massinissalounis/oufffteam/Coupe/Coupe2011/Poster2011_EN/lapins/Rabbids Artoyz generic(2).jpg

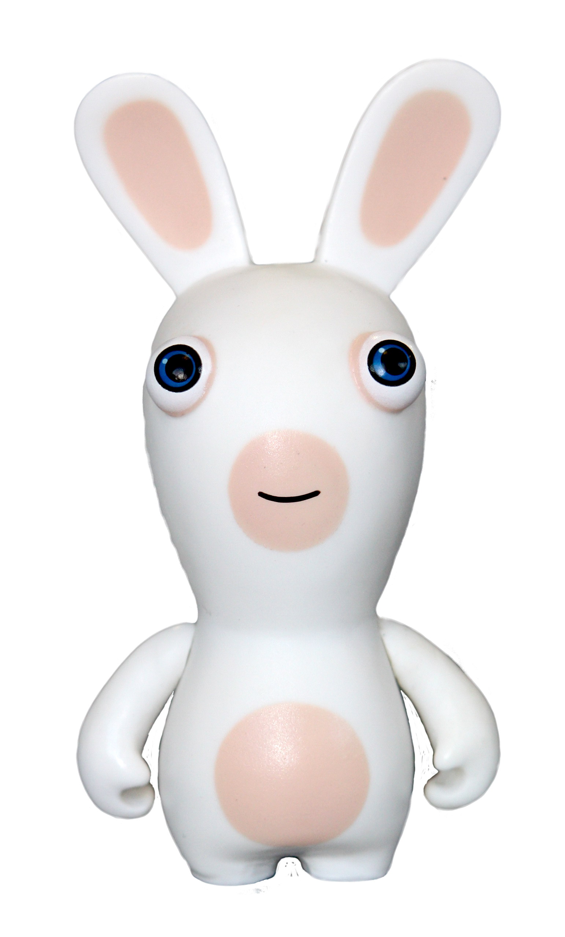
Coupe/Coupe2011/Poster2011_EN/lapins/Rabbids Artoyz generic(2).jpg
