massinissalounis/oufffteam/Coupe/Coupe2011/Poster2011/lapins/RRR_UK_1024x768_wallpaper15.jpg

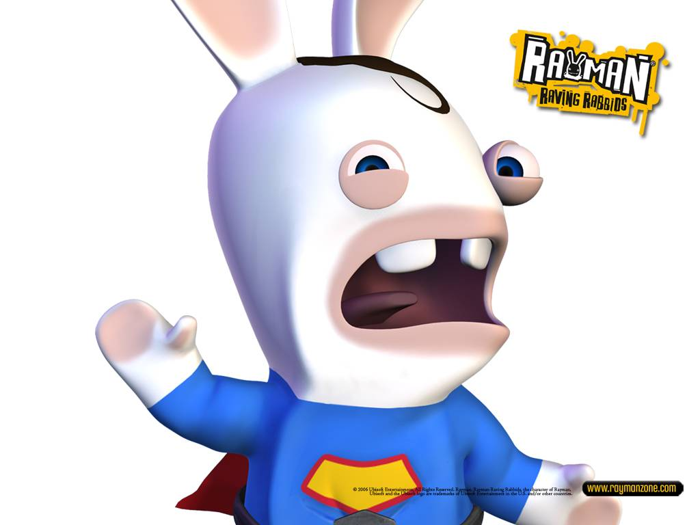
Coupe/Coupe2011/Poster2011/lapins/RRR_UK_1024x768_wallpaper15.jpg
