massinissalounis/oufffteam/Info/RapsberryPi/Info.txt

Carte Raspberry :

root / OufffTe@m!

IP eth : 192.168.0.200
