massinissalounis/oufffteam/Dev_uCOS-II/Oufff2013_DemoAsser1/Conception/Projet2013.pptx

## Projet 2013

TaskAsser
- Compute new orders to send to motors from current postion to reach expected position

StructCmd App_CmdToTaskAsser

TaskOdo
Stand-alone task Compute current position from encoding wheels Postion is exposed by TaskOdo_GetCurrentPos() and TaskOdo_SetCurrentPos()

TaskDebug
Display data (to debug) from all other tasks

Strategy Flags (32 bits)
See Page 2

TaskMain
Synchronize all tasks

TaskTest
Only for tests Do not use in production mode

TaskSensors
Set or Clear Bumpers flags according to sensors state Execute command from TaskMain

TaskMvt
Compute path necessary to go to expected point. Pre-defined paths are read from « Strategy files » Pre-defined paths are choosen into AppConfig.h file

TaskTime
- Wait 90s and set TIMER_STATUS

QSensors
Queue used to send command from TaskMain to TaskSensor Results are sent by using ACTION_STATUS Flag

StructCmd App_CmdToTaskMvt

App Flags (32 bits)
See Page 2

## Slide 2

Strategy Flags (32 bits)
Actions Done 0 - 1 - 2 - 3 - 4 - 5 - 6 - 7 - | Forbbiden Zones 8 - 9 - 10 - 11 - 12 - 13 - 14 - 15 - | Not Used 16 - 17 - 18 - 19 - 20 - 21 - 22 - 23 - | Not Used 24 - 25 - 26 - 27 - 28 - 29 - 30 - 31 -

App Flags (32 bits)
State 0 - START_BUTTON 1 - 2 - 3 - 4 - 5 - 6 – ACTION_STATUS 7 – TIMER_STATUS | Bumpers (GP2) 8 - GP2_FRONT 9 – GP2_BACK 10 – GP2_HOLDER 11 - 12 - 13 - 14 - 15 - | Bumpers (SW) 16 - 17 - 18 - 19 - 20 - 21 - 22 - 23 - | Not Used 24 – 25 – 26 – 27 – 28 – 29 – 30 – 31 -
