massinissalounis/oufffteam/Coupe/Coupe2011/Poster2011/SchémaBlocs/SchémaBloc.pptx

Effecteurs

Carte de contrôle des effecteurs

Système d’anticollision
Capteurs IR, Capteurs de contacts

Carte mère OufffTeam
(4 couches CMS)

PIC 32

Hacheurs
LMD18200T

FPGA
SPARTRAN3AN

PMP

Alimentation à découpage TRACO

Encodeurs scancon
2048 pts

Arrêt
Urgence

24 V / Puissance
Signal

Moteurs 24V
Faulhaber

Module de démarrage et de protection

Batterie NiMh
12V 3.2Ah

Batterie NiMh
12V 3.2Ah

12 V
5 V
