massinissalounis/oufffteam/Coupe/Coupe2011/Poster2011_EN/SchémaBlocs/SchémaBloc.pptx

Actuators

Actuator control PCB

Obstacle Avoidance System
IR and contact sensor

OufffTeam motherboard
(4 layers CMS)

PIC 32

H-bridge
LMD18200T

FPGA
SPARTRAN3AN

PMP

Switched power supply

Encoders scancon
2048 steps

Emergency Stop

24 V / Power
control

Motor 24V
Faulhaber

Startup and protection module

NiMh accumulator
12V 3.2Ah

NiMh accumulator
12V 3.2Ah

12 V
5 V
