massinissalounis/oufffteam/Balises/Balises_SICK/Doc/Synoptique.pptx

Asser
- INT timer pour latch
- PID
- Generation PWM
Beacon computing
- Polling status
- Read Latch Pos
- Detect spots (center+width)
- Controls: complete tour, no more than 3 spots
- Identifiy reference
- Distance and angle comp
- Flags generation

RD PIC

INT PIC

Latch coder

Encoder

NEW REV
& ! RD PIC

A

Positions x 8

Latch Pos x 8

RD PIC

B

Init

Status

Ctrl

Dir

0/1

PWM
