massinissalounis/oufffteam/Elec/2010/Hacheurs/Doc/Signaux sonde courant.docx

Signaux :

1- PWM de consigne
2- Courant dans le moteur
3- Sortie sonde de courant
4- Sonde de courant filtrée passe bas
5- Sonde de courant filtrée passe bas / (alpha de la PWM)
