massinissalounis/oufffteam/Elec/2013/Support_capteur_couleur/Supp_capteur_couleur schéma.pdf

J2

J3

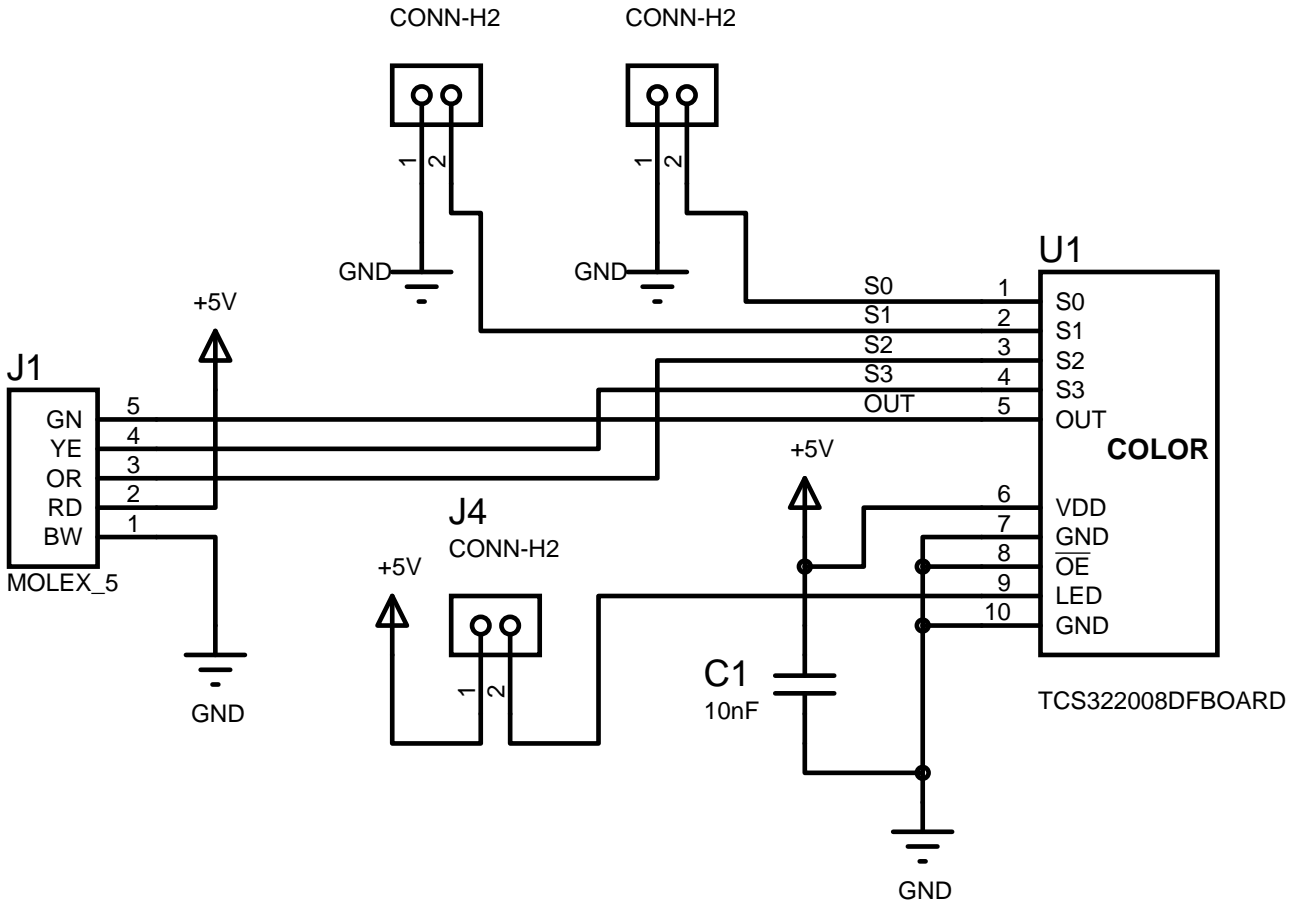
[picture p8: figure]
S2 S3 OUT; COLOR; S0 1 S1 2 S2 3 S3 4 OUT 5; VDD 6 GND 7 OE 8 LED 9 GND 10; TCS322008DFBOARD; MOLEX_5; GND; CONN-H2
