massinissalounis/oufffteam/Info/StrategyGenerator/v1 - 2012/Conception/Conception.docx

1 - Use Cases

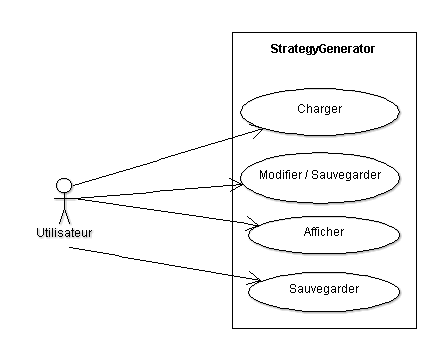
[picture p9: figure]

2 – Diagramme des Packages

3.1 – Use Cases de IHM

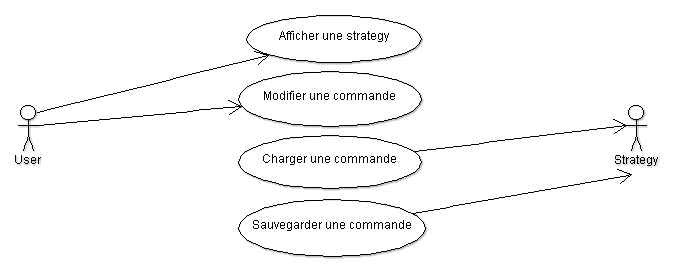
[picture p10: figure]

3.2 – Use Cases de Strategy

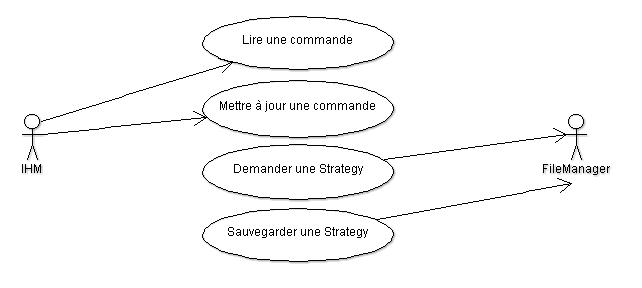
[picture p11: figure]

3.3 – Use Cases de FileManager

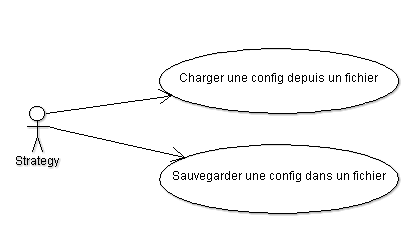
[picture p12: figure]

4 – Modélisation des interfaces

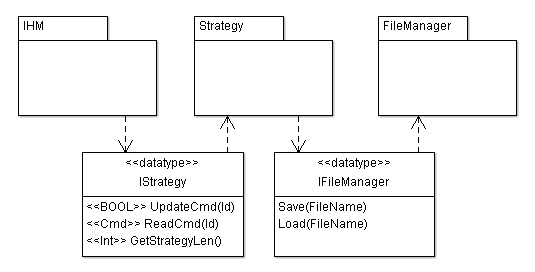
[picture p13: figure]
