massinissalounis/oufffteam/Balises/TrigoInverse/EqTrigoRevisionDeOufff_2007-12-26.docx

Equations de positionnement

de la Oufff TEAM

(Trigo inverse)

Document de base : « Systèmes de positionnement d’un robot dans le cadre de la coupe Eurobot », Sébastien GROS (Club ROBOTIK2000), http://clubrobot2000.free.fr/site, année 2007.

Schéma :

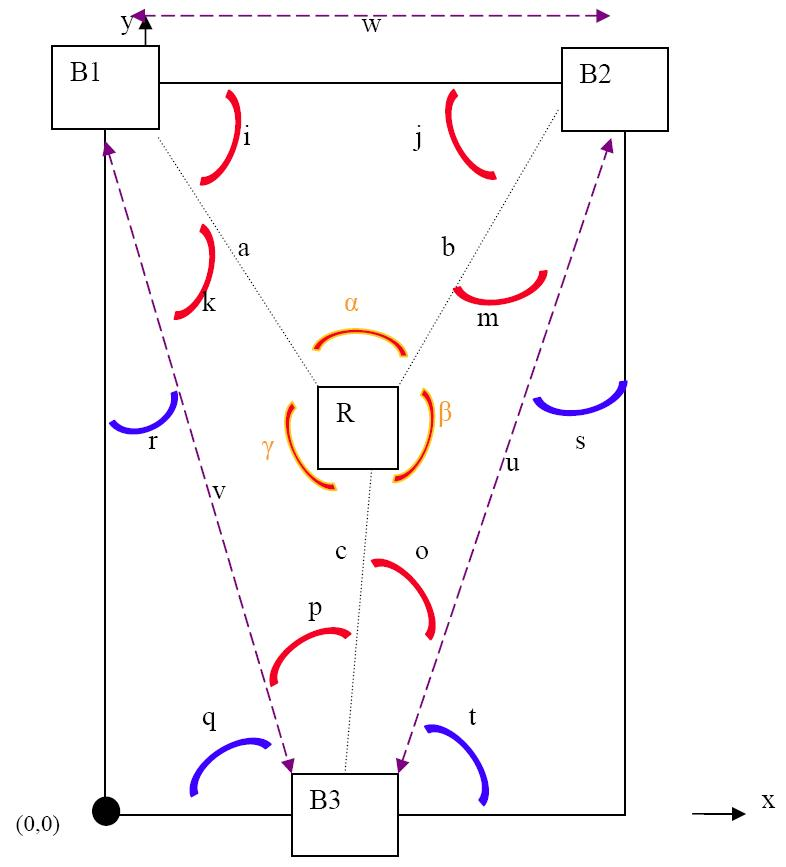
[picture p14: figure]

Triangle (vqt)

Triangle (ust)

(l, 0)

(0,L)

L = 3000 mm

l = 2100 mm

Equations dans le triangle α :

Calcul des angles i et j :

i= cos^(-1) (√((((v/(sin⁡(γ)))*cos⁡(r-γ+π/2)+(w/(sin(α)))*cos⁡(α-π))^2)/(((v/(sin⁡(γ)))*cos⁡(r-γ+π/2)+(w/(sin(α)))*cos⁡(α-π))^2 +((v/(sin⁡(γ)))*sin⁡(r-γ+π/2)+(w/(sin(α)))*sin⁡(α-π))^2)))

j= cos^(-1) (√((((u/(sin⁡(β)))*cos⁡(s-β+π/2)+(w/(sin(α)))*cos⁡(α-π))^2)/(((u/(sin⁡(β)))*cos⁡(s-β+π/2)+(w/(sin(α)))*cos⁡(α-π))^2 +((u/(sin⁡(β)))*sin⁡(s-β+π/2)+(w/(sin(α)))*sin⁡(α-π))^2)))

Calcul de la distance a :

a=w/(sin⁡(α))*sin⁡(j)

Calcul de la position (x,y) :

x=a*cos(i)

y=L-a*sin⁡(i)

Equations dans le triangle β :

Calcul de l’angle m :
m= cos^(-1) (√((((w/(sin⁡(α)))*cos⁡(s-α+π/2)+(u/(sin(β)))*cos⁡(β-π))^2)/(((w/(sin⁡(α)))*cos⁡(s-α+π/2)+(u/(sin(β)))*cos⁡(β-π))^2 +((w/(sin⁡(α)))*sin⁡(s-α+π/2)+(u/(sin(β)))*sin⁡(β-π))^2)))

Calcul de la distance b :

b=u/(sin⁡(β))*sin⁡(π-m-β)

Calcul de la position (x,y) :

x=l-b*cos(j)

y=L-b*sin⁡(j)

Remarque importante :

Attention, le domaine de validité de ces équations dépend de la zone dans laquelle se situe le robot. Lorsque le robot se situe dans le triangle (ust), l’angle calculé pour m est en réalité l’angle –m (changement de signe). Pour prendre en compte cela, après le calcul de m, il suffit de prendre la condition :

SI (β>π) ALORS m=-m

Equations dans le triangle γ :

Calcul de l’angle k :
k= cos^(-1) (√((((w/(sin⁡(α)))*cos⁡(r-α+π/2)+(v/(sin(γ)))*cos⁡(γ-π))^2)/(((w/(sin⁡(α)))*cos⁡(r-α+π/2)+(v/(sin(γ)))*cos⁡(γ-π))^2 +((w/(sin⁡(α)))*sin⁡(r-α+π/2)+(v/(sin(γ)))*sin⁡(γ-π))^2)))

Calcul de la distance a :

a=v/(sin⁡(γ))*sin⁡(π-k-γ)

Calcul de la position (x,y) :

x=a*cos(i)

y=L-a*sin⁡(j)

Remarque importante :

Attention, le domaine de validité de ces équations dépend de la zone dans laquelle se situe le robot. Lorsque le robot se situe dans le triangle (vqt), l’angle calculé pour k est en réalité l’angle –k (changement de signe). Pour prendre en compte cela, après le calcul de k, il suffit de prendre la condition :

SI (γ>π) ALORS k=-k
