massinissalounis/oufffteam/Elec/2011/Capteur Couleur/Presentation.docx

Mise en ouvre du capteur de couleur

Gestion des 2 modes : fonctionnement normal et fonctionnement en teach – in externe

Gestion du key lock

Entrée d’effacement

2 hard différents pour gerer les 2 modes !
