massinissalounis/oufffteam/Coupe/Coupe2012/Poster2012_FR/Poster2012_FR.pdf

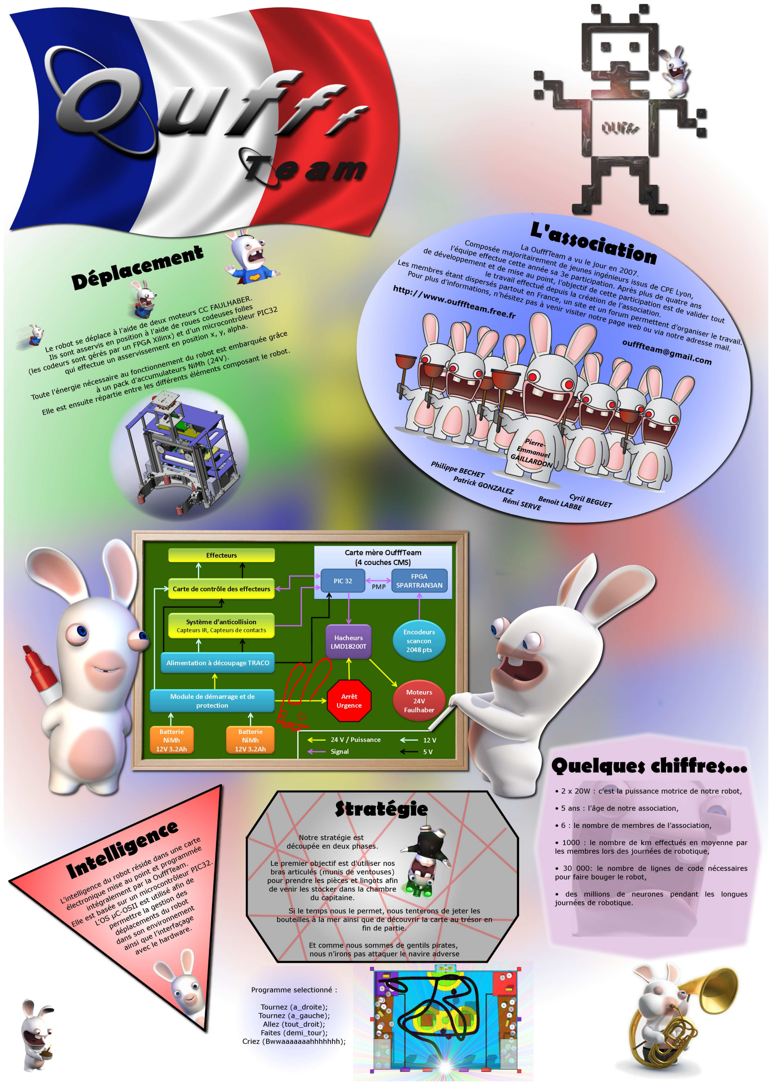
[picture p18: page 1]
