massinissalounis/oufffteam/Coupe/Coupe2012/Poster2012_FR/PosterA0_FR.pdf

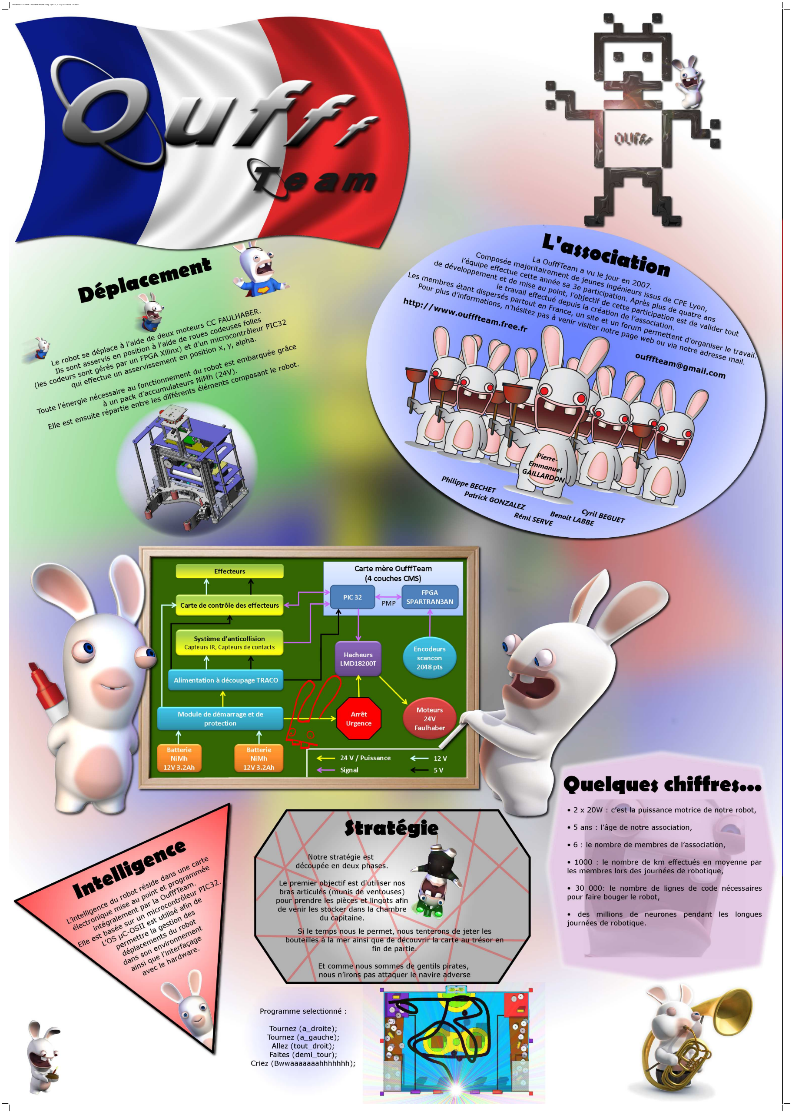
[picture p19: page 1]

Posteriza v1.1 FREE - Nouvelle affiche - Pag. 1 (H = 1, V = 1) 2012-05-09 21:38:17
