massinissalounis/oufffteam/Coupe/Coupe2012/Poster2012_EN/Poster2012_EN.pdf

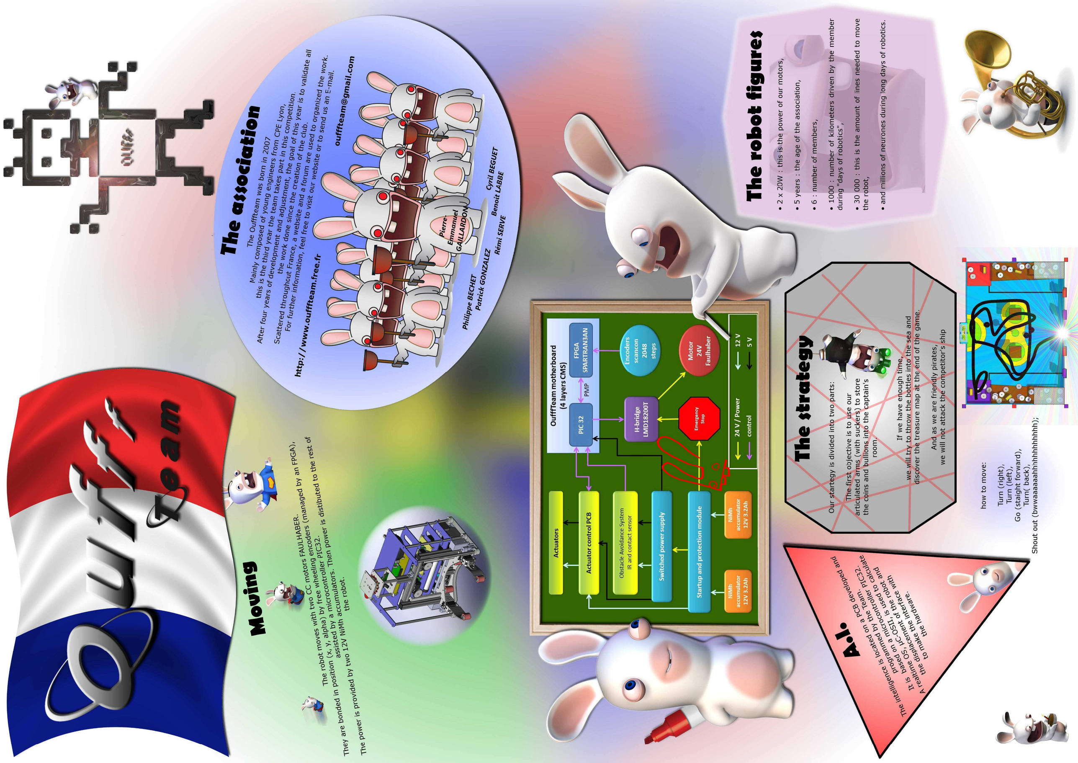
[picture p20: page 1]
