massinissalounis/oufffteam/Coupe/Coupe2011/Poster2011/Poster2011_v2.pdf

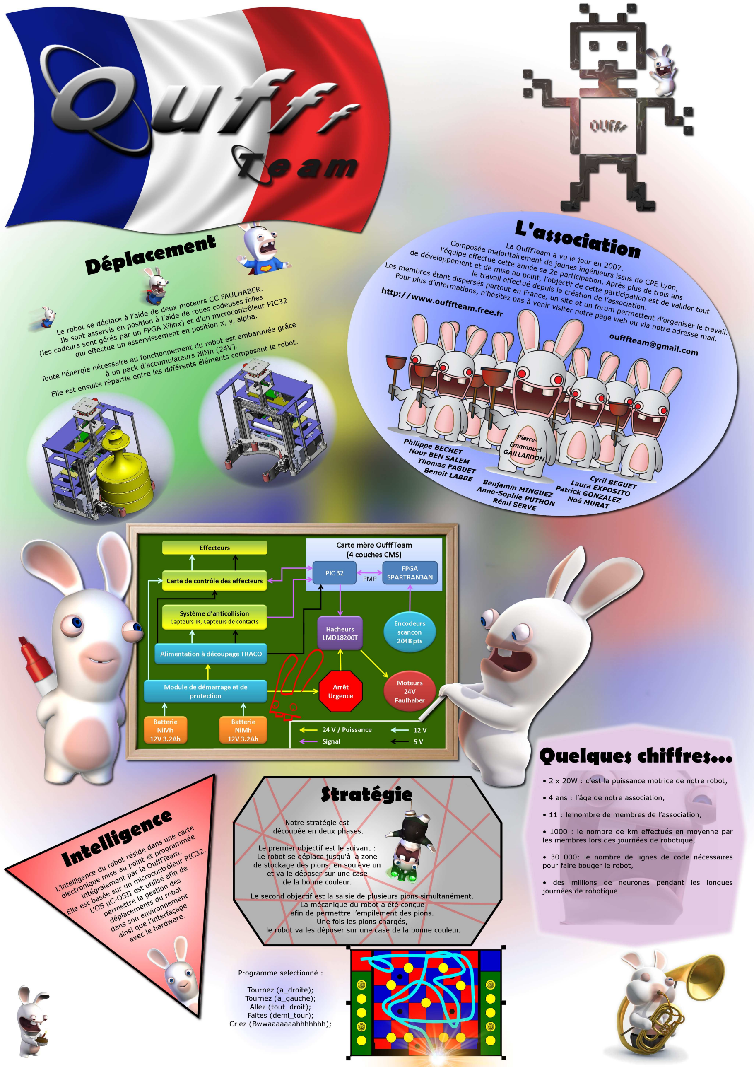
[picture p21: page 1]
