massinissalounis/oufffteam/Coupe/Coupe2011/Poster2011_EN/Poster2011_v2_en.pdf

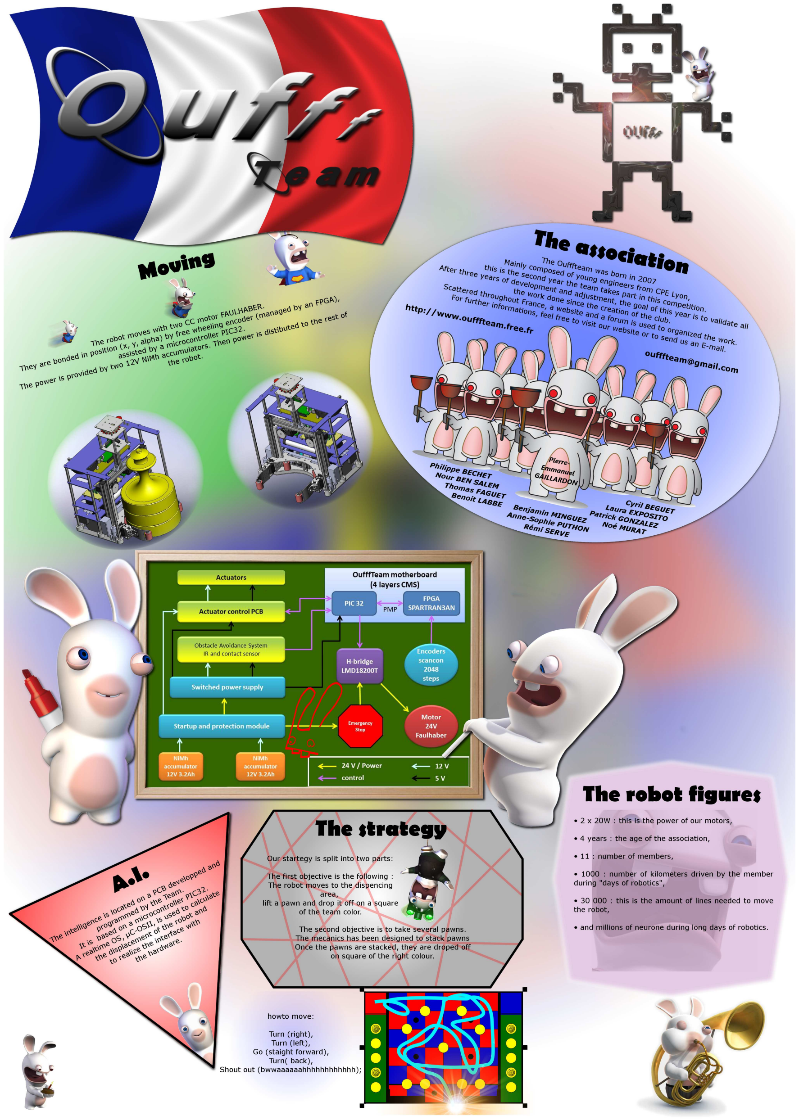
[picture p22: page 1]
