massinissalounis/oufffteam/Coupe/Coupe2013/Poster/Poster2013_FR/Poster OufffTEAM 2013.pdf

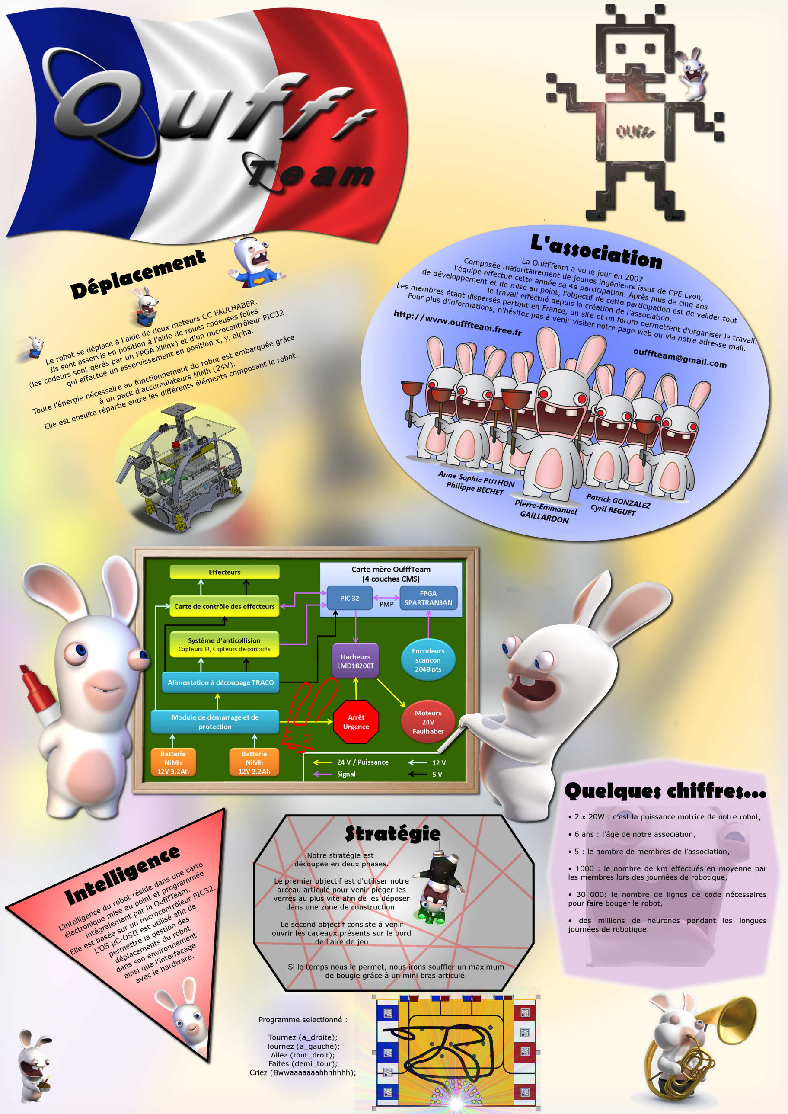
[picture p23: page 1]
