massinissalounis/oufffteam/Meca/Plans Robot 2013/Arceau - Plan.pdf

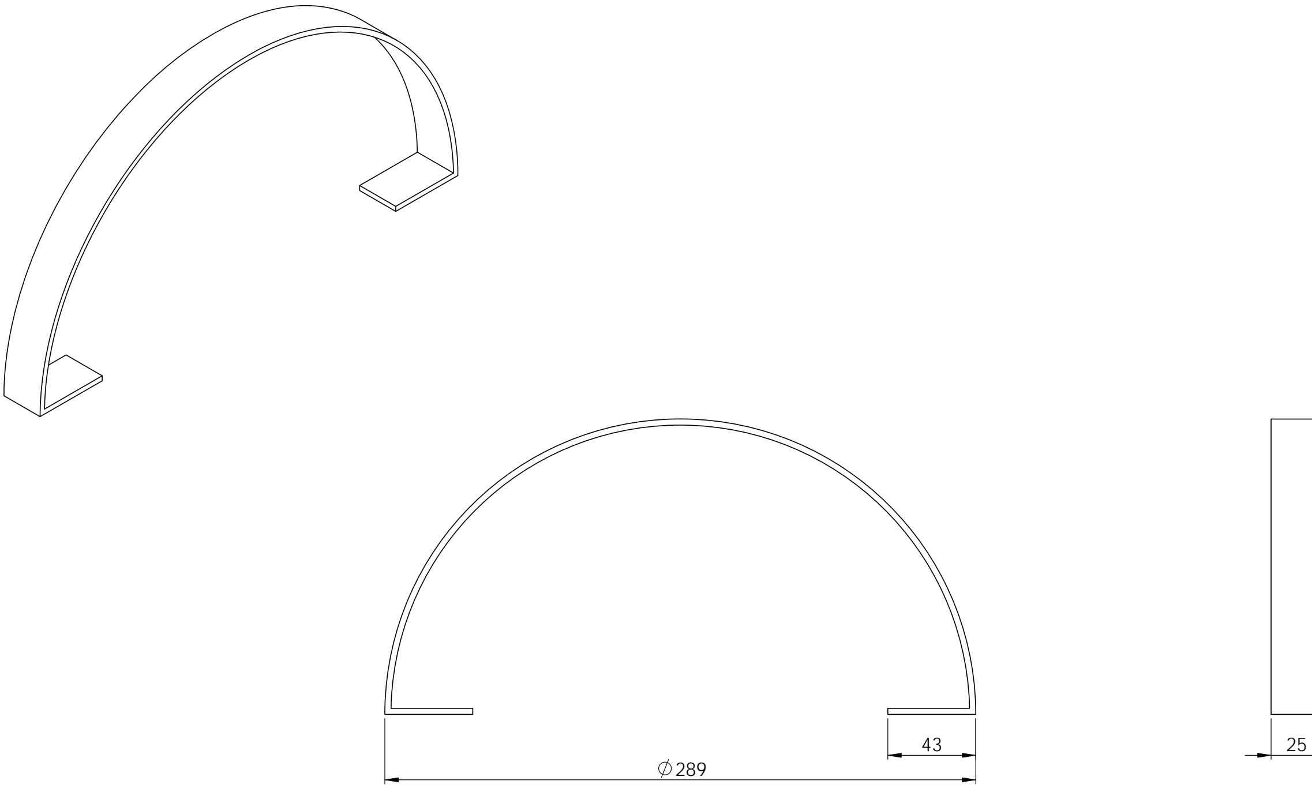
[picture p24: figure]
