massinissalounis/oufffteam/Meca/Plans Robot 2013/Etagère 2 - Plan.pdf

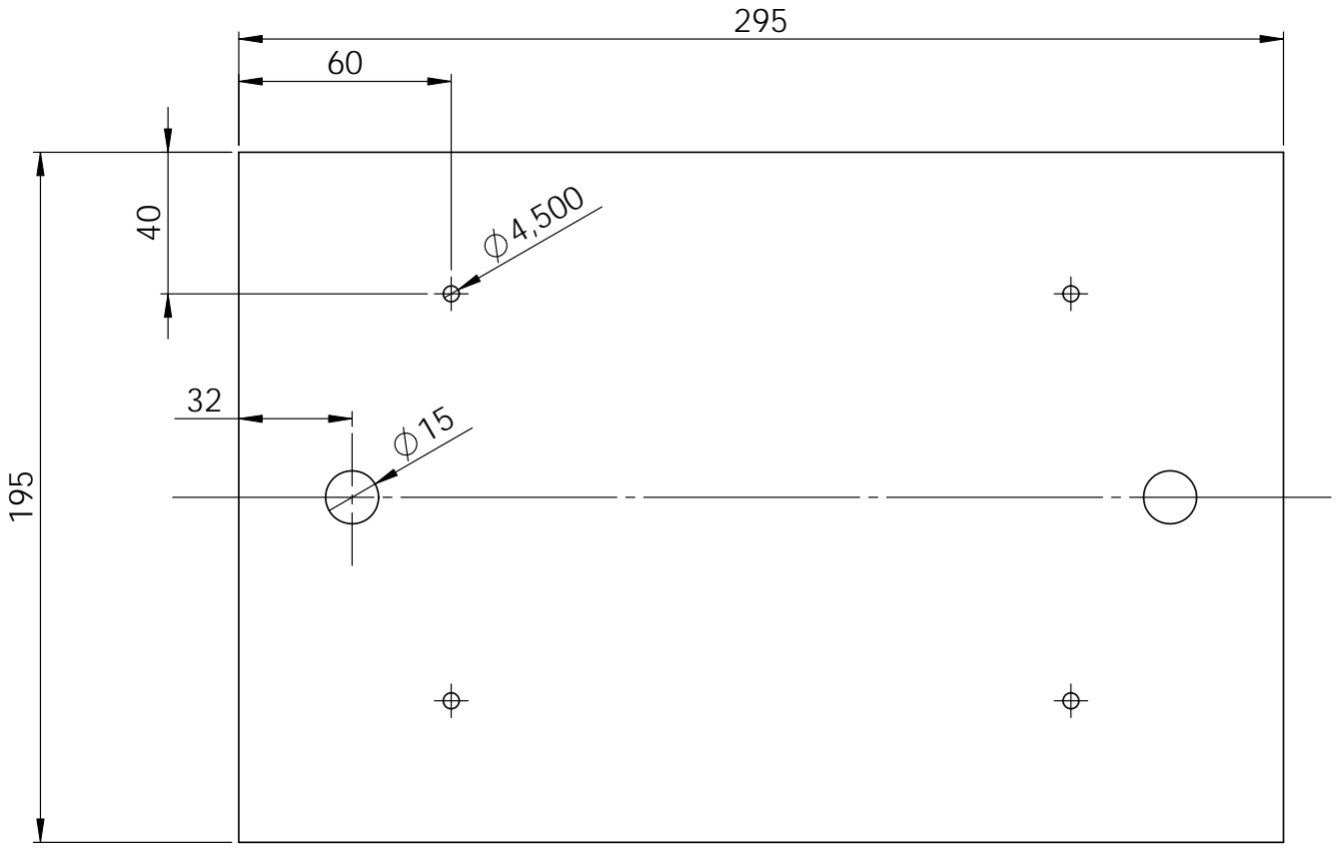
[picture p25: figure]
