massinissalounis/oufffteam/Meca/Plans Robot 2013/Petit_robot_V1.pdf

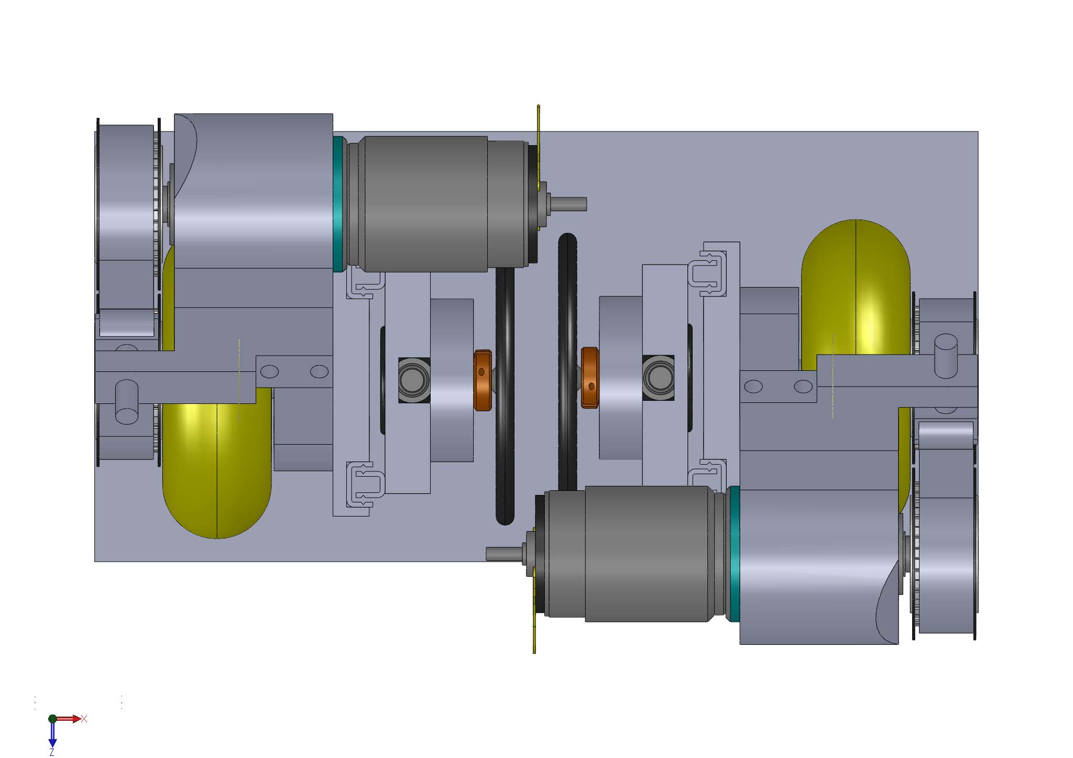
[picture p26: page 1]
