massinissalounis/oufffteam/Meca/Plans Robot 2013/Robot_principal_V2_16122012_0145.pdf

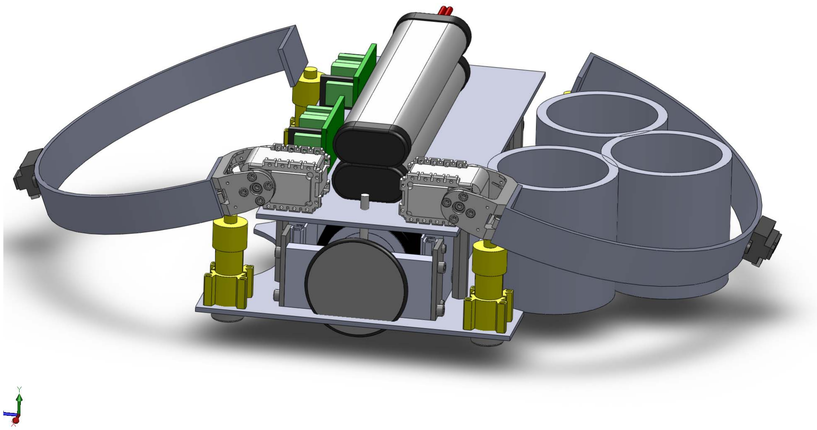
[picture p27: page 1]
