massinissalounis/oufffteam/Meca/Plans Robot 2013/Robot_principal_V2_16122012_vue dessus.pdf

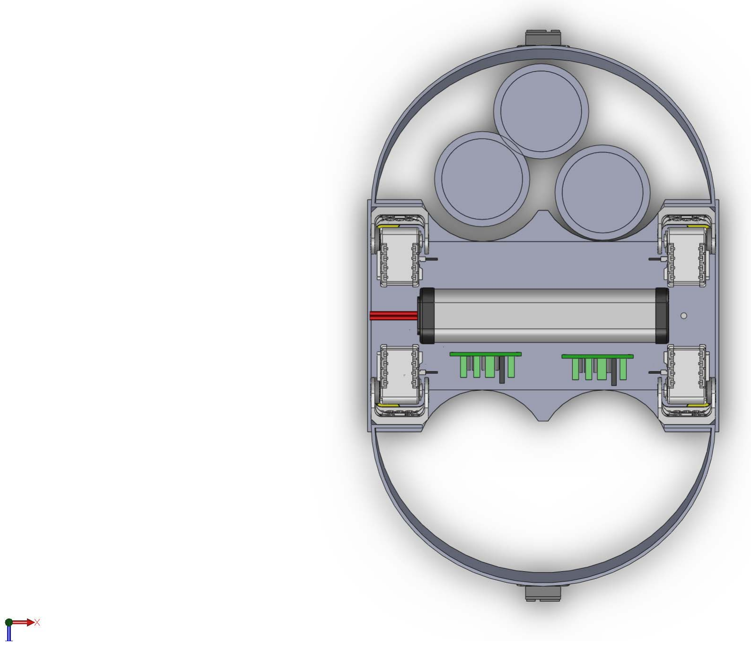
[picture p28: page 1]
