massinissalounis/oufffteam/Dev_uCOS-II/Oufff2011/Conception/Calculs trajectoires.xlsx

Sheet: Paramètres
Caractéristiques robot
largeur max | 425
largeur min | 335
longueur max | 320
longueur min | 275
Distance centre essieux / centre pince | 183
Terrain | X | Y
angle 1 | 0 | 0
angle 2 | 3000 | 0
angle 3 | 3000 | 2100
angle 4 | 0 | 2100
angle 1 bis | 0 | 0
case 1
 | 0 | 0
 | 400 | 0
 | 400 | 400
 | 0 | 400

Sheet: Calcul de coordonnées
Centre de la pince |  |  | Centre du robot
X | Y | alpha | X | Y | alpha | ATTENTION : L'angle est en radian
600.00 | 550.00 | 135.00 | 729.40 | 420.60 | 135.00
1700.00 | 150.00 | -45.00 | 1570.60 | 279.40 | -45.00
 |  |  | -183.00 | 0.00 | 0.00
2400.00 | 550.00 | 45.00 | 2270.60 | 420.60 | 45.00 | 729.40
1300.00 | 150.00 | -135.00 | 1429.40 | 279.40 | -135.00 | 1570.60
 |  |  | -183.00 | 0.00 | 0.00
625.00 | 1870.00 | 90.00 | 625.00 | 1687.00 | 90.00
625.00 | 526.00 | -135.00 | 754.40 | 655.40 | -135.00
 |  |  | -183.00 | 0.00 | 0.00
 |  |  | -183.00 | 0.00 | 0.00
 |  |  | -183.00 | 0.00 | 0.00
 |  |  | -183.00 | 0.00 | 0.00
 |  |  | -183.00 | 0.00 | 0.00
 |  |  | -183.00 | 0.00 | 0.00
 |  |  | -183.00 | 0.00 | 0.00
 |  |  | -183.00 | 0.00 | 0.00
 |  |  | -183.00 | 0.00 | 0.00
 |  |  | -183.00 | 0.00 | 0.00
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
