massinissalounis/oufffteam/Info/StrategyGenerator/v2 - 2013/Conception/Ratio.xlsx

Ratio | 20%
Terrain |  |  | Robot Fermé |  |  | Robot Ouvert
 | reel | Pixel |  | reel | Pixel |  | reel | Pixel
x | 3000 | 600 | largeur | 295 | 59 | largeur | 295 | 59
y | 2000 | 400 | longueur | 195 | 39 | longueur | 450 | 90
 |  |  | ouverture | 105 | 20 |  | 22.69230769 | 4.538461538
 |  |  | Bordure | 45 | 9 |  |  | 0
 |  |  | Interieur | 35 | 7 |  |  | 0
 |  |  | Centre / Roue | 135 | 27 |  |  | 0
 |  |  |  |  | 0 |  |  | 0
 |  |  |  |  | 0 |  |  | 0
 |  |  |  |  | 0 |  |  | 0
 |  |  |  |  |  |  | 13 trous sur la largeur
 |  |  |  |  |  |  | 9 trous sur la longueur
