massinissalounis/oufffteam/Coupe/Coupe2011/Poster2011/drapeau/Drapeau-France.jpg

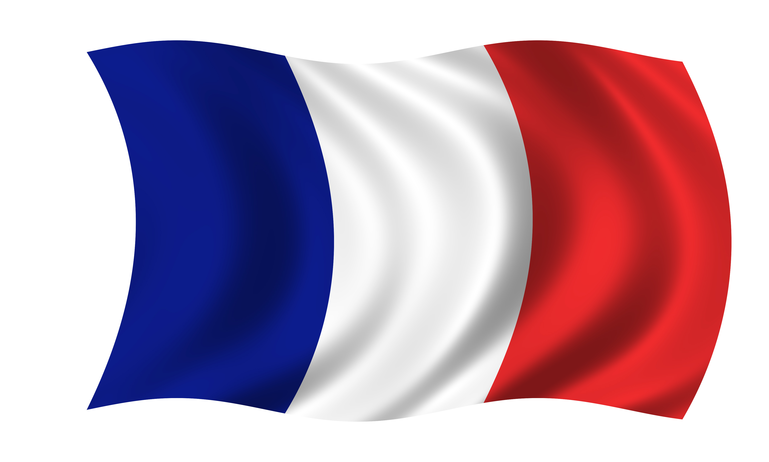
Coupe/Coupe2011/Poster2011/drapeau/Drapeau-France.jpg
