massinissalounis/oufffteam/Coupe/Coupe2011/Poster2011/lapins/1ad96d46708c3702f3d390577d31e79c.jpg

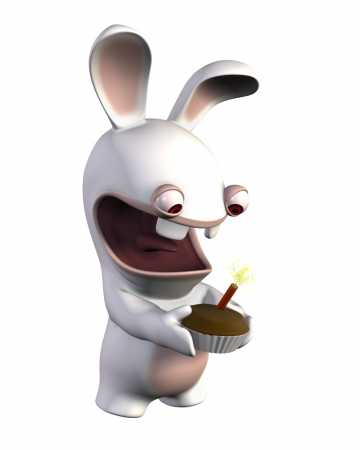
Coupe/Coupe2011/Poster2011/lapins/1ad96d46708c3702f3d390577d31e79c.jpg
