massinissalounis/oufffteam/Coupe/Coupe2011/Poster2011/lapins/42043-rayman-contre-les-lapins-cretins-3-1_640.jpg

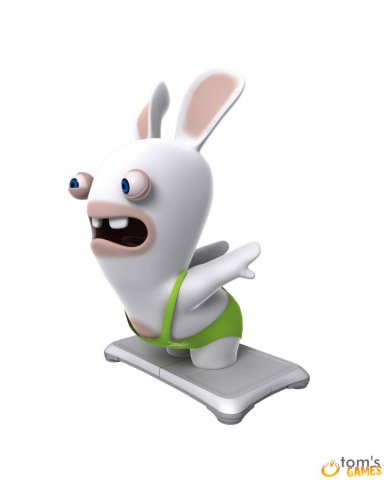
Coupe/Coupe2011/Poster2011/lapins/42043-rayman-contre-les-lapins-cretins-3-1_640.jpg
