massinissalounis/oufffteam/Coupe/Coupe2011/Poster2011/lapins/061011_lapin_cretin_1.jpg

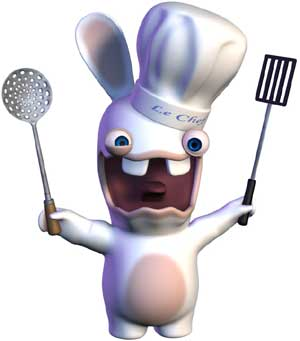
Coupe/Coupe2011/Poster2011/lapins/061011_lapin_cretin_1.jpg
