massinissalounis/oufffteam/Coupe/Coupe2011/Poster2011/lapins/091116_lapins_cretins.jpg

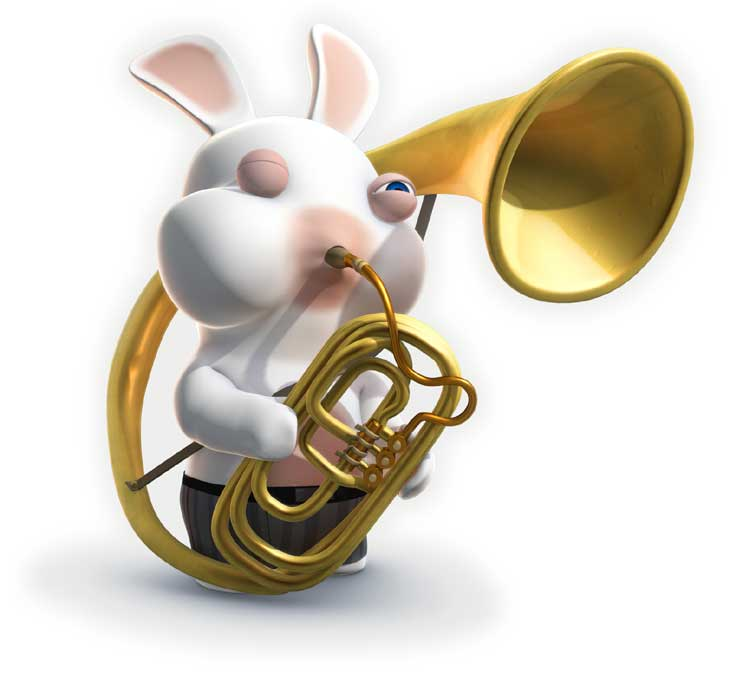
Coupe/Coupe2011/Poster2011/lapins/091116_lapins_cretins.jpg
