massinissalounis/oufffteam/Coupe/Coupe2011/Poster2011/lapins/145141d5.jpg

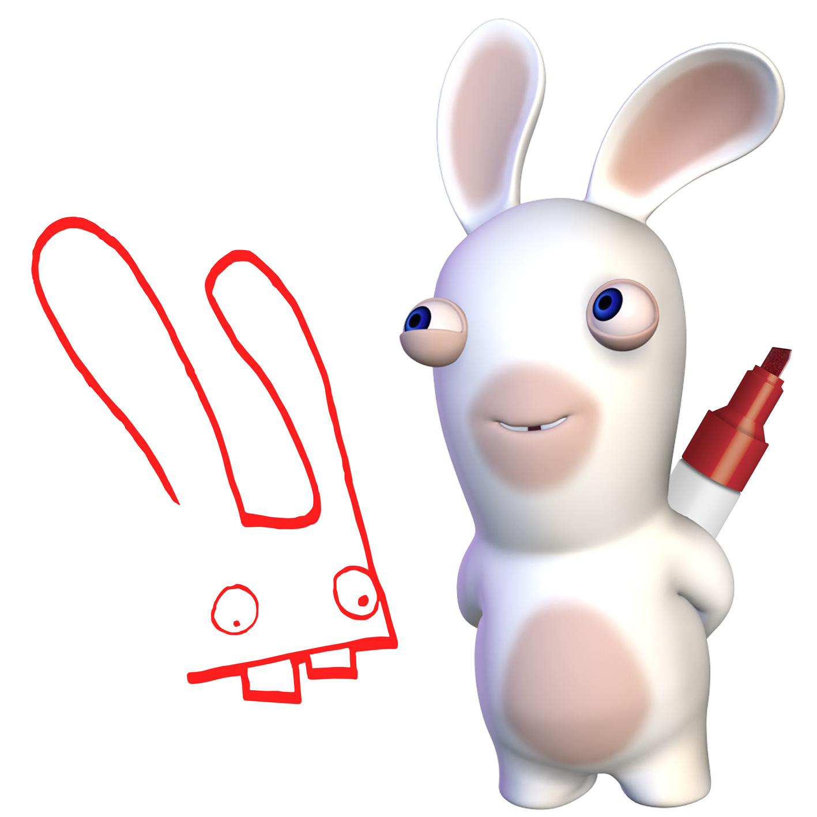
Coupe/Coupe2011/Poster2011/lapins/145141d5.jpg
