massinissalounis/oufffteam/Coupe/Coupe2011/Poster2011/lapins/308882_full.jpg

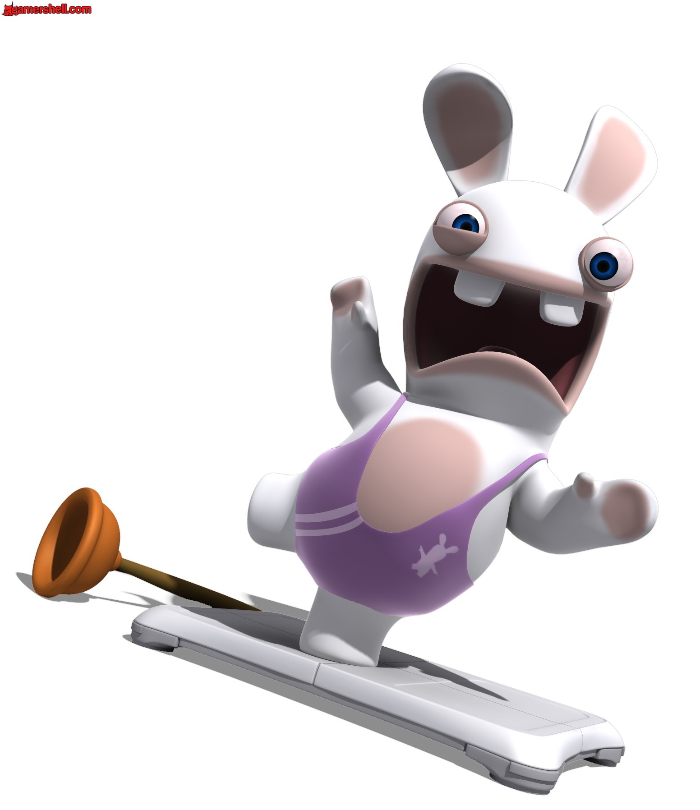
Coupe/Coupe2011/Poster2011/lapins/308882_full.jpg
