massinissalounis/oufffteam/Coupe/Coupe2011/Poster2011/lapins/00454044-photo-rayman-contre-les-lapins-cretins.jpg

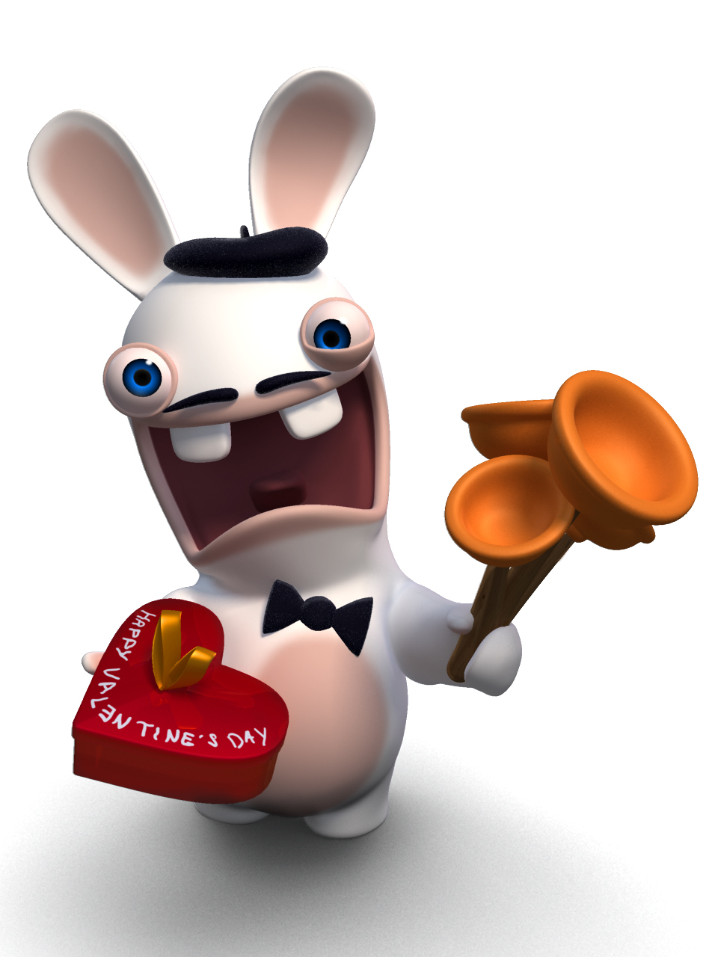
Coupe/Coupe2011/Poster2011/lapins/00454044-photo-rayman-contre-les-lapins-cretins.jpg
