massinissalounis/oufffteam/Coupe/Coupe2011/Poster2011/lapins/75485014719104lapin_cretin_splinter_cell2_jpg.jpg

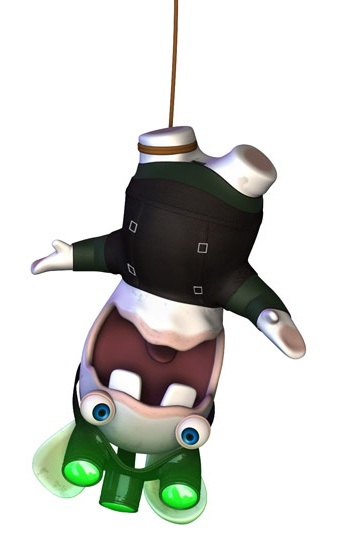
Coupe/Coupe2011/Poster2011/lapins/75485014719104lapin_cretin_splinter_cell2_jpg.jpg
