massinissalounis/oufffteam/Coupe/Coupe2011/Poster2011/lapins/Army_of_Rabbids_by_ghostexiled.jpg

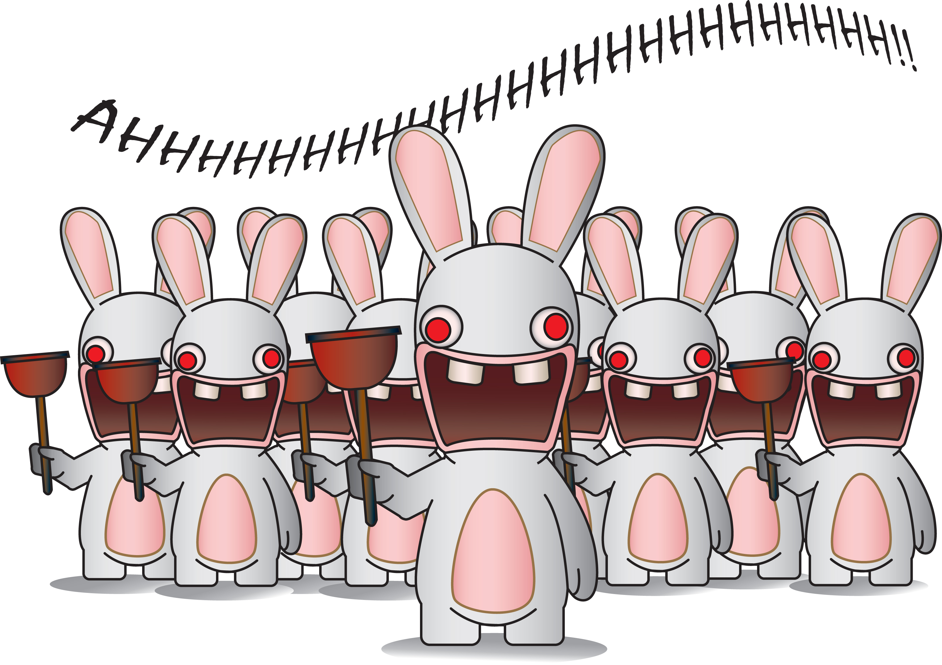
Coupe/Coupe2011/Poster2011/lapins/Army_of_Rabbids_by_ghostexiled.jpg
