massinissalounis/oufffteam/Coupe/Coupe2011/Poster2011/lapins/figurine-lapins-cretins-rayman_1.jpg

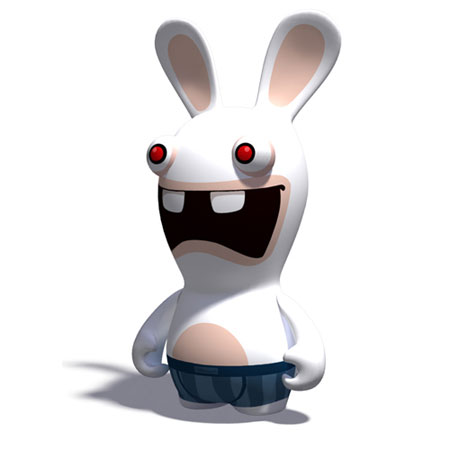
Coupe/Coupe2011/Poster2011/lapins/figurine-lapins-cretins-rayman_1.jpg
