massinissalounis/oufffteam/Coupe/Coupe2011/Poster2011/lapins/imagen-rabbids-go-home-wii.jpg

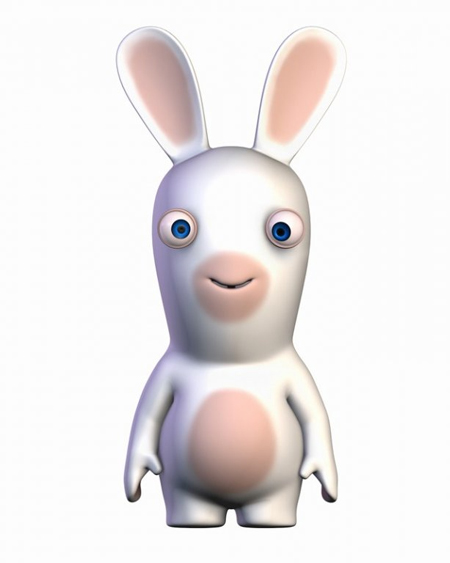
Coupe/Coupe2011/Poster2011/lapins/imagen-rabbids-go-home-wii.jpg
