massinissalounis/oufffteam/Coupe/Coupe2011/Poster2011/lapins/lapin cretin_04.jpg

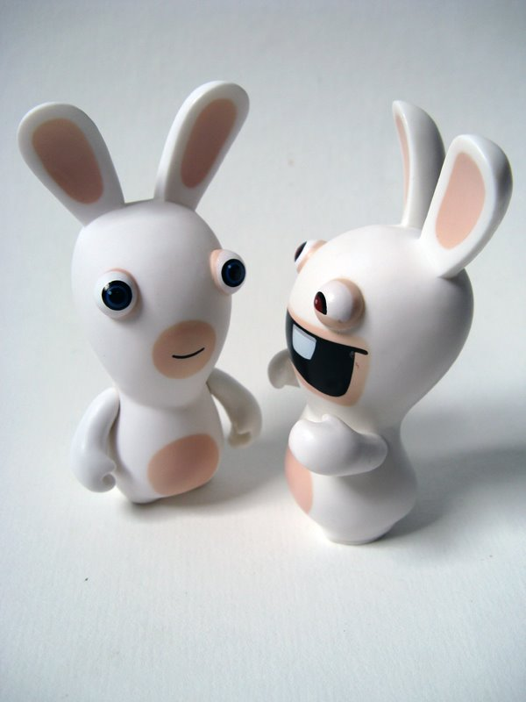
Coupe/Coupe2011/Poster2011/lapins/lapin cretin_04.jpg
