massinissalounis/oufffteam/Coupe/Coupe2011/Poster2011/lapins/lapin cretin_08.jpg

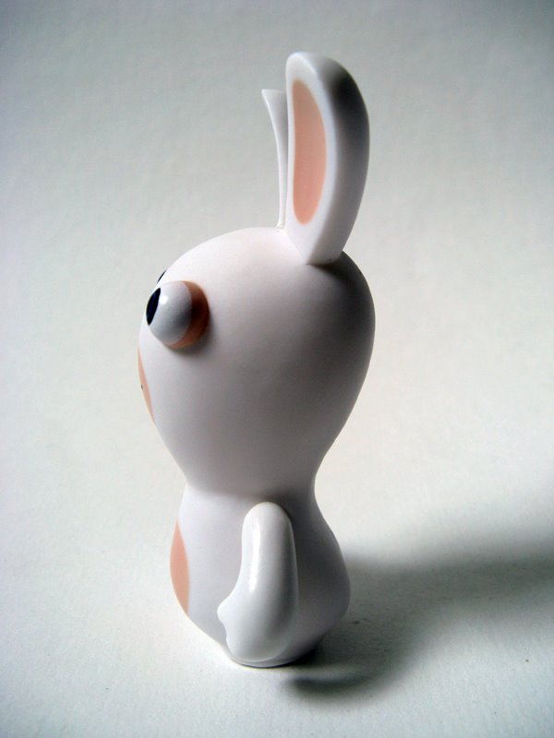
Coupe/Coupe2011/Poster2011/lapins/lapin cretin_08.jpg
