massinissalounis/oufffteam/Coupe/Coupe2011/Poster2011/lapins/LapinCretin.jpg

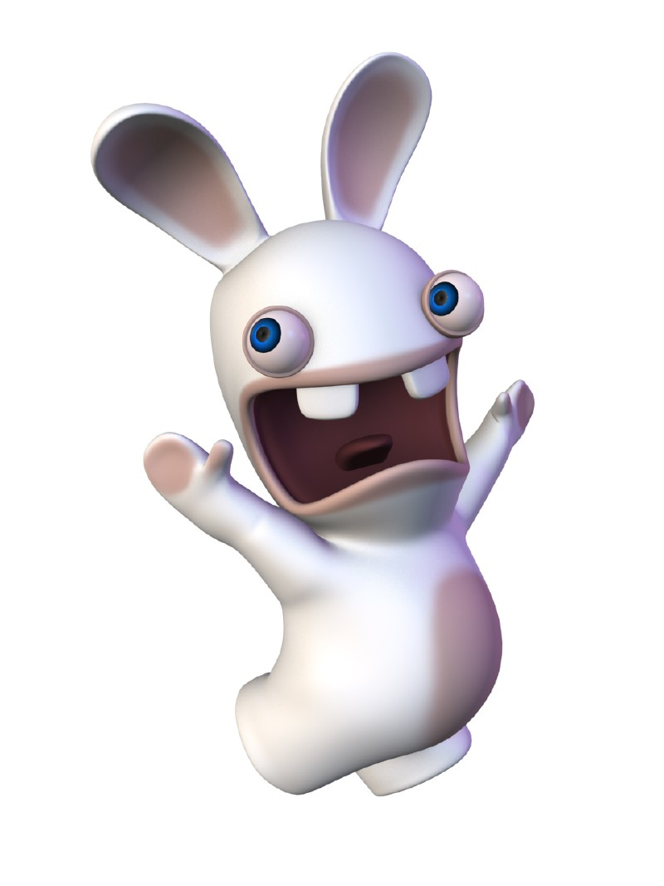
Coupe/Coupe2011/Poster2011/lapins/LapinCretin.jpg
