massinissalounis/oufffteam/Coupe/Coupe2011/Poster2011/lapins/lapins-cretins-bunny-string-edition-.jpg

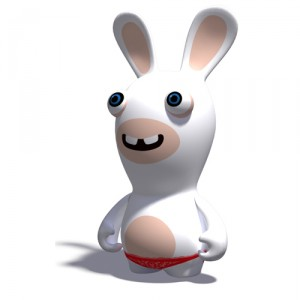
Coupe/Coupe2011/Poster2011/lapins/lapins-cretins-bunny-string-edition-.jpg
