massinissalounis/oufffteam/Coupe/Coupe2011/Poster2011/lapins/lapins-cretins-ds_2.jpg

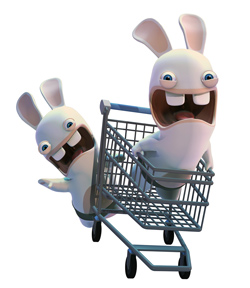
Coupe/Coupe2011/Poster2011/lapins/lapins-cretins-ds_2.jpg
