massinissalounis/oufffteam/Coupe/Coupe2011/Poster2011/lapins/news_Les_lapins_cretins_de_retour____titre.jpg

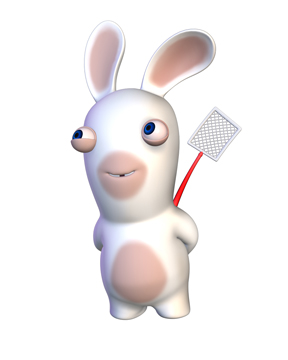
Coupe/Coupe2011/Poster2011/lapins/news_Les_lapins_cretins_de_retour____titre.jpg
