massinissalounis/oufffteam/Coupe/Coupe2011/Poster2011/lapins/pack-lapins-cretins-1.jpg

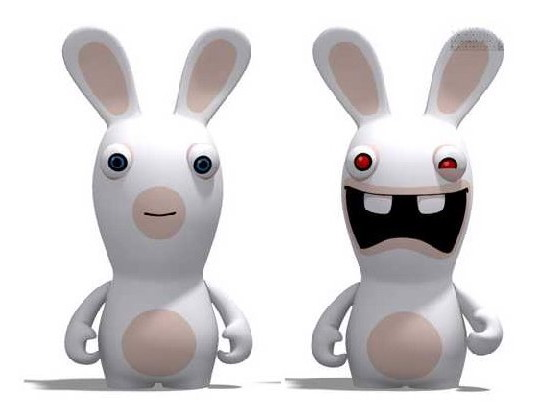
Coupe/Coupe2011/Poster2011/lapins/pack-lapins-cretins-1.jpg
