massinissalounis/oufffteam/Coupe/Coupe2011/Poster2011/lapins/png/308882_full.png

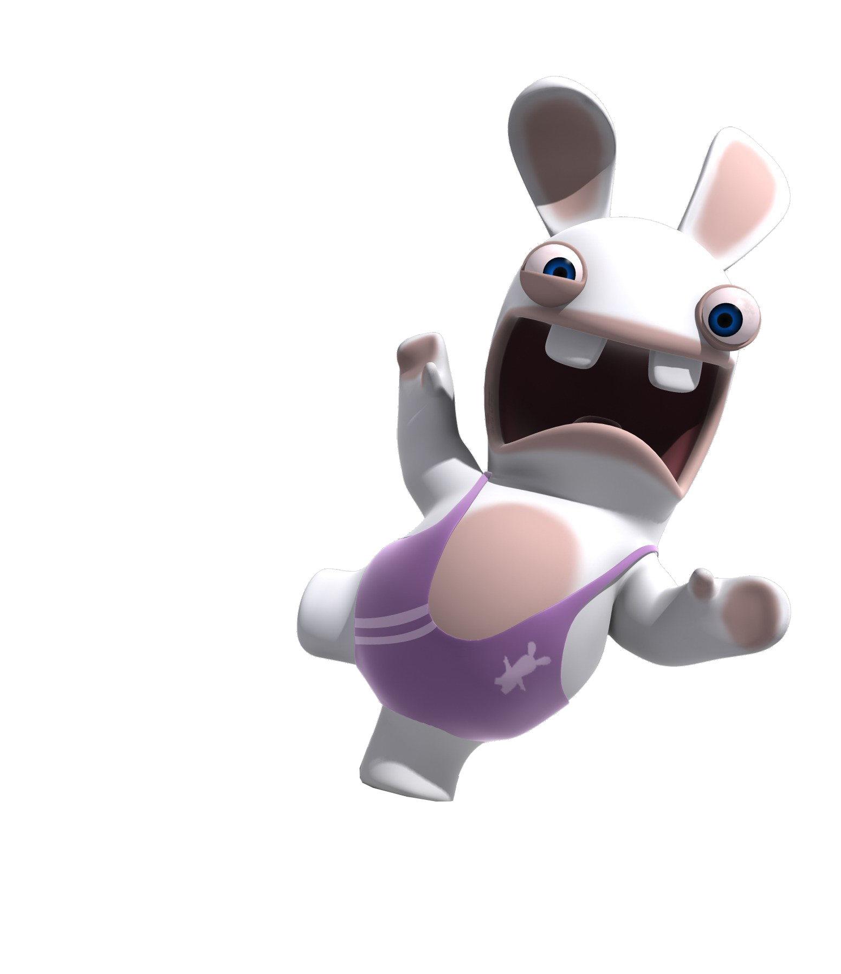
Coupe/Coupe2011/Poster2011/lapins/png/308882_full.png
