massinissalounis/oufffteam/Coupe/Coupe2011/Poster2011/lapins/png/Army_of_Rabbids_by_ghostexiled.png

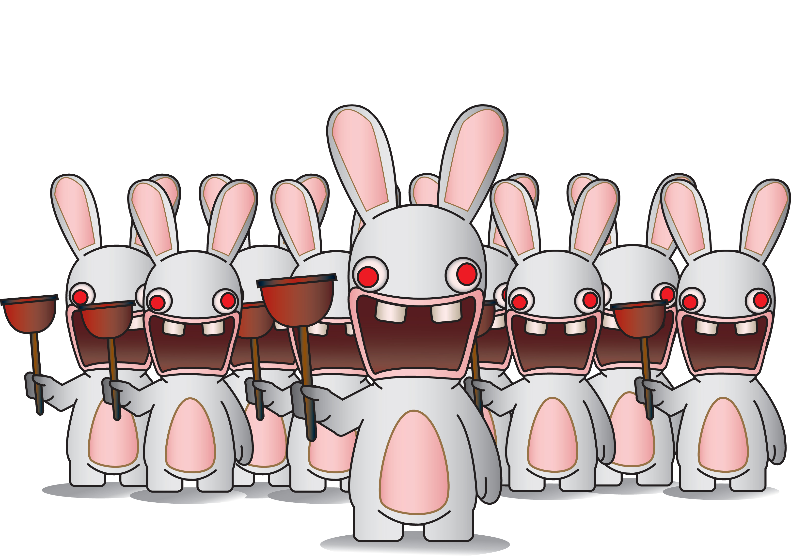
Coupe/Coupe2011/Poster2011/lapins/png/Army_of_Rabbids_by_ghostexiled.png
