massinissalounis/oufffteam/Coupe/Coupe2011/Poster2011/lapins/png/RavingRabbids.png

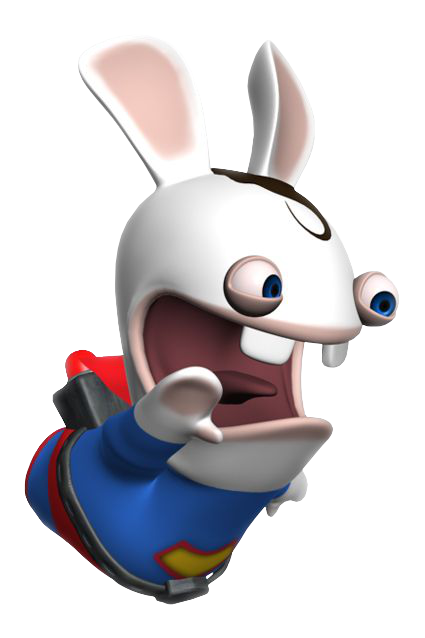
Coupe/Coupe2011/Poster2011/lapins/png/RavingRabbids.png
