massinissalounis/oufffteam/Coupe/Coupe2011/Poster2011/lapins/png/rayman-raving-rabbids_art_72.png

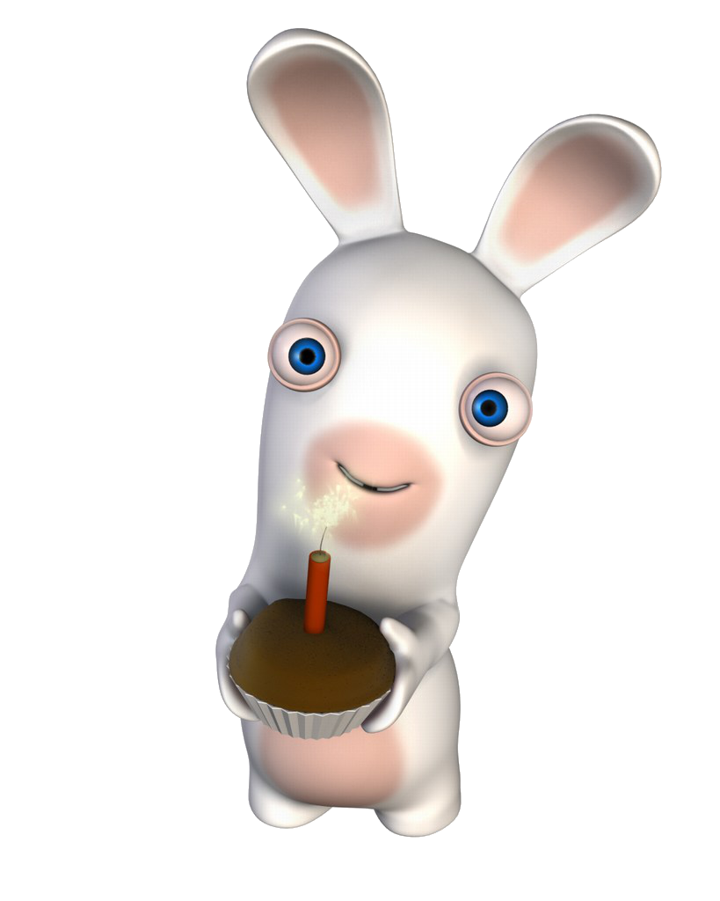
Coupe/Coupe2011/Poster2011/lapins/png/rayman-raving-rabbids_art_72.png
