massinissalounis/oufffteam/Coupe/Coupe2011/Poster2011/lapins/png/RRR_UK_1024x768_wallpaper15.png

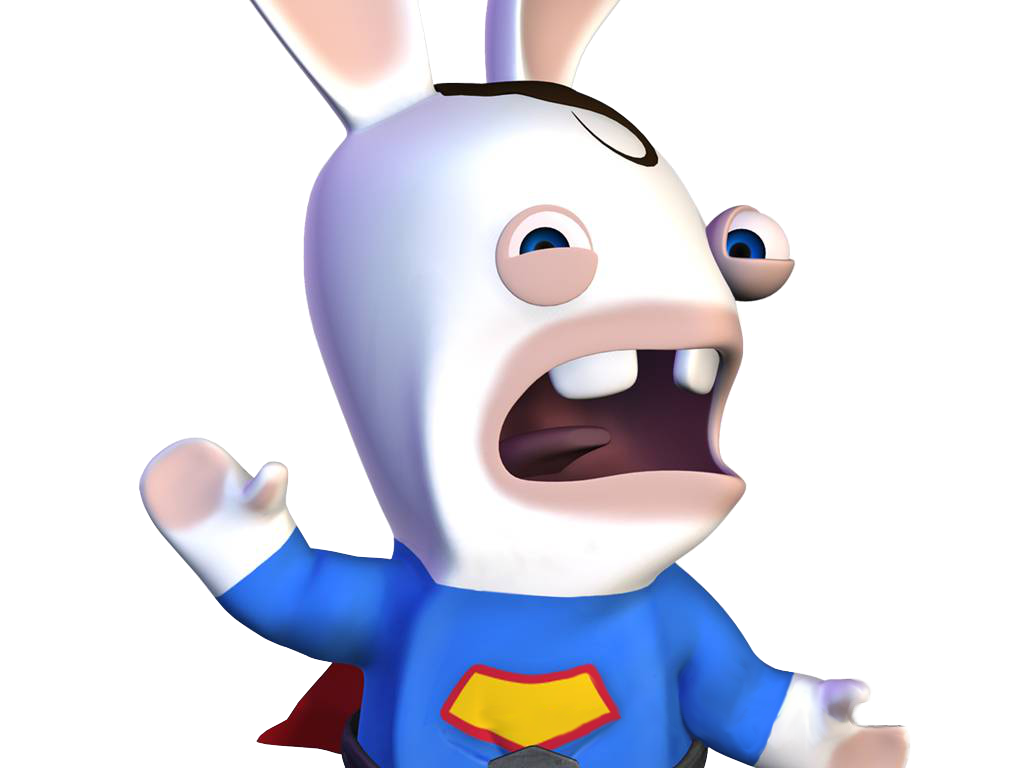
Coupe/Coupe2011/Poster2011/lapins/png/RRR_UK_1024x768_wallpaper15.png
