massinissalounis/oufffteam/Coupe/Coupe2011/Poster2011/lapins/png/the-lapins-cretins-show-wii-sc000.png

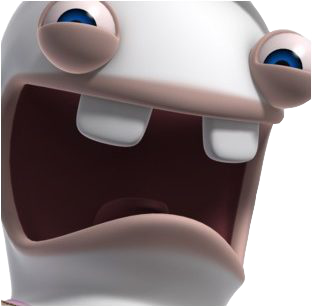
Coupe/Coupe2011/Poster2011/lapins/png/the-lapins-cretins-show-wii-sc000.png
