massinissalounis/oufffteam/Coupe/Coupe2011/Poster2011/lapins/rayman-raving-rabbids_art_72.jpg

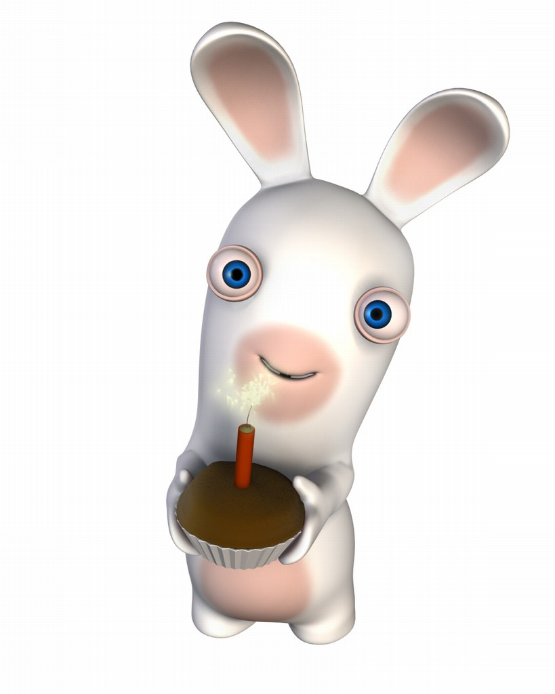
Coupe/Coupe2011/Poster2011/lapins/rayman-raving-rabbids_art_72.jpg
