massinissalounis/oufffteam/Coupe/Coupe2011/Poster2011/lapins/RGH_Rabbids_Pose1_Underwear.jpg

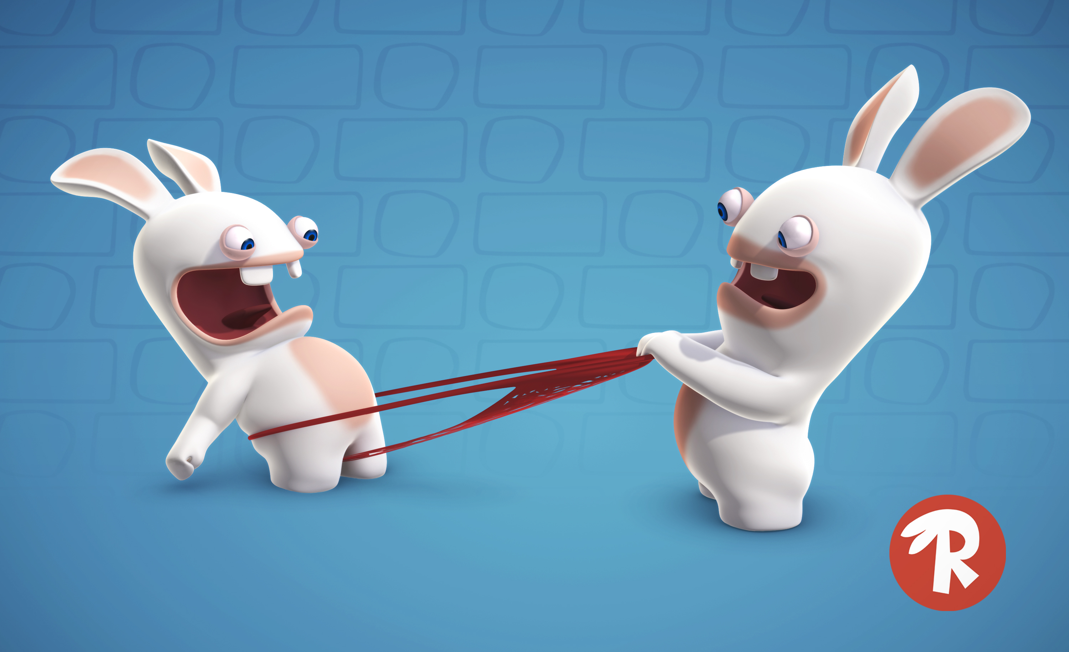
Coupe/Coupe2011/Poster2011/lapins/RGH_Rabbids_Pose1_Underwear.jpg
