massinissalounis/oufffteam/Coupe/Coupe2011/Poster2011/robot/2011_04_19_robot_iso.JPG

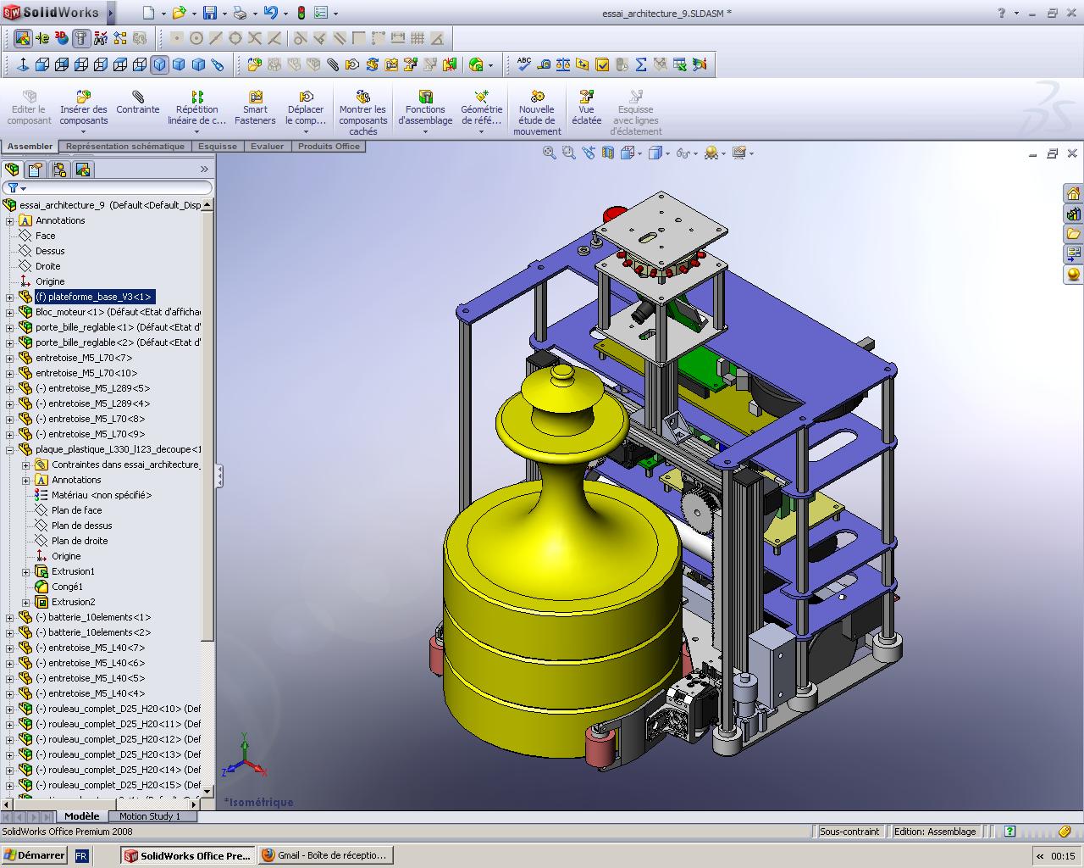
Coupe/Coupe2011/Poster2011/robot/2011_04_19_robot_iso.JPG
