massinissalounis/oufffteam/Coupe/Coupe2011/Poster2011/SchémaBlocs/145141d5.png

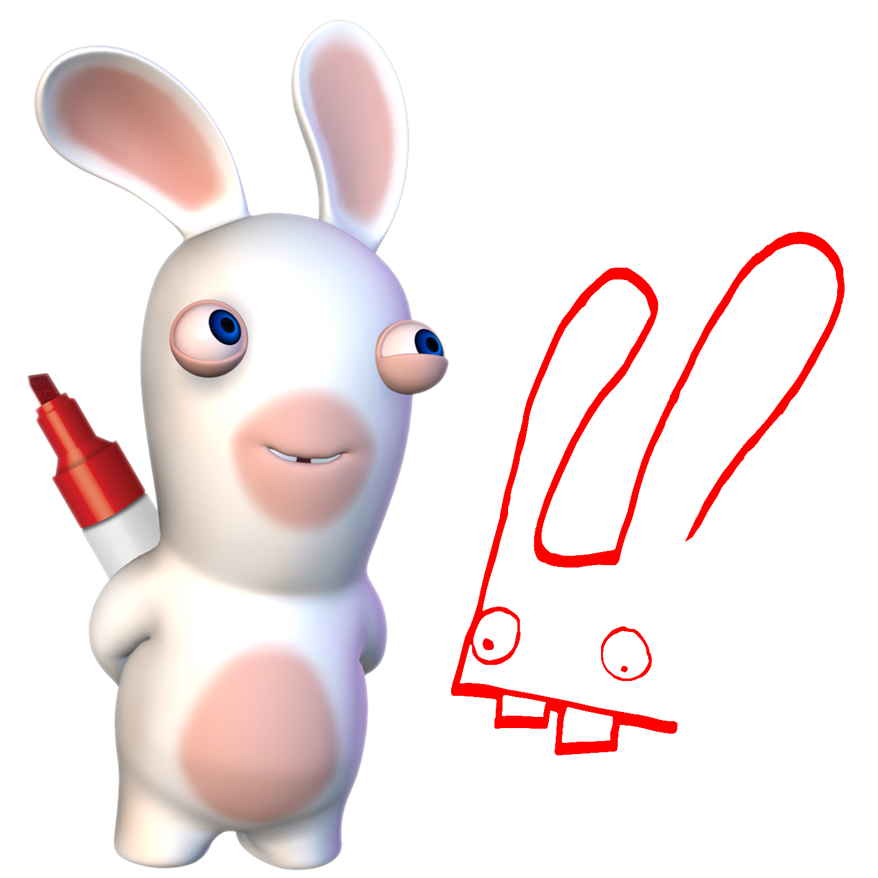
Coupe/Coupe2011/Poster2011/SchémaBlocs/145141d5.png
