massinissalounis/oufffteam/Coupe/Coupe2011/Poster2011/SchémaBlocs/RGH_Rabbids_Pose1_Underwear.png

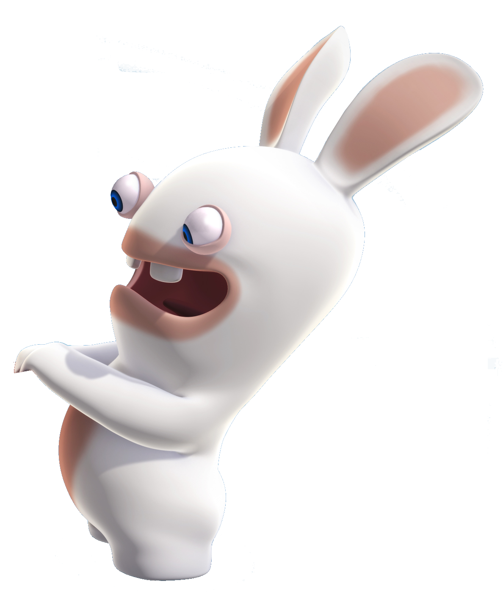
Coupe/Coupe2011/Poster2011/SchémaBlocs/RGH_Rabbids_Pose1_Underwear.png
