massinissalounis/oufffteam/Coupe/Coupe2011/Poster2011/SchémaBlocs/SchémaBloc.bmp

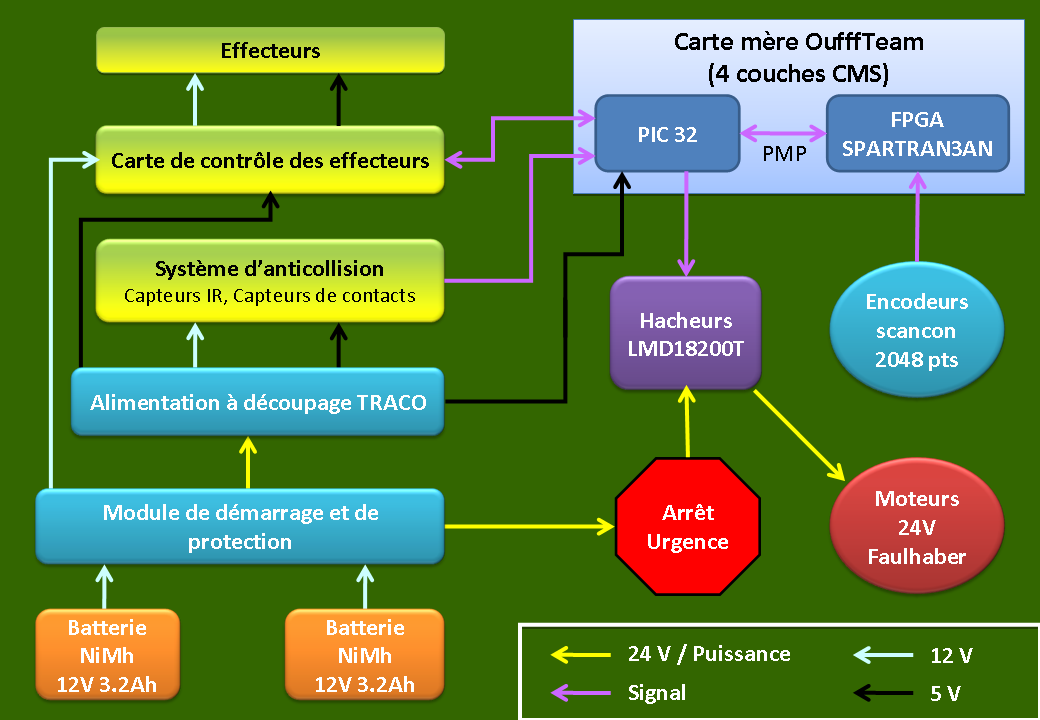
Coupe/Coupe2011/Poster2011/SchémaBlocs/SchémaBloc.bmp
