massinissalounis/oufffteam/Coupe/Coupe2011/Poster2011_EN/Chiffres.png

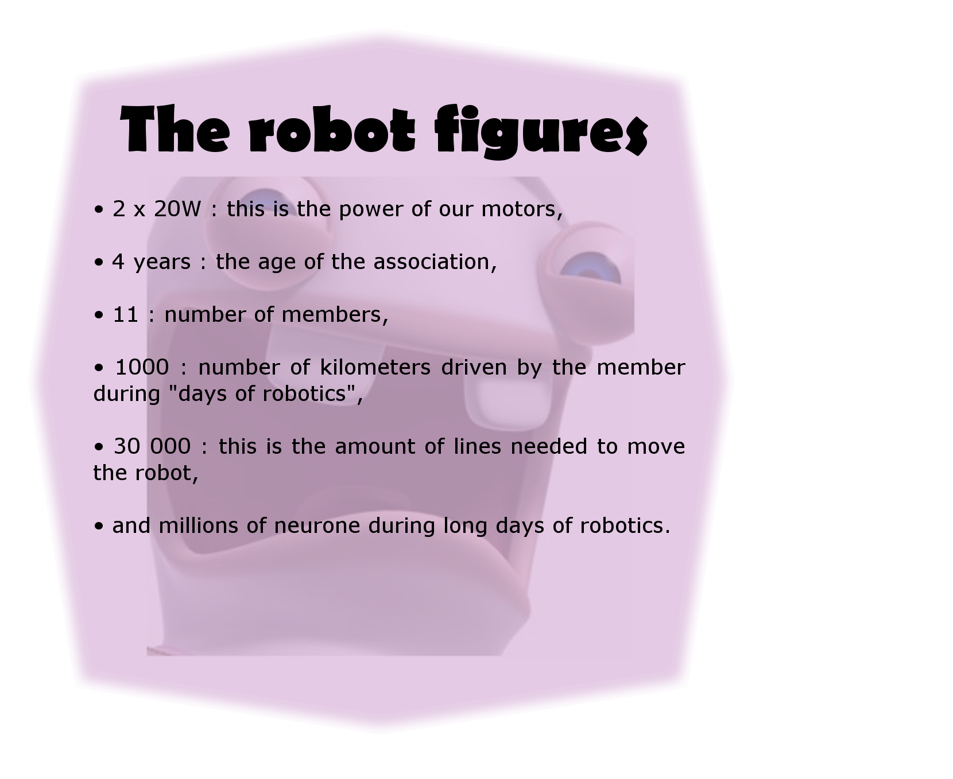
Coupe/Coupe2011/Poster2011_EN/Chiffres.png
