massinissalounis/oufffteam/Coupe/Coupe2011/Poster2011_EN/Déplacement.png

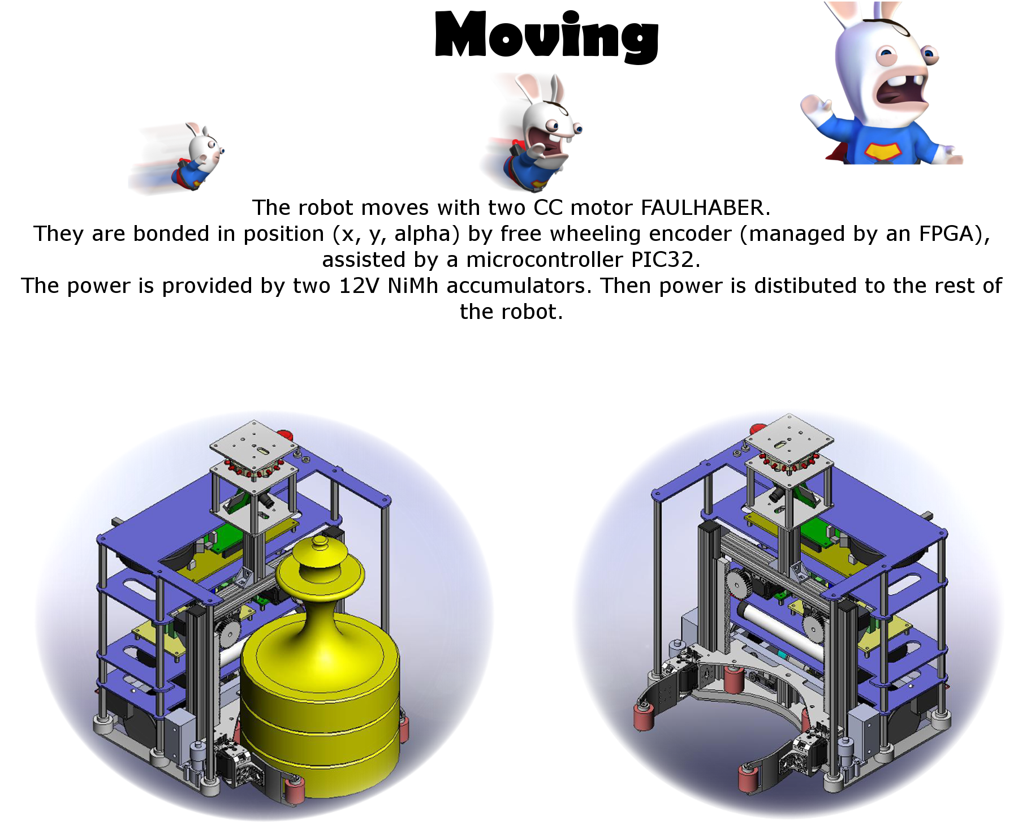
Coupe/Coupe2011/Poster2011_EN/Déplacement.png
