massinissalounis/oufffteam/Coupe/Coupe2011/Poster2011_EN/l'équipe.png

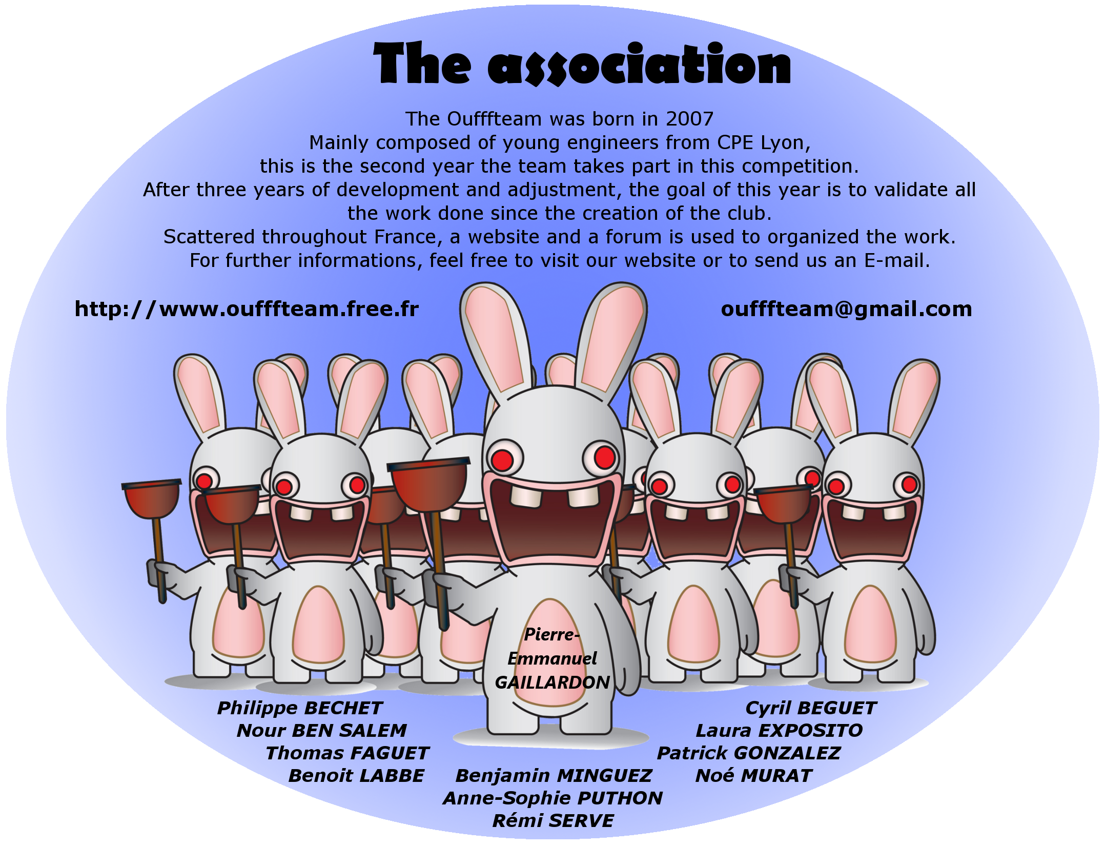
Coupe/Coupe2011/Poster2011_EN/l'équipe.png
