massinissalounis/oufffteam/Coupe/Coupe2011/Poster2011_EN/Stratégie.png

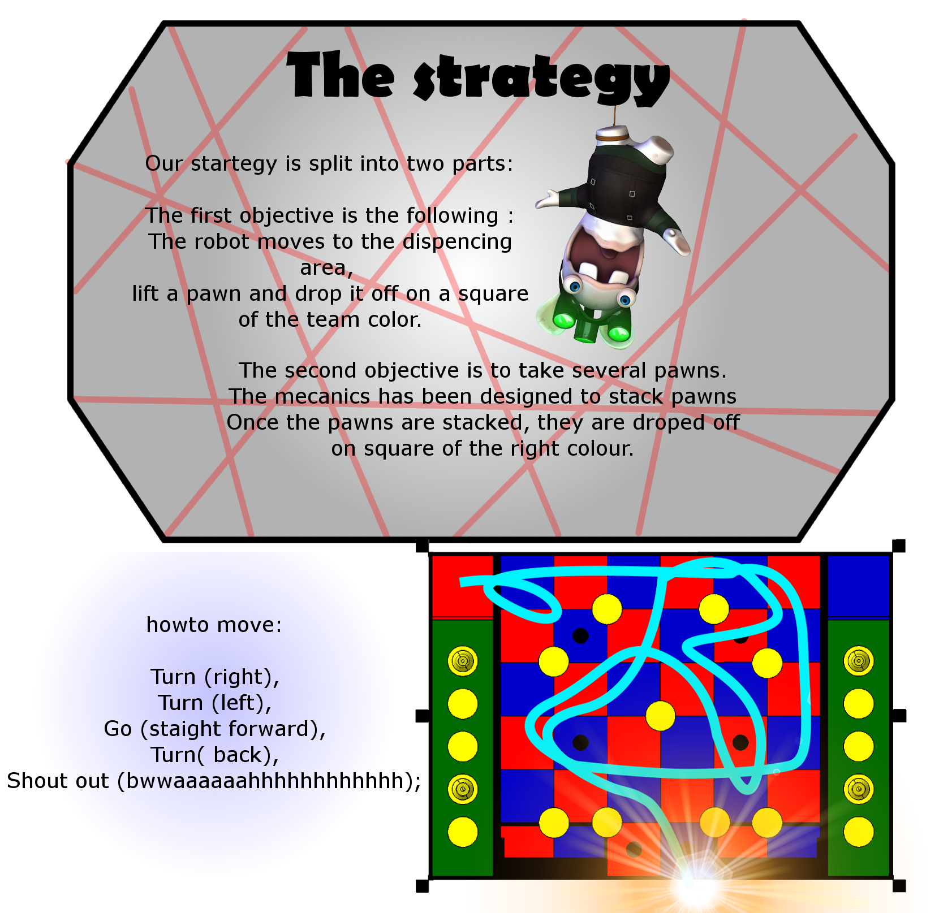
Coupe/Coupe2011/Poster2011_EN/Stratégie.png
