massinissalounis/oufffteam/Coupe/Coupe2013/Poster/Poster2013_FR/Déplacement.png

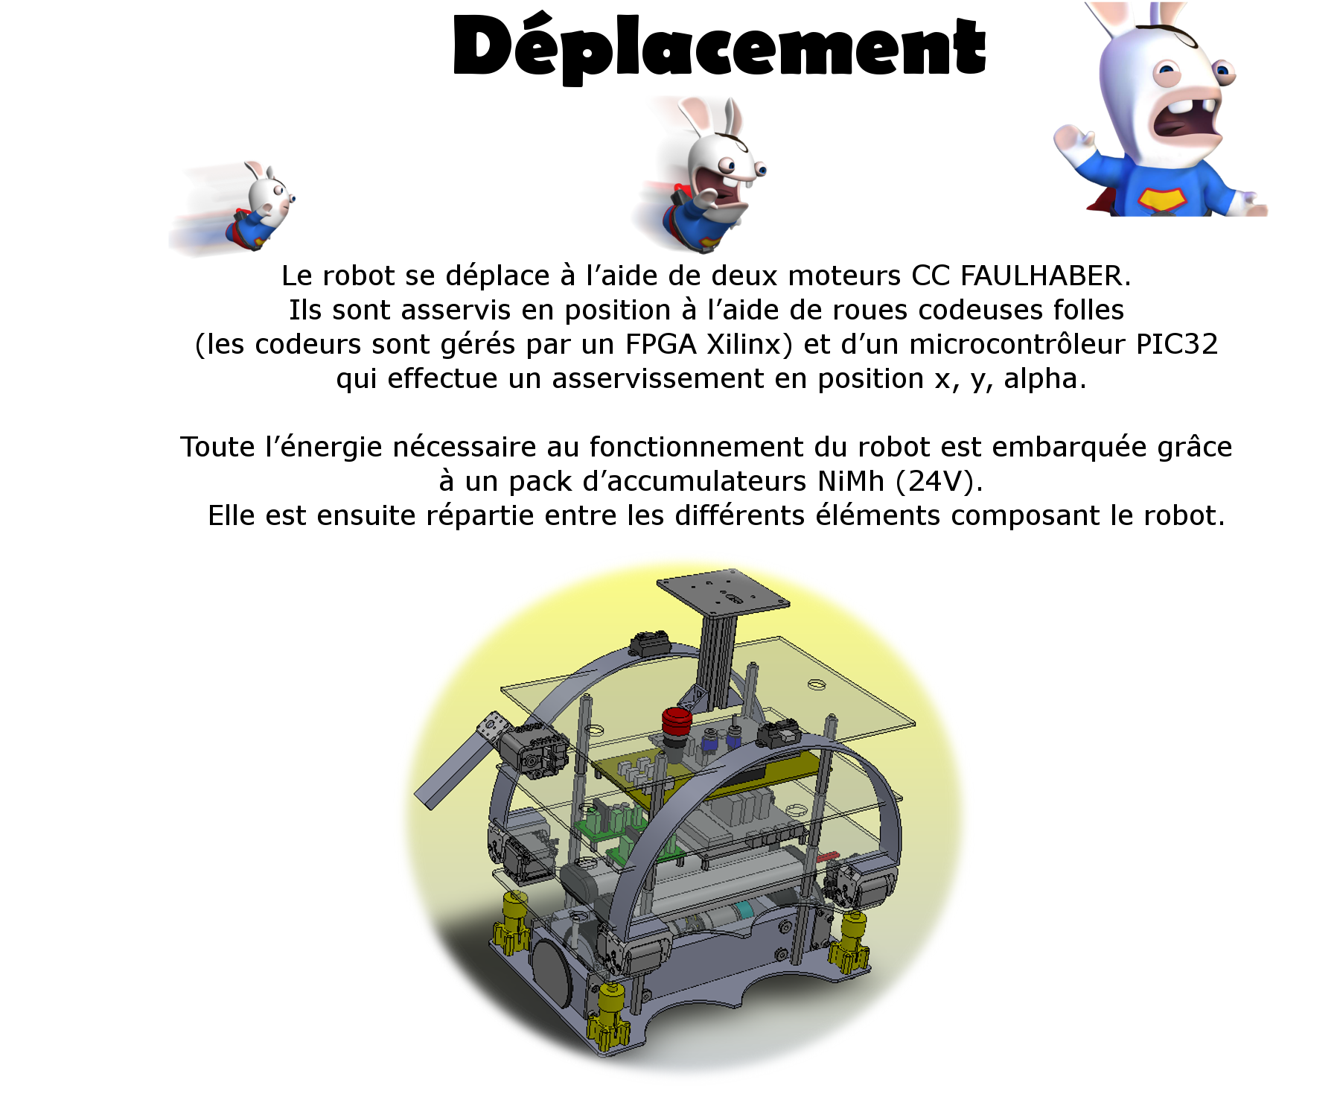
Coupe/Coupe2013/Poster/Poster2013_FR/Déplacement.png
