massinissalounis/oufffteam/Coupe/Coupe2013/Poster/Poster2013_FR/Intelligence.png

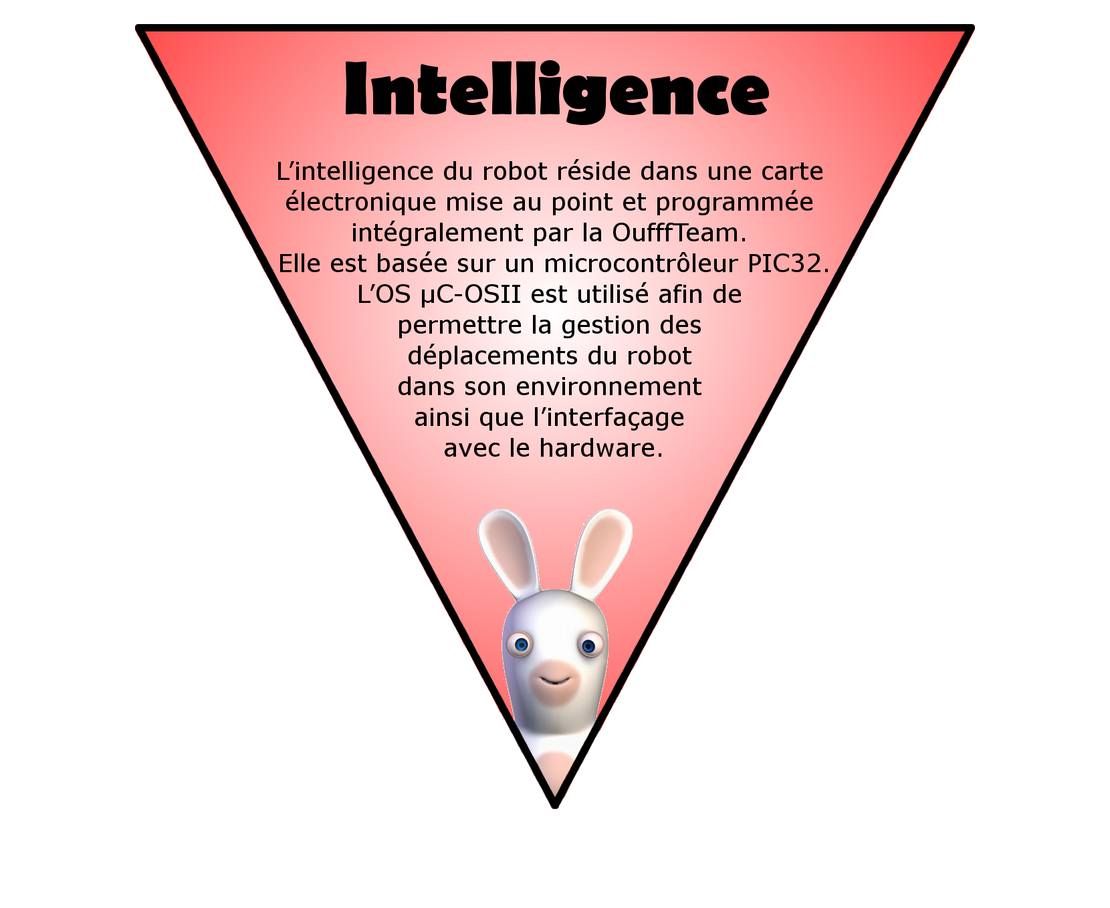
Coupe/Coupe2013/Poster/Poster2013_FR/Intelligence.png
