massinissalounis/oufffteam/Coupe/Coupe2013/Poster/Poster2013_FR/SchémaBlocs.png

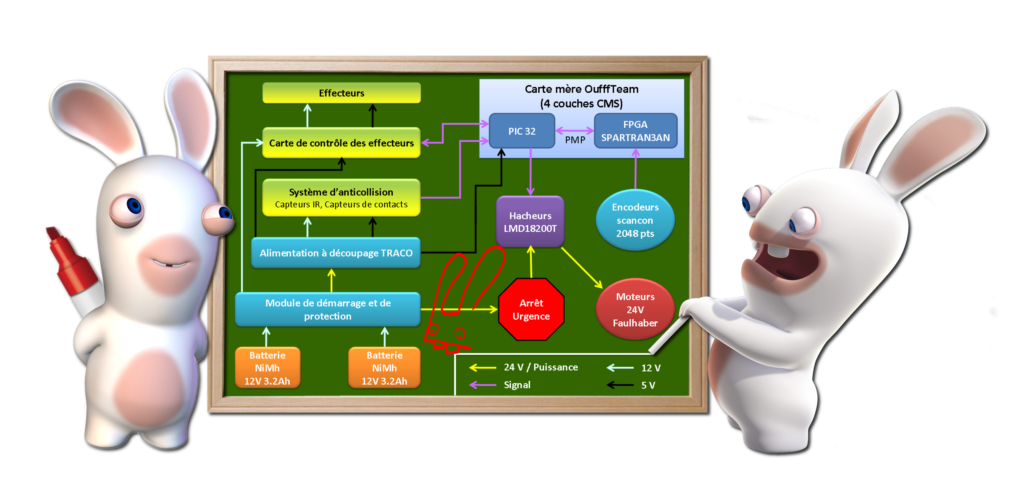
Coupe/Coupe2013/Poster/Poster2013_FR/SchémaBlocs.png
