massinissalounis/oufffteam/Coupe/Coupe2013/Poster/Poster2013_FR/Stratégie/Terrain.png

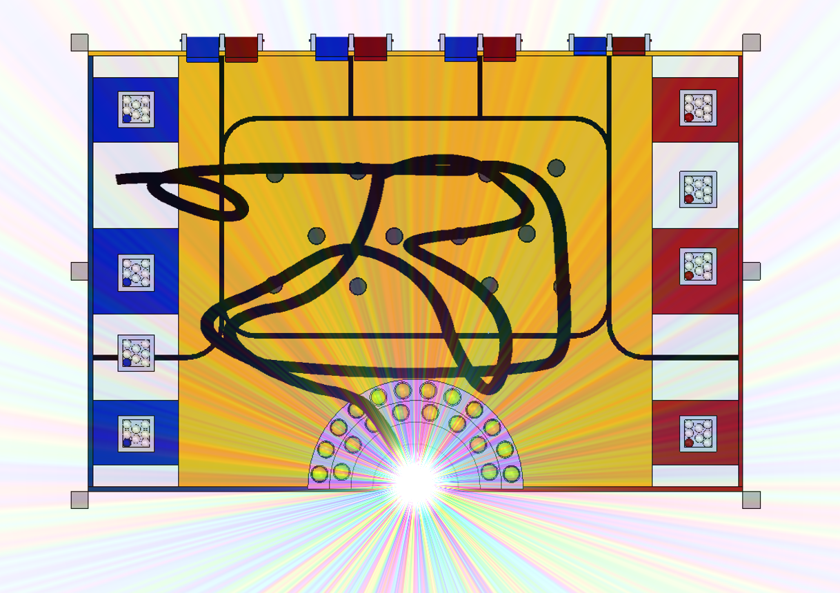
Coupe/Coupe2013/Poster/Poster2013_FR/Stratégie/Terrain.png
