massinissalounis/oufffteam/Coupe/Coupe2013/Poster/Poster2013_FR/Stratégie/TerrainVide.png

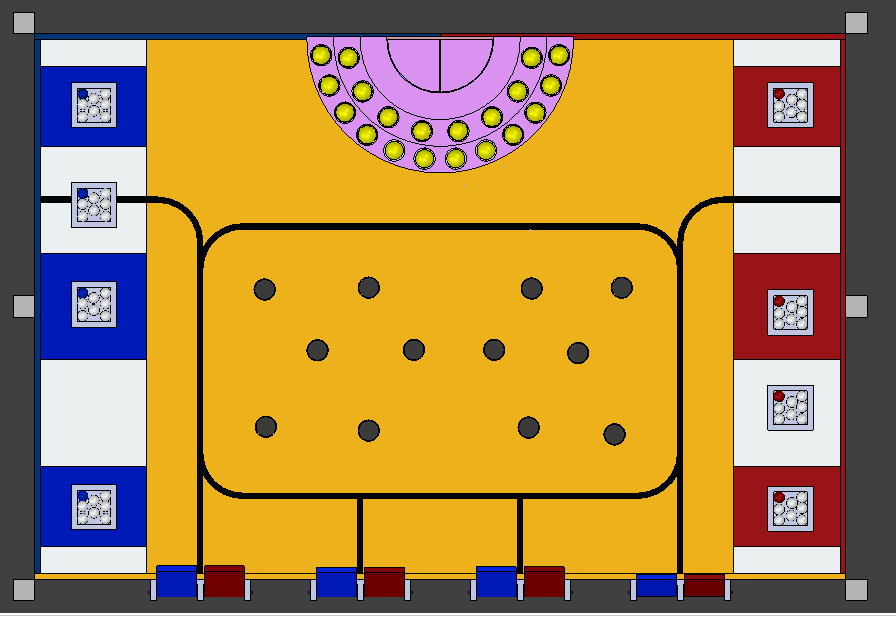
Coupe/Coupe2013/Poster/Poster2013_FR/Stratégie/TerrainVide.png
