massinissalounis/oufffteam/Dev_uCOS-II/Oufff2011/Conception/Projet 2011.jpg

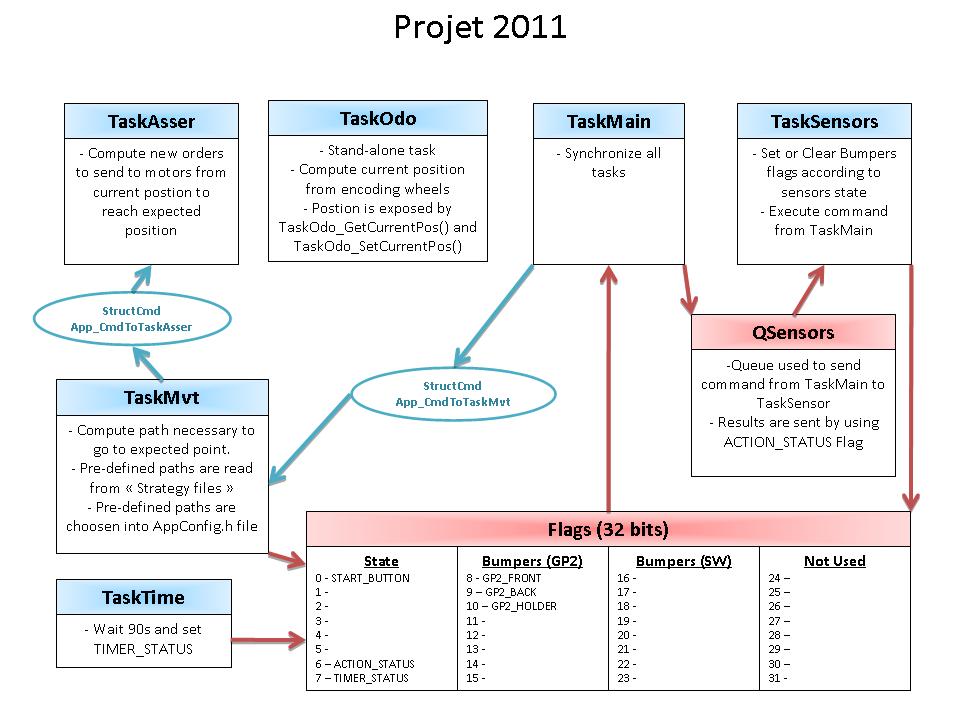
Dev_uCOS-II/Oufff2011/Conception/Projet 2011.jpg
