massinissalounis/oufffteam/Dev_uCOS-II/Oufff2013_DemoAsser1/Conception/TaskMain/TaskMain.png

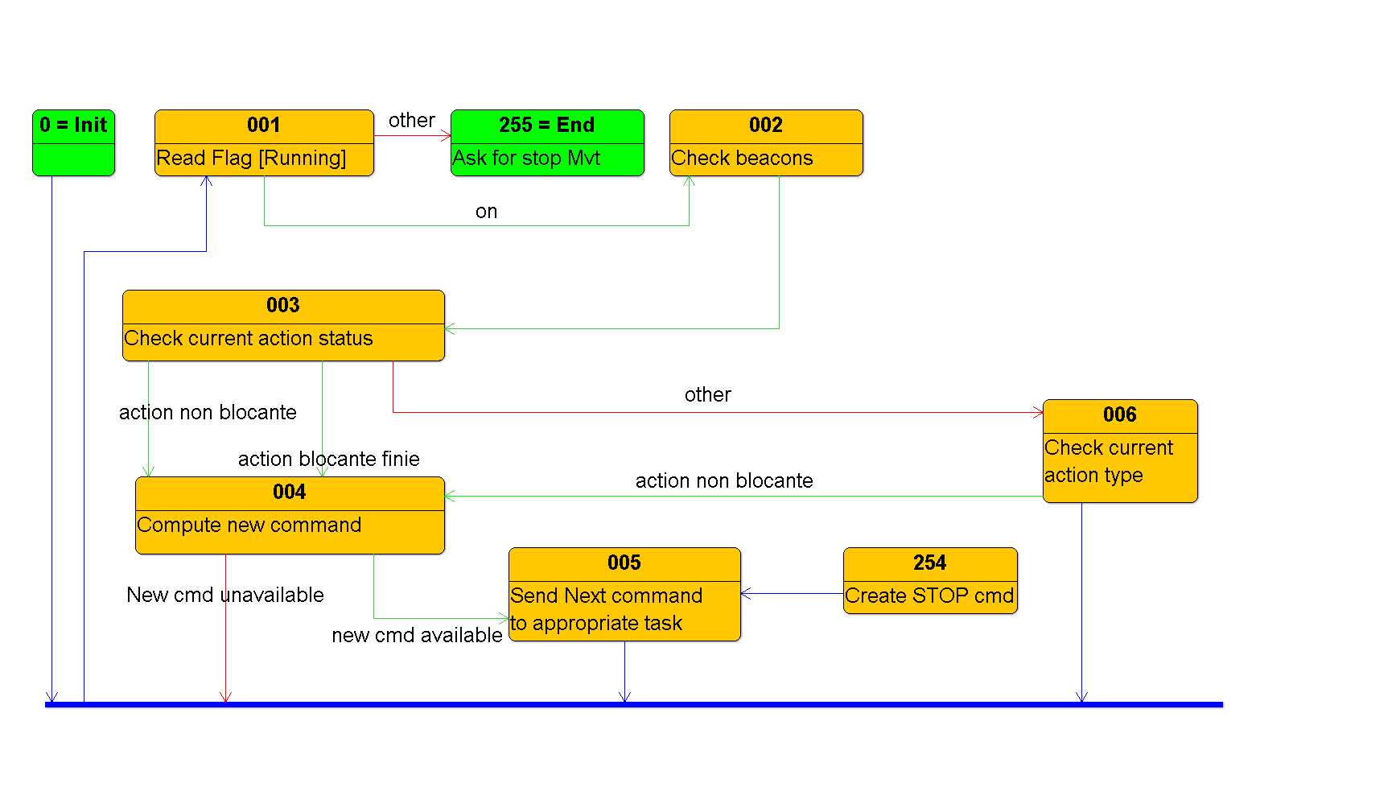
Dev_uCOS-II/Oufff2013_DemoAsser1/Conception/TaskMain/TaskMain.png
