massinissalounis/oufffteam/Dev_uCOS-II/Oufff2013_DemoAsser1/Conception/TaskMvt/TaskMvt.png

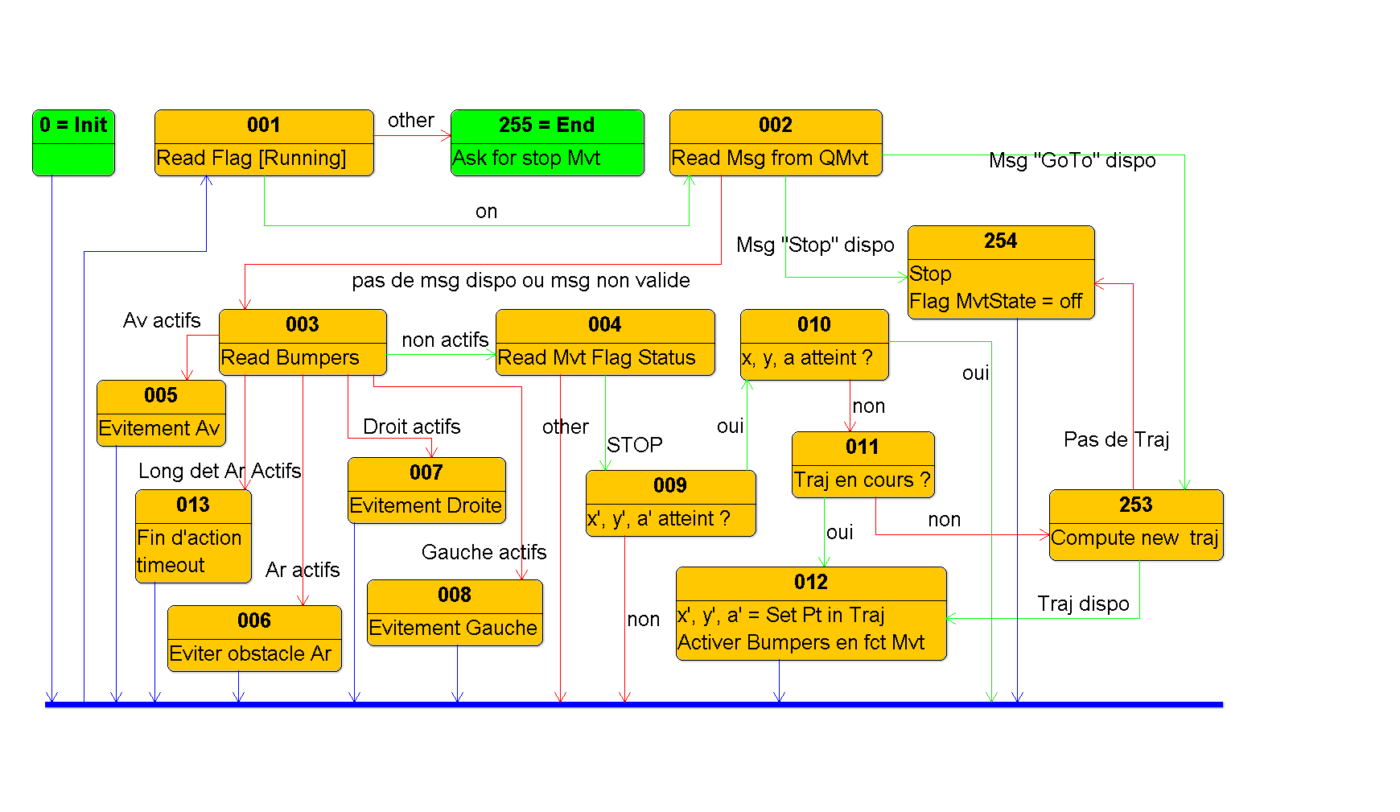
Dev_uCOS-II/Oufff2013_DemoAsser1/Conception/TaskMvt/TaskMvt.png
