massinissalounis/oufffteam/Dev_uCOS-II/Oufff2013_DemoExempleStrategy/Conception/Projet2013.png

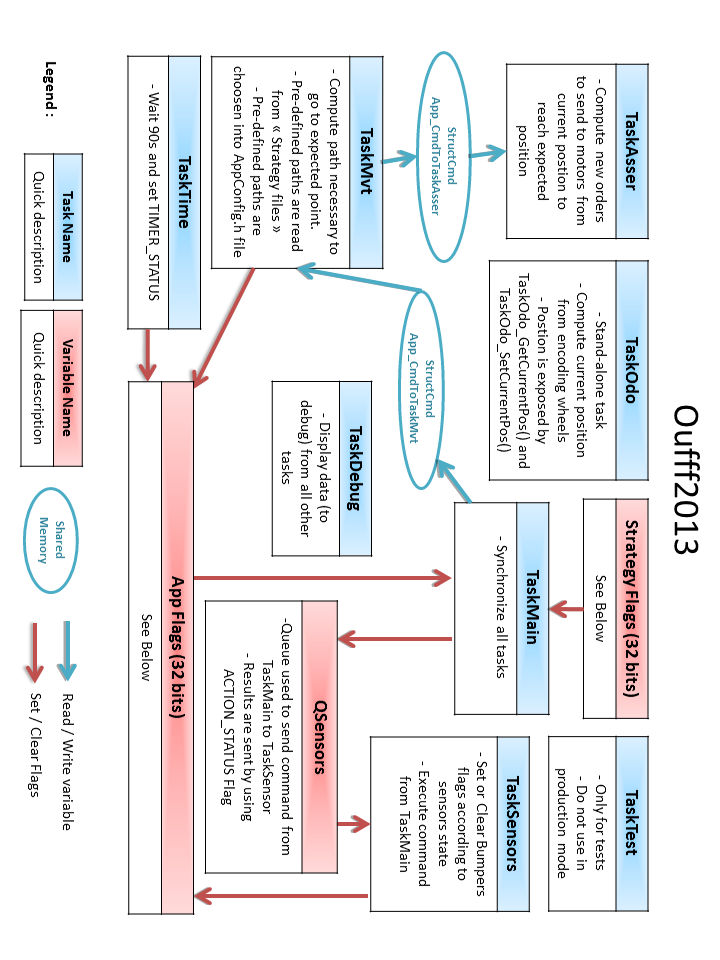
Dev_uCOS-II/Oufff2013_DemoExempleStrategy/Conception/Projet2013.png
