massinissalounis/oufffteam/Elec/2011/Balises IR/Documentations/totofweb/emission-brd.png

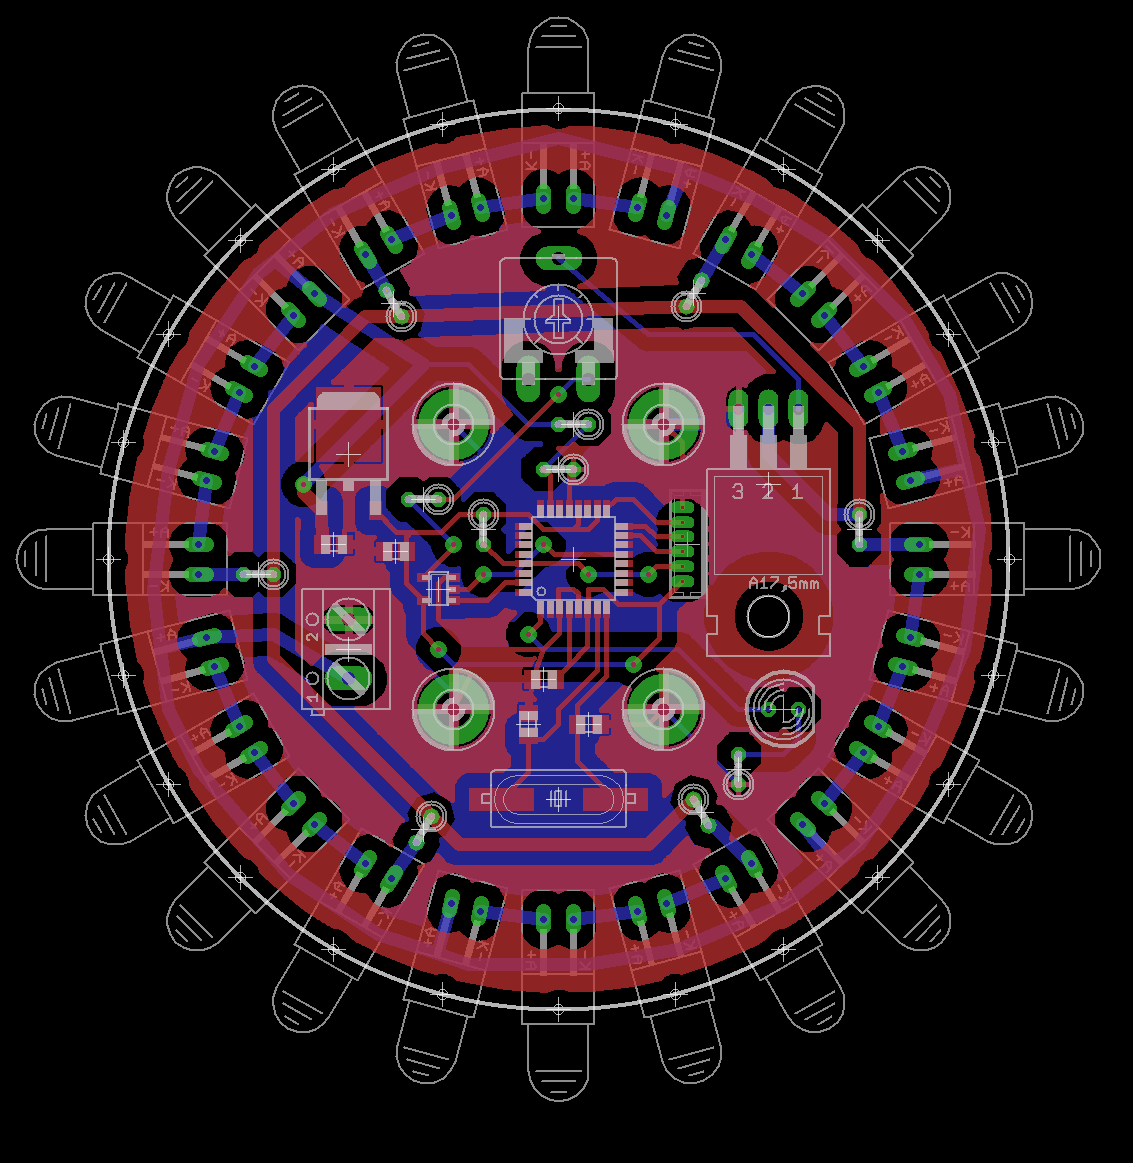
Elec/2011/Balises IR/Documentations/totofweb/emission-brd.png
