massinissalounis/oufffteam/Elec/2011/Balises IR/Documentations/totofweb/emission-sch.png

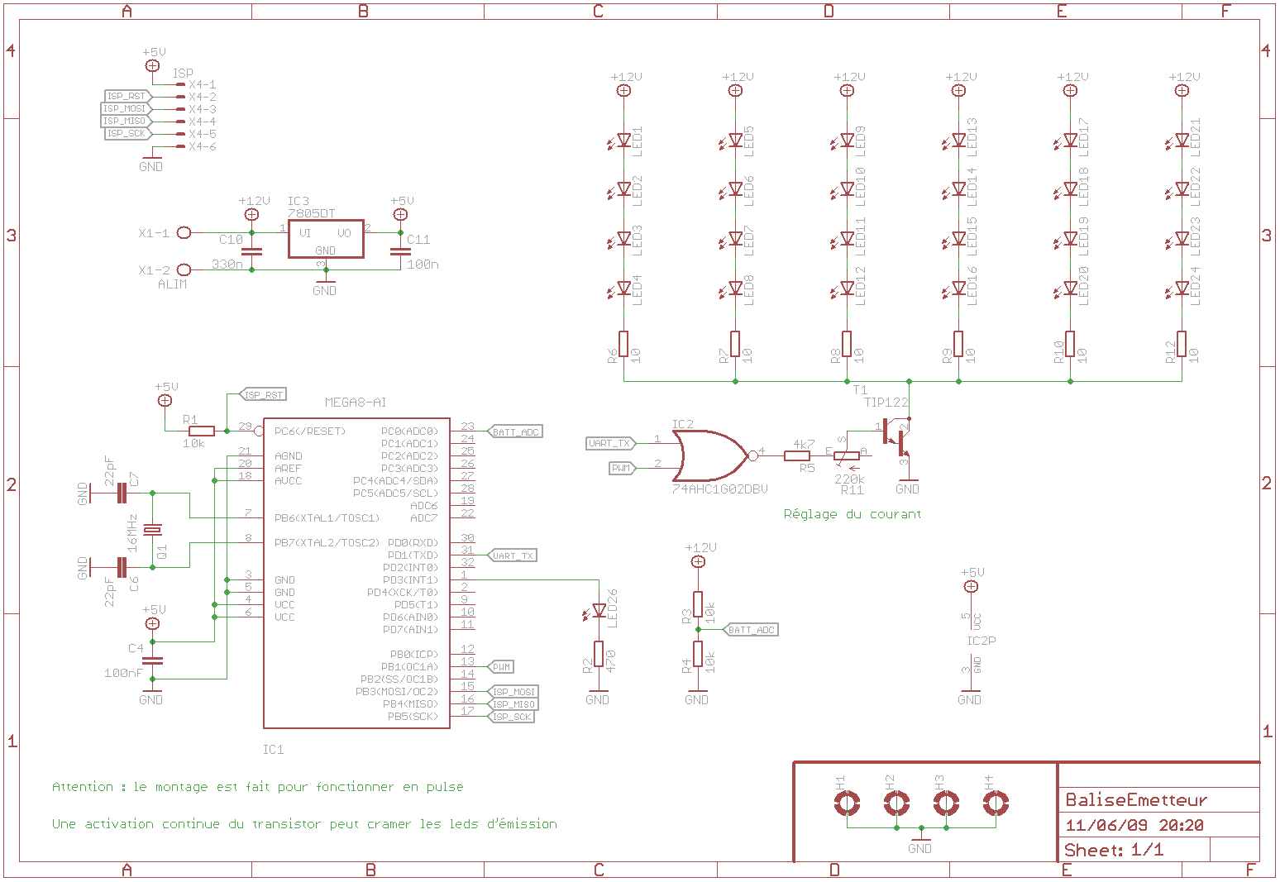
Elec/2011/Balises IR/Documentations/totofweb/emission-sch.png
