massinissalounis/oufffteam/Elec/2011/Balises IR/Documentations/totofweb/reception-brd.png

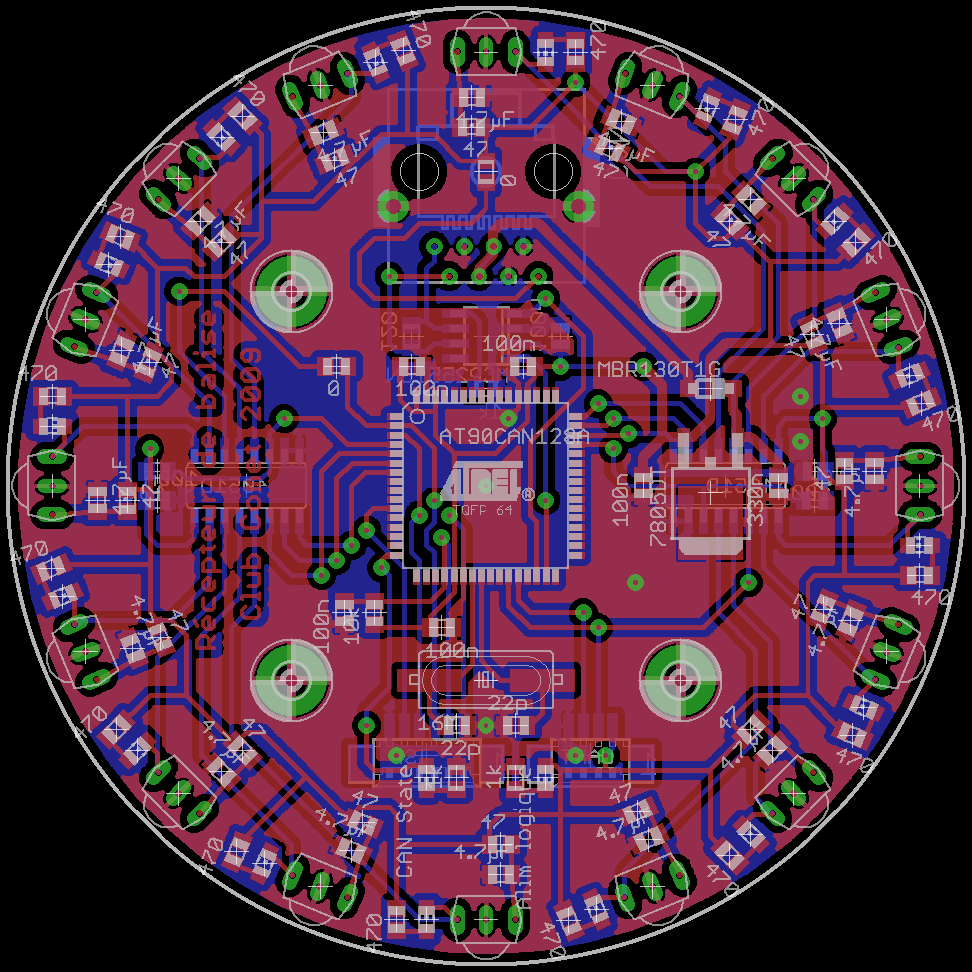
Elec/2011/Balises IR/Documentations/totofweb/reception-brd.png
