massinissalounis/oufffteam/Elec/2011/Balises IR/Documentations/totofweb/reception-sch.png

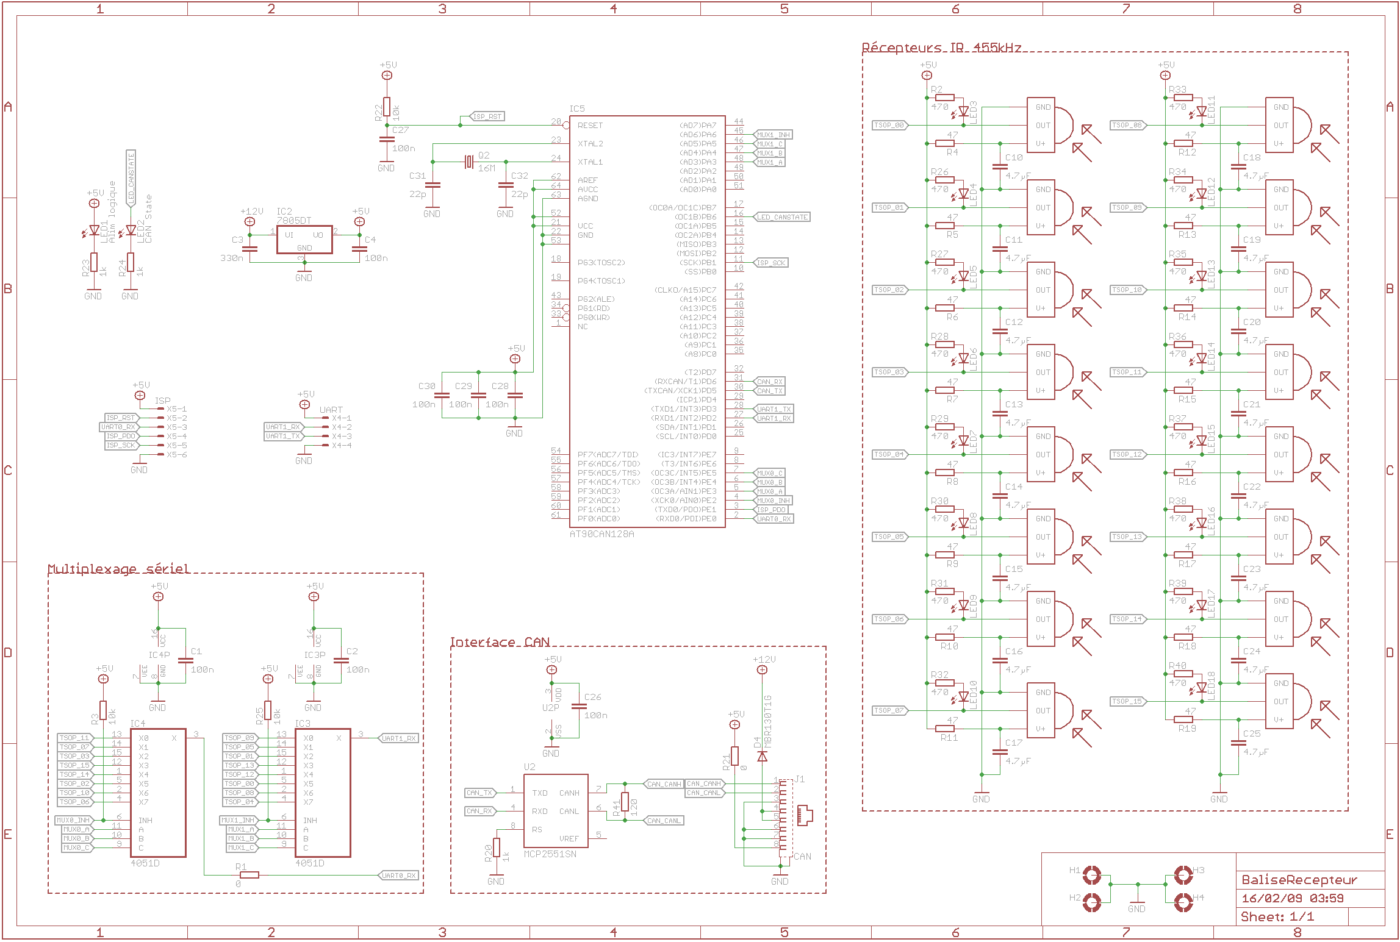
Elec/2011/Balises IR/Documentations/totofweb/reception-sch.png
