massinissalounis/oufffteam/Info/StrategyGenerator/v1 - 2012/Codage/Images/Map.png

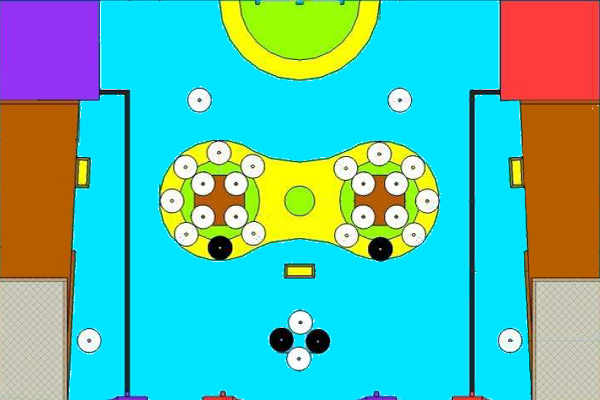
Info/StrategyGenerator/v1 - 2012/Codage/Images/Map.png
