massinissalounis/oufffteam/Info/StrategyGenerator/v1 - 2012/Conception/png/InterfacesIHMStrategy.png

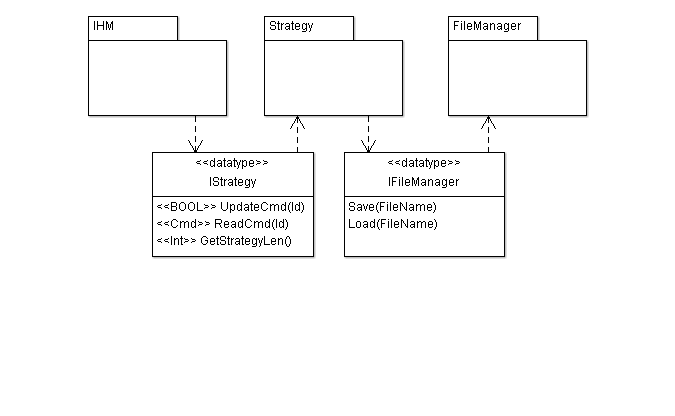
Info/StrategyGenerator/v1 - 2012/Conception/png/InterfacesIHMStrategy.png
