massinissalounis/oufffteam/Info/StrategyGenerator/v1 - 2012/Conception/png/UseCaseFileManager.png

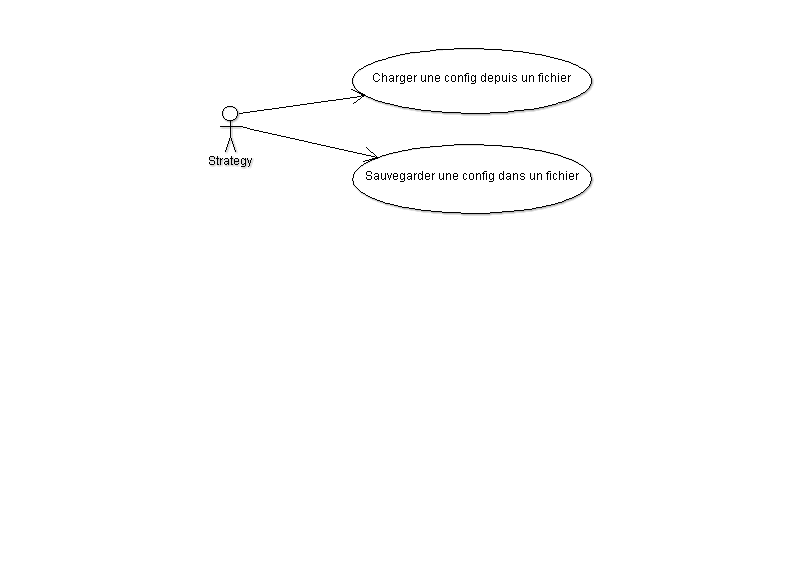
Info/StrategyGenerator/v1 - 2012/Conception/png/UseCaseFileManager.png
