massinissalounis/oufffteam/Info/StrategyGenerator/v1 - 2012/Conception/png/UseCaseIHM.png

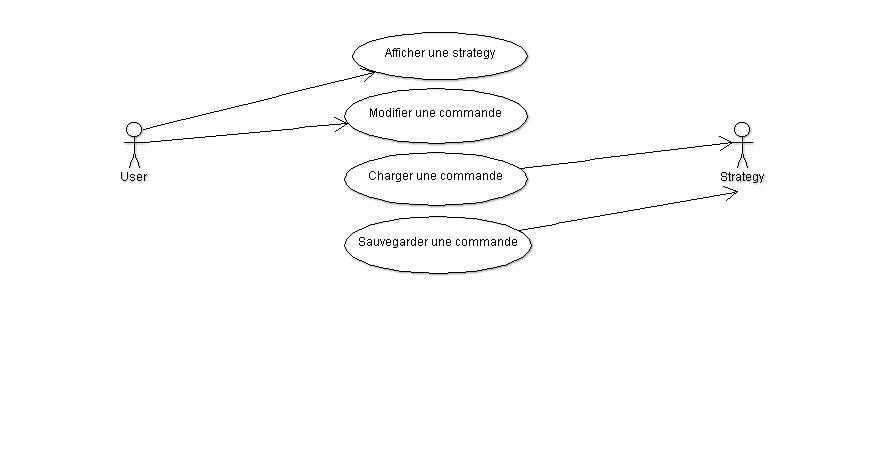
Info/StrategyGenerator/v1 - 2012/Conception/png/UseCaseIHM.png
