massinissalounis/oufffteam/Info/StrategyGenerator/v1 - 2012/Conception/png/UseCaseStrategy.png

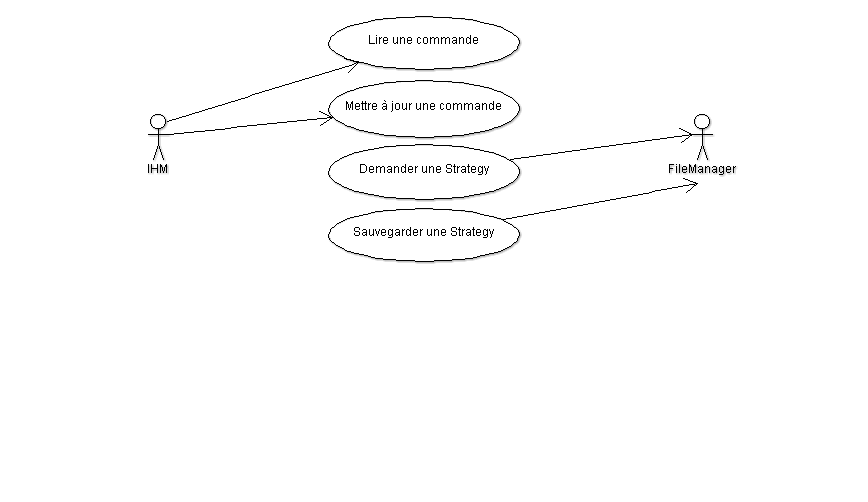
Info/StrategyGenerator/v1 - 2012/Conception/png/UseCaseStrategy.png
