massinissalounis/oufffteam/Info/StrategyGenerator/v2 - 2013/Codage/Res/Terrain.png

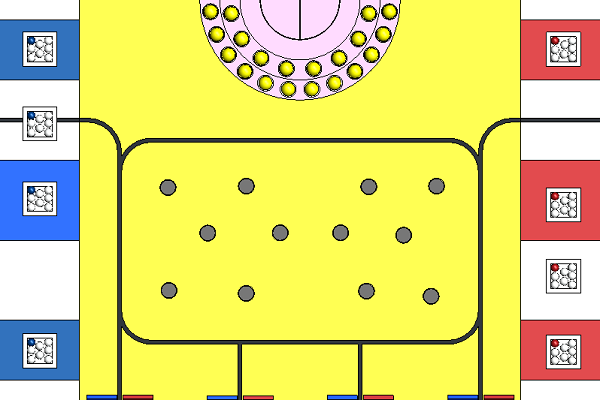
Info/StrategyGenerator/v2 - 2013/Codage/Res/Terrain.png
