massinissalounis/oufffteam/Info/StrategyGenerator/v2 - 2013/Conception/ImagesTerrain/TerrainFull.bmp

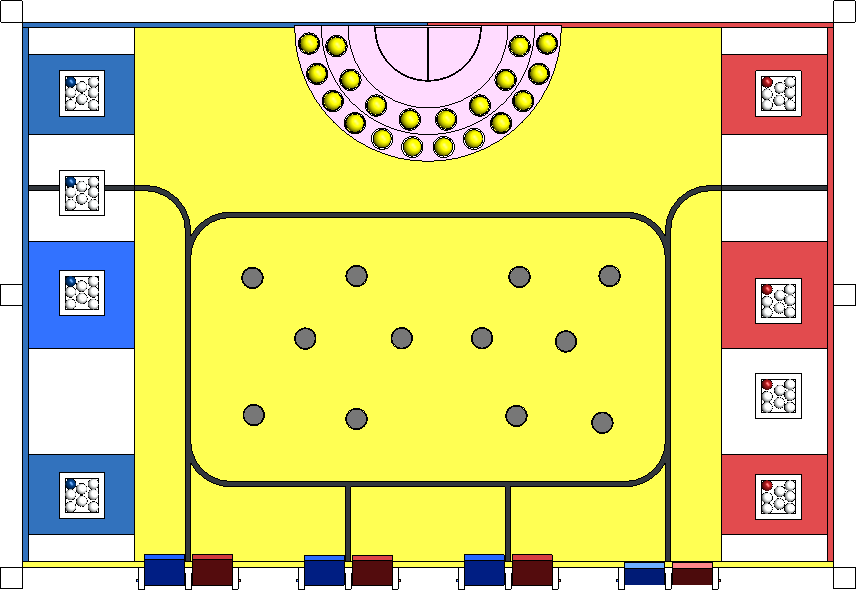
Info/StrategyGenerator/v2 - 2013/Conception/ImagesTerrain/TerrainFull.bmp
