massinissalounis/oufffteam/Info/StrategyGenerator/v2 - 2013/Conception/png/Niv 0 - 1_UseCases.png

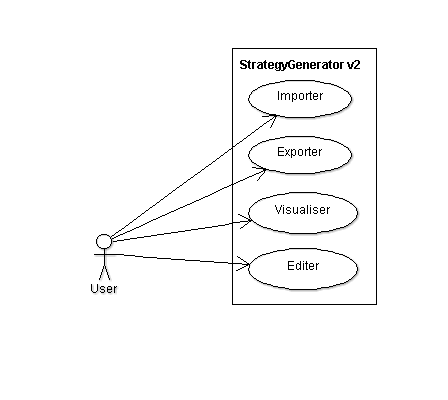
Info/StrategyGenerator/v2 - 2013/Conception/png/Niv 0 - 1_UseCases.png
