massinissalounis/oufffteam/Info/StrategyGenerator/v2 - 2013/Conception/png/Niv 0 - 2_Package.png

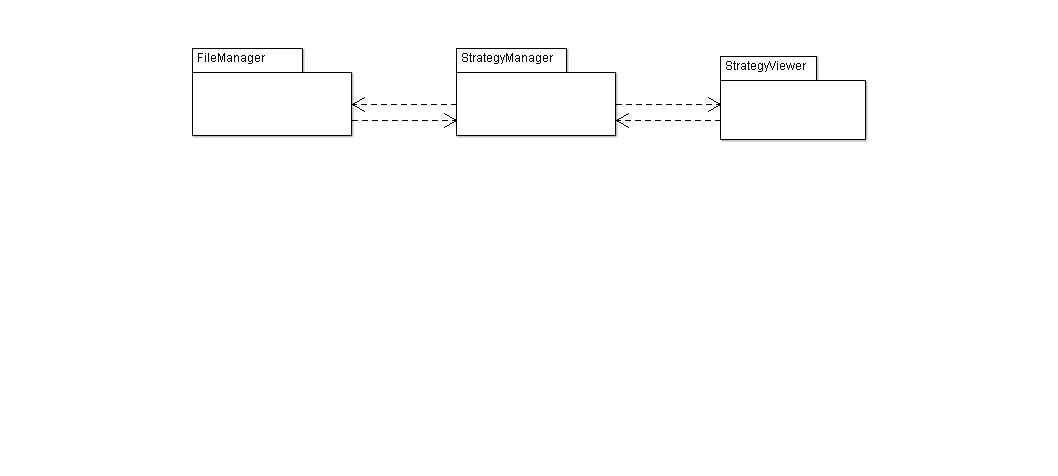
Info/StrategyGenerator/v2 - 2013/Conception/png/Niv 0 - 2_Package.png
