massinissalounis/oufffteam/Info/StrategyGenerator/v2 - 2013/Conception/png/Niv 0 - 3_Interfaces.png

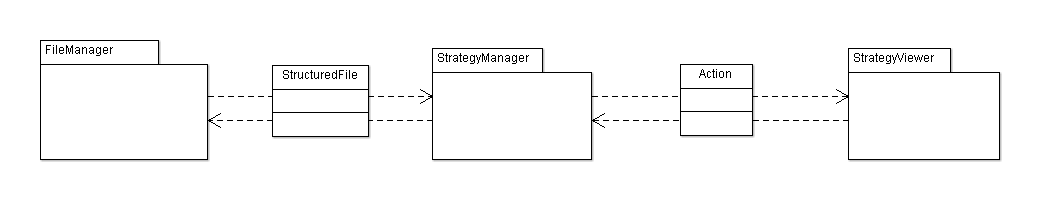
Info/StrategyGenerator/v2 - 2013/Conception/png/Niv 0 - 3_Interfaces.png
