massinissalounis/oufffteam/Info/StrategyGenerator/v2 - 2013/Conception/png/Niv 1 - 1_UseCases_FileManager.png

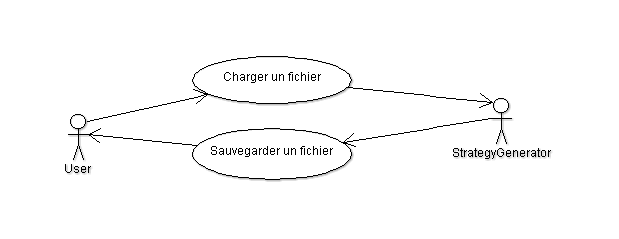
Info/StrategyGenerator/v2 - 2013/Conception/png/Niv 1 - 1_UseCases_FileManager.png
