massinissalounis/oufffteam/Info/StrategyGenerator/v2 - 2013/Conception/png/Niv 1 - 1_UseCases_StrategyViewer.png

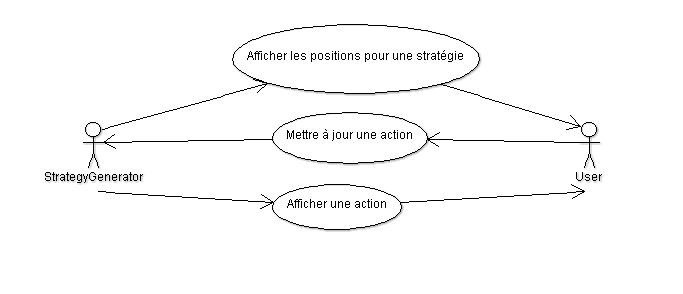
Info/StrategyGenerator/v2 - 2013/Conception/png/Niv 1 - 1_UseCases_StrategyViewer.png
