massinissalounis/oufffteam/Meca/Captures_ecran/Robot_2011_Bras_CD_vue_iso_2.JPG

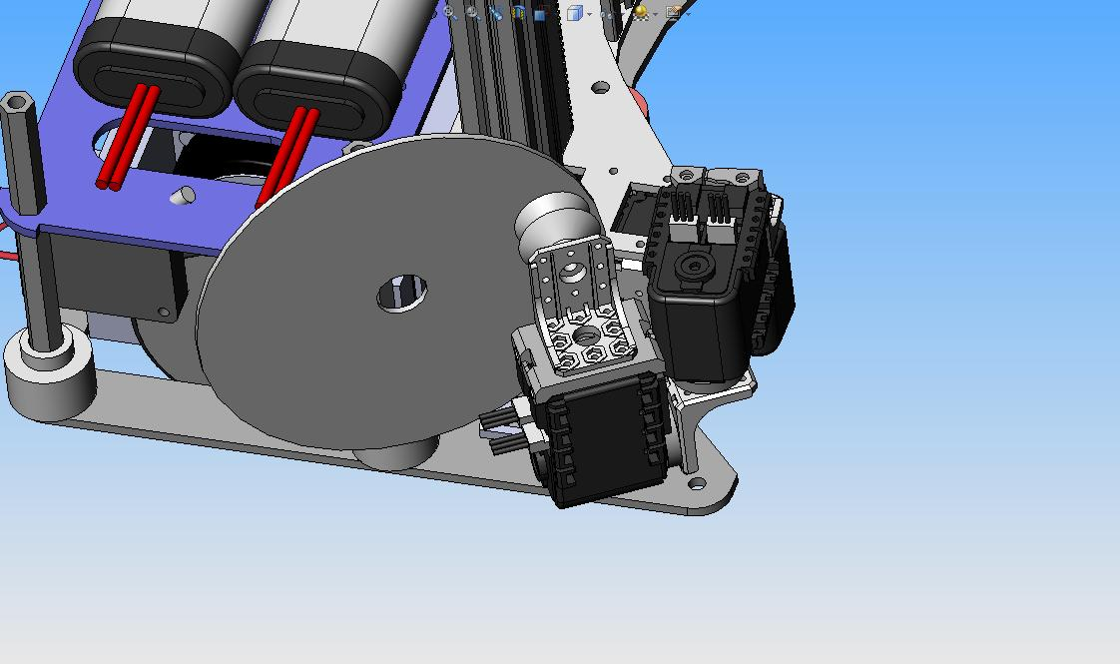
Meca/Captures_ecran/Robot_2011_Bras_CD_vue_iso_2.JPG
