massinissalounis/oufffteam/Meca/Captures_ecran/Robot_2011_Bras_Lingot_hauteur_vue_cote.JPG

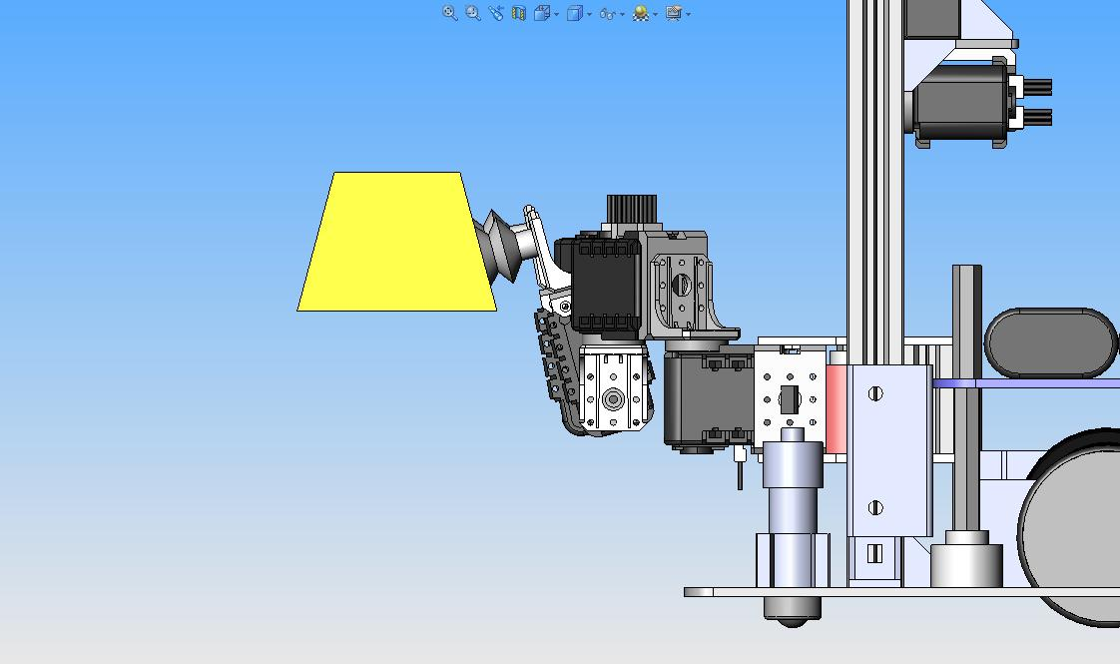
Meca/Captures_ecran/Robot_2011_Bras_Lingot_hauteur_vue_cote.JPG
