massinissalounis/oufffteam/Meca/Captures_ecran/Robot_2011_Bras_Lingot_vue_iso.JPG

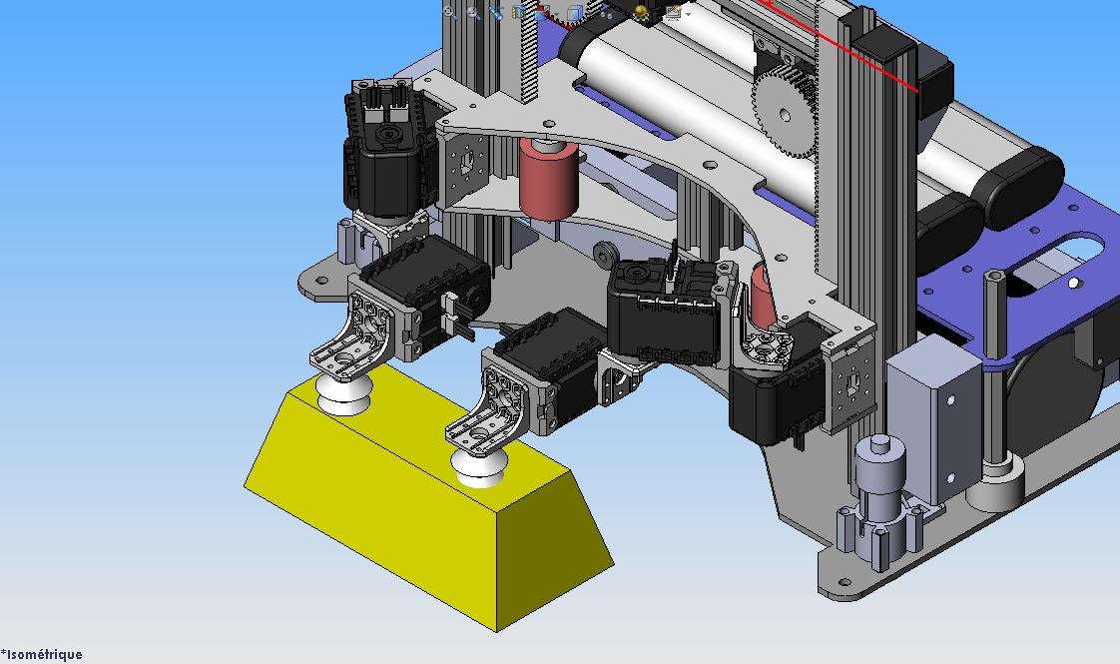
Meca/Captures_ecran/Robot_2011_Bras_Lingot_vue_iso.JPG
