massinissalounis/oufffteam/Meca/Captures_ecran/Terrain_2012_complet_vue_haut.JPG

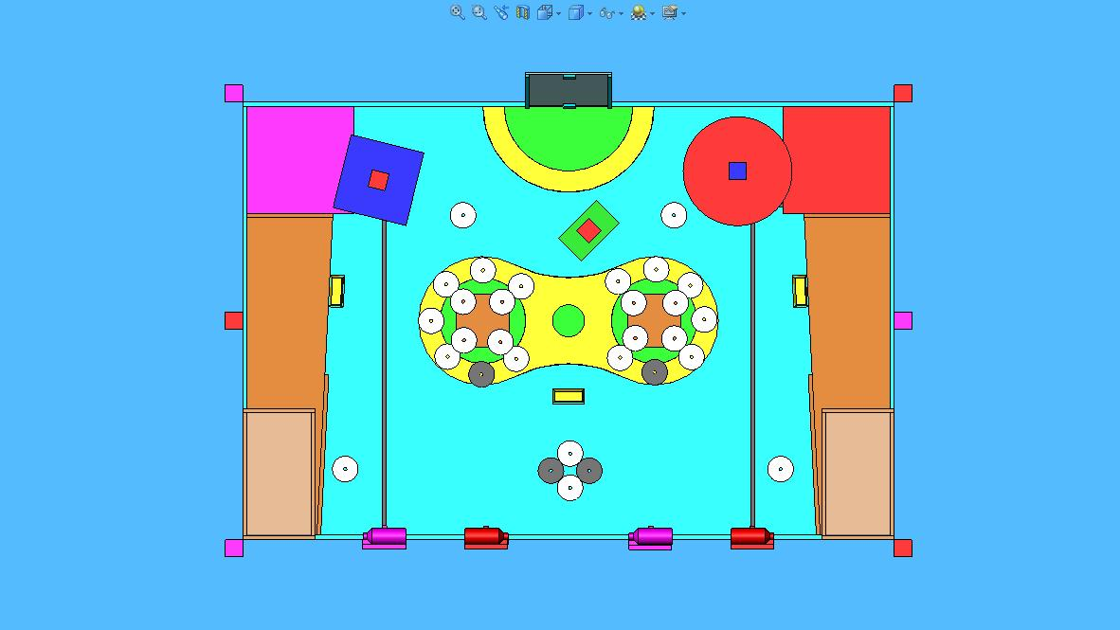
Meca/Captures_ecran/Terrain_2012_complet_vue_haut.JPG
