massinissalounis/oufffteam/Meca/Captures_ecran/Terrain_2012_complet_vue_iso.JPG

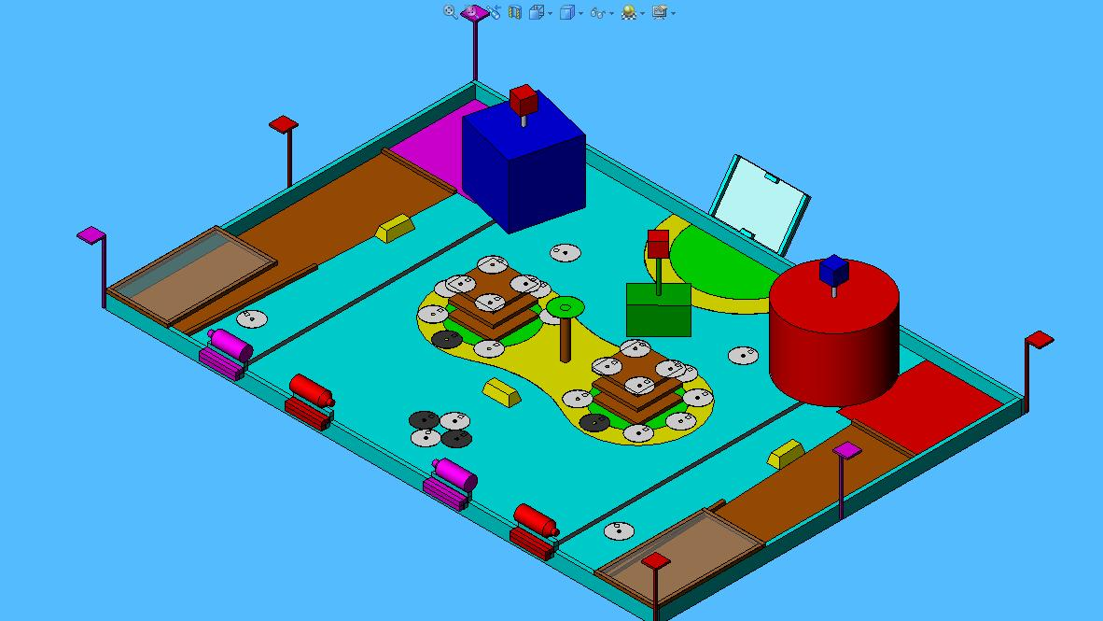
Meca/Captures_ecran/Terrain_2012_complet_vue_iso.JPG
