massinissalounis/oufffteam/Meca/Pieces_detachees/Moteur_faulhauber_3042W024C/Docs techniques Moteur/Faulhaber/3042W024C/P1000586.jpg

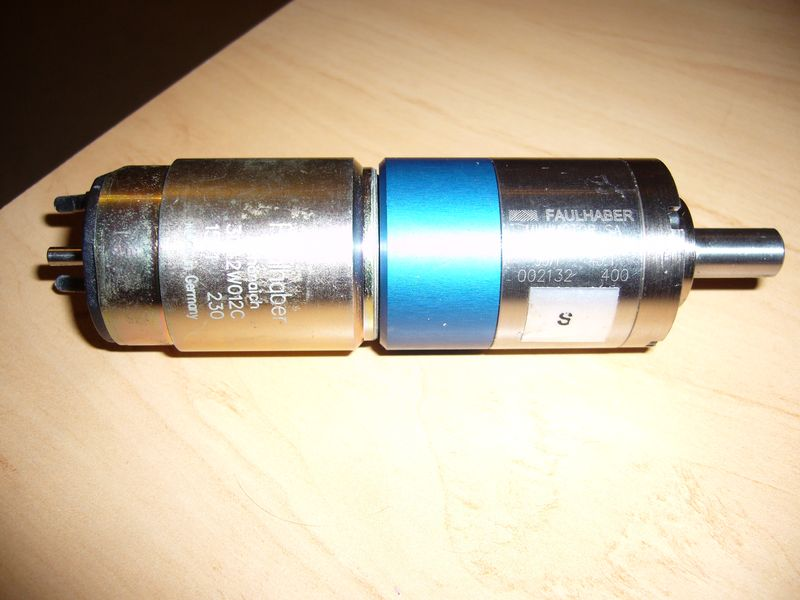
Meca/Pieces_detachees/Moteur_faulhauber_3042W024C/Docs techniques Moteur/Faulhaber/3042W024C/P1000586.jpg
