massinissalounis/oufffteam/Meca/Pieces_detachees/Pompe_vide_Sparkfun/10398-02__49743_zoom.jpg

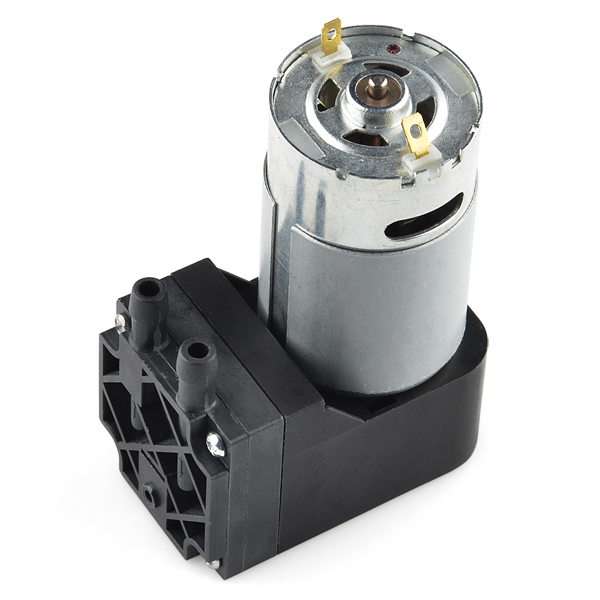
Meca/Pieces_detachees/Pompe_vide_Sparkfun/10398-02__49743_zoom.jpg
