massinissalounis/oufffteam/Meca/Pieces_detachees/Pompe_vide_Sparkfun/10398-03__39637_zoom.jpg

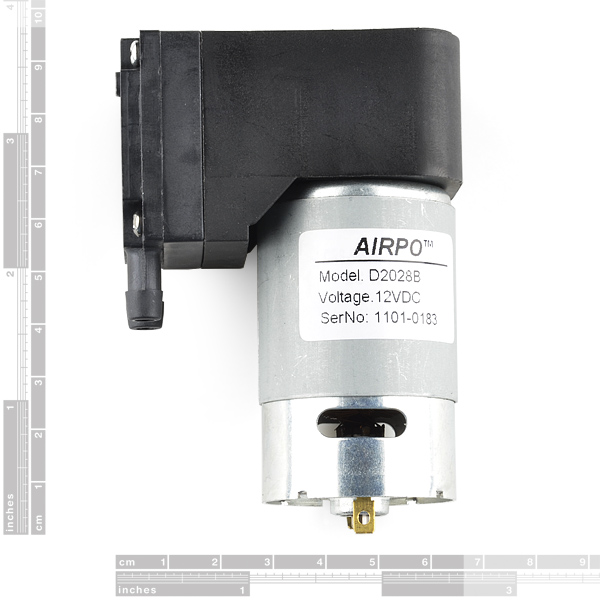
Meca/Pieces_detachees/Pompe_vide_Sparkfun/10398-03__39637_zoom.jpg
