massinissalounis/oufffteam/Meca/Pieces_detachees/Pompe_vide_Sparkfun/dimensional.jpeg

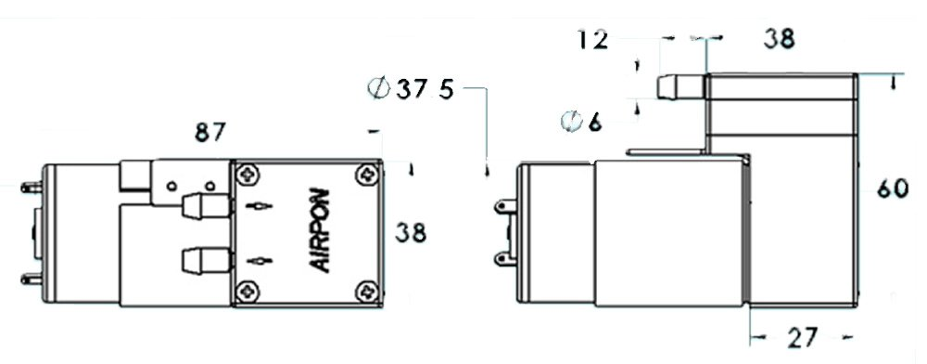
Meca/Pieces_detachees/Pompe_vide_Sparkfun/dimensional.jpeg
