massinissalounis/oufffteam/Meca/Pieces_detachees/Pompe_vide_Sparkfun/spec sheet.jpeg

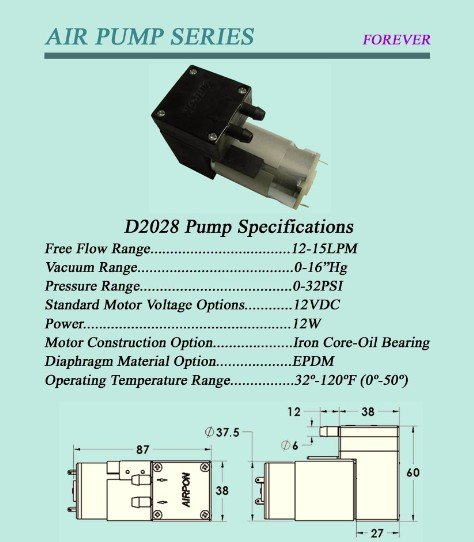
Meca/Pieces_detachees/Pompe_vide_Sparkfun/spec sheet.jpeg
