massinissalounis/oufffteam/Meca/Plans Robot 2013/Bras CBE/bras_pousseur_rentré.JPG

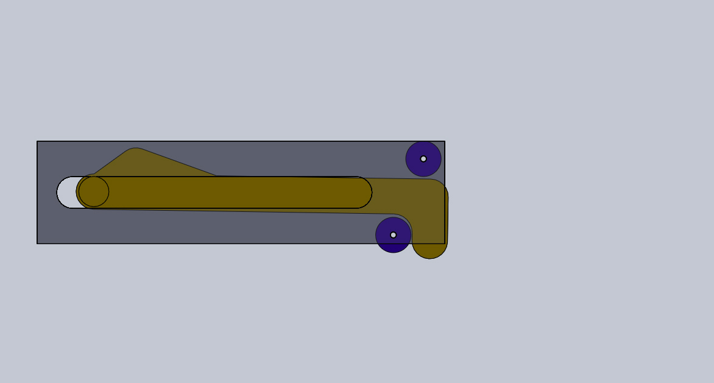
Meca/Plans Robot 2013/Bras CBE/bras_pousseur_rentré.JPG
