massinissalounis/oufffteam/Meca/Plans Robot 2013/Petit robot/Robot_2011/Travaux patrick/motorisation pat/image/vue2.bmp

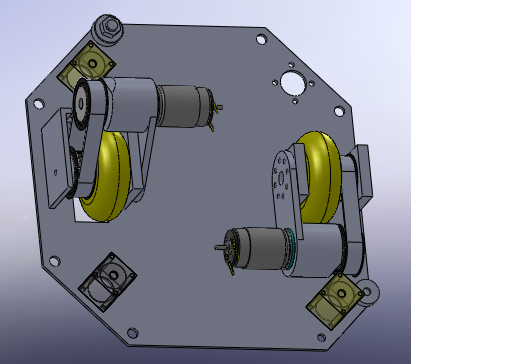
Meca/Plans Robot 2013/Petit robot/Robot_2011/Travaux patrick/motorisation pat/image/vue2.bmp
