massinissalounis/oufffteam/Meca/Plans Robot 2013/Petit robot/support bille/vue.bmp

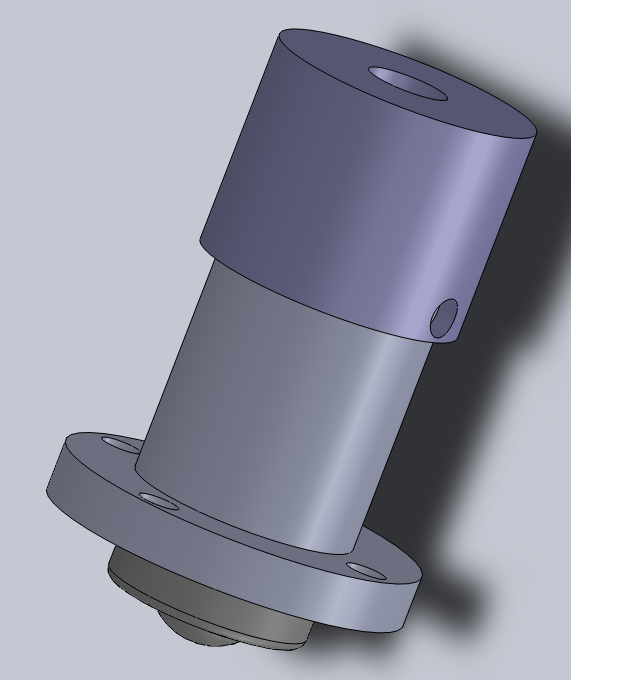
Meca/Plans Robot 2013/Petit robot/support bille/vue.bmp
