massinissalounis/oufffteam/Meca/Plans Robot 2013/pince_a_verre/pince_a_verre.JPG

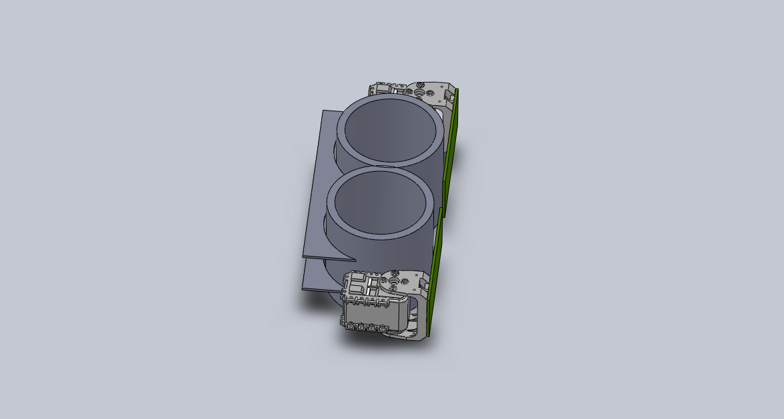
Meca/Plans Robot 2013/pince_a_verre/pince_a_verre.JPG
