massinissalounis/oufffteam/Meca/Plans Robot 2013/Robot_pincipal_sur terrain.png

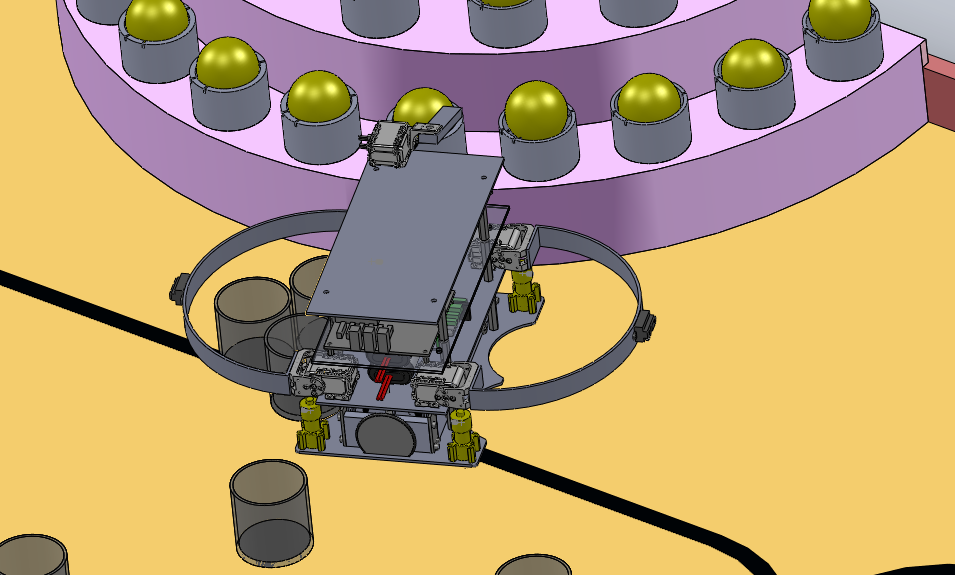
Meca/Plans Robot 2013/Robot_pincipal_sur terrain.png
