massinissalounis/oufffteam/Meca/Plans Robot 2013/Robot_principal_11022013.png

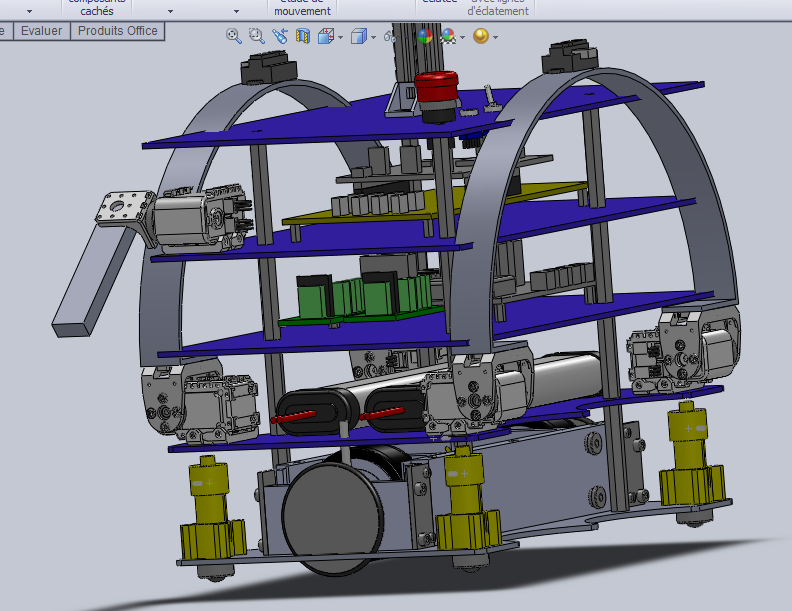
Meca/Plans Robot 2013/Robot_principal_11022013.png
