massinissalounis/oufffteam/Meca/Table_2013/Documents/Cadeaux.JPG

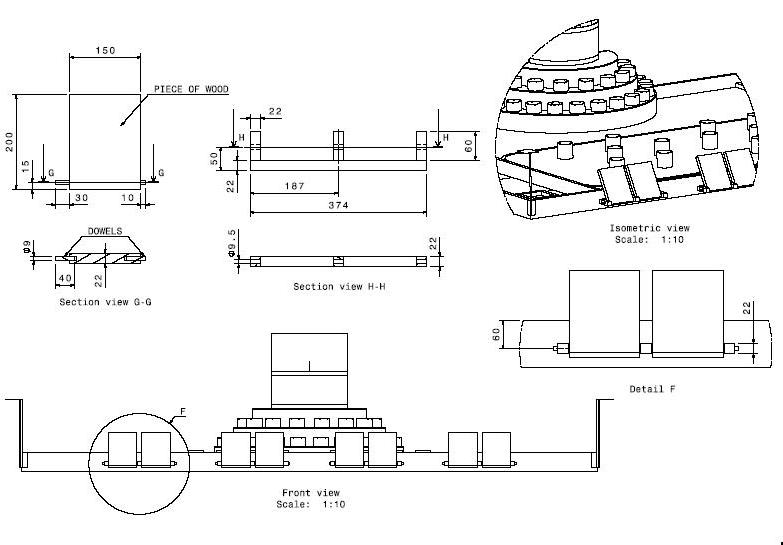
Meca/Table_2013/Documents/Cadeaux.JPG
