massinissalounis/oufffteam/Meca/Table_2013/Documents/Gateau.JPG

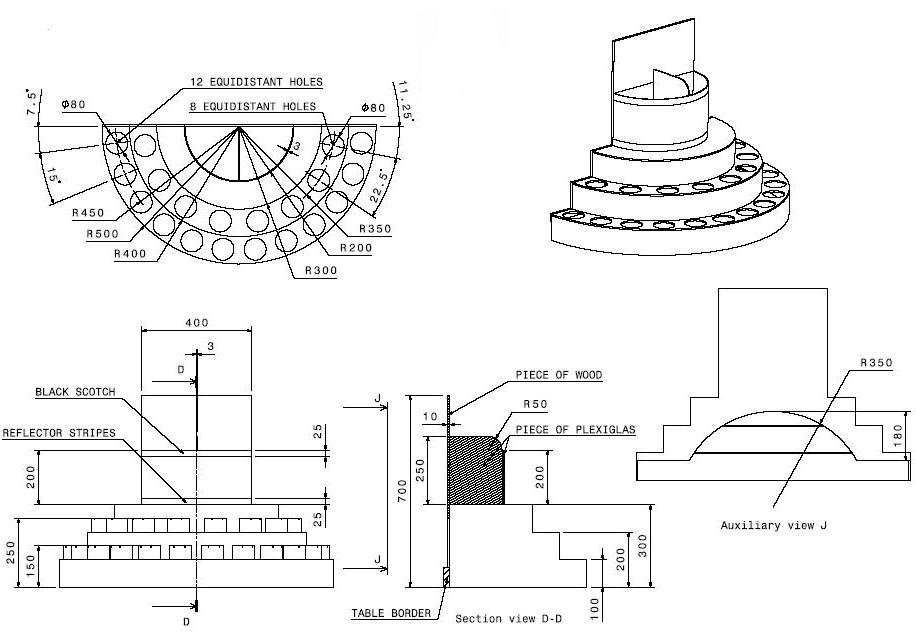
Meca/Table_2013/Documents/Gateau.JPG
