massinissalounis/oufffteam/Meca/Table_2013/Documents/Tables_2013_Couleurs.JPG

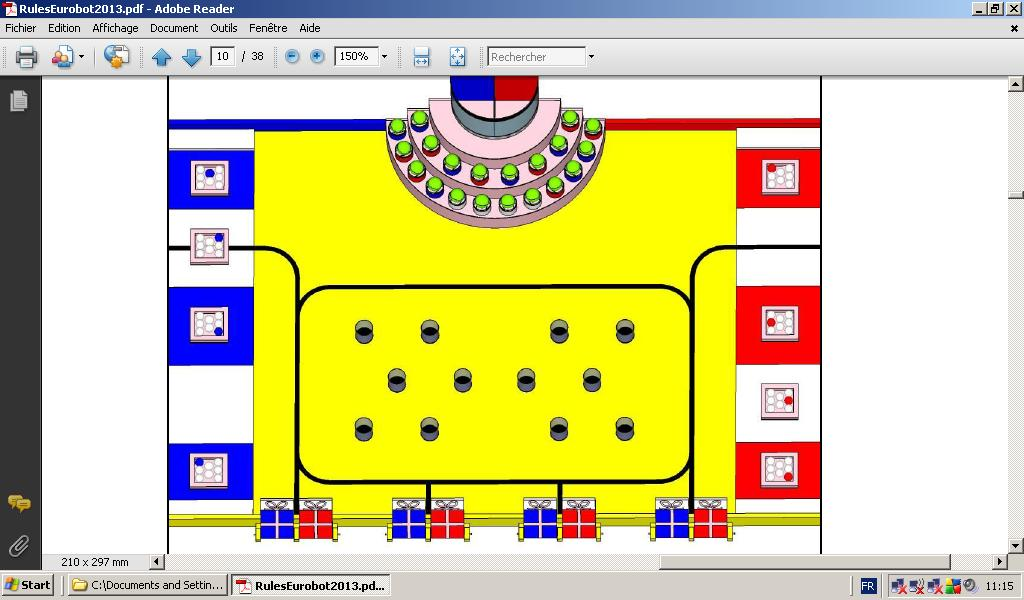
Meca/Table_2013/Documents/Tables_2013_Couleurs.JPG
