massinissalounis/oufffteam/Meca/Table_2013/Documents/Tables_2013_Couleurs_perspective.JPG

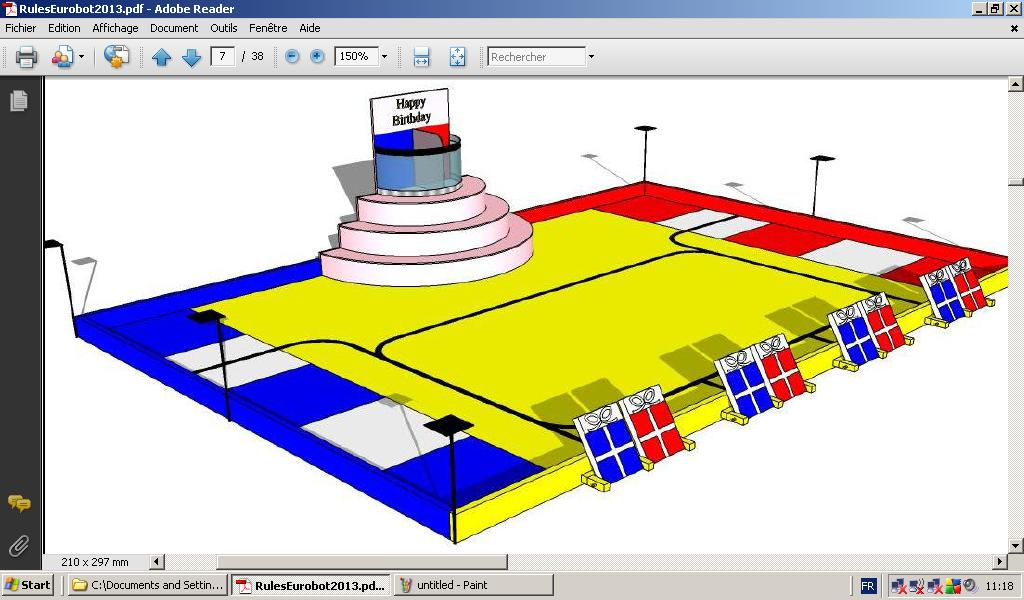
Meca/Table_2013/Documents/Tables_2013_Couleurs_perspective.JPG
