massinissalounis/oufffteam/Elec/2013/BOM cartes 2013.xlsx

Sheet: Carte alimentation
Quantité sur la carte | produit | fabricant | ref fabriquant | fournisseur | ref fournisseur | MOQ | Quantité commande | Prix unitaire HT | Prix total | Remarques
7 paires | Porte fusible | RS |  | RS | 563-756 | 25 | 25 | 0.33 € | 8.25 € | par sachet de 25
3 | Interrupteur à levier vertical | NKK Nikkai | M2012SA1W40 |  |  |  |  |  | 0.00 €
 | Interrupteur à levier vertical | GRAYHILL | 34ASP12B4M7QT | Farnell | 1288418 |  | 10 | 7.44 € | 74.40 €
 | Interrupteur à levier vertical | C & K COMPONENTS | 7101MD9AV2BE | Farnell | 9575502 |  |  | 7.69 € | 0.00 €
 | Interrupteur à levier vertical | Apem | 5236ww |  |  |  |  |  | 0.00 €
1 | Interrupteur à levier vertical momentané | KNITTER-SWITCH | STM 106 F – VM |  |  |  |  |  | 0.00 €
 | Interrupteur à levier vertical momentané | NKK Nikkai | M2015SA1W40 |  |  |  |  |  | 0.00 €
 | Interrupteur à levier vertical momentané | C & K COMPONENTS | 7108MD9AV2BE |  |  |  |  |  | 0.00 €
 | Interrupteur à levier vertical momentané | Apem | 5232ww |  |  |  |  |  | 0.00 €
1 | Module d'alimentation | Traco | TEN20-2411WIN | Farnell | 1284266 |  | 2 | 42.60 € | 85.20 €
 | Module d'alimentation | Traco | TEN20-2411WIN | RS | 438-363 |  |  | 43.03 € | 0.00 €
1 | Résistance trad 280 Ohm |  |  | CBE |  |  |  |  | 0.00 €
2 | Résistance trad 8 kOhm |  |  | CBE |  |  |  |  | 0.00 €
1 | Résistance trad 4 kOhm |  |  | CBE |  |  |  |  | 0.00 €
4 | Diodes 1N4001 |  |  | CBE |  |  |  |  | 0.00 €
4 | LED |  |  | CBE |  |  |  |  | 0.00 €
7 | Fusibles 1A |  |  |  |  |  |  |  | 0.00 € | voir stock
2 | embase MOLEX KK 2 voies | Molex | 22-27-2021 | RS | 483-8461 | multiple de 10 |  | 0.476 € | 0.00 €
 | embase MOLEX KK 2 voies | Molex | 22-27-2021 | Farnell | 9731148 |  |  | 0.44 € | 0.00 €
 | embase MOLEX KK 2 voies |  |  | Electronique Diffusion | COKK254M-2 |  |  | 0.20 € | 0.00 € | voir stock
4 | embase MOLEX KK 3 voies | Molex | 22-27-2031 | RS | 483-8477 | multiple de 10 |  | 0.83 € | 0.00 €
 | embase MOLEX KK 3 voies | Molex | 22-27-2031 | Farnell | 9731156 |  |  | 0.86 € | 0.00 €
 | embase MOLEX KK 3 voies |  |  | Electronique Diffusion | COKK254M-3 |  |  | 0.20 € | 0.00 € | voir stock
2 | Relais 2 voies NC-NF |  |  |  |  |  |  |  | 0.00 € | voir stock
2 | Relais 1 voie |  |  |  |  |  |  |  | 0.00 € | voir stock
 | Bornier à vis 2 voies pas de 5,08 mm | Weidmuller | PM 5.08/2/90 3.5 SW | RS | 425-8720 | multiple de 5 | 20 | 0.254 € | 5.08 €
6 | Bornier à vis 2 voies pas de 5,08 mm |  |  | Electronique Diffusion | COCMM52 |  |  | 0.30 € | 0.00 €
 | Embase pour bornier débrochable 2 voies pas de 5,08 mm | TE Connectivity | 796636-2 | RS | 710-0419 | multiple de 10 |  | 0.72 € | 0.00 €
2 | Fiche à vis 2 voies pas de 5,08 mm |  |  | Electronique Diffusion | COCMM550382 |  | 5 | 1.50 € | 7.50 €
2 | Embase pour bornier débrochable 2 voies pas de 5,08 mm |  |  | Electronique Diffusion | COCMM554093 |  | 5 | 0.50 € | 2.50 €
1 | Tole de face avant |  |  | PAT |  |  |  |  | 0.00 €
 |  |  |  |  |  |  |  |  | 0.00 €
 |  |  |  |  |  |  |  | Total | 182.93 €

Sheet: Carte connectique CM
Quantité sur la carte | produit | fabricant | ref fabriquant | fournisseur | ref fournisseur | MOQ | Quantité commande | Prix unitaire HT | Prix total | Remarques
13 | Résistance 10 Ohm 0603 |  |  | Centralp | SRC10RC91 |  |  |  | 0.00 €
35 | Résistance 10 kOhm 0603 |  |  | Centralp | SRC10KC91 |  |  |  | 0.00 €
3 | Résistance 1 kOhm 0603 |  |  | Centralp | SRC1KC91 |  |  |  | 0.00 €
2 | Résistance 0 Omh 0603 |  |  | Centralp | SRC00RC02 |  |  |  | 0.00 €
16 | Condensateur 100 nF 0603 (5V min) |  |  | Centralp | SCC100nFC?? |  |  |  | 0.00 €
4 | Condensateur 100 pF 0603 (5V min) |  |  | Centralp | SCC100PFC?? |  |  |  | 0.00 €
11 | Condensateur 10 nF 0603 (5V min) |  |  | Centralp | SCC10NFC?? |  |  |  | 0.00 €
1 | Condensateur 1 µF chimique (5V min) 1 pas |  |  | Centralp |  |  |  |  | 0.00 €
3 | Condensateurs 10 µF chimique (5V min) 1 pas |  |  | Centralp |  |  |  |  | 0.00 €
5 | Buffers Transltateur de niveau TXS0104E | TI | TXS0104E | samples + commande |  |  |  |  | 0.00 €
1 | Régulateur LDO 3,3V TO-220 | TI | LM2937 | Samples |  |  |  |  | 0.00 €
2 | Embase pour barette 2x10 |  |  | Centralp | BB201I10 |  |  |  | 0.00 €
2 | barette 2x40 |  |  | Centralp |  |  |  |  | 0.00 €
12 | embase MOLEX KK 3 voies | Molex | 22-27-2031 | RS | 483-8477 | multiple de 10 |  | 0.83 € | 0.00 €
 | embase MOLEX KK 3 voies | Molex | 22-27-2031 | Farnell | 9731156 |  |  | 0.86 € | 0.00 €
 | embase MOLEX KK 3 voies |  |  | Electronique Diffusion | COKK254M-3 |  |  | 0.20 € | 0.00 € | voir stock
6 | embase MOLEX KK 2 voies | Molex | 22-27-2021 | RS | 483-8461 | multiple de 10 |  | 0.476 € | 0.00 €
 | embase MOLEX KK 2 voies | Molex | 22-27-2021 | Farnell | 9731148 |  |  | 0.44 € | 0.00 €
 | embase MOLEX KK 2 voies |  |  | Electronique Diffusion | COKK254M-2 |  |  | 0.20 € | 0.00 € | voir stock
5 | embase MOLEX KK 5 voies | Molex | 22-27-2051 | RS | 483-8499 | multiple de 10 |  | 0.88 € | 0.00 €
 | embase MOLEX KK 5 voies | Molex | 22-27-2051 | Farnell | 9731679 |  |  | 1.37 € | 0.00 €
 | embase MOLEX KK 5 voies |  |  | Electronique Diffusion | COKK254M-5 |  |  | 0.25 € | 0.00 € | voir stock
3 | embase MOLEX KK 4 voies | Molex | 22-27-2041 | RS | 483-8483 | multiple de 10 |  | 0.50 € | 0.00 €
 | embase MOLEX KK 4 voies | Molex | 22-27-2041 | Farnell | 9731164 |  |  | 0.51 € | 0.00 €
 | embase MOLEX KK 4 voies |  |  | Electronique Diffusion | COKK254M-4 |  |  | 0.20 € | 0.00 € | voir stock
1 | Embase pour bornier débrochable 2 voies pas de 5,08 mm | TE Connectivity | 796636-2 | RS | 710-0419 | multiple de 10 |  | 0.72 € | 0.00 €
1 | Fiche à vis 2 voies pas de 5,08 mm |  |  | Electronique Diffusion | COCMM550382 |  |  | 1.50 € | 0.00 €
 | Embase pour bornier débrochable 2 voies pas de 5,08 mm |  |  | Electronique Diffusion | COCMM554093 |  |  | 0.50 € | 0.00 €
 |  |  |  |  |  |  |  |  | 0.00 €
 |  |  |  |  |  |  |  |  | 0.00 €
 |  |  |  |  |  |  |  |  | 0.00 €
 |  |  |  |  |  |  |  |  | 0.00 €
 |  |  |  |  |  |  |  |  | 0.00 €
 |  |  |  |  |  |  |  | Total | 0.00 €

Sheet: Carte support capteur couleur
Quantité sur la carte | produit | fabricant | ref fabriquant | fournisseur | ref fournisseur | MOQ | Quantité commande | Prix unitaire HT | Prix total | Remarques
11 | Condensateur 10 nF 0603 (5V min) |  |  | Centralp | SCC10NFC?? |  |  |  | 0.00 €
1 | embase MOLEX KK 5 voies coudé | Molex |  | RS |  | multiple de 10 |  | 0.88 € | 0.00 €
 | embase MOLEX KK 5 voies coudé | Molex |  | Farnell |  |  |  | 1.37 € | 74.40 €
 | embase MOLEX KK 5 voies coudé |  |  | Electronique Diffusion | COKK254M-5C |  |  | 0.25 € | 0.00 € | voir stock
 |  |  |  |  |  |  |  | Total | 74.40 €

Sheet: Carte mère
Quantité sur la carte | produit | fabricant | ref fabriquant | fournisseur | ref fournisseur | MOQ | Quantité commande | Prix unitaire HT | Prix total | Remarques
1 | Embase USB type mini B |  |  | Farnell | 1654060 |  |  |  | 0.00 €
40 | 100n cap 0603 X7R 25V 0603 |  |  | Farnell | 1650835 |  |  |  | 0.00 €
5 | 100p cap 0603 X7R 25V 0603 |  |  | Farnell | 1414603 |  |  |  | 0.00 €
1 | 10n cap 0603 X7R 25V 0603 |  |  | Farnell | 1414609 |  |  |  | 0.00 €
3 | 10u cap Bcase Tantale 20V 6032 |  |  | Farnell | 1457462 |  |  |  | 0.00 €
5 | 10u cap X7R 1206 10V 1206 |  |  | Farnell | 1288264 |  |  |  | 0.00 €
2 | 15p cap 0603 X7R 25V 0603 |  |  | Farnell | 1414614 |  |  |  | 0.00 €
1 | Quartz-20.000-18SMDT |  |  | Farnell | 1667005 |  |  |  | 0.00 €
2 | BZX84C5V6 318-07 |  |  | Farnell | 1651565 |  |  |  | 0.00 €
1 | Diode 1N4448 0603 |  |  | Farnell | 8150206 |  |  |  | 0.00 €
2 | Diode MBRS340 SMC |  |  | Farnell | 9557377 |  |  |  | 0.00 €
2 | Header 20X2 |  |  | Farnell | 359970 |  |  |  | 0.00 €
7 | Molex KK male droit 4 points |  |  | Farnell | 9731164 |  |  |  | 0.00 €
2 | Barrette 1 x 6 pas 2,54mm |  |  | Farnell | 1022255 |  |  |  | 0.00 €
2 | Inductance 4.7U WE:744043004 |  |  | Farnell | 1635846 |  |  |  | 0.00 €
6 | LED 0603 |  |  | Farnell | 1685063 |  |  |  | 0.00 €
1 | LM2830Z DBV005 |  |  | Farnell | 1286715 |  |  |  | 0.00 €
1 | LP38858S-1.2 TO263-5Lead |  |  | Farnell | 1333965 |  |  |  | 0.00 €
1 | LTC6905 |  |  | Farnell | 1663923 |  |  |  | 0.00 €
1 | M24C16-WMN6 SOP8_N |  |  | Farnell | 9882774 |  |  |  | 0.00 €
1 | MCP2515 SOIC-18N |  |  | Farnell | 1605565 |  |  |  | 0.00 €
1 | MCP2551 SOIC-8_N |  |  | Farnell | 9758569 |  |  |  | 0.00 €
1 | PCA9515 751-02_M |  |  | Farnell | 511-002 |  |  |  | 0.00 €
1 | PIC32MX4XXL TQFP100_N |  |  | Farnell | 1640233 |  |  |  | 0.00 €
2 | Res 0 100mW 0603 |  |  | Farnell | 1469739 |  |  |  | 0.00 €
1 | Res 0.5 100mW 0603 |  |  | Farnell | 1506135 |  |  |  | 0.00 €
5 | Res 10 100mW 0603 |  |  | Farnell | 1469751 |  |  |  | 0.00 €
30 | Res 10k 100mW 0603 |  |  | Farnell | 1469749 |  |  |  | 0.00 €
1 | Res 33k 100mW 0603 |  |  | Farnell | 1469801 |  |  |  | 0.00 €
1 | Res 45k 100mW 0603 |  |  | Farnell | 1170952 |  |  |  | 0.00 €
1 | Res 560k 250mW 1206 |  |  | Farnell | 1576189 |  |  |  | 0.00 €
6 | Res 680 250mW 0603 |  |  | Farnell | 9332286 |  |  |  | 0.00 €
1 | SD CARD |  |  | Farnell | 1145893 |  |  |  | 0.00 €
1 | SN74LVC244ADW DW020_N |  |  | Farnell | 1102982 |  |  |  | 0.00 €
4 | SW-PB |  |  | Farnell | 1656433 |  |  |  | 0.00 €
1 | USBLC6-2 SOT23-6 |  |  | Farnell | 1269406RL |  |  |  | 0.00 €
1 | XC3S50AN-4TQG144C TQG144_N |  |  | Farnell | 1605840 |  |  |  | 0.00 €
 |  |  |  |  |  |  |  |  | 0.00 €
 |  |  |  |  |  |  |  |  | 0.00 €
 |  |  |  |  |  |  |  |  | 0.00 €
 |  |  |  |  |  |  |  |  | 0.00 €
 |  |  |  |  |  |  |  |  | 0.00 €
 |  |  |  |  |  |  |  |  | 0.00 €
 |  |  |  |  |  |  |  |  | 0.00 €
 |  |  |  |  |  |  |  |  | 0.00 €
 |  |  |  |  |  |  |  |  | 0.00 €
 |  |  |  |  |  |  |  | Total | 0.00 €

Sheet: Carte hacheur
Quantité sur la carte | produit | fabricant | ref fabriquant | fournisseur | ref fournisseur | MOQ | Quantité commande | Prix unitaire HT | Prix total | Remarques
6 | Cap 100n X7R 1206 100V |  |  | Farnell | 1362554 |  |  |  | 0.00 €
4 | Cap 220u Alu 3.5x8x11.5 35V |  |  | Farnell | 9693688 |  |  |  | 0.00 €
1 | Cap 10p X7R 0603 25V |  |  | Farnell | 1658863 |  |  |  | 0.00 €
1 | Cap 100p X7R 0603 25V |  |  | Farnell | 1414603 |  |  |  | 0.00 €
1 | MOLEX 22-27-2041 |  |  | Farnell | 1675766 |  |  |  | 0.00 €
1 | 1SMB24AT3G |  |  | Farnell | 1651636 |  |  |  | 0.00 €
2 | Self Wurth 7445101 |  |  | Farnell | 1636057 |  |  |  | 0.00 €
1 | Self Wurth 74477020 |  |  | Farnell | 1635930 |  |  |  | 0.00 €
2 | Borniers 2 débrochable pas 2,54mm |  |  | Farnell | 3913077 |  |  |  | 0.00 €
1 | Polyswitch MINISMDC110F/24 1812 |  |  | Farnell | 1345925 |  |  |  | 0.00 €
1 | Res 47m 1206 |  |  | Farnell | 1634317 |  |  |  | 0.00 €
5 | Res 100 0603 |  |  | Farnell | 1469752 |  |  |  | 0.00 €
1 | Res 100k 0603 |  |  | Farnell | 1469649 |  |  |  | 0.00 €
1 | Res 2,7k 0603 |  |  | Farnell | 9238530 |  |  |  | 0.00 €
2 | Res 3.3k 1206 |  |  | Farnell | 1469793 |  |  |  | 0.00 €
2 | Res 10k 0603 |  |  | Farnell | 1469749 |  |  |  | 0.00 €
1 | LMD18200 TO-220 - 11 leads |  |  | Farnell | 1468979 |  |  |  | 0.00 €
1 | LM7301IM SOIC-8 |  |  | Farnell | 9494170 |  |  |  | 0.00 €
 |  |  |  |  |  |  |  |  | 0.00 €
 |  |  |  |  |  |  |  |  | 0.00 €
 |  |  |  |  |  |  |  |  | 0.00 €
 |  |  |  |  |  |  |  |  | 0.00 €
 |  |  |  |  |  |  |  |  | 0.00 €
 |  |  |  |  |  |  |  |  | 0.00 €
 |  |  |  |  |  |  |  |  | 0.00 €
 |  |  |  |  |  |  |  |  | 0.00 €
 |  |  |  |  |  |  |  |  | 0.00 €
 |  |  |  |  |  |  |  |  | 0.00 €
 |  |  |  |  |  |  |  |  | 0.00 €
 |  |  |  |  |  |  |  |  | 0.00 €
 |  |  |  |  |  |  |  |  | 0.00 €
 |  |  |  |  |  |  |  |  | 0.00 €
 |  |  |  |  |  |  |  |  | 0.00 €
 |  |  |  |  |  |  |  |  | 0.00 €
 |  |  |  |  |  |  |  |  | 0.00 €
 |  |  |  |  |  |  |  |  | 0.00 €
 |  |  |  |  |  |  |  |  | 0.00 €
 |  |  |  |  |  |  |  |  | 0.00 €
 |  |  |  |  |  |  |  |  | 0.00 €
 |  |  |  |  |  |  |  |  | 0.00 €
 |  |  |  |  |  |  |  |  | 0.00 €
 |  |  |  |  |  |  |  |  | 0.00 €
 |  |  |  |  |  |  |  |  | 0.00 €
 |  |  |  |  |  |  |  |  | 0.00 €
 |  |  |  |  |  |  |  |  | 0.00 €
 |  |  |  |  |  |  |  |  | 0.00 €
 |  |  |  |  |  |  |  | Total | 0.00 €

Sheet: Récapitulatif
Nombre de cartes |  |  |  |  | Cablage
3 | 3 | 10 | 2 | 6 | 1
Quantité sur la carte alimentation | Quantité sur la carte connectique CM | Quantité sur la carte support couleur | Quantité sur la carte mère | Quantité sur carte hacheur | Quantité pour cablage | produit | fabricant | ref fabriquant | fournisseur | ref fournisseur | MOQ | Besoin | Prix unitaire HT | Stock de Oufff | Quantité à commander | Quantité commandée | Quantité reçue | Prix total | Remarques | Manquants
 | 16 |  | 40 |  |  | 100n cap 0603 X7R 25V 0603 |  |  | Farnell | 1759122 | 100 | 128 | 0.008 € |  | 100 | 100 | 100 | 0.80 € |  | 0
 | 16 |  | 40 |  |  | 100n cap 0603 X7R 25V 0603 |  |  | RS | 698-3232 | 100 | 128 | 0.013 € |  | 0 |  |  | 0.00 € |  | 0
 | 16 |  | 40 |  |  | 100n cap 0603 X7R 25V 0603 |  |  | Centralp | SCC100NFC12 |  | 128 |  |  | 30 | 30 | 30 | 0.00 € |  | 0
 |  |  |  | 6 |  | 100n cap X7R 100V 1206 |  |  | Centralp | SCC100NHC42 |  | 36 |  |  | 40 | 40 | 40 | 0.00 € |  | 0
 |  |  |  | 6 |  | 100n cap X7R 100V 1206 |  |  | RS | 391-214 | 50 | 36 | 0.060 € |  | 0 |  |  | 0.00 € |  | 0
 |  |  |  | 6 |  | 100n cap X7R 100V 1206 |  |  | Farnell | 1362554 |  | 36 |  |  | 0 |  |  | 0.00 € |  | 0
 | 4 |  | 5 | 1 |  | 100p cap 0603 X7R 25V 0603 |  |  | Farnell | 1817914 | 1 | 28 | 0.011 € |  | 0 |  |  | 0.00 € |  | 0
 | 4 |  | 5 | 1 |  | 100p cap 0603 X7R 25V 0603 |  |  | RS | 191-995 | 20 | 28 | 0.128 € |  | 0 |  |  | 0.00 € |  | 0
 | 4 |  | 5 | 1 |  | 100p cap 0603 X7R 25V 0603 |  |  | Centralp | SCC100PFC11 |  | 28 |  |  | 0 |  | 30 | 0.00 € |  | -30
 | 11 | 11 | 1 |  |  | 10n cap 0603 X7R 25V 0603 |  |  | Farnell | 1759003 | 100 | 145 | 0.008 € |  | 200 | 200 | 200 | 1.60 € |  | 0
 | 11 | 11 | 1 |  |  | 10n cap 0603 X7R 25V 0603 |  |  | Centralp | SCC10NFC12 |  | 145 |  |  | 0 |  | 8 | 0.00 € |  | -8
 | 11 | 11 | 1 |  |  | 10n cap 0603 X7R 25V 0603 |  |  | RS | 698-3254 | 100 | 145 | 0.019 € |  | 0 |  |  | 0.00 € |  | 0
 |  |  |  | 1 |  | 10p Cap X7R 25V 0603 |  |  | Centralp | SCC10PFC11 |  | 6 |  |  | 10 | 10 | 28 | 0.00 € |  | -18
 |  |  |  | 1 |  | 10p Cap X7R 25V 0603 |  |  | Farnell | 1658863 |  | 6 |  |  | 0 |  |  | 0.00 € |  | 0
 |  |  | 3 |  |  | 10u cap Bcase Tantale 20V 6032 |  |  | Farnell | 1457462 | 5 | 6 | 0.410 € |  | 0 |  |  | 0.00 € |  | 0
 |  |  | 3 |  |  | 10u cap Bcase Tantale 20V 6032 |  |  | Centralp | na |  | 6 |  |  | 0 |  |  | 0.00 € |  | 0
 |  |  | 3 |  |  | 10u cap Bcase Tantale 20V 6032 |  |  | RS | 648-0575 | 10 | 6 | 0.330 € |  | 10 | 10 | 10 | 3.30 € |  | 0
 |  |  | 5 |  |  | 10u cap X7R 1206 10V 1206 |  |  | Centralp | SCC10UAC42 |  | 10 |  |  | 10 | 20 | 21 | 0.00 € |  | -1
 |  |  | 5 |  |  | 10u cap X7R 1206 10V 1206 |  |  | Farnell | 1844312 | 1 | 10 | 0.105 € |  | 0 |  |  | 0.00 € |  | 0
 |  |  | 0 |  |  | 15p cap 0603 X7R 25V 0603 |  |  | Farnell | 1414614 |  | 0 |  |  | 0 |  |  | 0.00 € |  | 0
 |  |  |  | 1 |  | 1SMB24AT3G |  |  | Farnell | 1651636 | 1 | 6 | 0.400 € |  | 0 |  |  | 0.00 € |  | 0
 |  |  |  | 1 |  | 1SMB24AT3G |  |  | Centralp | SDSSMBJ24D00 |  | 6 |  |  | 10 | 10 | 10 | 0.00 € |  | 0
 |  |  |  | 4 |  | 220u Cap Alu 3.5x8x11.5 35V |  |  | RS | 684-1977 | 5 | 24 | 0.244 € |  | 25 | 25 | 25 | 6.10 € |  | 0
 |  |  |  | 4 |  | 220u Cap Alu 3.5x8x11.5 35V |  |  | Farnell | 9693688 | 5 | 24 | 0.520 € |  | 0 |  |  | 0.00 € |  | 0
 |  |  | 2 |  |  | Barrette 1 x 6 pas 2,54mm |  |  | Centralp | 6/20 x BB201I10 |  | 4 |  |  | 2 | 2 | 2 | 0.00 € |  | 0
 |  |  | 2 |  |  | Barrette 1 x 6 pas 2,54mm |  |  | Farnell |  |  | 4 |  |  | 0 | 0 |  | 0.00 € |  | 0
 | 2 |  |  |  |  | Barrette 2 x 20 pas 2,54mm |  |  | Centralp | BB201I13 |  | 6 |  |  | 6 | 6 | 6 | 0.00 € |  | 0
6 |  |  |  |  |  | Bornier à vis 2 voies pas de 5,08 mm | Weidmuller | PM 5.08/2/90 3.5 SW | RS | 425-8720 | multiple de 5 | 18 | 0.292 € |  | 20 | 20 | 20 | 5.84 € |  | 0
6 |  |  |  |  |  | Bornier à vis 2 voies pas de 5,08 mm |  |  | Farnell | PM5.08/2/90 | 1 | 18 | 0.350 € |  | 0 |  |  | 0.00 € |  | 0
6 |  |  |  |  |  | Bornier à vis 2 voies pas de 5,08 mm |  |  | Electronique Diffusion | COCMM52 |  | 18 | 0.300 € |  | 0 |  |  | 0.00 € |  | 0
 |  |  |  | 2 |  | Borniers 2 débrochable pas 3,81mm | PHOENIX CONTACT | 1803426 | RS | 2550316219 | 50 | 12 | 0.426 € |  | 0 |  |  | 0.00 € |  | 0
 |  |  |  | 2 |  | Borniers 2 débrochable pas 3,81mm | PHOENIX CONTACT | 1803426 | Farnell | 3913077 |  | 12 | 0.530 € |  | 12 | 12 | 12 | 6.36 € |  | 0
 |  |  |  |  | 2 | Bouton d'AU | apem | A01ES+A0154B | RS | 219-5813 | 1 | 2 | 13.400 € |  | 0 |  |  | 0.00 € |  | 0
 |  |  |  |  | 2 | Bouton d'AU (avec LED 24V) | MULTICOMP | MCADA16E6-R11-B1KR | Farnell | 1606959 | 1 | 2 | 10.640 € |  | 2 | 2 | 2 | 21.28 € |  | 0
 | 5 |  |  |  |  | Buffers Transltateur de niveau TXS0104E | TI | TXS0104EDR | RS | 709-3309 | 5 | 15 | 2.410 € |  | 0 |  |  | 0.00 € |  | 0
 | 5 |  |  |  |  | Buffers Transltateur de niveau TXS0104E | TI | TXS0104EDR | Farnell | 1607892 | 1 | 15 | 1.910 € |  | 5 | 5 | 5 | 9.55 € |  | 0
 | 5 |  |  |  |  | Buffers Transltateur de niveau TXS0104E | TI | TXS0104EDR | Samples |  |  | 15 |  |  | 10 | 6 | 6 | 0.00 € |  | 0
 |  |  | 2 |  |  | BZX84C5V6 |  |  | RS | 545-0652 | 1 | 4 | 0.390 € |  | 0 |  |  | 0.00 € |  | 0
 |  |  | 2 |  |  | BZX84C5V6 |  |  | Electronique Diffusion | DIBZX84C5V6-SMD | 1 | 4 | 0.200 € |  | 0 |  |  | 0.00 € |  | 0
 |  |  | 2 |  |  | BZX84C5V6 |  |  | Farnell | 1651565 | 1 | 4 | 0.200 € |  | 5 | 5 | 5 | 1.00 € |  | 0
 | 1 |  |  |  |  | Condensateur 1 µF chimique (5V min) 1 pas |  |  | Farnell |  |  | 3 |  |  | 0 |  |  | 0.00 € |  | 0
 | 1 |  |  |  |  | Condensateur 1 µF chimique (5V min) 1 pas |  |  | RS | 228-7142 | 5 | 3 | 0.222 € |  | 5 | 5 | 5 | 1.11 € |  | 0
 | 1 |  |  |  |  | Condensateur 1 µF chimique (5V min) 1 pas |  |  | Centralp | na |  | 3 |  |  | 0 |  |  | 0.00 € |  | 0
 |  |  |  |  |  | CONDENSATEUR 330UF 200V | PANASONIC | EETED2D331BA | Farnell | 1198611 |  | 2 | 3.830 € |  | 2 | 2 | 2 | 7.66 € | perso | 0
 | 3 |  |  |  |  | Condensateurs 10 µF chimique (5V min) 1 pas |  |  | Farnell |  |  | 9 |  |  | 0 |  |  | 0.00 € |  | 0
 | 3 |  |  |  |  | Condensateurs 10 µF chimique (5V min) 1 pas |  |  | RS | 547-2933 | 5 | 9 | 0.116 € |  | 10 | 10 | 10 | 1.16 € |  | 0
 | 3 |  |  |  |  | Condensateurs 10 µF chimique (5V min) 1 pas |  |  | Centralp | na |  | 9 |  |  | 0 |  |  | 0.00 € |  | 0
 |  |  | 0 |  |  | Diode 1N4448 0603 |  |  | Farnell | 8150206 |  | 0 |  |  | 0 |  |  | 0.00 € |  | 0
 |  |  | 2 |  |  | Diode MBRS340 SMC |  |  | RS | 545-2080 |  | 4 | 0.370 € |  | 0 |  |  | 0.00 € |  | 0
 |  |  | 2 |  |  | Diode MBRS340 SMC |  |  | Centralp | SDD360D00 |  | 4 |  |  | 5 | 5 | 5 | 0.00 € |  | 0
 |  |  | 2 |  |  | Diode MBRS340 SMC |  |  | Farnell | 9557377 |  | 4 | 0.490 € |  | 0 |  |  | 0.00 € |  | 0
4 |  |  |  |  |  | Diodes 1N4001 trad |  |  | CBE |  |  | 12 |  |  |  | 12 | 12 | 0.00 € |  | 0
 |  |  |  |  | 2 | Embase Jack 2,5 mm 2P | PRO SIGNAL | MJ-165H | Farnell | 1267391 |  | 2 | 0.950 € |  | 0 |  |  | 0.00 € |  | 0
 |  |  |  |  | 2 | Embase Jack 2,5 mm 2P | Lumberg | KLB 13 | Farnell | 1200141 |  | 2 | 1.020 € |  | 0 |  |  | 0.00 € |  | 0
 |  |  |  |  | 2 | Embase Jack 2,5 mm 2P | Lumberg | KLB 13 | RS | 505-1407 |  | 2 | 0.950 € |  | 2 | 2 | 2 | 1.90 € |  | 0
 |  |  |  |  | 2 | Embase Jack 3,5 mm 2P |  |  | Electronique Diffusion | COK322A |  | 2 | 0.500 € |  | 0 |  |  | 0.00 € |  | 0
2 | 6 |  | 1 |  |  | embase MOLEX KK 2 voies | Molex | 22-27-2021 | RS | 483-8461 | multiple de 10 | 26 | 0.317 € | 5 | 0 |  |  | 0.00 € |  | 0
2 | 6 |  | 1 |  |  | embase MOLEX KK 2 voies | Molex | 22-27-2021 | Farnell | 9731148 |  | 26 | 0.440 € | 5 | 0 |  |  | 0.00 € |  | 0
2 | 6 |  | 1 |  |  | embase MOLEX KK 2 voies |  |  | Electronique Diffusion | COKK254M-2 |  | 26 | 0.200 € | 5 | 30 | 30 | 30 | 6.00 € | voir stock | 0
4 | 12 |  |  |  |  | embase MOLEX KK 3 voies | Molex | 22-27-2031 | RS | 483-8477 | multiple de 10 | 48 | 0.554 € | 19 | 0 |  |  | 0.00 € |  | 0
4 | 12 |  |  |  |  | embase MOLEX KK 3 voies | Molex | 22-27-2031 | Farnell | 9731156 |  | 48 | 0.290 € | 19 | 0 |  |  | 0.00 € |  | 0
4 | 12 |  |  |  |  | embase MOLEX KK 3 voies |  |  | Electronique Diffusion | COKK254M-3 |  | 48 | 0.200 € | 19 | 35 | 35 | 0 | 7.00 € | voir stock | 35
 | 3 |  | 4 | 1 |  | embase MOLEX KK 4 voies | Molex | 22-27-2041 | RS | 483-8483 | multiple de 10 | 23 | 0.500 € | 13 | 0 |  |  | 0.00 € |  | 0
 | 3 |  | 4 | 1 |  | embase MOLEX KK 4 voies | Molex | 22-27-2041 | Farnell | 9731164 |  | 23 | 0.510 € | 13 | 0 |  |  | 0.00 € |  | 0
 | 3 |  | 4 | 1 |  | embase MOLEX KK 4 voies |  |  | Electronique Diffusion | COKK254M-4 |  | 23 | 0.200 € | 13 | 15 | 15 | 15 | 3.00 € | voir stock | 0
 | 5 |  |  |  | 5 | embase MOLEX KK 5 voies | Molex | 22-27-2051 | RS | 483-8499 | multiple de 10 | 20 | 0.879 € | 5 | 0 |  |  | 0.00 € |  | 0
 | 5 |  |  |  | 5 | embase MOLEX KK 5 voies | Molex | 22-27-2051 | Farnell | 9731679 |  | 20 | 1.370 € | 5 | 0 |  |  | 0.00 € |  | 0
 | 5 |  |  |  | 5 | embase MOLEX KK 5 voies |  |  | Electronique Diffusion | COKK254M-5 |  | 20 | 0.250 € | 5 | 20 | 20 | 20 | 5.00 € | voir stock | 0
 |  | 1 |  |  |  | embase MOLEX KK 5 voies coudé | Molex |  | RS |  | multiple de 10 | 10 | 0.879 € |  | 0 |  |  | 0.00 € |  | 0
 |  | 1 |  |  |  | embase MOLEX KK 5 voies coudé | Molex |  | Farnell |  |  | 10 | 1.370 € |  | 0 |  |  | 0.00 € |  | 0
 |  | 1 |  |  |  | embase MOLEX KK 5 voies coudé |  |  | Electronique Diffusion | COKK254M-5C |  | 10 | 0.250 € |  | 15 | 15 | 15 | 3.75 € | voir stock | 0
 | 2 |  |  |  |  | Embase pour barette 2x10 pas 2,0 mm |  |  | Centralp | BB221I21 |  | 6 |  |  | 10 | 6 | 6 | 0.00 € |  | 0
2 | 1 |  |  |  |  | Embase pour bornier débrochable 2 voies pas de 5,08 mm | TE Connectivity | 796636-2 | RS | 710-0419 | multiple de 10 | 9 | 0.717 € | 20 | 0 |  |  | 0.00 € |  | 0
2 | 1 |  |  |  |  | Embase pour bornier débrochable 2 voies pas de 5,08 mm | weidmueller | SL 5.08HC/02/180G 3.2SN OR BX | Samples | 1146730000 |  | 9 |  | 20 | 5 | 5 | 10 | 0.00 € |  | -5
2 | 1 |  |  |  |  | Embase pour bornier débrochable 2 voies pas de 5,08 mm |  |  | Electronique Diffusion | COCMM554093 |  | 9 | 0.500 € | 20 | 0 |  |  | 0.00 € |  | 0
 |  |  | 0 |  |  | Embase USB type mini B |  |  | Farnell | 1654060 |  | 0 |  |  | 0 |  |  | 0.00 € |  | 0
 |  |  |  | 2 |  | Fiche à vis 2 voies pas de 3,81 mm | PHOENIX CONTACT | 1826979 | RS | 2509943256 | 50 | 12 | 1.173 € |  | 0 |  |  | 0.00 € |  | 0
 |  |  |  | 2 |  | Fiche à vis 2 voies pas de 3,81 mm | PHOENIX CONTACT | 1826979 | Farnell | 3705080 |  | 12 | 2.340 € |  | 12 | 12 | 12 | 28.08 € |  | 0
2 | 1 |  |  |  |  | Fiche à vis 2 voies pas de 5,08 mm | weidmueller | BLZP 5.08/02/90 SN OR BX | Samples | 1948000000 |  | 9 |  |  | 5 | 5 | 10 | 0.00 € |  | -5
2 | 1 |  |  |  |  | Fiche à vis 2 voies pas de 5,08 mm |  |  | Electronique Diffusion | COCMM550382 |  | 9 | 1.500 € | 6 | 0 |  |  | 0.00 € |  | 0
 |  |  |  |  | 2 | Fiche Jack 2,5 mm 2P | LUMBERG | KLS 10 | Farnell | 1243260 |  | 2 | 0.680 € |  | 0 |  |  | 0.00 € |  | 0
 |  |  |  |  | 2 | Fiche Jack 2,5 mm 2P | LUMBERG | KLS 10 | RS | 505-1277 |  | 2 | 0.620 € |  | 2 | 2 | 2 | 1.24 € |  | 0
 |  |  |  |  | 2 | Fiche Jack 3,5 mm 2P |  |  | Electronique Diffusion | COPG103P |  | 2 | 0.500 € |  | 0 |  |  | 0.00 € |  | 0
 |  |  |  |  | 10 | Fiches Molex KK cablées 2 voies |  |  | Electronique Diffusion | COKK254F-2 |  | 13 | 0.600 € | 7 | 10 | 10 | 10 | 6.00 € |  | 0
 |  |  |  |  | 1 | Fiches Molex KK cablées 3 voies |  |  | Electronique Diffusion | COKK254F-3 |  | 1 | 1.000 € | 15 | 0 |  |  | 0.00 € |  | 0
 |  |  |  |  | 15 | Fiches Molex KK cablées 4 voies |  |  | Electronique Diffusion | COKK254F-4 |  | 15 | 0.750 € | 12 | 5 | 5 | 5 | 3.75 € |  | 0
 |  |  |  |  | 20 | Fiches Molex KK cablées 5 voies |  |  | Electronique Diffusion | COKK254F-5 |  | 20 | 0.850 € |  | 20 | 20 | 0 | 17.00 € |  | 20
7 |  |  |  |  |  | Fusibles ?? A |  |  |  |  |  | 21 |  |  |  |  |  | 0.00 € |  | 0
 |  |  | 2 |  |  | Header 20X2 pas 2,54 mm | FCI | 76342-320LF | Samples | 76342-320LF |  | 4 |  | 2 | 6 | 6 |  | 0.00 € |  | 6
 |  |  | 2 |  |  | Header 20X2 pas 2,54 mm |  |  | Centralp | 2x BB401I20 | max 5 | 4 |  | 2 | 0 |  |  | 0.00 € |  | 0
 |  |  | 2 |  |  | Header 20X2 pas 2,54 mm |  |  | Farnell | 359970 |  | 4 | 5.350 € | 2 | 0 |  |  | 0.00 € |  | 0
 |  |  | 2 |  |  | Inductance 4.7U WE:744043004 | Wurth | 744043004 | RS | 669-0195 |  | 4 | 0.924 € |  | 4 | 5 | 5 | 3.70 € |  | 0
 |  |  | 2 |  |  | Inductance 4.7U WE:744043004 | Wurth | 744043004 | Farnell | 1635846 |  | 4 | 1.300 € |  | 0 |  |  | 0.00 € |  | 0
3 |  |  |  |  |  | Interrupteur à levier vertical SPDT | NKK Nikkai | M2012SA1W40 |  |  |  | 9 |  |  | 0 |  |  | 0.00 € |  | 0
3 |  |  |  |  |  | Interrupteur à levier vertical SPDT | GRAYHILL | 34ASP12B4M7QT | Farnell | 1288418 | USA | 9 | 7.660 € |  | 0 |  |  | 0.00 € |  | 0
3 |  |  |  |  |  | Interrupteur à levier vertical SPDT | C & K COMPONENTS | 7101MD9AV2BE | Farnell | 9575502 |  | 9 | 7.970 € |  | 10 | 7 | 7 | 79.70 € |  | 0
3 |  |  |  |  |  | Interrupteur à levier vertical SPDT | Apem | 5236ww |  |  |  | 9 |  |  | 0 |  |  | 0.00 € |  | 0
1 |  |  |  |  |  | Interrupteur à levier vertical SPDT momentané | KNITTER-SWITCH | STM 106 F – VM |  |  |  | 3 |  |  | 0 |  |  | 0.00 € |  | 0
1 |  |  |  |  |  | Interrupteur à levier vertical SPDT momentané | NKK Nikkai | M2015SA1W40 |  |  |  | 3 |  |  | 0 |  |  | 0.00 € |  | 0
1 |  |  |  |  |  | Interrupteur à levier vertical SPDT momentané | MULTICOMP | 1MS2T2B4M7RE | Farnell | 1550138 |  | 3 | 1.030 € |  | 4 | 4 | 4 | 4.12 € |  | 0
1 |  |  |  |  |  | Interrupteur à levier vertical SPDT momentané | MULTICOMP | 1MS4T2B4M7RE | Farnell | 1550139 |  | 3 | 1.260 € |  | 0 |  |  | 0.00 € |  | 0
1 |  |  |  |  |  | Interrupteur à levier vertical SPDT momentané | C & K COMPONENTS | 7108MD9AV2BE |  |  |  | 3 |  |  | 0 |  |  | 0.00 € |  | 0
1 |  |  |  |  |  | Interrupteur à levier vertical SPDT momentané | Apem | 5232ww |  |  |  | 3 |  |  | 0 |  |  | 0.00 € |  | 0
 |  |  |  |  |  | Lampe Loupe |  |  | RS | 137-452 |  | 2 | 37.340 € |  | 2 | 2 | 2 | 74.68 € | perso | 0
 |  |  | 6 |  |  | LED 0603 |  |  | Centralp | SO191C01 |  | 12 |  |  | 0 |  |  | 0.00 € |  | 0
 |  |  | 6 |  |  | LED 0603 | OSRAM Opto | LYQ976P1S236020R18 | RS | 497-5144 | 5 | 12 | 0.070 € |  | 15 | 15 | 15 | 1.05 € |  | 0
 |  |  | 6 |  |  | LED 0603 | KINGBRIGHT | KPT-1608YC | Farnell | 2099227 | 1 | 12 | 0.080 € |  | 0 |  |  | 0.00 € |  | 0
 |  |  | 6 |  |  | LED 0603 | ROHM | SML-310PTT86L | Farnell | 1685063 | 10 | 12 | 0.160 € |  | 0 |  |  | 0.00 € |  | 0
3 |  |  |  |  |  | LED trad |  |  | CBE |  |  | 9 |  |  | 0 | 9 | 9 | 0.00 € |  | 0
 |  |  | 1 |  |  | LM2830X DBV005 | TI |  | Farnell | 1286715 |  | 2 | 2.630 € |  | 0 |  |  | 0.00 € |  | 0
 |  |  | 1 |  |  | LM2830Z DBV005 | TI |  | Samples |  |  | 2 |  |  | 3 | 3 | 3 | 0.00 € |  | 0
 |  |  | 1 |  |  | LM2830Z DBV005 | TI |  | RS | 651-5659 |  | 2 | 3.600 € |  | 0 |  |  | 0.00 € |  | 0
 |  |  |  | 1 |  | LM7301IM SOIC-8 | TI |  | Samples |  |  | 6 |  | 1 | 6 | 6 | 6 | 0.00 € |  | 0
 |  |  |  | 1 |  | LM7301IM SOIC-8 | TI |  | RS | 534-3790 |  | 6 | 2.800 € | 1 | 0 |  |  | 0.00 € |  | 0
 |  |  |  | 1 |  | LM7301IM SOIC-8 | TI |  | Farnell | 9494170 |  | 6 | 1.550 € | 1 | 0 |  |  | 0.00 € |  | 0
 |  |  |  | 1 |  | LMD18200 TO-220 - 11 leads |  |  | samples |  |  | 6 |  |  | 3 | 6 | 6 | 0.00 € |  | 0
 |  |  |  | 1 |  | LMD18200 TO-220 - 11 leads |  |  | RS | 534-4276 |  | 6 | 17.990 € |  | 0 |  |  | 0.00 € |  | 0
 |  |  |  | 1 |  | LMD18200 TO-220 - 11 leads |  |  | Farnell | 1468979 |  | 6 | 14.850 € |  | 0 |  |  | 0.00 € |  | 0
 |  |  | 1 |  |  | LP38858S-1.2 TO263-5Lead | TI |  | samples |  |  | 2 |  | 2 | 3 | 6 | 6 | 0.00 € |  | 0
 |  |  | 1 |  |  | LP38858S-1.2 TO263-5Lead | TI |  | RS | 517-157 |  | 2 | 2.410 € | 2 | 0 |  |  | 0.00 € |  | 0
 |  |  | 1 |  |  | LP38858S-1.2 TO263-5Lead | TI |  | Farnell | 1333965 |  | 2 | 2.530 € | 2 | 0 |  |  | 0.00 € |  | 0
 |  |  | 1 |  |  | LTC6905 | Linéar Tech | LTC6905CS5#TRMPBF | samples |  |  | 2 |  |  | 2 | 2 | 2 | 0.00 € |  | 0
 |  |  | 1 |  |  | LTC6905 | Linéar Tech | LTC6905CS5#TRMPBF | RS | 506-2211 |  | 2 | 3.860 € |  | 0 |  |  | 0.00 € |  | 0
 |  |  | 1 |  |  | LTC6905 | Linéar Tech | LTC6905CS5#TRMPBF | Farnell | 1663923 |  | 2 | 3.640 € |  | 0 |  |  | 0.00 € |  | 0
 |  |  | 0 |  |  | M24C16-WMN6 SOP8_N |  |  | Farnell | 9882774 |  | 0 |  |  | 0 |  |  | 0.00 € |  | 0
 |  |  | 0 |  |  | MCP2515 SOIC-18N |  |  | Farnell | 1605565 |  | 0 |  |  | 0 |  |  | 0.00 € |  | 0
 |  |  | 0 |  |  | MCP2551 SOIC-8_N |  |  | Farnell | 9758569 |  | 0 |  |  | 0 |  |  | 0.00 € |  | 0
1 |  |  |  |  |  | Module d'alimentation | Traco | TEN20-2411WIN | Farnell | 1284266 |  | 3 | 42.600 € |  | 3 | 3 | 3 | 127.80 € |  | 0
1 |  |  |  |  |  | Module d'alimentation | Traco | TEN20-2411WIN | RS | 438-363 |  | 3 | 45.800 € |  | 0 |  |  | 0.00 € |  | 0
 |  |  | 0 |  |  | PCA9515 751-02_M |  |  | Farnell | 511-002 |  | 0 |  |  | 0 |  |  | 0.00 € |  | 0
 |  |  | 1 |  |  | PIC32MX460F512L-80I/PT TQFP100_N | Microchip |  | RS | 476-545 |  | 2 | 8.110 € | 2 | 0 |  |  | 0.00 € |  | 0
 |  |  | 1 |  |  | PIC32MX460F512L-80I/PT TQFP100_N | Microchip |  | Farnell | 1640233 |  | 2 | 8.920 € | 2 | 0 |  |  | 0.00 € |  | 0
 |  |  |  | 1 |  | Polyswitch MINISMDC110F/24 1812 | TE Connectivity | MINISMDC110F/24 | RS | na |  | 6 |  |  | 0 |  |  | 0.00 € |  | 0
 |  |  |  | 1 |  | Polyswitch MINISMDC110F/24 1812 | TE Connectivity | MINISMDC110F/24 | Farnell | 1345925 | 5 | 6 | 0.710 € |  | 10 | 10 | 10 | 7.10 € |  | 0
7 |  |  |  |  |  | Porte fusible | RS |  | RS | 563-756 | 25 | 21 | 0.330 € |  | 25 | 25 | 25 | 8.25 € | par sachet de 25 | 0
 |  |  | 0 |  |  | Quartz-20.000-18SMDT |  |  | Farnell | 1667005 |  | 0 |  |  | 0 |  |  | 0.00 € |  | 0
 | 1 |  |  |  |  | Régulateur LDO 3,3V TO-220 | TI | LM2937ET-3.3/NOPB | Samples |  |  | 3 |  |  | 6 | 6 | 6 | 0.00 € |  | 0
2 |  |  |  |  |  | Relais 1 voie 24V pas 5,08mm | Panasonic | JW1FSN-DC24V | RS | 399-8382 | 5 | 6 | 2.828 € | 2 | 6 | 5 | 5 | 16.97 € |  | 0
2 |  |  |  |  |  | Relais 1 voie 24V pas 5,08mm | TE Connectivity | RT314024 | Farnell | 1629045 |  | 6 | 3.010 € | 2 | 0 |  |  | 0.00 € |  | 0
2 |  |  |  |  |  | Relais 1 voie 24V pas 5,08mm | TE Connectivity | RT314024 | RS | 189-4109 |  | 6 | 2.920 € | 2 | 0 |  |  | 0.00 € |  | 0
2 |  |  |  |  |  | Relais 1 voie 24V pas 5,08mm | Finder | 40.51 | RS | 382-9731 |  | 6 | 3.160 € | 2 | 0 |  |  | 0.00 € |  | 0
2 |  |  |  |  |  | Relais 1 voie 24V pas 5,08mm |  |  | Electronique Diffusion | RL40312416A |  | 6 | 4.600 € | 2 | 0 |  |  | 0.00 € |  | 0
2 |  |  |  |  |  | Relais 2 voies NC-NF 24V | Panasonic | JW2SN-DC24V | RS | 399-8411 | 5 | 6 | 2.780 € |  | 6 | 10 | 10 | 16.68 € |  | 0
2 |  |  |  |  |  | Relais 2 voies NC-NF 24V | Panasonic | JW2SN-DC24V | Farnell | 1462180 |  | 6 | 5.750 € |  | 0 |  |  | 0.00 € |  | 0
2 |  |  |  |  |  | Relais 2 voies NC-NF 24V |  |  | Electronique Diffusion | RL405224 |  | 6 | 2.200 € |  | 0 |  |  | 0.00 € |  | 0
 | 2 |  | 2 |  |  | Res 0 100mW 0603 |  |  | Farnell | 1469739 |  | 10 |  |  | 0 |  |  | 0.00 € |  | 0
 | 2 |  | 2 |  |  | Res 0 100mW 0603 |  |  | Centralp | SRC00RC02 |  | 10 |  |  | 10 | 10 | 17 | 0.00 € |  | -7
 |  |  |  |  |  | Res 0.47 100mW 0603 (pour remplacer 0.5) |  |  | Centralp | SRC0R47C91 |  | 0 |  |  |  |  |  | 0.00 € |  | 0
 |  |  | 1 |  |  | Res 0.5 100mW 0603 |  |  | Farnell | 1506135 | 10 | 2 | 0.059 € |  | 10 | 10 | 10 | 0.59 € |  | 0
 | 13 |  | 5 |  |  | Res 10 100mW 0603 |  |  | Farnell | 1469751 | 50 | 49 | 0.022 € |  | 0 |  |  | 0.00 € |  | 0
 | 13 |  | 5 |  |  | Res 10 100mW 0603 |  |  | RS | 740-8874 | 50 | 49 | 0.008 € |  | 50 | 50 | 50 | 0.40 € |  | 0
 | 13 |  | 5 |  |  | Res 10 100mW 0603 |  |  | Centralp | SRC10RC91 |  | 49 |  |  | 0 |  |  | 0.00 € |  | 0
 |  |  |  | 5 |  | Res 100 0603 |  |  | Centralp | SRC100RC91 |  | 30 |  |  | 35 | 35 | 35 | 0.00 € |  | 0
 |  |  |  | 5 |  | Res 100 0603 |  |  | Farnell | 1469752 |  | 30 | 0.022 € |  | 0 |  |  | 0.00 € |  | 0
 |  |  |  | 1 |  | Res 100k 0603 |  |  | Centralp | SRC100KC91 |  | 6 |  |  | 10 | 9 | 9 | 0.00 € |  | 0
 |  |  |  | 1 |  | Res 100k 0603 |  |  | Farnell | 1469649 |  | 6 |  |  | 0 |  |  | 0.00 € |  | 0
 | 35 |  | 30 | 2 |  | Res 10k 100mW 0603 |  |  | Farnell | 1469749 | 50 | 177 | 0.011 € |  | 0 |  |  | 0.00 € |  | 0
 | 35 |  | 30 | 2 |  | Res 10k 100mW 0603 |  |  | RS | 377-975 | 200 | 177 | 0.008 € |  | 200 | 200 | 200 | 1.60 € |  | 0
 | 35 |  | 30 | 2 |  | Res 10k 100mW 0603 |  |  | Centralp | SRC10KC91 |  | 177 |  |  | 0 |  | 21 | 0.00 € |  | -21
 |  |  |  | 1 |  | Res 2,7k 0603 |  |  | Centralp | SRC2K7C91 |  | 6 |  |  | 10 | 10 | 10 | 0.00 € |  | 0
 |  |  |  | 1 |  | Res 2,7k 0603 |  |  | Farnell | 9238530 | 50 | 6 | 0.022 € |  | 0 |  |  | 0.00 € |  | 0
 |  |  |  | 2 |  | Res 3.3k 1206 |  |  | Centralp | SRC3K3C41 |  | 12 |  |  | 20 | 20 | 20 | 0.00 € |  | 0
 |  |  |  | 2 |  | Res 3.3k 1206 |  |  | Farnell | 1469793 | 50 | 12 | 0.022 € |  | 0 |  |  | 0.00 € |  | 0
 |  |  | 1 |  |  | Res 33k 100mW 0603 |  |  | RS | 377-953 | 200 | 2 | 0.008 € |  | 0 |  |  | 0.00 € |  | 0
 |  |  | 1 |  |  | Res 33k 100mW 0603 |  |  | RS | 740-8940 | 50 | 2 | 0.009 € |  | 50 | 50 | 50 | 0.45 € |  | 0
 |  |  | 1 |  |  | Res 33k 100mW 0603 |  |  | Farnell | 2059641RL | 50 | 2 | 0.011 € |  | 0 |  |  | 0.00 € |  | 0
 |  |  | 1 |  |  | Res 33k 100mW 0603 |  |  | Farnell | 1469801 | 50 | 2 | 0.022 € |  | 0 |  |  | 0.00 € |  | 0
 |  |  | 1 |  |  | Res 45k 100mW 0603 |  |  | RS | 708-6622 | 5 | 2 | 0.328 € |  | 0 |  |  | 0.00 € |  | 0
 |  |  | 1 |  |  | Res 45k 100mW 0603 |  |  | Farnell | 2138467 | 50 | 2 | 0.005 € |  | 50 | 50 | 50 | 0.25 € |  | 0
 |  |  | 1 |  |  | Res 45k 100mW 0603 |  |  | Farnell | 1170952 | 50 | 2 | 0.010 € |  | 0 |  |  | 0.00 € |  | 0
 |  |  |  | 1 |  | Res 47m 1206 |  |  | Centralp | SRC47RC41 |  | 6 |  |  | 10 | 10 | 10 | 0.00 € |  | 0
 |  |  |  | 1 |  | Res 47m 1206 |  |  | Farnell | 1634317 | 10 | 6 | 0.390 € |  | 0 |  |  | 0.00 € |  | 0
 |  |  | 1 |  |  | Res 560k 250mW 1206 |  |  | Centralp | SRC560KC40 |  | 2 |  |  | 5 | 5 | 5 | 0.00 € |  | 0
 |  |  | 1 |  |  | Res 560k 250mW 1206 |  |  | Farnell |  |  | 2 |  |  | 0 |  |  | 0.00 € |  | 0
 |  |  | 6 |  |  | Res 680 250mW 0603 |  |  | RS | 213-2244 | 50 | 12 | 0.009 € |  | 50 | 50 | 50 | 0.45 € |  | 0
 |  |  | 6 |  |  | Res 680 250mW 0603 |  |  | Farnell | 9332286 | 50 | 12 | 0.010 € |  | 0 |  |  | 0.00 € |  | 0
 | 3 |  |  |  |  | Résistance 1 kOhm 0603 |  |  | Centralp | SRC1KC91 |  | 9 |  |  | 20 | 20 | 20 | 0.00 € |  | 0
1 |  |  |  |  |  | Résistance trad 280 Ohm |  |  | Centralp | RC287RA41 |  | 3 |  |  | 10 | 10 | 9 | 0.00 € |  | 1
1 |  |  |  |  |  | Résistance trad 4 kOhm |  |  | Centralp | RC4K02A41 |  | 3 |  |  | 10 | 10 | 10 | 0.00 € |  | 0
2 |  |  |  |  |  | Résistance trad 8 kOhm |  |  | Centralp | RC8K06A41 |  | 6 |  |  | 10 | 10 | 10 | 0.00 € |  | 0
 |  |  | 0 |  |  | SD CARD |  |  | Farnell | 1145893 |  | 0 |  |  | 0 |  |  | 0.00 € |  | 0
 |  |  |  | 2 |  | Self Wurth 7445101 |  |  | RS | 415-3215 | 5 | 12 | 1.950 € |  | 15 | 15 | 5 | 29.25 € |  | 10
 |  |  |  | 2 |  | Self Wurth 7445101 |  |  | Farnell | 1636057 | 10 | 12 | 1.940 € |  | 0 |  |  | 0.00 € |  | 0
 |  |  |  | 1 |  | Self Wurth 74477020 |  |  | RS | 617-1596 |  | 6 | 2.250 € |  | 6 | 6 | 6 | 13.50 € |  | 0
 |  |  |  | 1 |  | Self Wurth 74477020 |  |  | Farnell | 1635930 |  | 6 | 2.840 € |  | 0 |  |  | 0.00 € |  | 0
 |  |  | 1 |  |  | SN74LVC244ADW DW020_N |  |  | Centralp | na |  | 2 |  | 1 |  |  |  | 0.00 € |  | 0
 |  |  | 1 |  |  | SN74LVC244ADW DW020_N |  |  | RS | 663-2861 | 5 | 2 | 0.204 € | 1 | 0 |  |  | 0.00 € |  | 0
 |  |  | 1 |  |  | SN74LVC244ADW DW020_N | TI |  | Farnell | 1102982 |  | 2 | 0.350 € | 1 | 2 | 2 | 2 | 0.70 € |  | 0
 |  |  | 4 |  |  | SW-PB | ALPS | SKQGABE010 | RS | 758-2063 | 10 | 8 | 0.254 € |  | 10 | 10 | 10 | 2.54 € |  | 0
 |  |  | 4 |  |  | SW-PB | ALPS | SKQGABE010 | Farnell | 1656433 |  | 8 | 0.600 € |  | 0 |  |  | 0.00 € |  | 0
 |  |  | 0 |  |  | USBLC6-2 SOT23-6 |  |  | Farnell | 1269406RL |  | 0 |  |  | 0 |  |  | 0.00 € |  | 0
 |  |  | 1 |  |  | XC3S50AN-4TQG144C TQG144_N | Xilinx |  | RS | 697-2879 |  | 2 | 11.200 € | 2 | 0 |  |  | 0.00 € |  | 0
 |  |  | 1 |  |  | XC3S50AN-4TQG144C TQG144_N | Xilinx |  | Farnell | 1605840 | 1 | 2 | 17.970 € | 2 | 0 |  |  | 0.00 € |  | 0
 |  |  |  |  |  |  |  |  |  |  |  |  |  |  |  |  |  | 0.00 € |  | 0

Sheet: Commande Farnell
fournisseur | ref fournisseur | MOQ | Besoin | Prix unitaire HT | Stock de Oufff | Quantité à commander | Prix | Copier / coller
Farnell | 1759122 | 100 | 128 | 0.008 € |  | 100 | 0.800 € | 1759122 ,100
Farnell | 1759003 | 100 | 145 | 0.008 € |  | 200 | 1.600 € | 1759003 ,200
Farnell | 3913077 |  | 12 | 0.530 € |  | 12 | 6.360 € | 3913077,12
Farnell | 1606959 | 1 | 2 | 10.640 € |  | 2 | 21.280 € | 1606959,2
Farnell | 1607892 | 1 | 15 | 1.910 € |  | 5 | 9.550 € | 1607892,5
Farnell | 1651565 | 1 | 4 | 0.200 € |  | 5 | 1.000 € | 1651565,5
Farnell | 1198611 |  | 2 | 3.830 € |  | 2 | 7.660 € | 1198611 ,2
Farnell | 3705080 |  | 12 | 2.340 € |  | 12 | 28.080 € | 3705080 ,12
Farnell | 9575502 |  | 6 | 7.970 € |  | 7 | 55.790 € | 9575502,7
Farnell | 1550138 |  | 3 | 1.030 € |  | 4 | 4.120 € | 1550138 ,4
Farnell | 1284266 |  | 3 | 42.600 € |  | 3 | 127.800 € | 1284266 ,3
Farnell | 1345925 | 5 | 6 | 0.710 € |  | 10 | 7.100 € | 1345925,10
Farnell | 1506135 | 10 | 2 | 0.059 € |  | 10 | 0.590 € | 1506135,10
Farnell | 2138467 | 50 | 2 | 0.005 € |  | 50 | 0.250 € | 2138467 ,50
Farnell | 1102982 |  | 2 | 0.350 € | 1 | 2 | 0.700 € | 1102982,2
 |  |  |  |  |  | Total HT | 272.680 €

Sheet: Commande RS
fournisseur | ref fournisseur | MOQ | Besoin | Prix unitaire HT | Stock de Oufff | Quantité à commander | Prix | Copier / coller
RS | 648-0575 | 10 | 6 | 0.330 € |  | 10 | 3.300 € | 648-0575 ,10
RS | 228-7142 | 5 | 3 | 0.222 € |  | 5 | 1.110 € | 228-7142 ,5
RS | 505-1407 |  | 2 | 0.950 € |  | 2 | 1.900 € | 505-1407,2
RS | 505-1277 |  | 2 | 0.620 € |  | 2 | 1.240 € | 505-1277,2
RS | 669-0195 |  | 4 | 0.924 € |  | 4 | 3.696 € | 669-0195,4
RS | 137-452 |  | 2 | 37.340 € |  | 2 | 74.680 € | 137-452,2
RS | 497-5144 | 5 | 12 | 0.070 € |  | 15 | 1.050 € | 497-5144,15
RS | 399-8382 | 5 | 6 | 2.828 € | 2 | 5 | 14.140 € | 399-8382,5
RS | 399-8411 | 5 | 6 | 2.780 € |  | 10 | 27.800 € | 399-8411,10
RS | 740-8940 | 50 | 2 | 0.009 € |  | 50 | 0.450 € | 740-8940,50
RS | 213-2244 | 50 | 12 | 0.009 € |  | 50 | 0.450 € | 213-2244,50
RS | 415-3215 | 5 | 12 | 1.950 € |  | 15 | 29.250 € | 415-3215,15
RS | 617-1596 |  | 6 | 2.250 € |  | 6 | 13.500 € | 617-1596,6
 |  |  |  |  |  |  | 0.000 € | ,
 |  |  |  |  |  |  | 0.000 € | ,
 |  |  |  |  |  | Total HT | 172.566 €
fournisseur | ref fournisseur | MOQ | Besoin | Prix unitaire HT | Stock de Oufff | Quantité à commander | Prix | Copier / coller
 | 684-1977 | 5 | 24 | 0.244 € |  | 25 | 6.100 € | 684-1977 ,25
 | 425-8720 | multiple de 5 | 18 | 0.292 € |  | 20 | 5.840 € | 425-8720,20
 | 547-2933 | 5 | 9 | 0.116 € |  | 10 | 1.160 € | 547-2933 ,10
 | 563-756 | 25 | 21 | 0.330 € |  | 25 | 8.250 € | 563-756,25
 | 740-8874 | 50 | 49 | 0.008 € |  | 50 | 0.400 € | 740-8874 ,50
 | 377-975 | 200 | 177 | 0.008 € |  | 200 | 1.600 € | 377-975,200
 | 758-2063 | 10 | 8 | 0.254 € |  | 10 | 2.540 € | 758-2063,10
 |  |  |  |  |  |  | 25.890 €

Sheet: Commande ED
produit | référence | Prix unitaire HT | Quantité
embase MOLEX KK 2 voies | COKK254M-2 | 0.200 € | 30
embase MOLEX KK 3 voies | COKK254M-3 | 0.200 € | 35
embase MOLEX KK 4 voies | COKK254M-4 | 0.200 € | 15
embase MOLEX KK 5 voies | COKK254M-5 | 0.250 € | 20
embase MOLEX KK 5 voies coudé | COKK254M-5C | 0.250 € | 15
Fiches Molex KK cablées 2 voies | COKK254F-2 | 0.600 € | 10
Fiches Molex KK cablées 4 voies | COKK254F-4 | 0.750 € | 5
Fiches Molex KK cablées 5 voies | COKK254F-5 | 0.850 € | 20
