massinissalounis/oufffteam/Elec/2011/Balises IR/schematic/Tx_BOM.xlsx

Association Oufffteam |  |  |  |  | BOM - Balise Tx
3 Place Carnot |  |  |  |  | Date: 30/08/09
26100 Romans sur Isère |  |  |  |  | Rev. B
oufffteam@gmail.com
Comment | Pattern | Quantity | Components | Ref farnell | PU (HT) | Minimum de commande | Prix (€ - HT)
100n cap 0603 X7R 25V | 0603 | 26 | C102, C103, C104, C105, C106, C107, C302, C307, C401, C402, C403, C404, C405, C406, C407, C408, C409, C410, C411, C412, C413, C414, C415, C416, C418, C420 | 1759037 | 0.009 | 100 | 0.9
10u cap 0805 X7R 10V | 0805 | 9 | C101, C301, C304, C309, C310, C311, C312, C417, C419 | 1828828 | 0.51 | 10 | 5.1
100p cap 0603 X7R 50V | 0603 | 1 | C306 | 1414603 | 0.022 | 10 | 0.22
10n cap 0603 X7R 25V | 0603 | 1 | C313 | 1759022 | 0.008 | 100 | 0.8
1u cap 0603 X7R 16V | 0603 | 1 | C303 | 1458900 | 0.11 | 10 | 1.1
10p cap 0603 NPO 50V | 0603 | 1 | C308 | 1414601 | 0.027 | 10 | 0.27
22u cap 1206 X5R 10V | 1206 | 3 | C314, C315, C316 | 1759435 | 0.103 | 10 | 1.03
94SA107X0016EBP | N/A | 1 | C317 | 1692368 | 1.93 | 1 | 1.93
LED CMS | 0603 | 4 | D101, D102,D303,D305 | 1685063 | 0.36 | 1 | 1.44
BZX84C5V6LT1 | 318-07 | 1 | D101 | 1617774 | 0.047 | 5 | 0.235
10MQ040 | SMA | 1 | D301 | 8647801 | 0.42 | 1 | 0.42
30BQ040 | SMC | 2 | D302, D304 | 8647879 | 0.88 | 1 | 1.76
TSAL5300 | N/A | 32 | D401, D402, D403, D404, D405, D406, D407, D408, D409, D410, D411, D412, D413, D414, D415, D416, D417, D418, D419, D420, D421, D422, D423, D424, D425, D426, D427, D428, D429, D430, D431, D432 | 1328298 | 0.25 | 5 | 8
B82422H1223K | 1210 | 2 | L301, L302 | 1299976 | 0.82 | 10 | 8.2
B82477P4103M000 | N/A | 1 | L303 | 1644642 | 1.82 | 1 | 1.82
Connecteurs 2pins | Header 2 | 1 | LED_VISION |  |  |  | 0
Polyswitch MINISMDC110F/24 | 1812 | 1 | P301 | 1345925 | 0.65 | 5 | 3.25
Connecteurs 6pins | Header 6 | 1 | PIC_IN_SITU | 1022255 | 0.28 | 10 | 2.8
IRF7604 | Micro8 | 2 | Q301, Q302 | 9103414 | 0.77 | 1 | 1.54
Res 680 100mW | 0603 | 4 | R101, R102, R314, R315 | 1469834 | 0.019 | 50 | 0.95
Res 10k 100mW | 0603 | 2 | R103, R313 | 1469749 | 0.01 | 50 | 0.5
Res 6.8k 100mW | 0603 | 1 | R301 | 1469831 | 0.019 | 50 | 0.95
Res 4.7k 100mW | 0603 | 1 | R302 | 1469807 | 0.019 | 50 | 0.95
Res 10 100mW | 0603 | 1 | R303 | 1469751 | 0.019 | 50 | 0.95
Res 22 100mW | 0603 | 1 | R304 | 1469781 | 0.019 | 50 | 0.95
Res 560k 100mW | 0603 | 2 | R305, R308 | 9238816 | 0.021 | 50 | 1.05
Res 680k 100mW | 0603 | 1 | R306 | 9331476 | 0.033 | 50 | 1.65
Res 75k 100mW | 0603 | 1 | R307 | 9331522 | 0.033 | 50 | 1.65
Res 100k 100mW | 0603 | 3 | R309,R310,R311 | 1469649 | 0.019 | 50 | 0.95
Res 33k 100mW | 0603 | 1 | R312 | 1469801 | 0.019 | 50 | 0.95
Res 3k 100mW | 0603 | 2 | R401, R402 | 1469790 | 0.019 | 50 | 0.95
PIC24HJ128GP504-E/PT | TQFP44 | 1 | U101 | 1576883 | 5.85 | 1 | 5.85
SMM-110-02-S-S | Xbee/2 | 2 | U104 | 1668127 | 2.42 | 1 | 4.84
XB24-ACI-001 | XBee | 1 | U104 | 1337913 | 24.9 | 1 | 24.9
MC74VHC1G32DFT1 | SOT23-5 | 2 | U103, U104 | 1607778 | 0.38 | 1 | 0.76
LM3401 | MSOP8 | 2 | U301 | 1675293 | 2.34 | 1 | 4.68
TPS62000 | MS10 | 1 | U302 | 1103058 | 2.94 | 1 | 2.94
LM3475 | SOT23-5 | 1 | U303 | 1008244 | 1.5 | 1 | 1.5
CAT4016 | TSSOP24 | 2 | U401, U402 | 1656116 | 1.42 | 1 | 2.84
 |  |  |  |  |  | Total: | 101.575
