massinissalounis/oufffteam/Elec/2011/Balises IR/schematic/Rx_BOM.xlsx

Association Oufffteam |  |  |  |  | BOM - Balise Rx
3 Place Carnot |  |  |  |  | Date: 30/08/09
26100 Romans sur Isère |  |  |  |  | Rev. B
oufffteam@gmail.com
Comment | Pattern | Quantity | Components | Ref farnell | PU (HT) | Minimum de commande | Prix (€ - HT)
TSOP2238 | TSOP22xx | 16 | 501, U502, U503, U504, U505, U506, U507, U508, U509, U510, U511, U512, U513, U514, U515, U516 | 4913073 | 1.27 | 1 | 20.32
TSOP2256 | TSOP22xx | 16 | U517, U518, U519, U520, U521, U522, U523, U524, U525, U526, U527, U528, U529, U530, U531, U532 | 1612504 | 1.16 | 1 | 18.56
100n cap 0603 X7R 25V | 0603 | 15 | C101, C103, C104, C105,C106,C107,C109, C201, C202, C203, C204, C205, C206, C302, C307 | 1759037 | 0.009 | 100 | 0.9
10u cap 0805 X7R 10V | 0805 | 6 | C102, C301, C304, C305, C309, C310 | 1828828 | 0.51 | 10 | 5.1
100p cap 0603 X7R 50V | 0603 | 1 | C108,C306 | 1414603 | 0.022 | 10 | 0.22
10n cap 0603 X7R 25V | 0603 | 8 | C207, C208, C209, C210, C211, C212, C213, C214 | 1759022 | 0.008 | 100 | 0.8
1u cap 0603 X7R 16V | 0603 | 1 | C303 | 1458900 | 0.11 | 10 | 1.1
10p cap 0603 NPO 50V | 0603 | 1 | C308 | 1414601 | 0.027 | 10 | 0.27
4.7u cap 0603 X5R 10V | 0603 | 32 | C501, C502, C503, C504, C505, C506, C507, C508, C509, C510, C511, C512, C513, C514, C515, C516, C517, C518, C519, C520, C521, C522, C523, C524, C525, C526, C527, C528, C529, C530, C531, C532 | 1572625 | 0.19 | 10 | 6.08
Connecteurs Molex 4 | Header 4 | 2 | CAN_BUS, I2C | 9731164 | 0.64 | 10 | 6.4
BZX84C5V6LT1 | 318-07 | 1 | D101 | 1617774 | 0.047 | 5 | 0.235
LED CMS | 0603 | 4 | D102, D103, D201, D202 | 1685063 | 0.36 | 1 | 1.44
10MQ060 | D-64 | 1 | D301 | 8647801 | 0.42 | 1 | 0.42
Connecteurs 6pins | Header 6 | 2 | FPGA_IN_SITU, PIC_IN_SITU | 1022255 | 0.28 | 10 | 2.8
B82422H1223K | 1210 | 2 | L301, L302 | 1299976 | 0.82 | 10 | 8.2
Connecteurs 2pins | Header 2 | 1 | LED_VISION |  |  |  | 0
IRF7604 | Micro8 | 1 | Q301 | 9103414 | 0.77 | 1 | 0.77
Res 10 100mW | 0603 | 1 | R303 | 1469751 | 0.019 | 50 | 0.95
Res 22 100mW | 0603 | 1 | R304 | 1469781 | 0.019 | 50 | 0.95
Res 680 100mW | 0603 | 4 | R107, R108, R209, R210 | 1469834 | 0.019 | 50 | 0.95
Res 4.7k 100mW | 0603 | 1 | R302 | 1469807 | 0.019 | 50 | 0.95
Res 6.8k 100mW | 0603 | 1 | R301 | 1469831 | 0.019 | 50 | 0.95
Res 10k 100mW | 0603 | 13 | R101, R102, R103, R104,R105,R106,R201, R202, R203, R204, R206, R207, R208 | 1469749 | 0.01 | 50 | 0.5
Res 33k 100mW | 0603 | 1 | R205 | 1469801 | 0.019 | 50 | 0.95
Res 75k 100mW | 0603 | 1 | R307 | 9331522 | 0.033 | 50 | 1.65
Res 100k 100mW | 0603 | 1 | R309 | 1469649 | 0.019 | 50 | 0.95
Res 560k 100mW | 0603 | 2 | R305, R308 | 9238816 | 0.021 | 50 | 1.05
Res 680k 100mW | 0603 | 1 | R306 | 9331476 | 0.033 | 50 | 1.65
PIC24HJ128GP504-E/PT | TQFP44 | 1 | U101 | 1576883 | 5.85 | 1 | 5.85
MCP2551 | SOIC8 | 1 | U102 | 9758569 | 1.13 | 1 | 1.13
PCA9515 | TSSOP8 | 1 | U103 | 1755119 | 2.86 | 1 | 2.86
SMM-110-02-S-S | Xbee/2 | 2 | U104 | 1668127 | 2.42 | 1 | 4.84
XB24-ACI-001 | XBee | 1 | U104 | 1337913 | 24.9 | 1 | 24.9
XC2C128-6VQ100C | VQ100 | 1 | U201 | 1605829 | 6.26 | 1 | 6.26
LTC6905 | SOT23-5 | 1 | U202 | 1432108 | 4.48 | 1 | 4.48
SN74LVC244DB | TSSOP20 | 4 | U203, U204, U205, U206 | 1236352 | 0.66 | 1 | 2.64
LM3401 | MSOP8 | 1 | U301 | 1675293 | 2.34 | 1 | 2.34
TPS62000 | MS10 | 1 | U302 | 1103058 | 2.94 | 1 | 2.94
TLV70018 | SOT23-5 | 1 | U303 | 1778227 | 0.53 | 1 | 0.53
 |  |  |  |  |  | Total: | 143.885
