massinissalounis/oufffteam/Elec/2010/Hacheurs/Doc/Hacheurs_BOM.xlsx

Association Oufffteam |  |  |  |  | BOM - Carte Hacheurs Moteurs LMD18200
3 Place Carnot |  |  |  |  | Date: 21/05/09
26100 Romans sur Isère |  |  |  |  | Rev. A
oufffteam@gmail.com
Comment | Pattern | Quantity | Components | Ref farnell | PU (HT) | Minimum de commande | Prix (€ - HT)
Cap 100n X7R 1206 100V | 1206 | 6 | C1, C2, C3, C8, C9, C10 | 1362554 | 0.12 | 10 | 1.2 | x
Cap 220u Alu 3.5x8x11.5 35V | 3,5x8x11,5 | 4 | C4, C5, C6, C7 | 9693688 | 0.27 | 5 | 1.35 | x
Cap 10p X7R 0603 25V | 0603 | 1 | C15 | 1658863 | 0.126 | 10 | 1.26 | x
Cap 100p X7R 0603 25V | 0603 | 1 | C16 | 1414603 | 0.021 | 10 | 0.21 | x
MOLEX 22-27-2041 | HDR1X4 | 1 | CTRL | 1675766 | 0.33 | 10 | 3.3 | x
1SMB24AT3G | SMB | 1 | D1 | 1651636 | 0.38 | 1 | 0.38 | x
Wurth 7445101 | 7445101 | 2 | L1, L2 | 1636057 | 1.9 | 1 | 3.8 | x
Wurth 74477020 | 74477020 | 1 | L3 | 1635930 | 2.2 | 1 | 2.2 | x
Borniers | HDR1X2 | 2 | MOTOR1, POWER_IN | 3913077 | 0.5 | 1 | 1 | x
Polyswitch MINISMDC110F/24 | 1812 | 1 | P1 | 1345925 | 0.66 | 5 | 3.3 | x
Masse mécanique | PIN1 | 1 | PLUG |  |  |  |  | _
Res 47m 1206 | 1206 | 1 | R1 | 1634317 | 0.35 | 10 | 3.5 | x
Res 100 0603 | 0603 | 5 | R6, R9, R10, R19, R20 | 1469752 | 0.03 | 50 | 1.5 | x
Res 100k 0603 | 0603 | 1 | R11 | 1469649 | 0.03 | 50 | 1.5 | x
Res 2,7k 0603 | 0603 | 1 | R12 | 9238530 | 0.02 | 50 | 1 | x
Res 3.3k 1206 | 1206 | 2 | R13, R14 | 1469793 | 0.03 | 50 | 1.5 | x
Res 10k 0603 | 0603 | 2 | R15, R16 | 1469749 | 0.018 | 50 | 0.9 | x
LMD18200 | TO-220 - 11 leads | 1 | U1 | 1468979 | 18.17 | 1 | 18.17 | _
LM7301IM | SOIC-8 | 1 | U3 | 9494170 | 2.12 | 1 | 2.12 | x
 |  |  |  |  |  | Total: | 48.19
