massinissalounis/oufffteam/Elec/2011/Balises IR/cpld/Rx_cpld/RX_cpld_pad.csv

Release 8.1i - Fit O.76xd
Copyright(c) 1995-2003 Xilinx Inc. All rights reserved
1- 8-2012 11:46AM
NOTE: This file is designed to be imported into a spreadsheet program
such as Microsoft Excel for viewing | printing and sorting. The comma ' | '
character is used as the data field separator.
This file is also designed to support parsing.
Input file: RX_cpld.ngd
output file: RX_cpld_pad.csv
Part type: xc2c128
Speed grade: -6
Package: vq100
Pinout by Pin Number:
----- | ----- | ----- | ----- | ----- | ----- | ----- | ----- | ----- | -----
Pin Number | Signal Name | Pin Usage | Pin Name | Direction | IO Standard | IO Bank Number | {blank} | Slew Rate | Termination | {blank} | Voltage | Constraint
P1 | TSOP2<1> | I | I/O/GTS2 | INPUT | LVCMOS18 | 2 |  | FAST
P2 | TSOP1<1> | I | I/O/GTS3 | INPUT | LVCMOS18 | 2 |  | FAST
P3 | TSOP2<0> | I | I/O/GTS0 | INPUT | LVCMOS18 | 2 |  | FAST
P4 | KPR |  | I/O/GTS1 |  |  | 2
P5 |  | VCCAUX | VAUX
P6 | TSOP1<0> | I | I/O | INPUT | LVCMOS18 | 2 |  | FAST
P7 | TSOP2<3> | I | I/O | INPUT | LVCMOS18 | 2 |  | FAST
P8 | TSOP1<3> | I | I/O | INPUT | LVCMOS18 | 2 |  | FAST
P9 | TSOP2<2> | I | I/O | INPUT | LVCMOS18 | 2 |  | FAST
P10 | KPR |  | I/O |  |  | 2
P11 | TSOP1<2> | I | I/O | INPUT | LVCMOS18 | 2 |  | FAST
P12 | KPR |  | I/O |  |  | 2
P13 | ADR<0> | I | I/O | INPUT | LVCMOS18 | 2 |  | FAST
P14 | ADR<1> | I | I/O | INPUT | LVCMOS18 | 1 |  | FAST
P15 | ADR<2> | I | I/O | INPUT | LVCMOS18 | 1 |  | FAST
P16 | ADR<3> | I | I/O | INPUT | LVCMOS18 | 1 |  | FAST
P17 | ADR<4> | I | I/O | INPUT | LVCMOS18 | 1 |  | FAST
P18 | ADR<5> | I | I/O | INPUT | LVCMOS18 | 1 |  | FAST
P19 | KPR |  | I/O |  |  | 1
P20 |  | VCCIO-1.8 | VCCIO |  |  | 1
P21 | GND |  | GND
P22 | KPR |  | I/O/GCK0 |  |  | 1
P23 | ADR<6> | I | I/O/GCK1 | INPUT | LVCMOS18 | 1 |  | FAST
P24 | ADR<7> | I | I/O/CDR | INPUT | LVCMOS18 | 1 |  | FAST
P25 | GND |  | GND
P26 |  | VCC | VCC
P27 | KPR |  | I/O/GCK2 |  |  | 1
P28 | ADR<8> | I | I/O/DGE0 | INPUT | LVCMOS18 | 1 |  | FAST
P29 | PIC_Rx | O | I/O | OUTPUT | LVCMOS18 | 1 |  | FAST
P30 | KPR |  | I/O |  |  | 1
P31 | GND |  | GND
P32 | KPR |  | I/O |  |  | 1
P33 | KPR |  | I/O |  |  | 1
P34 | KPR |  | I/O |  |  | 1
P35 | KPR |  | I/O |  |  | 1
P36 | KPR |  | I/O |  |  | 1
P37 | KPR |  | I/O |  |  | 1
P38 |  | VCCIO-1.8 | VCCIO |  |  | 1
P39 | KPR |  | I/O |  |  | 1
P40 | TSOP2<7> | I | I/O | INPUT | LVCMOS18 | 1 |  | FAST
P41 | TSOP1<7> | I | I/O | INPUT | LVCMOS18 | 1 |  | FAST
P42 | TSOP2<6> | I | I/O | INPUT | LVCMOS18 | 1 |  | FAST
P43 | TSOP1<6> | I | I/O | INPUT | LVCMOS18 | 1 |  | FAST
P44 | KPR |  | I/O |  |  | 1
P45 | TDI |  | TDI
P46 | KPR |  | I/O |  |  | 1
P47 | TMS |  | TMS
P48 | TCK |  | TCK
P49 | TSOP2<5> | I | I/O | INPUT | LVCMOS18 | 1 |  | FAST
P50 | TSOP1<5> | I | I/O | INPUT | LVCMOS18 | 1 |  | FAST
P51 |  | VCCIO-1.8 | VCCIO |  |  | 1
P52 | KPR |  | I/O |  |  | 1
P53 | TSOP2<4> | I | I/O | INPUT | LVCMOS18 | 1 |  | FAST
P54 | TSOP1<4> | I | I/O | INPUT | LVCMOS18 | 1 |  | FAST
P55 | KPR |  | I/O |  |  | 1
P56 | KPR |  | I/O |  |  | 1
P57 |  | VCC | VCC
P58 | KPR |  | I/O |  |  | 1
P59 | KPR |  | I/O |  |  | 1
P60 | KPR |  | I/O |  |  | 1
P61 | KPR |  | I/O |  |  | 1
P62 | GND |  | GND
P63 | KPR |  | I/O |  |  | 1
P64 | KPR |  | I/O |  |  | 1
P65 | KPR |  | I/O |  |  | 2
P66 | TSOP2<11> | I | I/O | INPUT | LVCMOS18 | 2 |  | FAST
P67 | TSOP1<11> | I | I/O | INPUT | LVCMOS18 | 2 |  | FAST
P68 | TSOP2<10> | I | I/O | INPUT | LVCMOS18 | 2 |  | FAST
P69 | GND |  | GND
P70 | TSOP1<10> | I | I/O | INPUT | LVCMOS18 | 2 |  | FAST
P71 | TSOP2<9> | I | I/O | INPUT | LVCMOS18 | 2 |  | FAST
P72 | TSOP1<9> | I | I/O | INPUT | LVCMOS18 | 2 |  | FAST
P73 | TSOP2<8> | I | I/O | INPUT | LVCMOS18 | 2 |  | FAST
P74 | TSOP1<8> | I | I/O | INPUT | LVCMOS18 | 2 |  | FAST
P75 | GND |  | GND
P76 | TSOP2<15> | I | I/O | INPUT | LVCMOS18 | 2 |  | FAST
P77 | TSOP1<15> | I | I/O | INPUT | LVCMOS18 | 2 |  | FAST
P78 | TSOP2<14> | I | I/O | INPUT | LVCMOS18 | 2 |  | FAST
P79 | TSOP1<14> | I | I/O | INPUT | LVCMOS18 | 2 |  | FAST
P80 | TSOP2<13> | I | I/O | INPUT | LVCMOS18 | 2 |  | FAST
P81 | TSOP1<13> | I | I/O | INPUT | LVCMOS18 | 2 |  | FAST
P82 | TSOP2<12> | I | I/O | INPUT | LVCMOS18 | 2 |  | FAST
P83 | TDO |  | TDO
P84 | GND |  | GND
P85 | TSOP1<12> | I | I/O/DGE1 | INPUT | LVCMOS18 | 2 |  | FAST
P86 | KPR |  | I/O |  |  | 2
P87 | KPR |  | I/O |  |  | 2
P88 |  | VCCIO-1.8 | VCCIO |  |  | 2
P89 | KPR |  | I/O |  |  | 2
P90 | KPR |  | I/O |  |  | 2
P91 | KPR |  | I/O |  |  | 2
P92 | KPR |  | I/O |  |  | 2
P93 | LED2 | O | I/O | OUTPUT | LVCMOS18 | 2 |  | FAST
P94 | LED1 | O | I/O | OUTPUT | LVCMOS18 | 2 |  | FAST
P95 | KPR |  | I/O |  |  | 2
P96 | KPR |  | I/O |  |  | 2
P97 | KPR |  | I/O |  |  | 2
P98 |  | VCCIO-1.8 | VCCIO |  |  | 2
P99 | KPR |  | I/O/GSR |  |  | 2
P100 | GND |  | GND
To preserve the pinout above for future design iterations in
Project Navigator simply execute the (Lock Pins) process
located under the (Implement Design) process in a toolbox named
(Optional Implementation Tools) or invoke PIN2UCF from the
command line. The location constraints will be written into your
specified UCF file
