massinissalounis/oufffteam/Elec/2010/Hacheurs/Doc/Devis PCB/Comparatif.xlsx

Association Oufffteam |  |  |  |  | Comparatifs Tarifs PCB - Hacheurs
3 Place Carnot |  |  |  |  | Date: 24/05/09
26100 Romans sur Isère |  |  |  |  | Rev. A
oufffteam@gmail.com
Fournisseur | Epaisseur de cuivre | Epaisseur de carte | Etamage | Verni epargne | Délais (J-O) | E-tests | Quantité | Prix à l'achat (avec frais de port) | Prix unitaire
Wurth | 35 | 1.55 | Lead Free | Oui | 15 | Non | 4 | 70.88 | 17.72
Wurth | 35 | 1.55 | Sn | Oui | 15 | Non | 4 | 76.64 | 19.16
Wurth | 35 | 1.55 | Lead Free | Oui | 15 | Oui | 4 | 88.54 | 22.135
Wurth | 35 | 1.55 | Sn | Oui | 15 | Oui | 4 | 94.3 | 23.575
Wurth | 70 | 1.55 | Lead Free | Oui | 15 | Non | 4 | 73.78 | 18.445
Wurth | 70 | 1.55 | Sn | Oui | 15 | Non | 4 | 79.54 | 19.885
Wurth | 35 | 1.55 | Lead Free | Oui | 15 | Non | 6 | 83.49 | 13.915
Wurth | 35 | 1.55 | Lead Free | Oui | 15 | Non | 10 | 103.41 | 10.341
Wurth | 35 | 1.55 | Lead Free | Oui | 15 | Non | 100 | 290.36 | 2.9036
PCB-Pool | 35 | 1.55 | Lead Free | Non | 8 | Non | 4 | 62.11 | 15.5275
PCB-Pool | 35 | 1.55 | Lead Free | Oui | 8 | Non | 4 | 96.99 | 24.2475
PCB-Pool | 35 | 1.55 | Lead Free | Non | 8 | Non | 6 | 68.02 | 11.33666667
PCB-Pool | 35 | 1.55 | Lead Free | Oui | 8 | Non | 6 | 102.9 | 17.15
PCB-Pool | 35 | 1.55 | Lead Free | Oui | 8 | Non | 10 | 127.78 | 12.778
PCB-Pool | 35 | 1.55 | Lead Free | Oui | 8 | Non | 100 | 325.74 | 3.2574
Eurocircuits | 35 | 1.55 | Lead Free | Non | 30 | Non | 4 | 75.7 | 18.925
Eurocircuits | 17.5 | 1.55 | Lead Free | Non | 30 | Non | 4 | 65.09 | 16.2725
Eurocircuits | 17.5 | 1.55 | Lead Free | Oui | 30 | Non | 4 | 68.02 | 17.005
Eurocircuits | 35 | 1.55 | Lead Free | Oui | 30 | Non | 4 | 79.2 | 19.8
Eurocircuits | 35 | 1.55 | Lead Free | NOn | 15 | Non | 4 | 75.7 | 18.925
