massinissalounis/oufffteam/Elec/2012/Balises Vision/BOM_Farnell.xlsx

Association Oufffteam |  |  |  | Commande Farnell n°2
3 Place Carnot |  |  |  | Date: 30/08/09
26100 Romans sur Isère |  |  |  | Rev. B
oufffteam@gmail.com
Comment | Pattern | Quantity | Ref farnell | PU (HT) | Prix (€ - HT)
TSOP2238 | TSOP22xx | 16 | 4913073 | 1.27 | 20.32
TSOP2256 | TSOP22xx | 16 | 1612504 | 1.16 | 18.56
10u cap 0805 X7R 10V | 0805 | 20 | 1828828 | 0.51 | 10.2
1u cap 0603 X7R 16V | 0603 | 10 | 1458900 | 0.11 | 1.1
4.7u cap 0603 X5R 10V | 0603 | 40 | 1572625 | 0.19 | 7.6
22u cap 1206 X5R 10V | 1206 | 10 | 1759435 | 0.103 | 1.03
94SA107X0016EBP | N/A | 1 | 1692368 | 1.93 | 1.93
30BQ040 | SMC | 2 | 8647879 | 0.88 | 1.76
10MQ040 | SMA | 1 | 8647801 | 0.42 | 0.42
10MQ060 | D-64 | 1 | 8647801 | 0.42 | 0.42
TSAL5300 | N/A | 35 | 1328298 | 0.25 | 8.75
B82422H1223K | 1210 | 10 | 1299976 | 0.82 | 8.2
B82477P4103M000 | N/A | 1 | 1644642 | 1.82 | 1.82
Polyswitch MINISMDC110F/24 | 1812 | 5 | 1345925 | 0.65 | 3.25
IRF7604 | Micro8 | 5 | 9103414 | 0.77 | 3.85
Res 22 100mW | 0603 | 50 | 1469781 | 0.019 | 0.95
Res 680 100mW | 0603 | 50 | 1469834 | 0.019 | 0.95
Res 4.7k 100mW | 0603 | 50 | 1469807 | 0.019 | 0.95
Res 6.8k 100mW | 0603 | 50 | 1469831 | 0.019 | 0.95
Res 33k 100mW | 0603 | 50 | 1469801 | 0.019 | 0.95
Res 75k 100mW | 0603 | 50 | 9331522 | 0.033 | 1.65
Res 3k 100mW | 0603 | 50 | 1469790 | 0.019 | 0.95
MC74VHC1G32DFT1 | SOT23-5 | 2 | 1607778 | 0.38 | 0.76
PIC24HJ128GP504-E/PT | TQFP44 | 2 | 1576883 | 5.85 | 11.7
MCP2551 | SOIC8 | 1 | 9758569 | 1.13 | 1.13
PCA9515 | TSSOP8 | 1 | 1755119 | 2.86 | 2.86
SMM-110-02-S-S | Xbee/2 | 4 | 1668127 | 2.42 | 9.68
XB24-ACI-001 | XBee | 2 | 1337913 | 24.9 | 49.8
XC2C128-6VQ100C | VQ100 | 1 | 1605829 | 6.26 | 6.26
LTC6905 | SOT23-5 | 1 | 1432108 | 4.48 | 4.48
SN74LVC244DB | TSSOP20 | 4 | 1236352 | 0.66 | 2.64
LM3475 | SOT23-5 | 1 | 1008244 | 1.5 | 1.5
LM3401 | MSOP8 | 2 | 1495068 | 2.13 | 4.26
TPS62000 | MS10 | 2 | 1103058 | 2.94 | 5.88
CAT4016 | TSSOP24 | 2 | 1656116 | 1.42 | 2.84
LCWW5AM | LDW5 | 6 | 1603290 | 8.66 | 51.96
TLV70018 | SOT23-5 | 1 |  | 0.53 | 0.53
 |  |  |  |  | 252.84
