massinissalounis/oufffteam/Meca/Table_2012/devis_construction_table.xlsx

Devis Matériaux Table 2012
Description | Prix Unitaire | Nombre | Prix | Commentaires
Bois pour table, bordure, support et Totems |  |  | 77.22 | Découpe comprise, Tout en agglo épaisseur 10
Bois pour lingots, interstices totem & Carte |  |  | 20 | Prix approximatif
Linteau 18x18 pour petites bordures et éléments de jeu | 2.7 | 3 | 8.1
Linteau 22x22 pour éléments de jeu | 3.7 | 2 | 7.4
Plaque polycarbonate | 22 | 2 | 44 | A vérifier
Visserie | 11 | 1 | 11 | Boite de 100
Equerres | 10 | 2 | 20 | Boite de 10
Tube PVC 40 pour palmier | 3.2 | 1 | 3.2 | Longueur 1m
Fixation rapide | 9 | 4 | 36 | Sert à vériouller les éléments de table entre eux
Peinture |  |  |  | Note importante : 0,5L --> 5m² : 13€10 2,5L --> 25m² : 56€90 2 couches sont nécéssaires Les calculs sont réalisés pour les petits pots
Bleu Clair RAL 5012 | 13.1 | 3 | 39.3
Jaune RAL 1023 | 13.1 | 1 | 13.1
Rouge | 13.1 | 1 | 13.1
Violet | 13.1 | 1 | 13.1
Jaune-vert | 13.1 | 1 | 13.1
Marron | 13.1 | 2 | 26.2
Noir | 13.1 | 1 | 13.1
Sous total Peinture |  |  | 131 | Ah ouais quand même !
Autre
Temps de main d'œuvre | 0 |  | 3 | en jours, achat du matériel compris
Total Matériaux Table |  |  | 357.92 | Des économies peuvent être faites sur la peinture
