massinissalounis/oufffteam/Balises/Balises_SICK/Meca/Balise_Principale/Minimotor/minimotor_1624_155.SLDASM

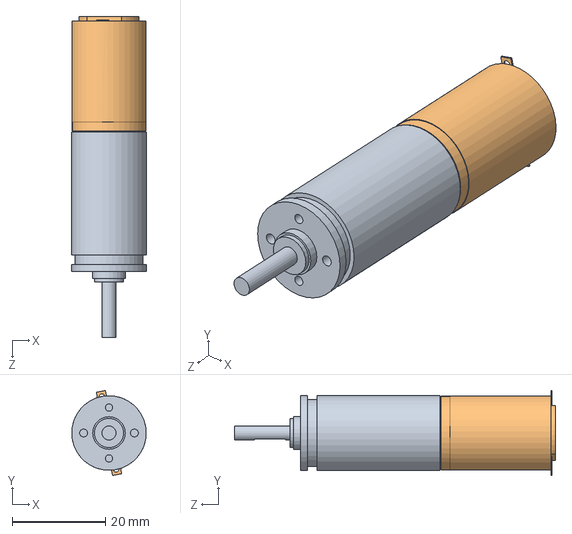
[picture p169: CAD file, 2013-06-09]
Balises/Balises_SICK/Meca/Balise_Principale/Minimotor/minimotor_1624_155.SLDASM
16.0 x 18.2 x 68.9 mm
15_5 3stages
1624S
