massinissalounis/oufffteam/Meca/Assemblage_Robot 2012/Essai_Assemblage_V2.SLDASM

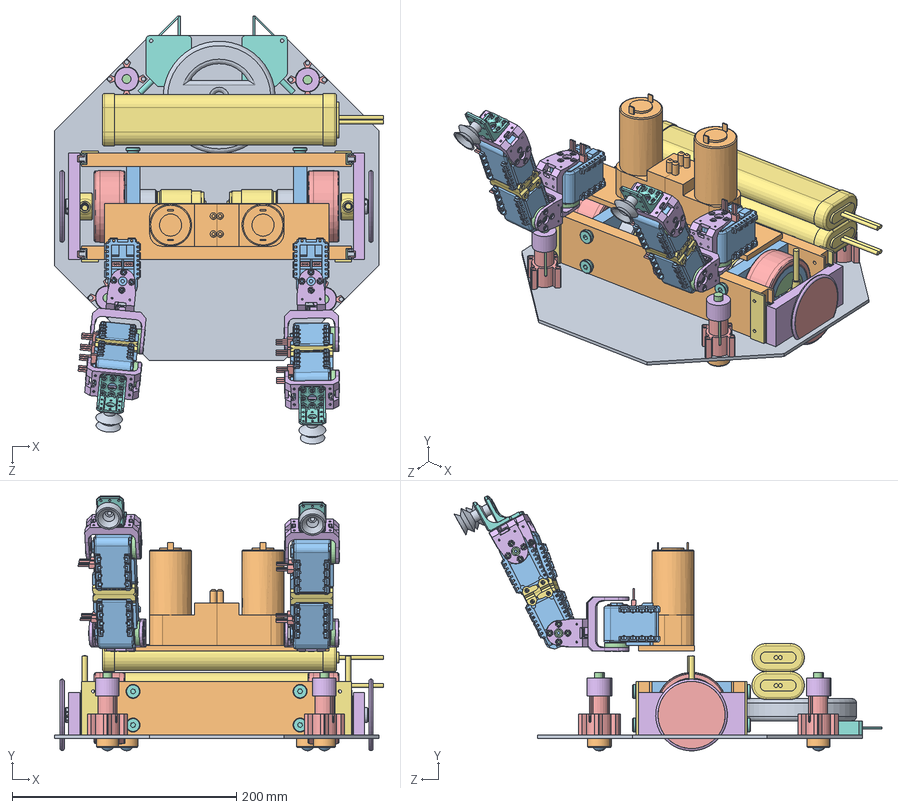
[picture p170: CAD file, 2013-05-17]
Meca/Assemblage_Robot 2012/Essai_Assemblage_V2.SLDASM
293.8 x 227.1 x 381.7 mm
Essai_plaque_base_V2
support glissière x 2
cloche pour V4 x 2
glissière femelle x 4
glissière male x 4
porte codeur x 2
corps_moteur_faulhauber_3042W024C x 2
arbre_moteur_faulhauber_3042W024C x 2
corps_reducteur_faulhaber_30_1 x 2
arbre_reducteur_faulhauber_30_1 x 2
roue modélisme-V4 x 2
bride roue modélisme-V4 x 2
pneu modélisme x 2
vis roue x 4
corps_codeur_2MRH x 2
mandrin_codeur_2MRH x 2
bague_codeur_2MRH x 2
Socket Head Cap Screw_AM x 2
Vis_fendue_tete_bombee_M2_L5 x 6
Bride_membrane x 2
Roue_codeuse_D30 x 2
joint_D64 x 2
contre plaque glissière x 4
vis_centrage x 8
ressort compressé x 4
Roulette D20 x 4
bille D12_5 x 4
tige filetée M8 x 4
alésage porte bille x 4
Ecrou réglage hauteur x 4
batterie_10elements x 2
Banner_PicoDot_PD45 x 2
Lest_R100
Plaque_fixation_test
AX-12_modif x 6
attache_ax-12 x 6
connecteur_AX-12 x 12
F2 x 6
F3 x 4
F9ORG x 2
ventouse_coval_VSA22_M5 x 2
Pompe_Vide_Sparfun_D2028 x 2
