massinissalounis/oufffteam/Meca/Cartes Electronique/Cartes_Assemblées_Entretoises/ensemble_carte_mere_IO_1.SLDASM

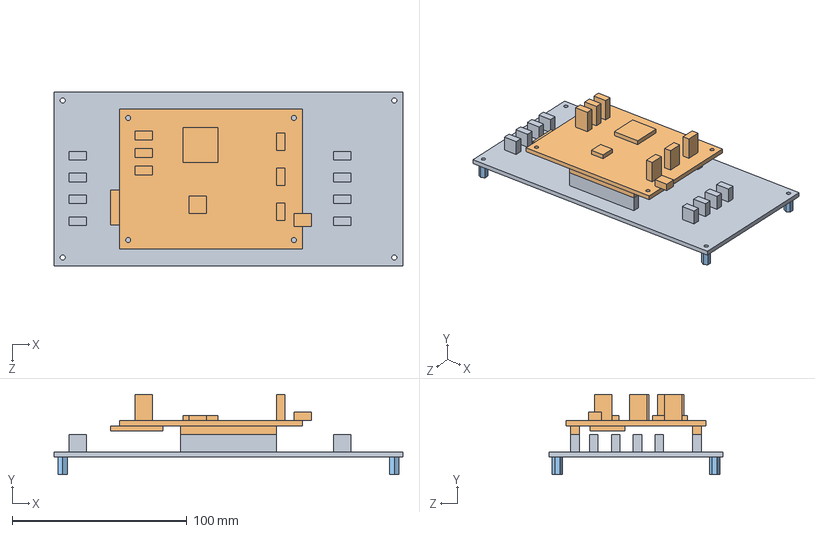
[picture p171: CAD file, 2013-05-17]
Meca/Cartes Electronique/Cartes_Assemblées_Entretoises/ensemble_carte_mere_IO_1.SLDASM
200.0 x 46.0 x 100.0 mm
carte_interface_3
carte_PIC32_FPGA
entretoise_M3_L10 x 4
