massinissalounis/oufffteam/Meca/Pieces_detachees/Glissière_Tiroir/Glissiere_tiroir_hettish_ouverture.SLDASM

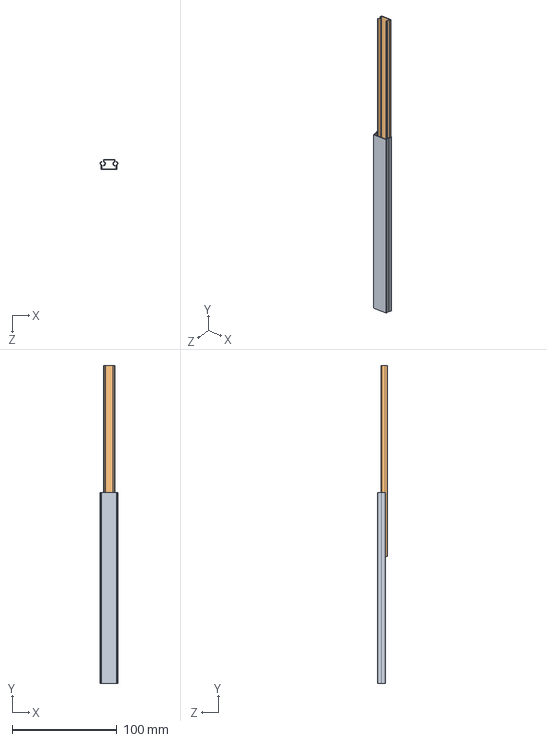
[picture p172: CAD file, 2013-05-17]
Meca/Pieces_detachees/Glissière_Tiroir/Glissiere_tiroir_hettish_ouverture.SLDASM
17.0 x 303.0 x 9.50 mm
glissiere_femelle_Hettish_L182
glissiere_male_Hettish_L182
