massinissalounis/oufffteam/Meca/Pieces_detachees/Servomoteur AX-12/servomoteur_ax-12.SLDASM

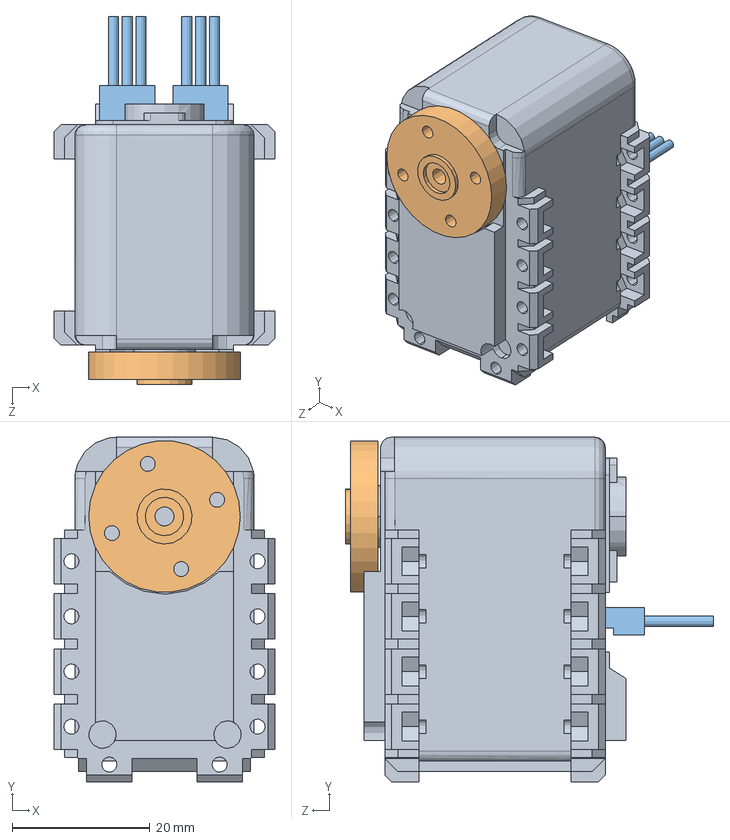
[picture p173: CAD file, 2013-05-17]
Meca/Pieces_detachees/Servomoteur AX-12/servomoteur_ax-12.SLDASM
32.0 x 50.0 x 53.4 mm
AX-12_modif
attache_ax-12
connecteur_AX-12 x 2
