massinissalounis/oufffteam/Meca/Plans Robot 2013/Ballon/système_ballon.SLDASM

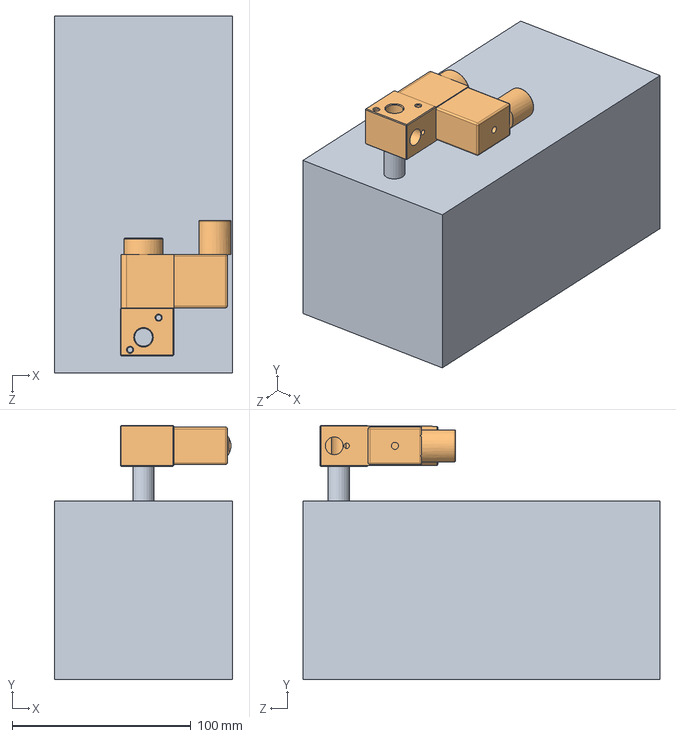
[picture p174: CAD file, 2013-05-17]
Meca/Plans Robot 2013/Ballon/système_ballon.SLDASM
100.0 x 142.5 x 200.0 mm
réservoir_nu
Distributeur_3V1_06
