massinissalounis/oufffteam/Meca/Plans Robot 2013/Cartes élec 2013/cartes alim IO sur support.SLDASM

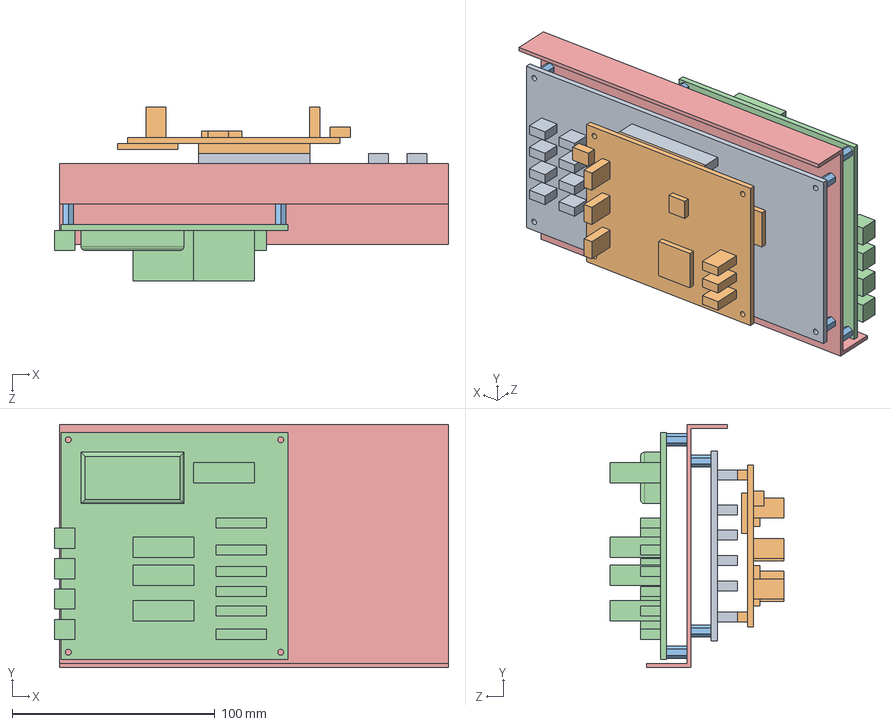
[picture p175: CAD file, 2013-05-17]
Meca/Plans Robot 2013/Cartes élec 2013/cartes alim IO sur support.SLDASM
194.5 x 120.0 x 86.0 mm
carte_interface_4
carte_PIC32_FPGA
entretoise_M3_L10 x 8
carte_puissance_3
Support cartes CM alim
