massinissalounis/oufffteam/Meca/Plans Robot 2013/Petit robot/Robot_2011/Structure/essai_architecture_9.SLDASM

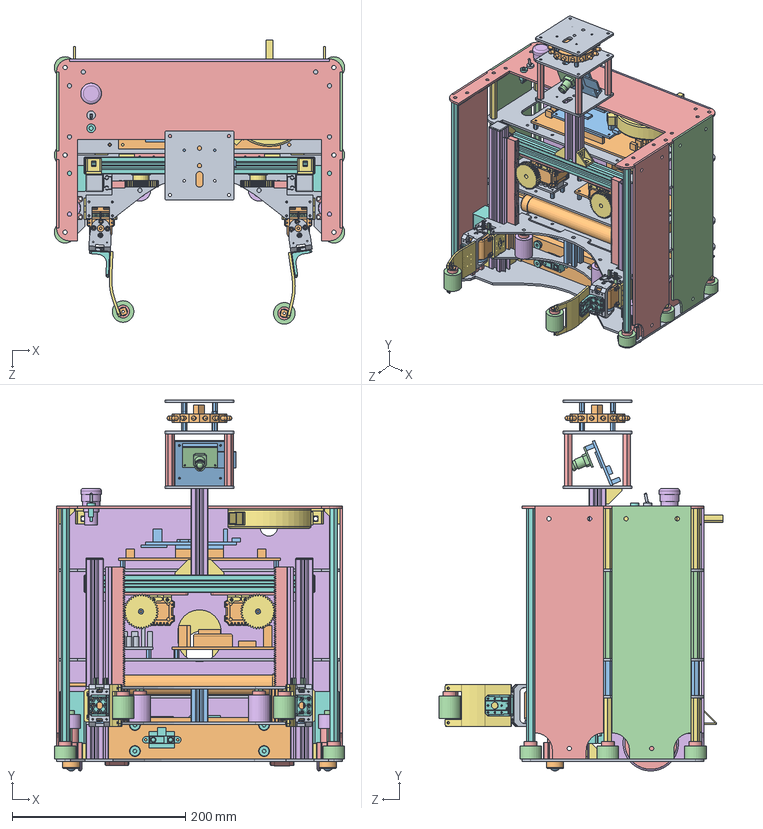
[picture p177: CAD file, 2013-05-17]
Meca/Plans Robot 2013/Petit robot/Robot_2011/Structure/essai_architecture_9.SLDASM
335.0 x 428.0 x 328.0 mm
plateforme_base_V3
support glissière x 2
cloche pour V4 x 2
glissière femelle x 4
glissière male x 4
porte codeur x 2
corps_moteur_faulhauber_3042W024C x 2
arbre_moteur_faulhauber_3042W024C x 2
corps_reducteur_faulhaber_30_1 x 2
arbre_reducteur_faulhauber_30_1 x 2
roue modélisme-V4 x 2
bride roue modélisme-V4 x 2
pneu modélisme x 2
vis roue x 4
corps_codeur_2MRH x 2
mandrin_codeur_2MRH x 2
bague_codeur_2MRH x 2
Socket Head Cap Screw_AM x 2
Vis_fendue_tete_bombee_M2_L5 x 6
Bride_membrane x 2
Roue_codeuse_D30 x 2
joint_D64 x 2
contre plaque glissière x 4
vis_centrage x 8
ressort compressé x 2
Roulette D20 x 2
bille D12_5 x 2
tige filetée M8 x 2
alésage porte bille x 2
Ecrou réglage hauteur x 2
entretoise_M5_L70 x 8
entretoise_M5_L289 x 2
plaque_plastique_L330_l123_decoupe x 3
batterie_10elements x 2
entretoise_M5_L40 x 4
Rouleau_D25_H15 x 6
Support_Rouleau_D15_H20 x 8
Profilé Aluminium Rexroth 20x20 L230 x 2
CornerXD_Rexroth_18x18 x 27
Profilé Aluminium Rexroth 20x20 L262
bouchonXD_Rexroth_20x20 x 4
AX-12_modif x 4
attache_ax-12 x 4
connecteur_AX-12 x 8
fixation_AX12 x 2
glissiere_male_Hettish_L182 x 2
F3 x 6
Contrepoids_côté_L60_l30_h30 x 2
carte_hacheur x 2
carte_puissance_2
entretoise_M3_L10 x 28
entretoise_M5_L100 x 4
plaque_plastique_L330_l210_decoupe_dessus
arret_urgence
ICD2
jack_tirette
bouton_levier
carte_interface_3
carte_PIC32_FPGA
plaque_cote_91x292 x 2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
