massinissalounis/oufffteam/Meca/Plans Robot 2013/Petit robot/Robot_2011/Travaux patrick/motorisation pat/Assemblage6.SLDASM

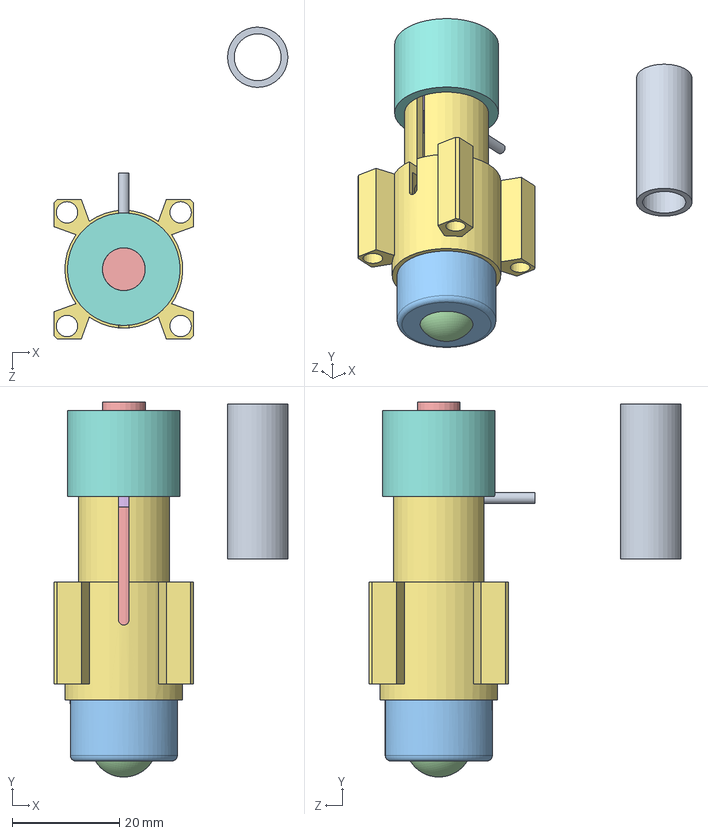
[picture p178: CAD file, 2013-05-17]
Meca/Plans Robot 2013/Petit robot/Robot_2011/Travaux patrick/motorisation pat/Assemblage6.SLDASM
43.6 x 70.0 x 58.2 mm
ressort décompressé
ressort compressé
Roulette D20
bille D12_5
tige filetée M8
bague de compression
alésage porte bille
Ecrou réglage hauteur
axe antirotation
