massinissalounis/oufffteam/Meca/Plans Robot 2013/Sous ensembles Robot/Mat_Balise/mat_balise nu.SLDASM

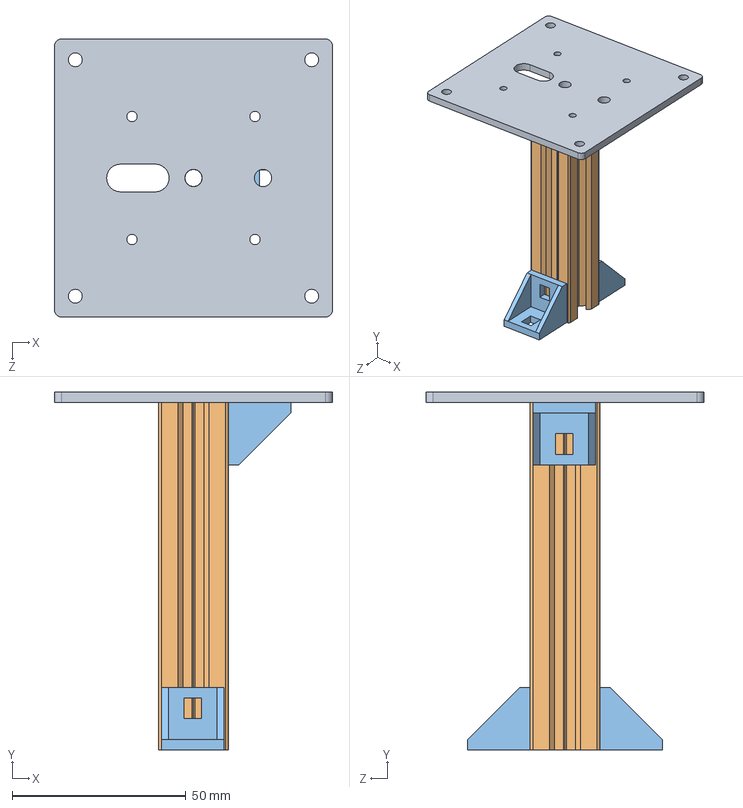
[picture p179: CAD file, 2013-05-17]
Meca/Plans Robot 2013/Sous ensembles Robot/Mat_Balise/mat_balise nu.SLDASM
80.0 x 103.0 x 80.0 mm
plaque_support_80x80
Profilé Aluminium Rexroth 20x20 L100
CornerXD_Rexroth_18x18 x 3
