massinissalounis/oufffteam/Meca/Plans Robot 2013/Sous ensembles Robot/Pince/essai_assemblage_pince_2_droite.SLDASM

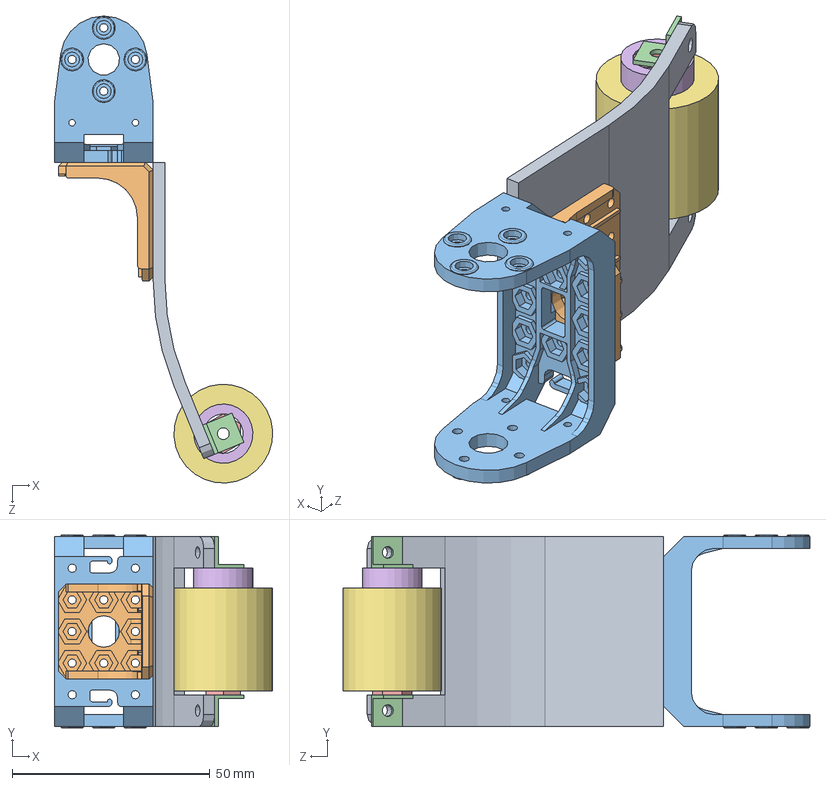
[picture p180: CAD file, 2013-05-17]
Meca/Plans Robot 2013/Sous ensembles Robot/Pince/essai_assemblage_pince_2_droite.SLDASM
55.2 x 48.8 x 118.1 mm
essai_pince_5
F9ORG
F2
corniere_8x8 x 2
entretoise_M5_L32
Support_Rouleau_D15_H20
Rouleau_D25_H26
