massinissalounis/oufffteam/Meca/Plans Robot 2013/Sous ensembles Robot/plaques_electronique/plaque_electronique_2.SLDASM

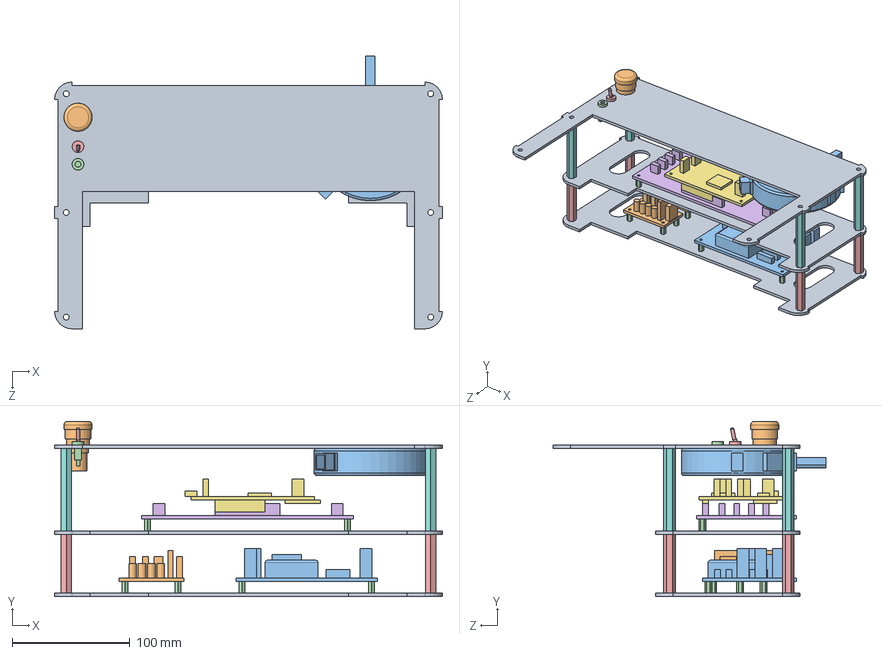
[picture p181: CAD file, 2013-05-17]
Meca/Plans Robot 2013/Sous ensembles Robot/plaques_electronique/plaque_electronique_2.SLDASM
330.0 x 149.0 x 232.0 mm
plaque_plastique_L330_l123_decoupe_servos x 2
carte_hacheur x 2
carte_puissance_2
entretoise_M3_L10 x 16
entretoise_M5_L50 x 4
carte_interface_2
carte_PIC32_FPGA
entretoise_M5_L70 x 4
plaque_plastique_L330_l210_decoupe_dessus
arret_urgence
ICD2
jack_tirette
bouton_levier
