massinissalounis/oufffteam/Meca/Plans Robot 2013/Sous ensembles Robot/Portes_capteurs/capteur_cote.SLDASM

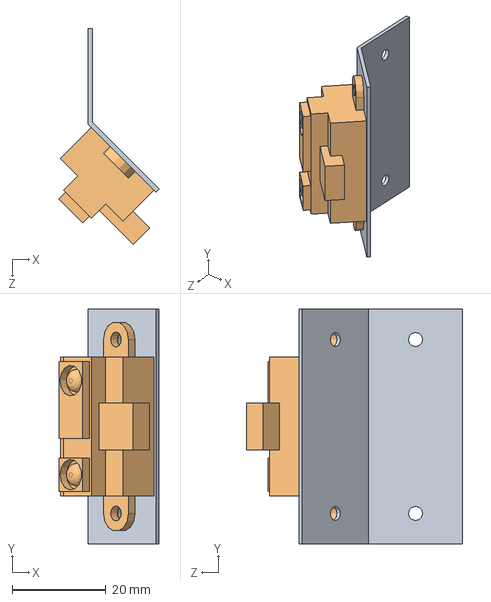
[picture p182: CAD file, 2013-05-17]
Meca/Plans Robot 2013/Sous ensembles Robot/Portes_capteurs/capteur_cote.SLDASM
21.4 x 50.0 x 46.0 mm
corniere_angle45_H50_l20
GP2D12
