massinissalounis/oufffteam/Meca/Sous_Ensembles/Fixation_Ventouse/Fixation_ventouse_1.SLDASM

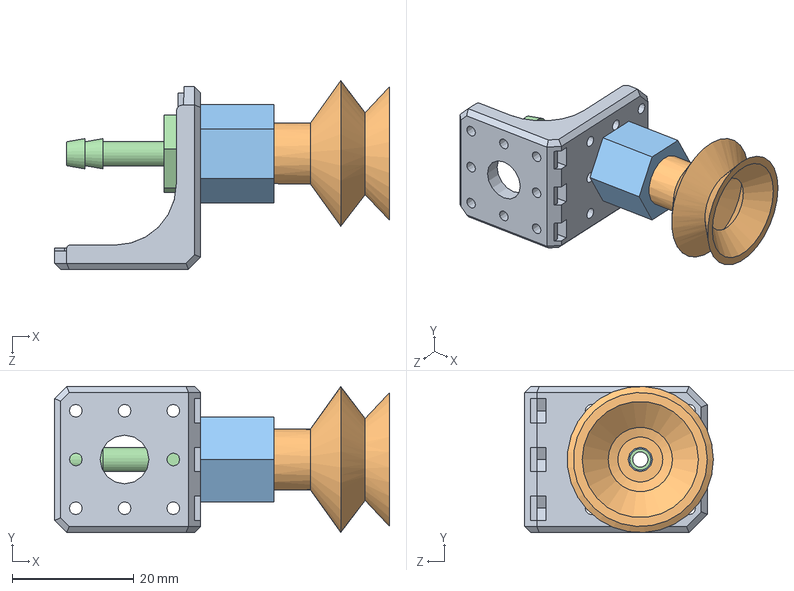
[picture p183: CAD file, 2013-05-17]
Meca/Sous_Ensembles/Fixation_Ventouse/Fixation_ventouse_1.SLDASM
55.0 x 24.0 x 31.0 mm
F9ORG
ventouse_coval_VSA22_M5
Insert_Femelle_IF10A
cannule_male_TET1804
