massinissalounis/oufffteam/Meca/Table_2013/Elements_Jeu/Plateau_Cerises_rouges.SLDASM

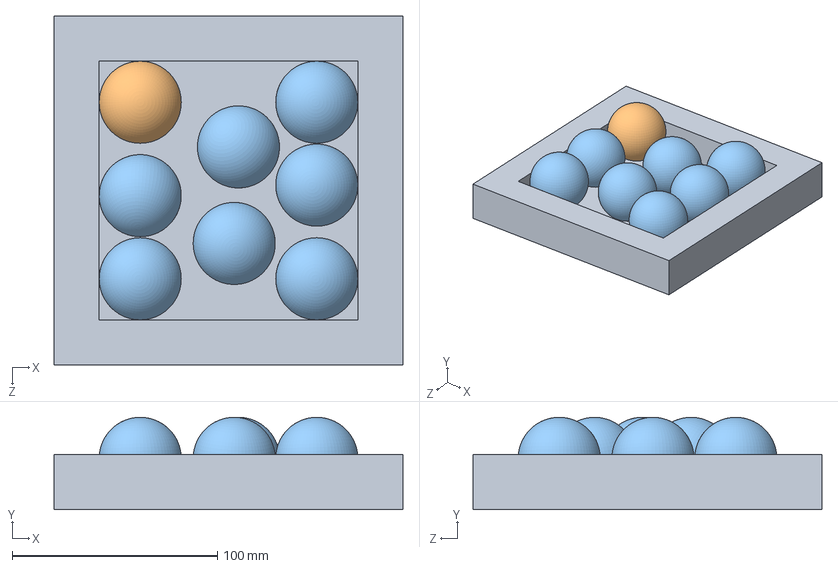
[picture p184: CAD file, 2013-05-17]
Meca/Table_2013/Elements_Jeu/Plateau_Cerises_rouges.SLDASM
170.0 x 45.0 x 170.0 mm
Plateau
Cerise_rouge_2
Cerise_blanche_2 x 7
