massinissalounis/oufffteam/Balises/Balises_SICK/Meca/Balise_Principale/Capteur_WL100/SICK WL100-N4439-Order no_6028604 (0).sldasm

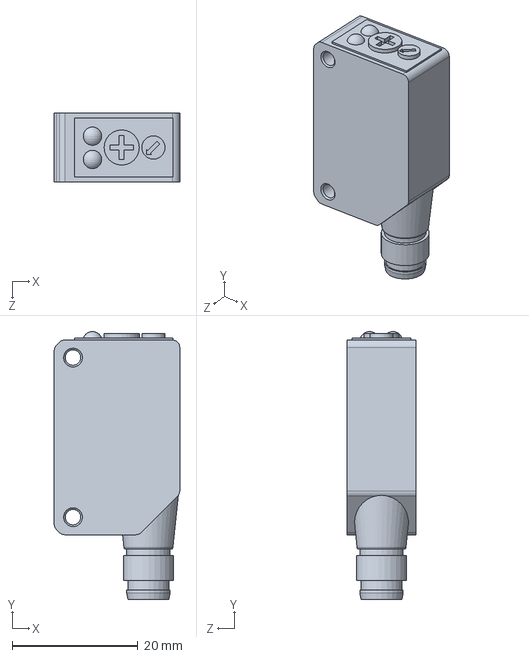
[picture p185: CAD file, 2013-05-17]
Balises/Balises_SICK/Meca/Balise_Principale/Capteur_WL100/SICK WL100-N4439-Order no_6028604 (0).sldasm
20.0 x 42.6 x 11.0 mm
