massinissalounis/oufffteam/Meca/Cartes Electronique/Cartes_Assemblées_Entretoises/carte_hacheur_entretoise.SLDASM

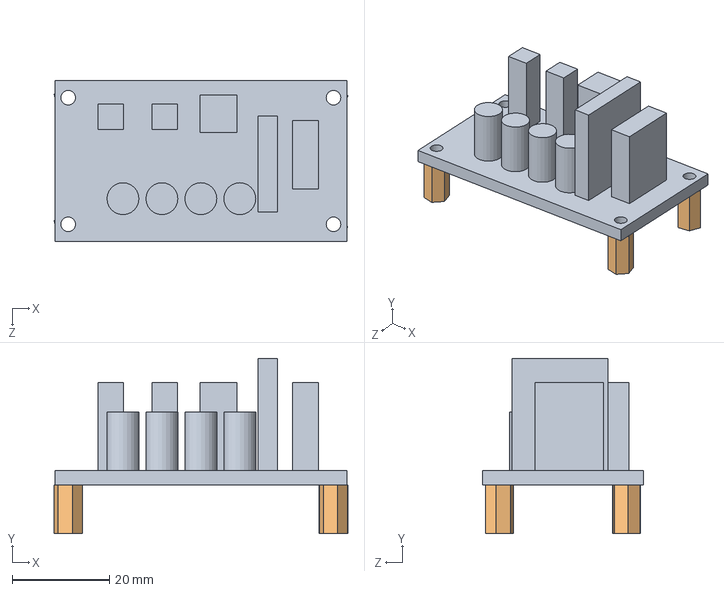
[picture p186: CAD file, 2013-05-17]
Meca/Cartes Electronique/Cartes_Assemblées_Entretoises/carte_hacheur_entretoise.SLDASM
60.4 x 36.0 x 33.0 mm
carte_hacheur
entretoise_M3_L10 x 4
