massinissalounis/oufffteam/Meca/Pieces_detachees/Caméra CMUCam/CMUCam3.SLDASM

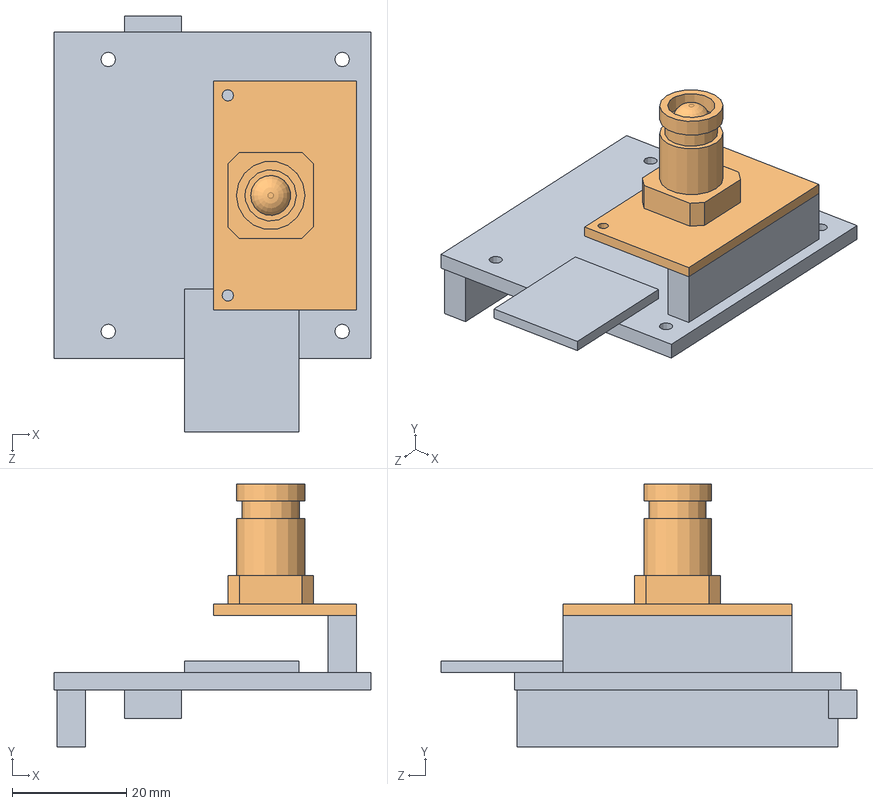
[picture p187: CAD file, 2013-05-17]
Meca/Pieces_detachees/Caméra CMUCam/CMUCam3.SLDASM
55.4 x 46.0 x 72.8 mm
Support_carte_CMUCam
Optique_Cmucam
