massinissalounis/oufffteam/Meca/Pieces_detachees/Porte_bille_reglable/Roulette à bille 687-679-modifiée.SLDASM

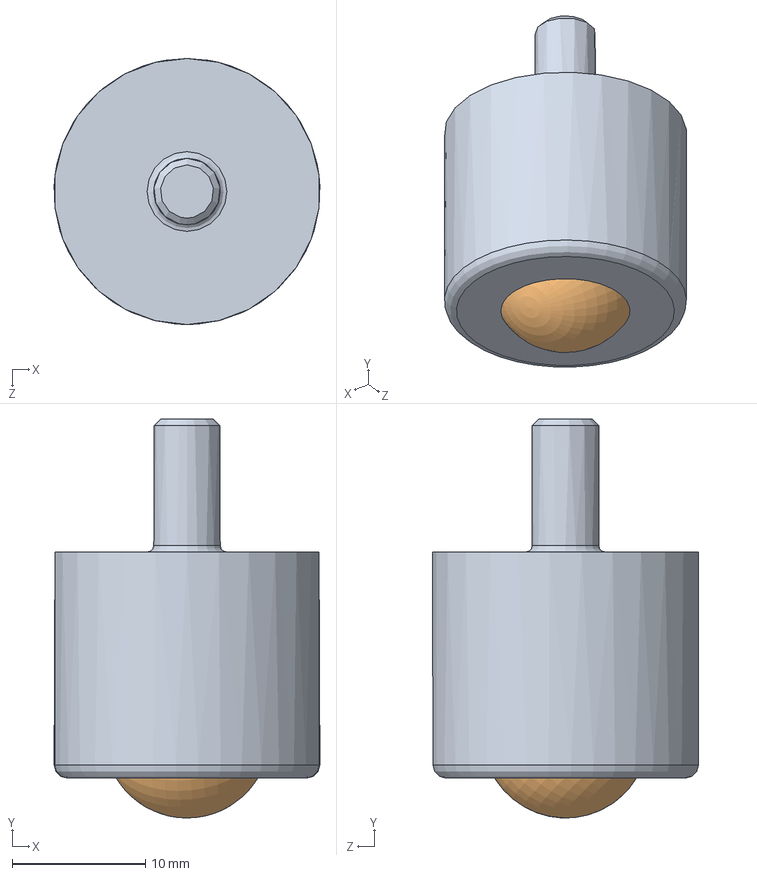
[picture p188: CAD file, 2013-05-17]
Meca/Pieces_detachees/Porte_bille_reglable/Roulette à bille 687-679-modifiée.SLDASM
20.0 x 30.0 x 20.0 mm
Roulette D20
bille D12_5
