massinissalounis/oufffteam/Meca/Plans Robot 2013/Bras/Bras_servo.SLDASM

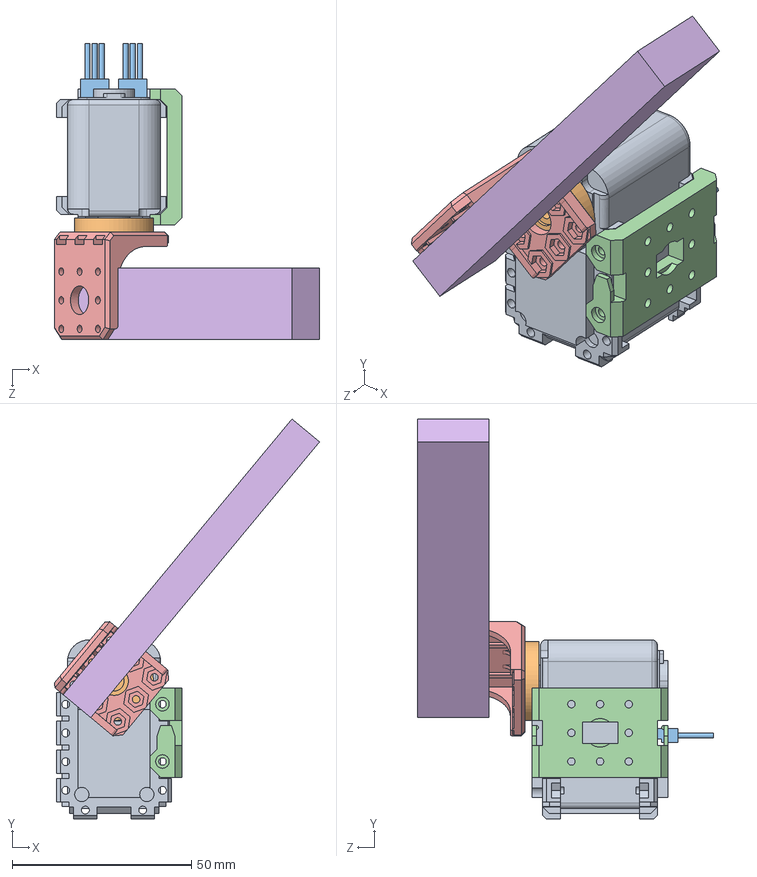
[picture p189: CAD file, 2013-05-17]
Meca/Plans Robot 2013/Bras/Bras_servo.SLDASM
74.0 x 111.6 x 82.7 mm
AX-12_modif
attache_ax-12
connecteur_AX-12 x 2
F3
F9ORG
Bras_pour_servo
