massinissalounis/oufffteam/Meca/Plans Robot 2013/Cartes élec 2013/ensemble_carte_mere_IO_1.SLDASM

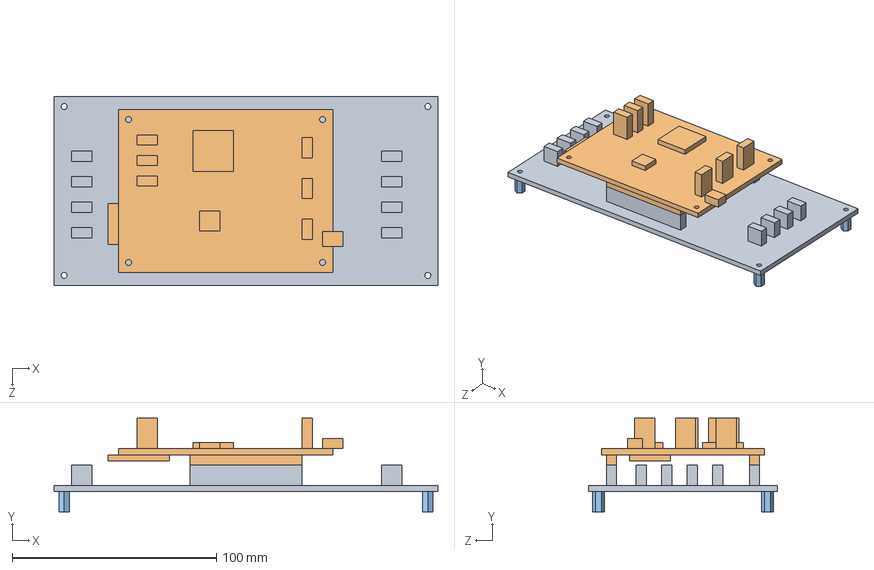
[picture p190: CAD file, 2013-05-17]
Meca/Plans Robot 2013/Cartes élec 2013/ensemble_carte_mere_IO_1.SLDASM
188.0 x 46.0 x 92.7 mm
carte_interface_4
carte_PIC32_FPGA
entretoise_M3_L10 x 4
