massinissalounis/oufffteam/Meca/Plans Robot 2013/Petit robot/glissière/glissière_L46.SLDASM

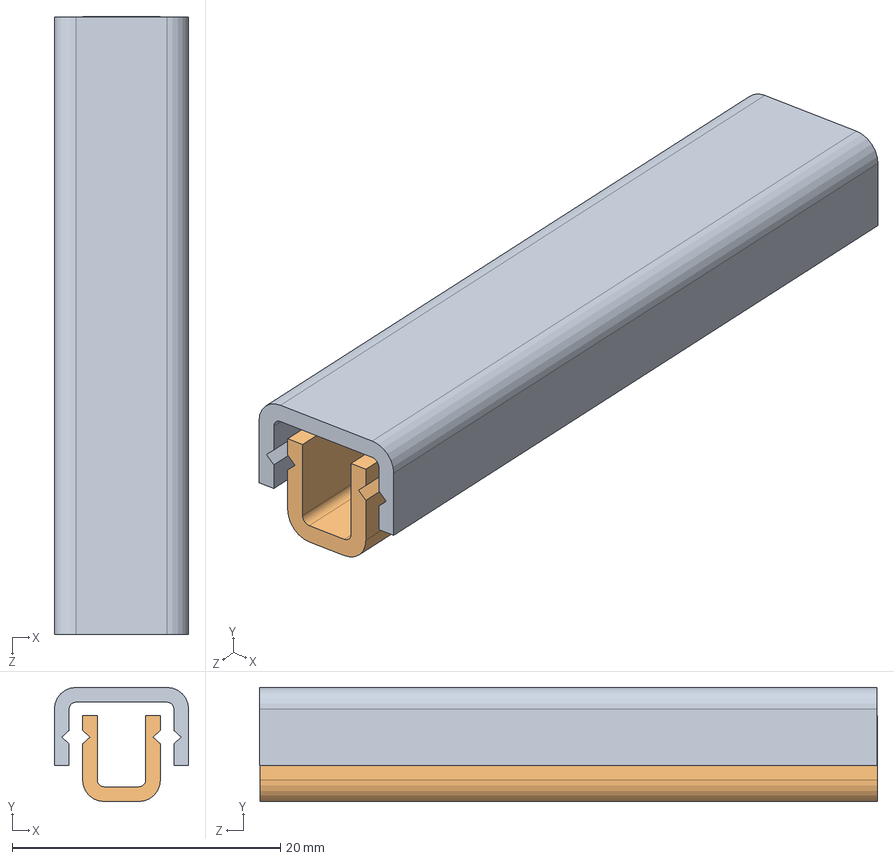
[picture p191: CAD file, 2013-05-17]
Meca/Plans Robot 2013/Petit robot/glissière/glissière_L46.SLDASM
10.0 x 8.50 x 46.0 mm
glissière femelle_L46-
glissière male_L46-
