massinissalounis/oufffteam/Meca/Plans Robot 2013/Petit robot/Robot_2011/Travaux patrick/motorisation pat/Codeur/Codeur_2MRH.SLDASM

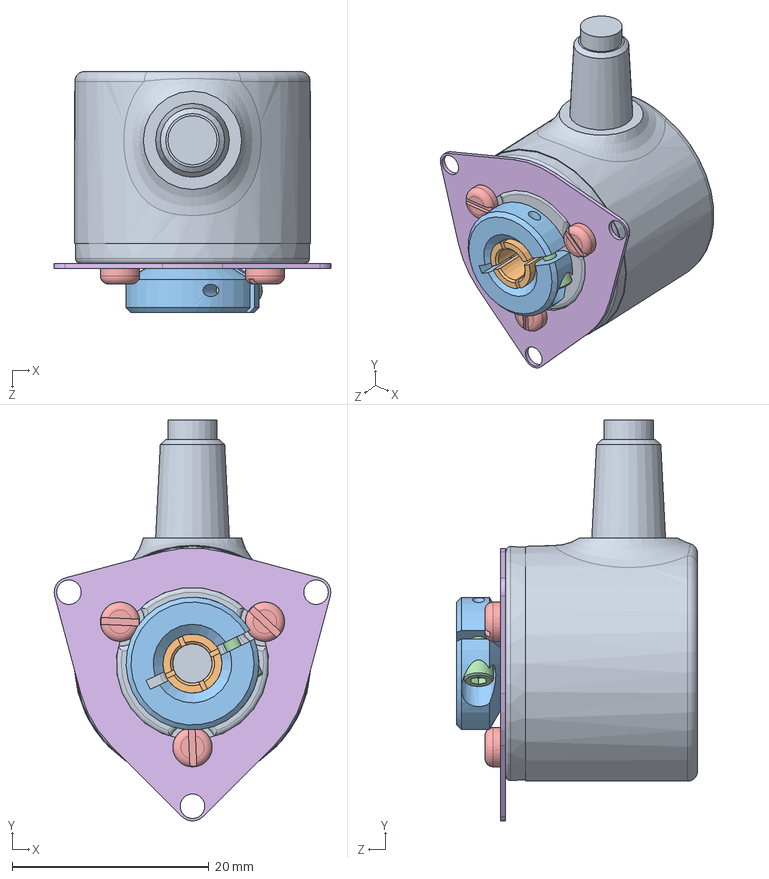
[picture p192: CAD file, 2013-05-17]
Meca/Plans Robot 2013/Petit robot/Robot_2011/Travaux patrick/motorisation pat/Codeur/Codeur_2MRH.SLDASM
28.1 x 40.8 x 24.5 mm
corps_codeur_2MRH
mandrin_codeur_2MRH
bague_codeur_2MRH
Socket Head Cap Screw_AM
Vis_fendue_tete_bombee_M2_L5 x 3
Bride_membrane
