massinissalounis/oufffteam/Meca/Plans Robot 2013/Petit robot/Robot_2011/Travaux patrick/motorisation rémi/Motorisation/Moteur_faulhauber_3042W024C/Motoreducteur_Faulhauber_3042W024_30_1.SLDASM

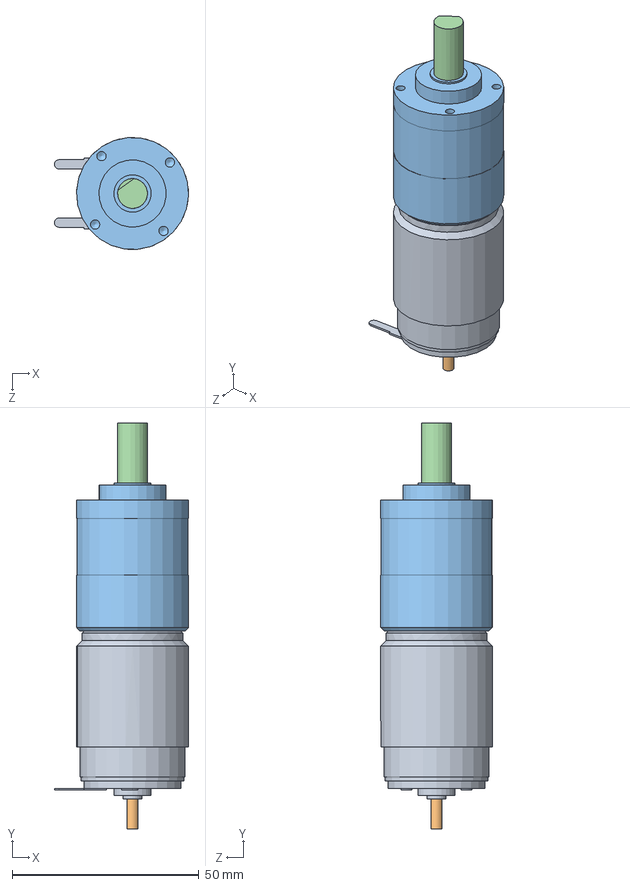
[picture p193: CAD file, 2013-05-17]
Meca/Plans Robot 2013/Petit robot/Robot_2011/Travaux patrick/motorisation rémi/Motorisation/Moteur_faulhauber_3042W024C/Motoreducteur_Faulhauber_3042W024_30_1.SLDASM
35.9 x 108.6 x 30.0 mm
corps_moteur_faulhauber_3042W024C
arbre_moteur_faulhauber_3042W024C
corps_reducteur_faulhaber_30_1
arbre_reducteur_faulhauber_30_1
