massinissalounis/oufffteam/Meca/Plans Robot 2013/Sous ensembles Robot/plaques_electronique/plaque_electronique_1.SLDASM

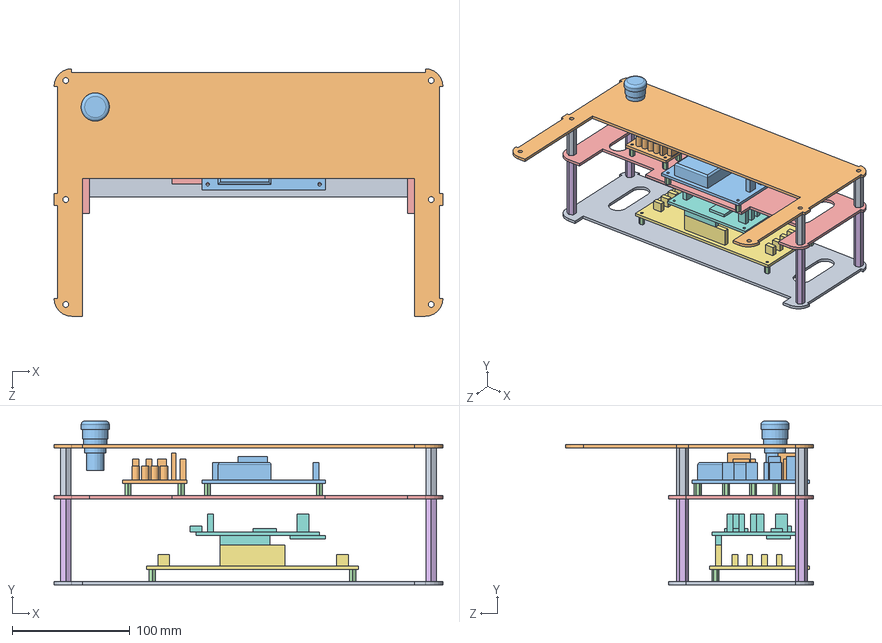
[picture p194: CAD file, 2013-05-17]
Meca/Plans Robot 2013/Sous ensembles Robot/plaques_electronique/plaque_electronique_1.SLDASM
330.0 x 139.0 x 210.0 mm
plaque_plastique_L330_l123_decoupe
carte_hacheur x 2
carte_puissance
entretoise_M3_L10 x 16
plaque_plastique_L330_l123_decoupe_servos
entretoise_M5_L70 x 4
carte_interface_2
carte_PIC32_FPGA
entretoise_M5_L40 x 4
plaque_plastique_L330_l210_decoupe_dessus
arret_urgence
