massinissalounis/oufffteam/Meca/Table_2012/Elements_Mobiles_Table/robot_adverse_bleu_capteur.SLDASM

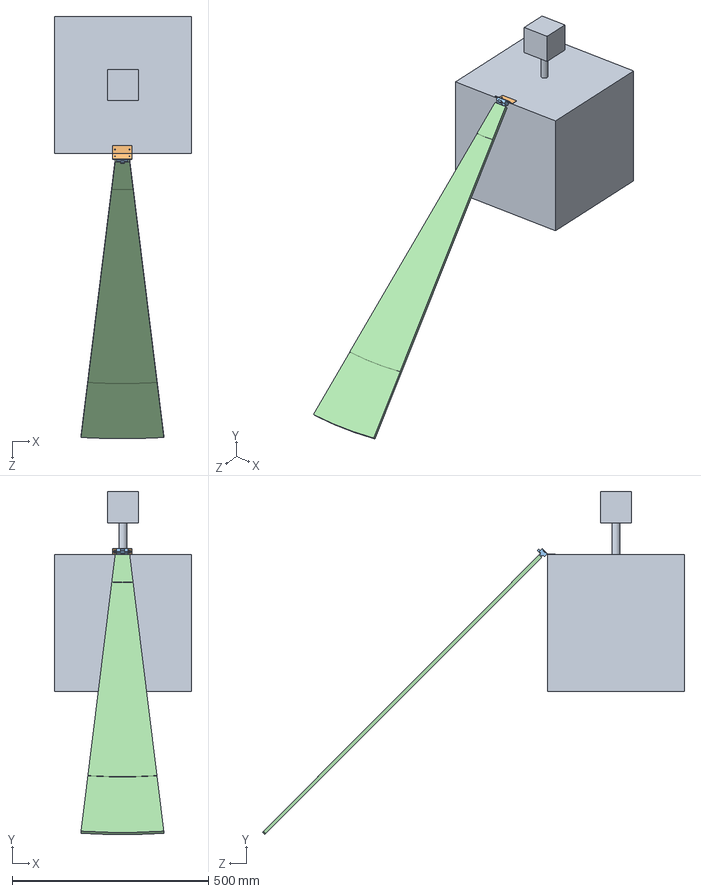
[picture p195: CAD file, 2013-05-17]
Meca/Table_2012/Elements_Mobiles_Table/robot_adverse_bleu_capteur.SLDASM
350.0 x 874.5 x 1076.7 mm
robot_adverse_bleu
corniere_angle45_H50_l20
GP2D12
champ_GP2D12
