massinissalounis/oufffteam/Meca/Table_2012/Plans_table_menuiserie/Terrain_9_Partie_2.SLDASM

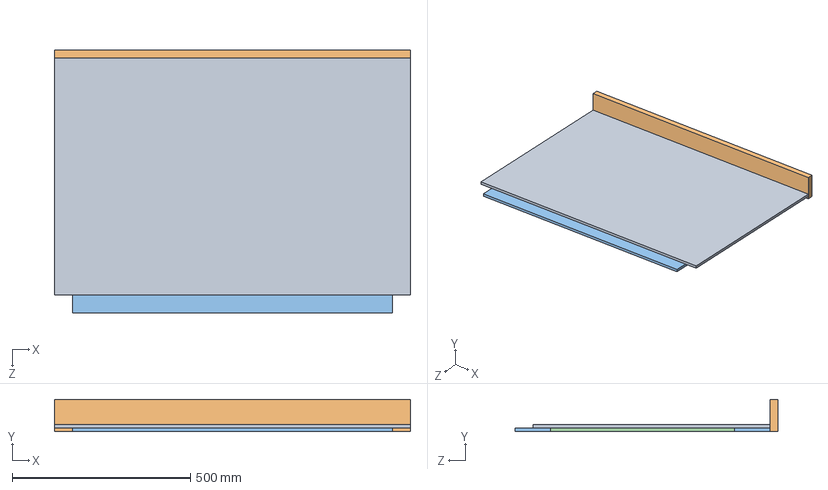
[picture p196: CAD file, 2013-05-17]
Meca/Table_2012/Plans_table_menuiserie/Terrain_9_Partie_2.SLDASM
1000.0 x 90.0 x 739.0 mm
planche_1000x667x10
planche_1000x90x22
planche_900x100x10 x 2
planche_517x100x10
