massinissalounis/oufffteam/Balises/Balises_SICK/Meca/Balises_Passives/Balises_passives_v2/Balises_passives_v3.SLDASM

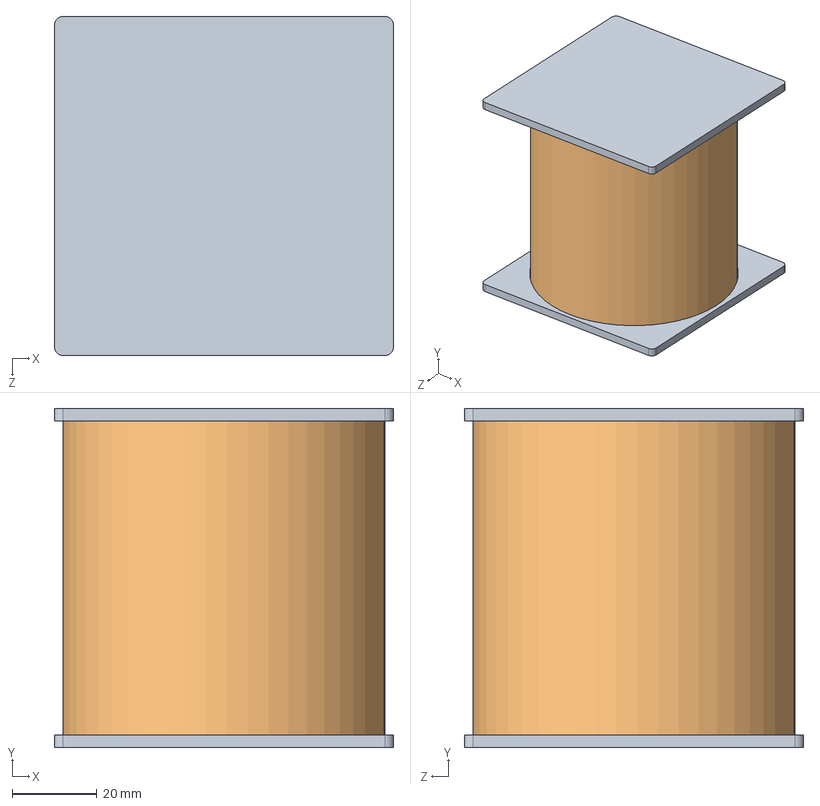
[picture p197: CAD file, 2013-06-14]
Balises/Balises_SICK/Meca/Balises_Passives/Balises_passives_v2/Balises_passives_v3.SLDASM
80.0 x 80.0 x 80.0 mm
support x 2
cylindre_free
