massinissalounis/oufffteam/Meca/Cartes Electronique/Cartes_Assemblées_Entretoises/carte_interface_3_entretoises.SLDASM

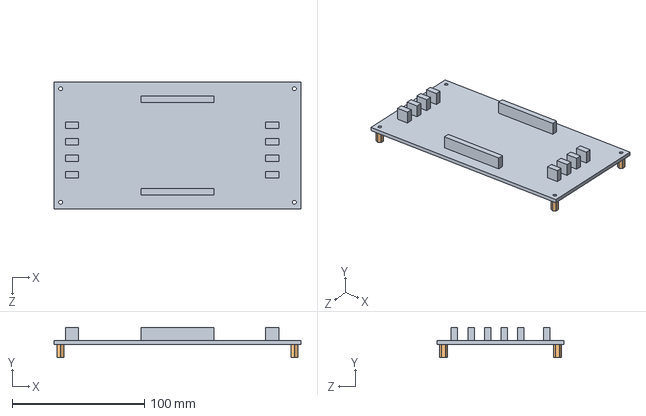
[picture p198: CAD file, 2013-05-17]
Meca/Cartes Electronique/Cartes_Assemblées_Entretoises/carte_interface_3_entretoises.SLDASM
187.0 x 23.0 x 96.0 mm
carte_interface_3
entretoise_M3_L10 x 4
