massinissalounis/oufffteam/Meca/Pieces_detachees/Servomoteur AX-12/montage_bras_servo_essai.SLDASM

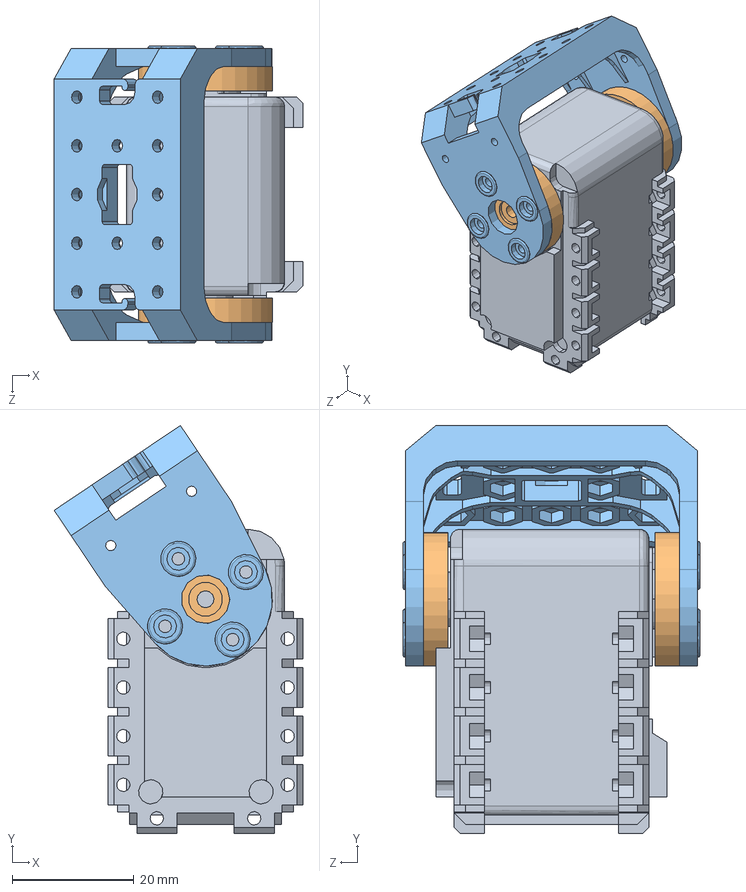
[picture p199: CAD file, 2011-01-01]
Meca/Pieces_detachees/Servomoteur AX-12/montage_bras_servo_essai.SLDASM
40.9 x 67.1 x 48.8 mm
AX-12_modif
attache_ax-12 x 2
F2
