massinissalounis/oufffteam/Meca/Plans Robot 2013/Bras CBE/bras_pousseur.SLDASM

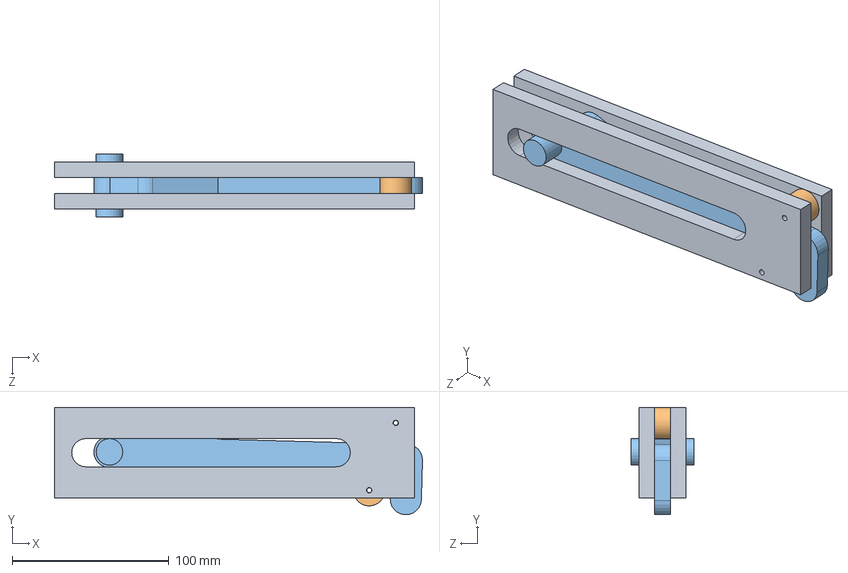
[picture p200: CAD file, 2013-05-17]
Meca/Plans Robot 2013/Bras CBE/bras_pousseur.SLDASM
235.1 x 68.6 x 40.0 mm
guide x 2
roue x 2
bras
