massinissalounis/oufffteam/Meca/Plans Robot 2013/Bras/Bras_servo fixation en U.SLDASM

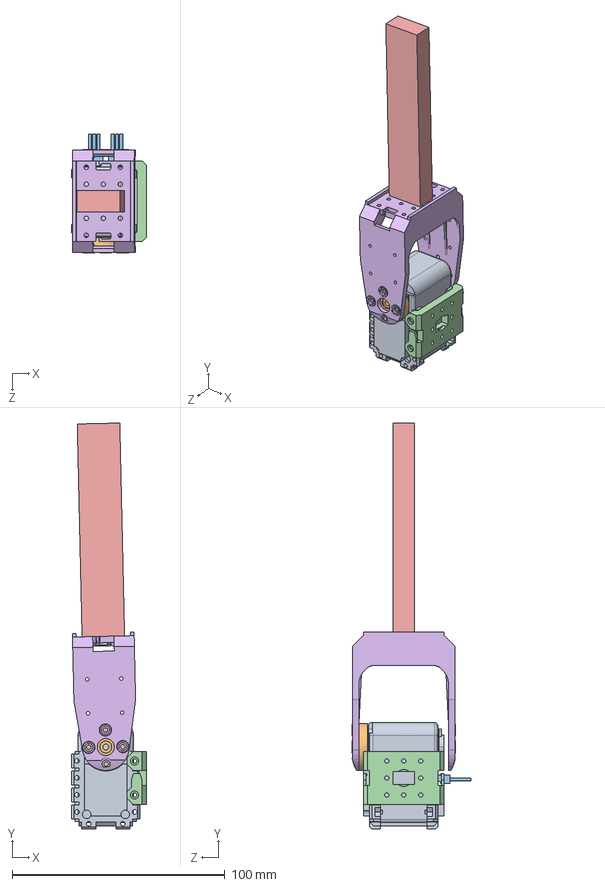
[picture p201: CAD file, 2013-05-17]
Meca/Plans Robot 2013/Bras/Bras_servo fixation en U.SLDASM
35.0 x 190.7 x 56.1 mm
AX-12_modif
attache_ax-12
connecteur_AX-12 x 2
F3
Bras_pour_servo
F4
