massinissalounis/oufffteam/Meca/Plans Robot 2013/Cartes élec 2013/carte_puissance_3_entretoises.SLDASM

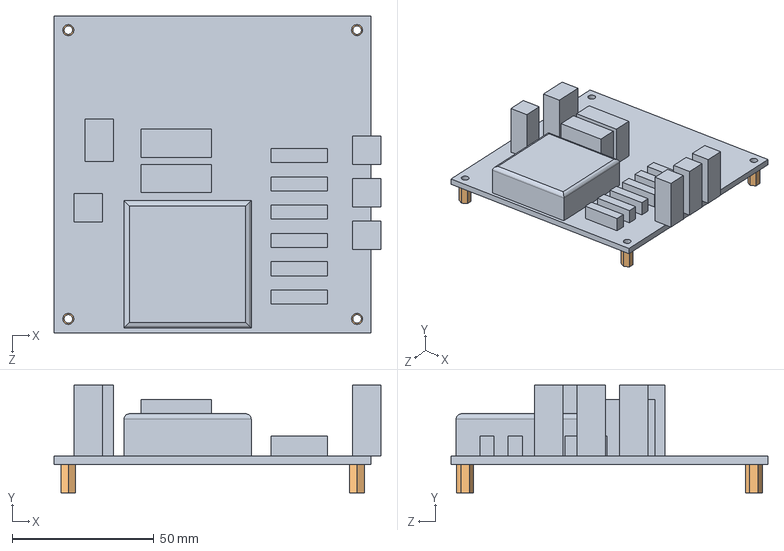
[picture p202: CAD file, 2013-05-17]
Meca/Plans Robot 2013/Cartes élec 2013/carte_puissance_3_entretoises.SLDASM
115.4 x 38.0 x 112.0 mm
carte_puissance_3
entretoise_M3_L10 x 4
