massinissalounis/oufffteam/Meca/Plans Robot 2013/Petit robot/Codeur/Codeur_2MRH.SLDASM

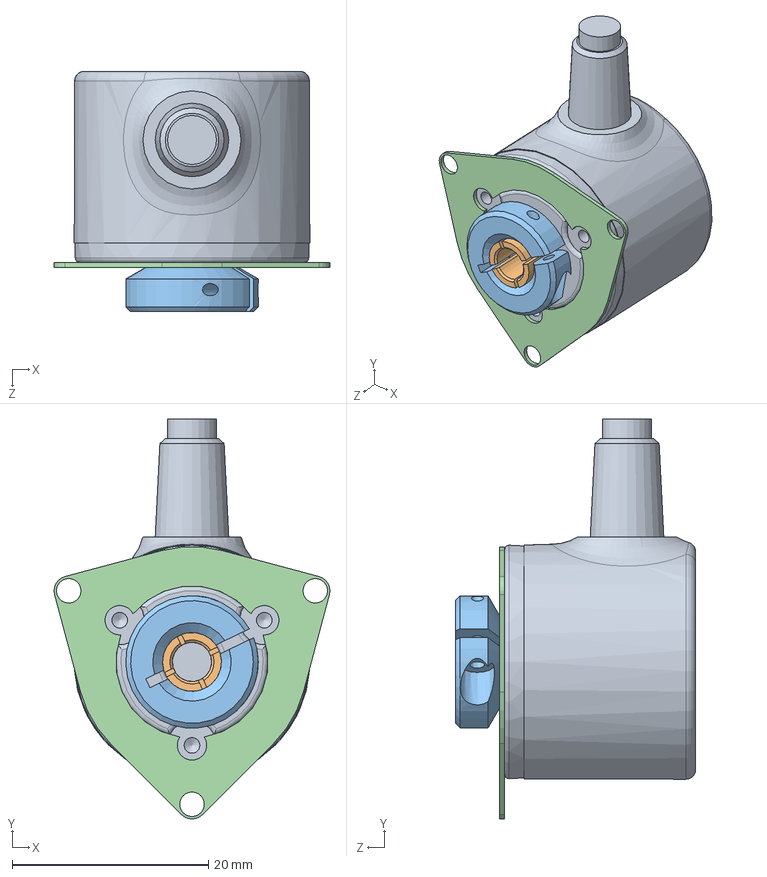
[picture p203: CAD file, 2013-05-17]
Meca/Plans Robot 2013/Petit robot/Codeur/Codeur_2MRH.SLDASM
28.1 x 40.8 x 24.5 mm
corps_codeur_2MRH
mandrin_codeur_2MRH
bague_codeur_2MRH
Bride_membrane
