massinissalounis/oufffteam/Meca/Plans Robot 2013/Petit robot/Robot_2011/Structure/essai_architecture_2.SLDASM

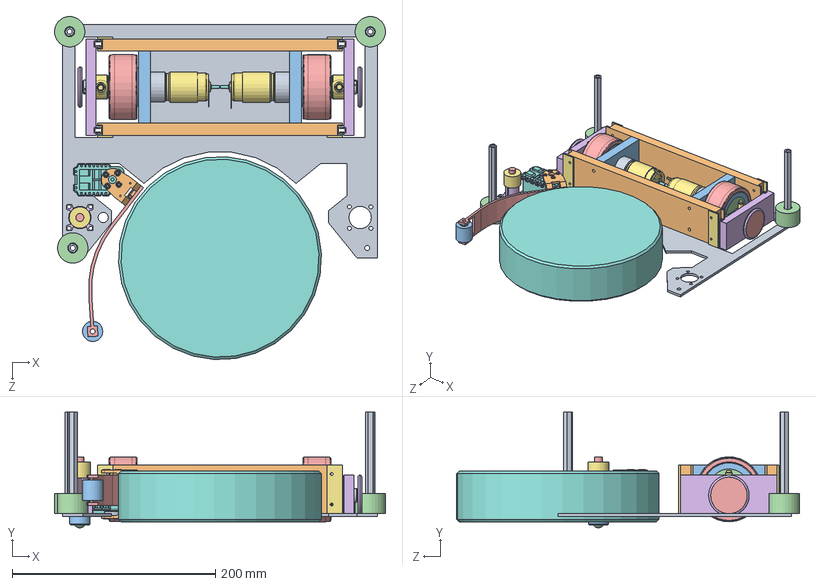
[picture p204: CAD file, 2013-05-17]
Meca/Plans Robot 2013/Petit robot/Robot_2011/Structure/essai_architecture_2.SLDASM
326.0 x 114.0 x 337.8 mm
plateforme_base_V2
support glissière x 2
cloche pour V4 x 2
glissière femelle x 4
glissière male x 4
porte codeur x 2
corps_moteur_faulhauber_3042W024C x 2
arbre_moteur_faulhauber_3042W024C x 2
corps_reducteur_faulhaber_30_1 x 2
arbre_reducteur_faulhauber_30_1 x 2
roue modélisme-V4 x 2
bride roue modélisme-V4 x 2
pneu modélisme x 2
vis roue x 4
corps_codeur_2MRH x 2
mandrin_codeur_2MRH x 2
bague_codeur_2MRH x 2
Socket Head Cap Screw_AM x 2
Vis_fendue_tete_bombee_M2_L5 x 6
Bride_membrane x 2
Roue_codeuse x 2
joint_D40 x 2
contre plaque glissière x 4
AX-12_modif
attache_ax-12
ressort compressé
Roulette D20
bille D12_5
tige filetée M8
alésage porte bille
Ecrou réglage hauteur
Pion
entretoise_M5_L100 x 3
F2
Rouleau_D20_H20
Rouleau_D30_H20 x 3
essai_pince_3
