massinissalounis/oufffteam/Meca/Plans Robot 2013/pince_a_verre/pince_a_verre.SLDASM

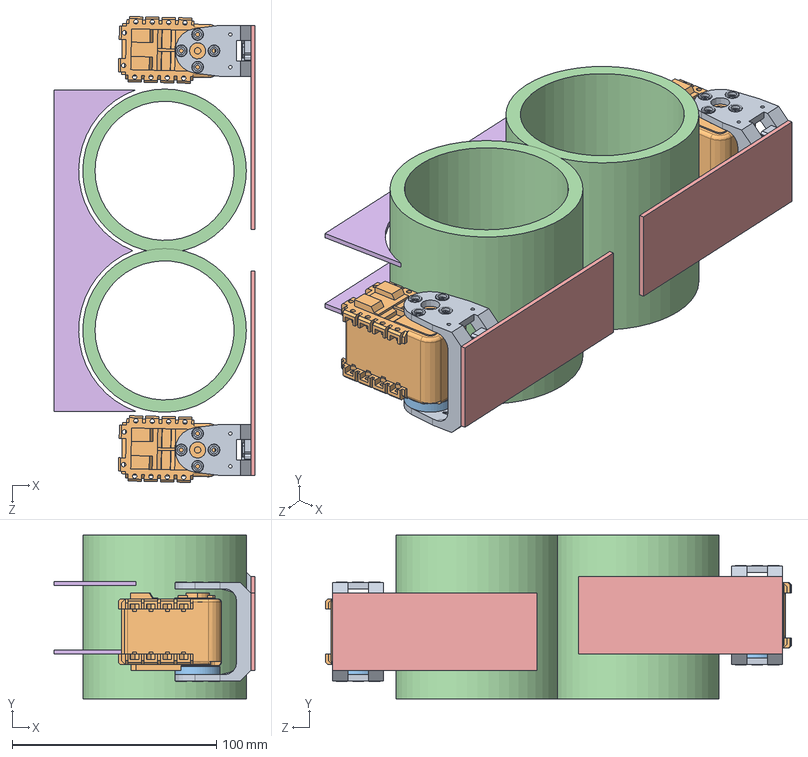
[picture p205: CAD file, 2013-05-17]
Meca/Plans Robot 2013/pince_a_verre/pince_a_verre.SLDASM
98.2 x 80.0 x 227.9 mm
F2 x 2
AX-12_modif x 2
attache_ax-12 x 2
Verre x 2
plaque_serrage x 2
plaque_fixation x 2
