massinissalounis/oufffteam/Meca/Plans Robot 2013/Sous ensembles Robot/Mat_Balise/mat_balise.SLDASM

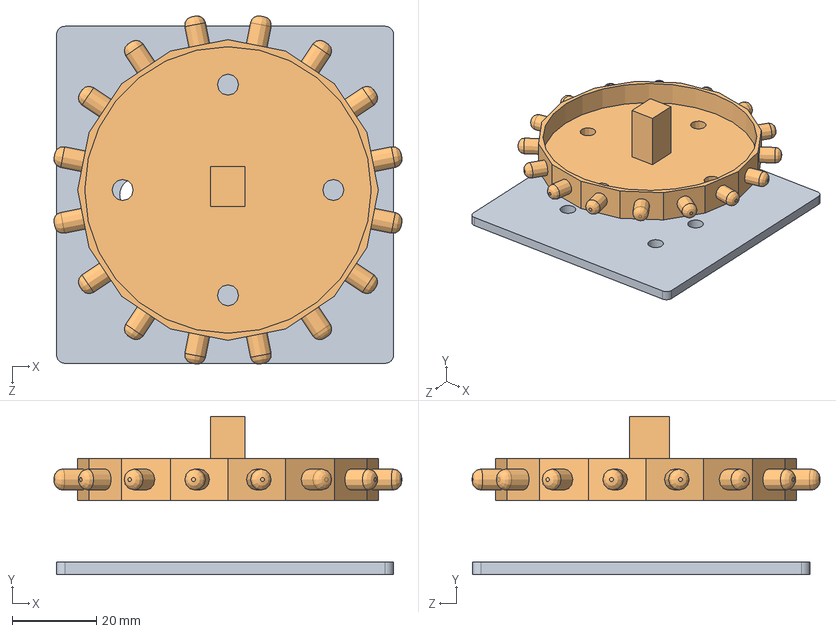
[picture p206: CAD file, 2013-05-17]
Meca/Plans Robot 2013/Sous ensembles Robot/Mat_Balise/mat_balise.SLDASM
82.6 x 37.6 x 82.6 mm
plaque_support_80x80
Recepteur_IR
