massinissalounis/oufffteam/Meca/Sous_Ensembles/Base_roulante/base_roulante_V2.SLDASM

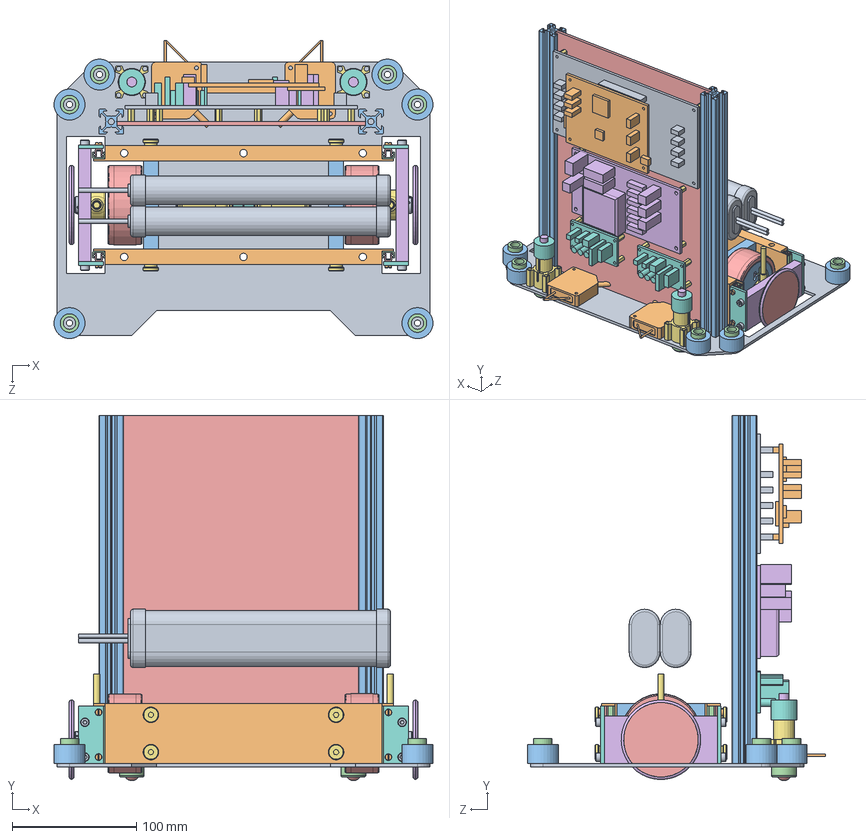
[picture p207: CAD file, 2013-05-17]
Meca/Sous_Ensembles/Base_roulante/base_roulante_V2.SLDASM
305.0 x 294.0 x 240.0 mm
Essai_plaque_base_V3
support glissière_2 x 2
cloche _2 x 2
glissière femelle_L46 x 4
glissière male_L46 x 4
porte codeur_2 x 2
corps_moteur_faulhauber_3042W024C x 2
arbre_moteur_faulhauber_3042W024C x 2
corps_reducteur_faulhaber_30_1 x 2
arbre_reducteur_faulhauber_30_1 x 2
roue modélisme-V4 x 2
bride roue modélisme-V4 x 2
pneu modélisme x 2
vis roue x 4
corps_codeur_2MRH x 2
mandrin_codeur_2MRH x 2
bague_codeur_2MRH x 2
Vis_CHC_M2_L5 x 2
Vis_fendue_tete_bombee_M2_L5 x 6
Bride_membrane x 2
Roue_codeuse_D30 x 2
joint_D64 x 2
vis_centrage x 8
contre plaque glissière_2 x 4
Vis_CHC_M4_L10 x 8
Vis_fendue_M3_L5 x 8
ressort compressé x 2
Roulette D20 x 2
bille D12_5 x 2
tige filetée M8 x 2
alésage porte bille x 2
Ecrou réglage hauteur x 2
batterie_10elements x 2
Banner_PicoDot_PD45 x 2
Rouleau_D25_H15 x 6
Support_Rouleau_D15_H20 x 6
plaque_support_verticale_V1
carte_puissance_2
entretoise_M3_L10 x 16
carte_hacheur x 2
carte_interface_3
carte_PIC32_FPGA
Profilé Aluminium Rexroth 20x20 L280 x 2
