massinissalounis/oufffteam/Meca/Sous_Ensembles/Bras_prehension/Essai_double_bras.SLDASM

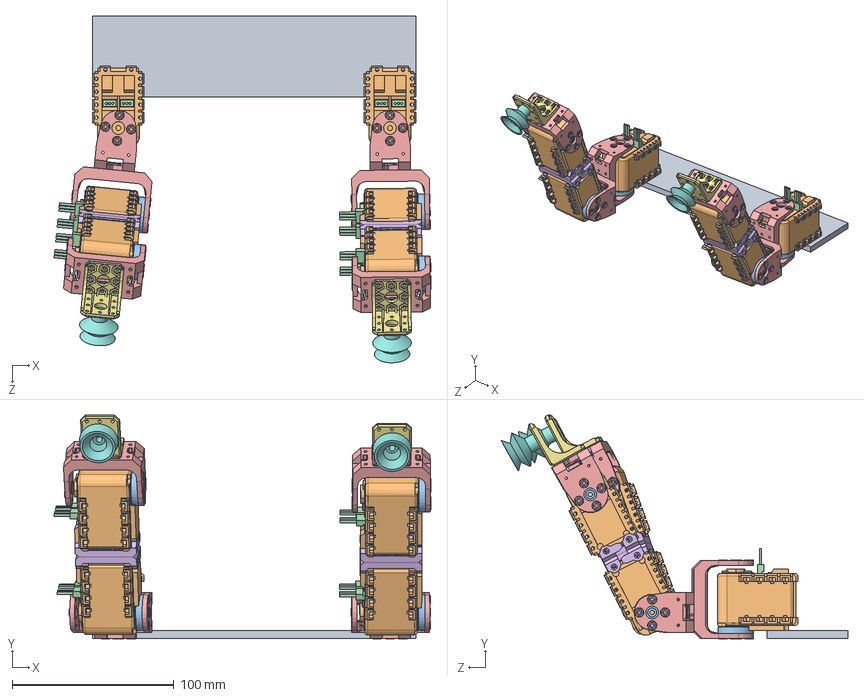
[picture p208: CAD file, 2013-05-17]
Meca/Sous_Ensembles/Bras_prehension/Essai_double_bras.SLDASM
233.1 x 138.5 x 214.4 mm
Plaque_fixation_test
AX-12_modif x 6
attache_ax-12 x 6
connecteur_AX-12 x 12
F2 x 6
F3 x 4
F9ORG x 2
ventouse_coval_VSA22_M5 x 2
