massinissalounis/oufffteam/Meca/Table_2012/Table_2012_mise_en_situation.SLDASM

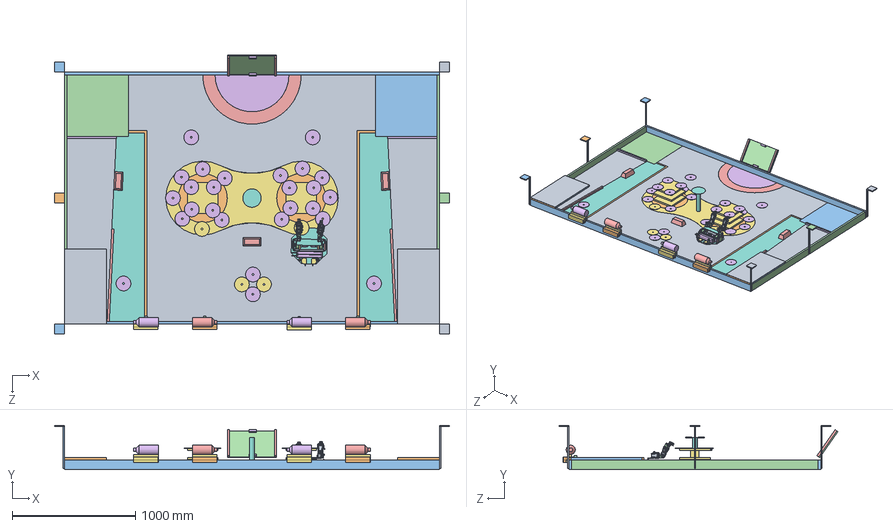
[picture p209: CAD file, 2013-05-17]
Meca/Table_2012/Table_2012_mise_en_situation.SLDASM
3204.0 x 360.0 x 2262.5 mm
ocean_principal
ligne_noire x 2
Depart_Rouge
Depart_Violet
plage_carte
ile_carte
plage_centre
ocean_cote x 2
Cale x 2
ile_centre x 2
cote_3044x80 x 2
cote_2000x80 x 2
linteau_18x18_L750_Marron x 2
linteau_18x18_L400_Marron x 2
totem x 2
palmier
Vitre_cale x 2
linteau_18x18_L340_Marron x 4
linteau_18x18_L574_Marron x 4
support_carte
linteau_18x18_L258_bleu x 2
linteau_18x18_L60_bleu x 2
linteau_22x22_L200_bleu x 8
linteau_22x22_L89_bleu x 8
Porte_Balise_Coin_Rouge x 2
Porte_Balise_Milieu_Rouge
Porte_Balise_Coin_Violet x 2
Porte_Balise_Milieu_Violet
bouteille_rouge x 2
bouteille_violet x 2
linteau_22x22_L200_violet x 6
linteau_22x22_L44_violet x 2
linteau_22x22_L103_violet x 2
linteau_22x22_L200_rouge x 6
linteau_22x22_L44_rouge x 2
linteau_22x22_L103_rouge x 2
lingot x 3
Piece_blanche x 26
Piece_noir x 4
Essai_plaque_base_V2
support glissière x 2
cloche pour V4 x 2
glissière femelle x 4
glissière male x 4
porte codeur x 2
corps_moteur_faulhauber_3042W024C x 2
arbre_moteur_faulhauber_3042W024C x 2
corps_reducteur_faulhaber_30_1 x 2
arbre_reducteur_faulhauber_30_1 x 2
roue modélisme-V4 x 2
bride roue modélisme-V4 x 2
pneu modélisme x 2
vis roue x 4
corps_codeur_2MRH x 2
mandrin_codeur_2MRH x 2
bague_codeur_2MRH x 2
Socket Head Cap Screw_AM x 2
Vis_fendue_tete_bombee_M2_L5 x 6
Bride_membrane x 2
Roue_codeuse_D30 x 2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
