massinissalounis/oufffteam/Balises/Balises_SICK/Meca/Balise_Principale/Plaque_top_SICK.SLDASM

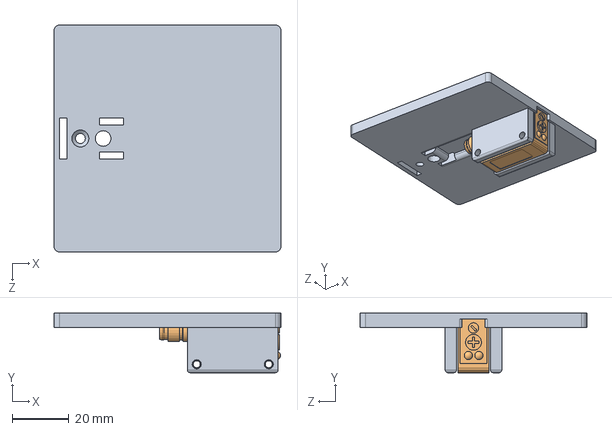
[picture p210: CAD file, 2013-06-14]
Balises/Balises_SICK/Meca/Balise_Principale/Plaque_top_SICK.SLDASM
80.0 x 21.0 x 80.0 mm
Plaque_top
SICK WL100-N4439-Bestell-Nr_6028604(0)-1
