massinissalounis/oufffteam/Meca/Cartes Electronique/Cartes_Assemblées_Entretoises/carte_puissance_2_entretoises.SLDASM

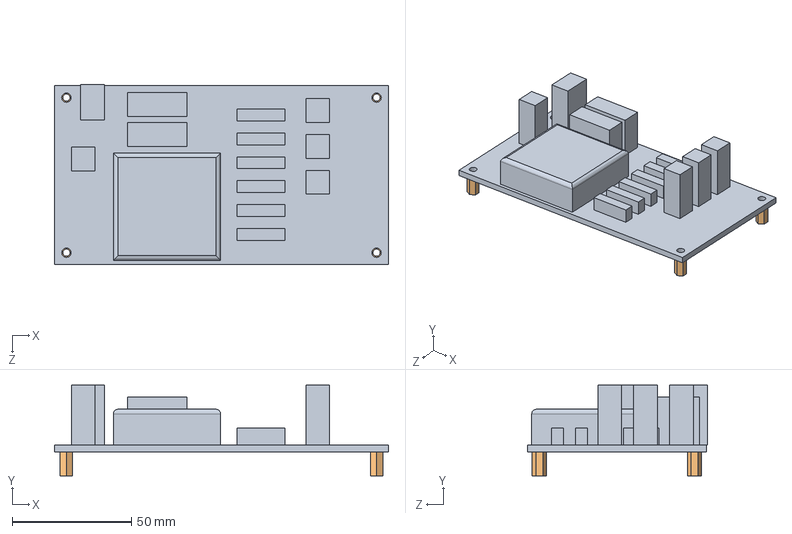
[picture p211: CAD file, 2013-05-17]
Meca/Cartes Electronique/Cartes_Assemblées_Entretoises/carte_puissance_2_entretoises.SLDASM
140.0 x 38.0 x 75.5 mm
carte_puissance_2
entretoise_M3_L10 x 4
