massinissalounis/oufffteam/Meca/Pieces_detachees/Codeur/Codeur_2MRH.SLDASM

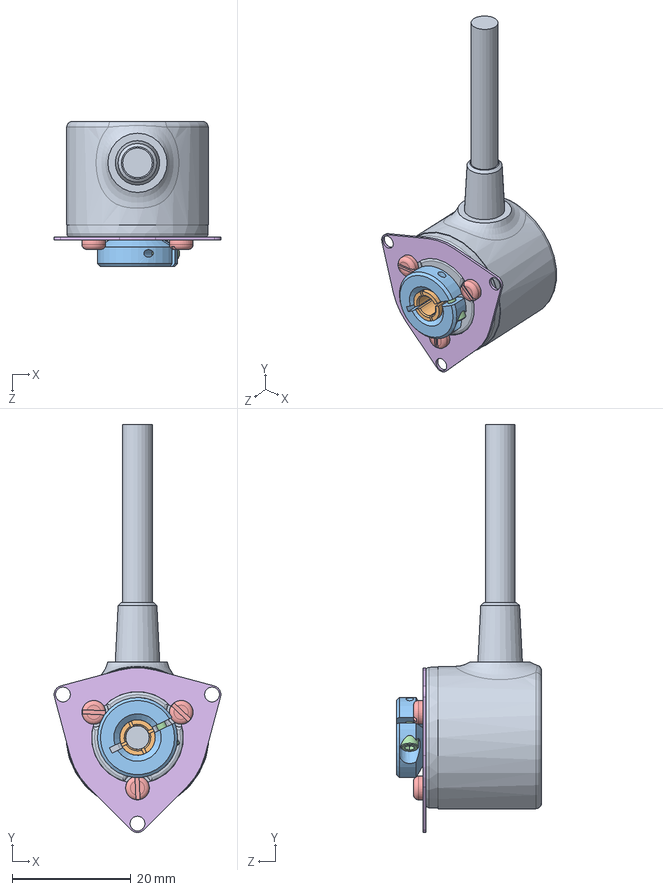
[picture p212: CAD file, 2013-05-17]
Meca/Pieces_detachees/Codeur/Codeur_2MRH.SLDASM
28.1 x 68.8 x 24.5 mm
corps_codeur_2MRH
mandrin_codeur_2MRH
bague_codeur_2MRH
Socket Head Cap Screw_AM
Pan Slot Head_AM x 3
Bride_membrane
