massinissalounis/oufffteam/Meca/Plans Robot 2013/Sous ensembles Robot/Mat_Balise/mat_balise._camera.SLDASM

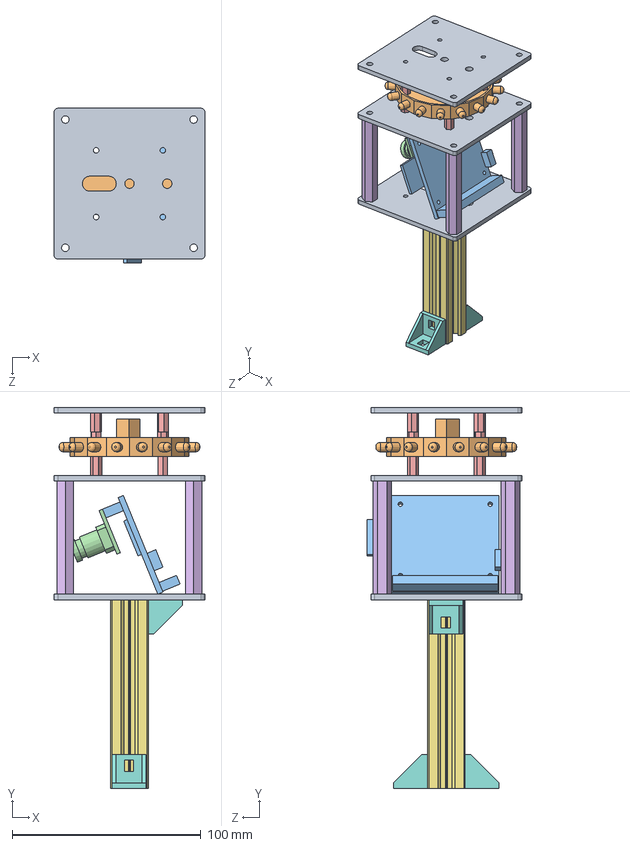
[picture p214: CAD file, 2013-05-17]
Meca/Plans Robot 2013/Sous ensembles Robot/Mat_Balise/mat_balise._camera.SLDASM
80.0 x 202.0 x 81.9 mm
plaque_support_80x80 x 3
Recepteur_IR
Support_carte_CMUCam
Optique_Cmucam
entretoise_M3_L10 x 12
entretoise_M5_L60 x 4
Profilé Aluminium Rexroth 20x20 L100
CornerXD_Rexroth_18x18 x 3
