massinissalounis/oufffteam/Meca/Plans Robot 2013/Sous ensembles Robot/Portes_capteurs/capteur_front_champ_45deg.SLDASM

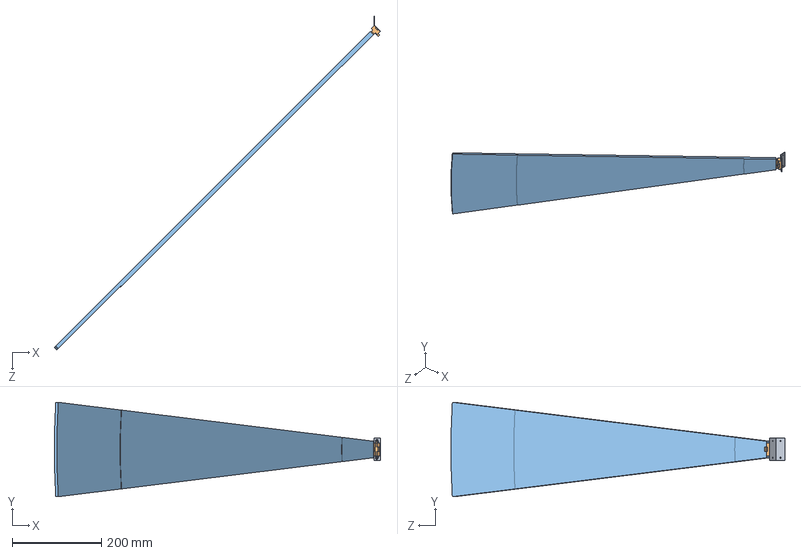
[picture p215: CAD file, 2013-05-17]
Meca/Plans Robot 2013/Sous ensembles Robot/Portes_capteurs/capteur_front_champ_45deg.SLDASM
729.7 x 211.2 x 747.1 mm
corniere_angle45_H50_l20
GP2D12
champ_GP2D12
