massinissalounis/oufffteam/Meca/Plans Robot 2013/Sous ensembles Robot/Portique_elevateur/portique_elevateur_2.SLDASM

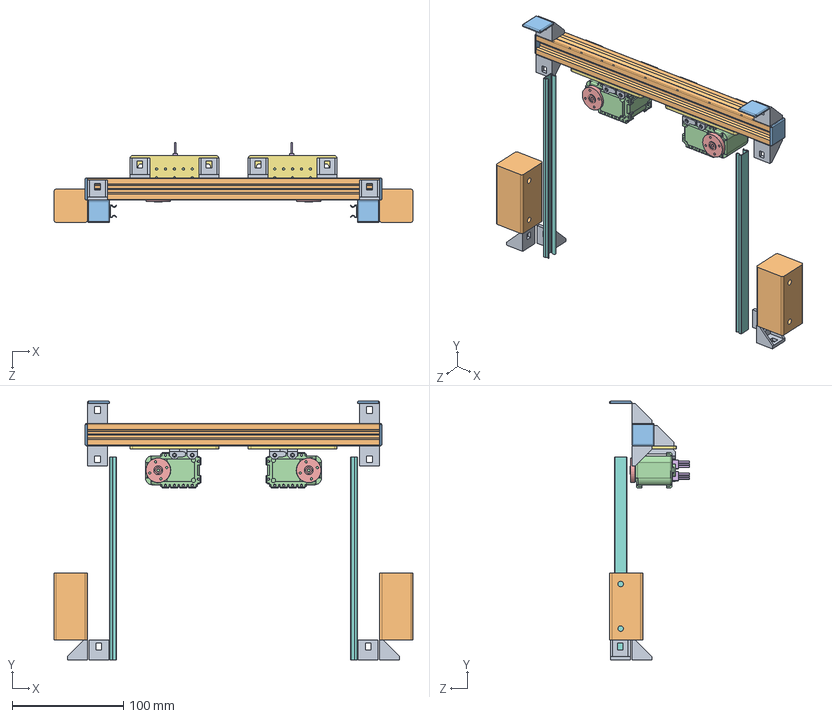
[picture p216: CAD file, 2013-05-17]
Meca/Plans Robot 2013/Sous ensembles Robot/Portique_elevateur/portique_elevateur_2.SLDASM
322.0 x 232.0 x 71.7 mm
CornerXD_Rexroth_18x18 x 12
Profilé Aluminium Rexroth 20x20 L262
bouchonXD_Rexroth_20x20 x 4
AX-12_modif x 2
attache_ax-12 x 2
connecteur_AX-12 x 4
fixation_AX12 x 2
glissiere_male_Hettish_L182 x 2
F3 x 2
Contrepoids_côté_L60_l30_h30 x 2
