massinissalounis/oufffteam/Meca/Table_2012/Plans_table_menuiserie/Terrain_9_Partie_1.SLDASM

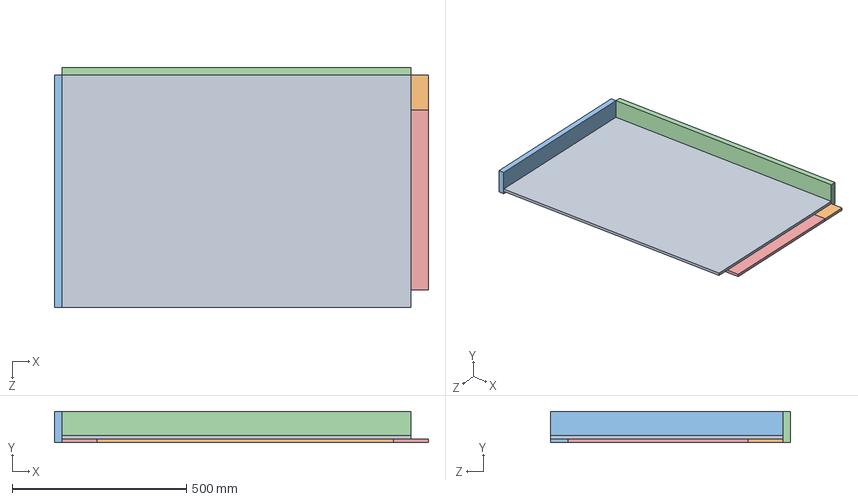
[picture p218: CAD file, 2013-05-17]
Meca/Table_2012/Plans_table_menuiserie/Terrain_9_Partie_1.SLDASM
1072.0 x 90.0 x 689.0 mm
planche_1000x667x10
planche_1050x100x10
planche_667x90x22
planche_1000x90x22
planche_517x100x10 x 2
