massinissalounis/oufffteam/Balises/Balises_SICK/Meca/Balise_Principale/Pilier_top_sick.SLDASM

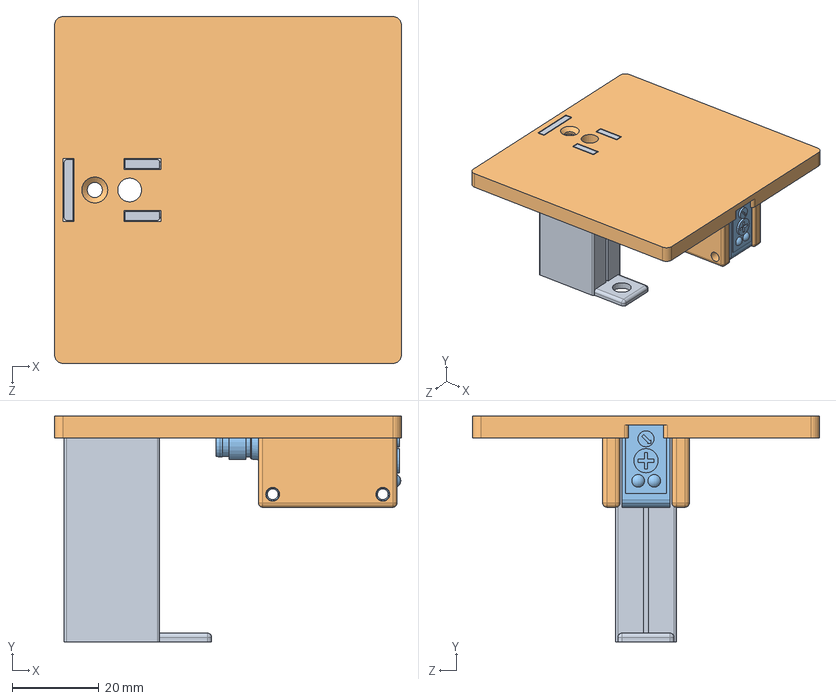
[picture p219: CAD file, 2013-06-14]
Balises/Balises_SICK/Meca/Balise_Principale/Pilier_top_sick.SLDASM
80.0 x 52.0 x 80.0 mm
Pilier
Plaque_top
SICK WL100-N4439-Bestell-Nr_6028604(0)-1
