massinissalounis/oufffteam/Meca/Pieces_detachees/Engrenages/test_pigon_cremaillere.SLDASM

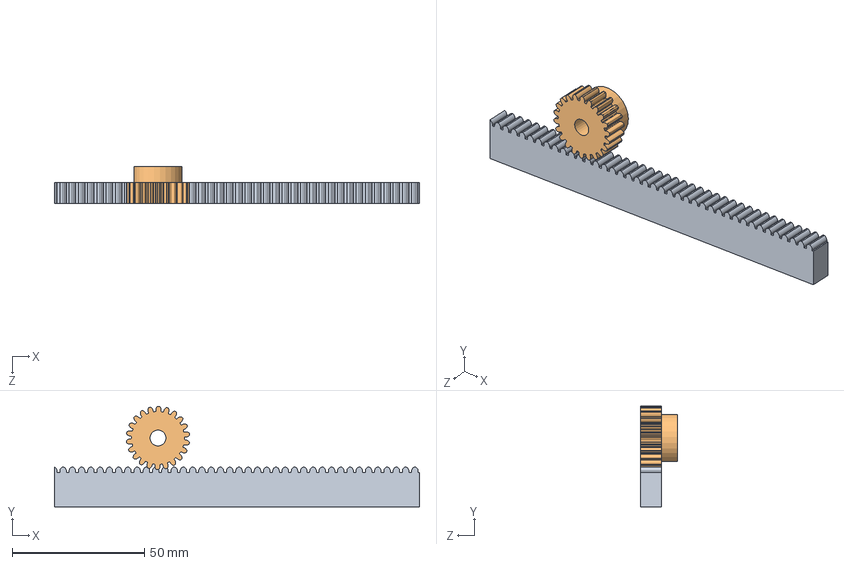
[picture p220: CAD file, 2013-05-17]
Meca/Pieces_detachees/Engrenages/test_pigon_cremaillere.SLDASM
138.0 x 38.0 x 14.0 mm
cremaillere_HPC_L138_module1
pignon_HPC_D24_Z22_M6
