massinissalounis/oufffteam/Meca/Plans Robot 2013/Petit robot/Robot_2011/Travaux patrick/motorisation pat/version 2011/version 2011-2/glissière.SLDASM

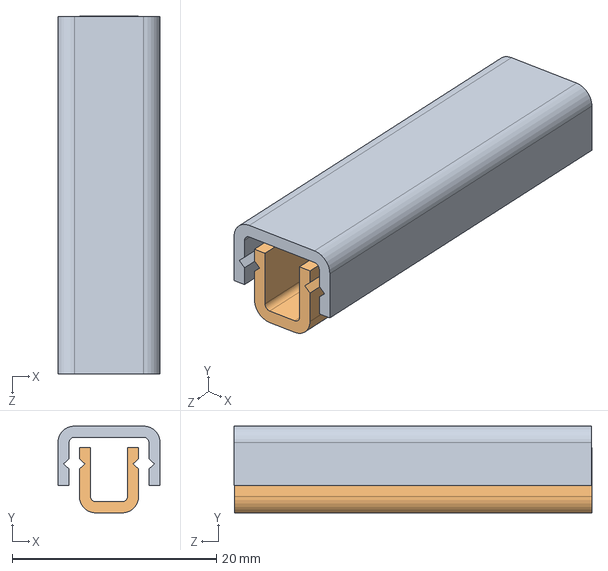
[picture p222: CAD file, 2013-05-17]
Meca/Plans Robot 2013/Petit robot/Robot_2011/Travaux patrick/motorisation pat/version 2011/version 2011-2/glissière.SLDASM
10.0 x 8.50 x 35.0 mm
glissière femelle
glissière male
