massinissalounis/oufffteam/Meca/Plans Robot 2013/Petit robot/support bille/Assemblage1.SLDASM

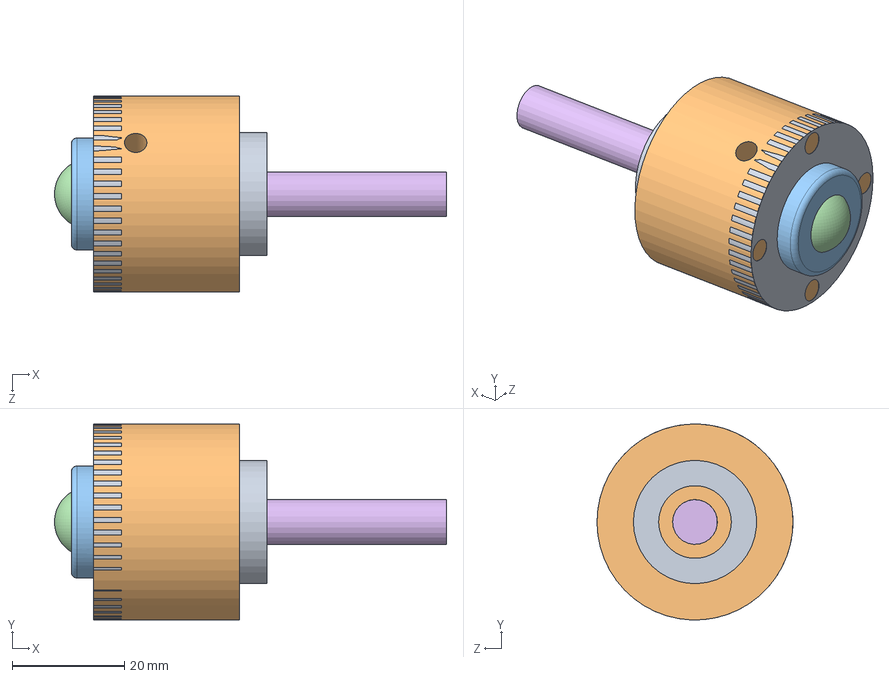
[picture p223: CAD file, 2013-05-17]
Meca/Plans Robot 2013/Petit robot/support bille/Assemblage1.SLDASM
70.0 x 35.0 x 35.0 mm
corps
pièce de réglage en hauteur
Roulette D20
bille D12_5
ressort compressé
axe prolongateur
