massinissalounis/oufffteam/Meca/Plans Robot 2013/Sous ensembles Robot/Portes_capteurs/capteur_front.SLDASM

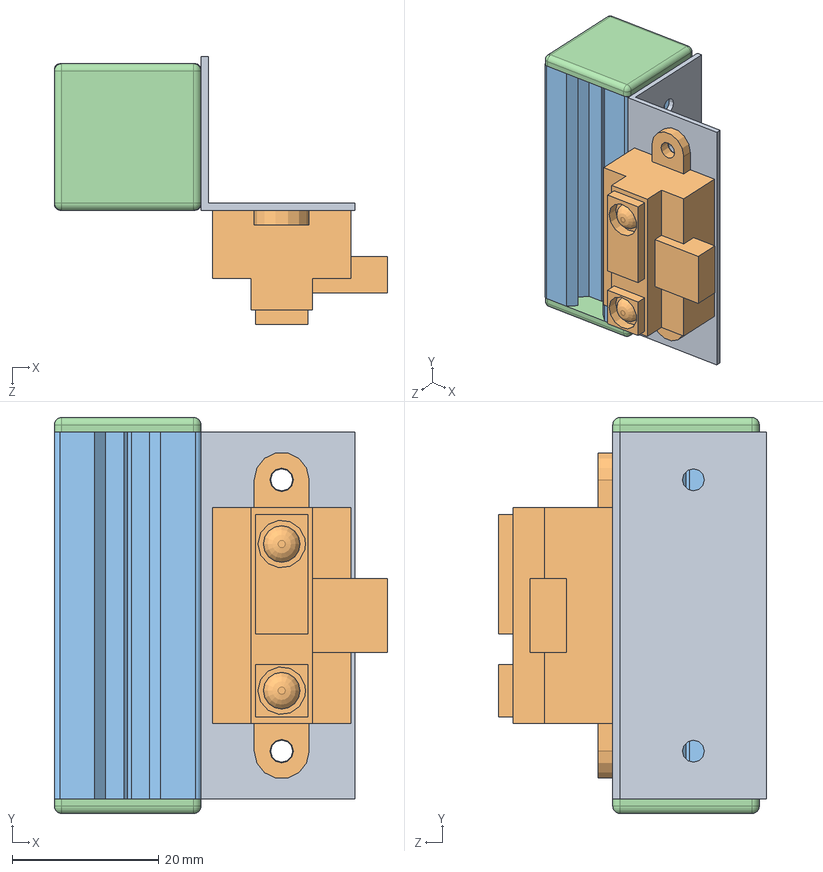
[picture p224: CAD file, 2013-05-17]
Meca/Plans Robot 2013/Sous ensembles Robot/Portes_capteurs/capteur_front.SLDASM
45.5 x 54.0 x 36.6 mm
corniere_angle90_H50_l20
GP2D12
Profilé Aluminium Rexroth 20x20 L50
bouchonXD_Rexroth_20x20 x 2
