massinissalounis/oufffteam/Meca/Table_2012/Elements_Mobiles_Table/porte_message_rouge.SLDASM

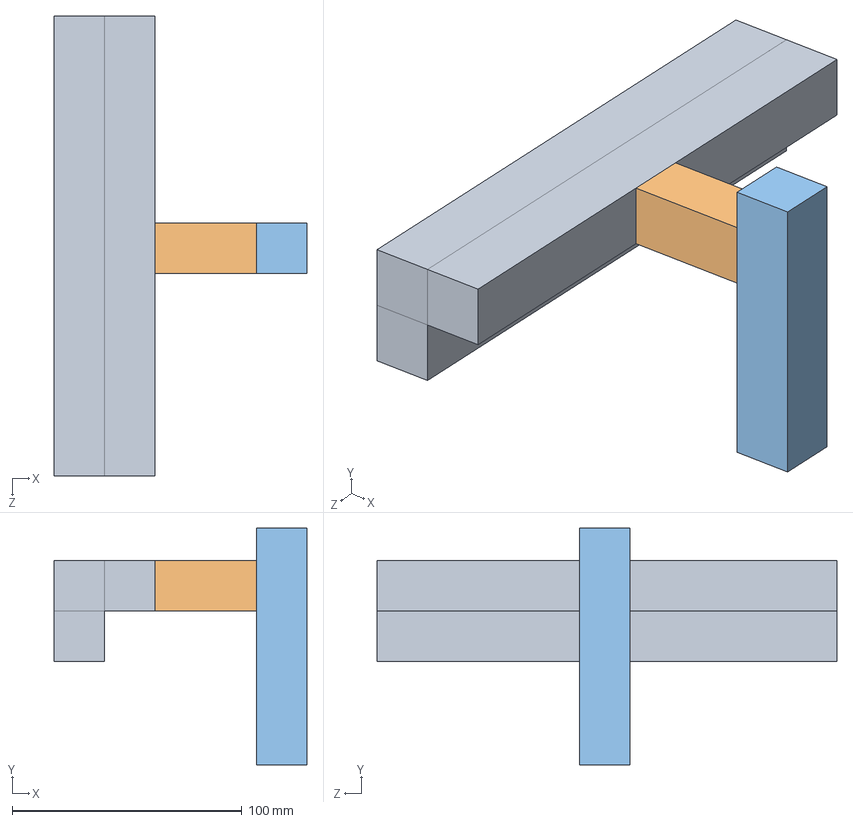
[picture p225: CAD file, 2013-05-17]
Meca/Table_2012/Elements_Mobiles_Table/porte_message_rouge.SLDASM
110.0 x 103.0 x 200.0 mm
linteau_22x22_L200_rouge x 3
linteau_22x22_L44_rouge
linteau_22x22_L103_rouge
