massinissalounis/oufffteam/Meca/Table_2013/Elements_Jeu/Bougie_complete_Rouge.SLDASM

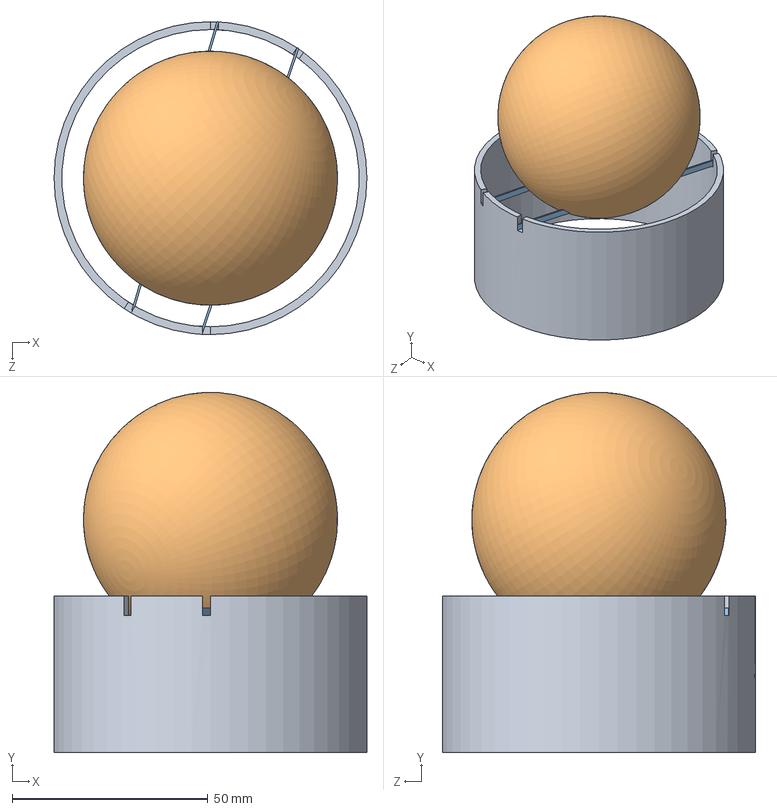
[picture p226: CAD file, 2013-05-17]
Meca/Table_2013/Elements_Jeu/Bougie_complete_Rouge.SLDASM
80.0 x 92.1 x 80.1 mm
Bougie_Rouge
Balle_Tennis_2
bout_d'élastique_bougies x 2
