massinissalounis/oufffteam/Meca/Plans Robot 2013/Petit robot/Petit_robot_V1.SLDASM

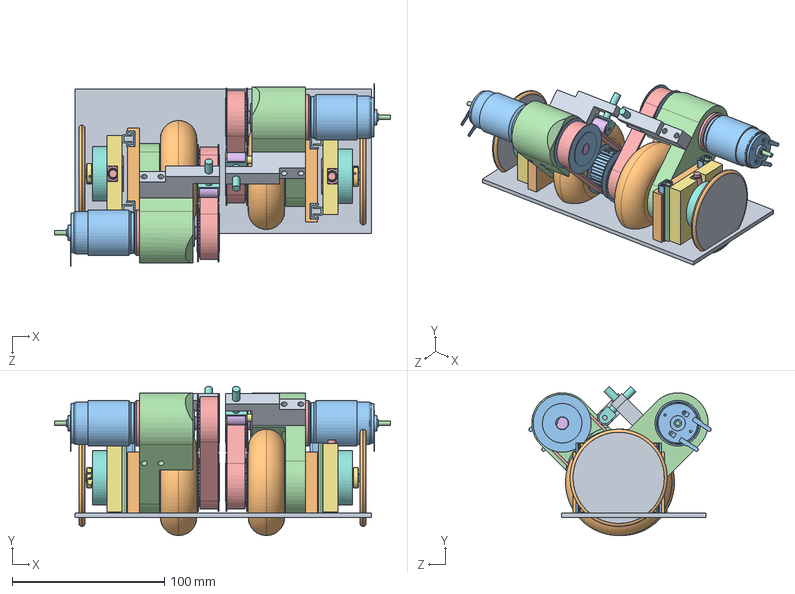
[picture p227: CAD file, 2013-05-17]
Meca/Plans Robot 2013/Petit robot/Petit_robot_V1.SLDASM
221.0 x 98.1 x 120.0 mm
Base
Pièce3- x 2
glissière femelle_L46- x 4
glissière male_L46- x 4
corps_codeur_2MRH x 2
mandrin_codeur_2MRH x 2
bague_codeur_2MRH x 2
Bride_membrane x 2
Roue_codeuse_D30- x 2
joint_D64- x 2
corps_moteur_faulhauber_3042W024C x 2
arbre_moteur_faulhauber_3042W024C x 2
corps_reducteur_faulhaber_30_1 x 2
arbre_reducteur_faulhauber_30_1 x 2
Pièce2 x 2
cloche x 2
axe roue de roller pat_2 x 2
roue_roller pleinePat x 2
poulie roue D38,10 L15 HPC x 4
bras moteur- x 2
courroie- x 2
galet x 2
poussoir x 2
pont x 2
