massinissalounis/oufffteam/Meca/Plans Robot 2013/Petit robot/Robot_2011/Travaux patrick/Base roulante/fixation bille.SLDASM

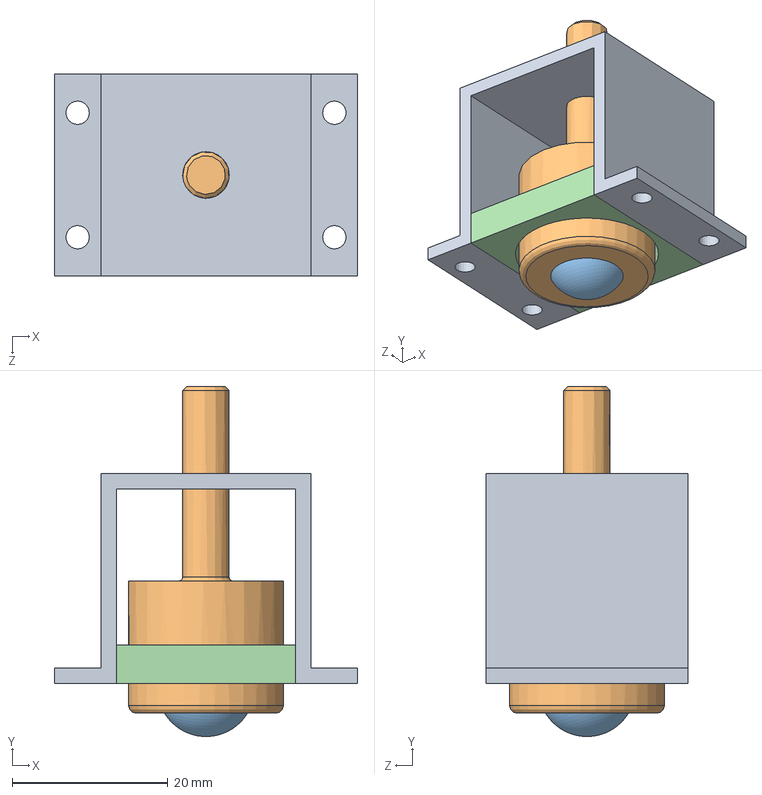
[picture p229: CAD file, 2013-05-17]
Meca/Plans Robot 2013/Petit robot/Robot_2011/Travaux patrick/Base roulante/fixation bille.SLDASM
39.0 x 45.0 x 26.0 mm
Fixation bille
Roulette D20
bille D12_5
Guide_roulette
