massinissalounis/oufffteam/Meca/Plans Robot 2013/Petit robot/Robot_2011/Travaux patrick/motorisation rémi/Motorisation/Bloc Codeur/Bloc_codeur.SLDASM

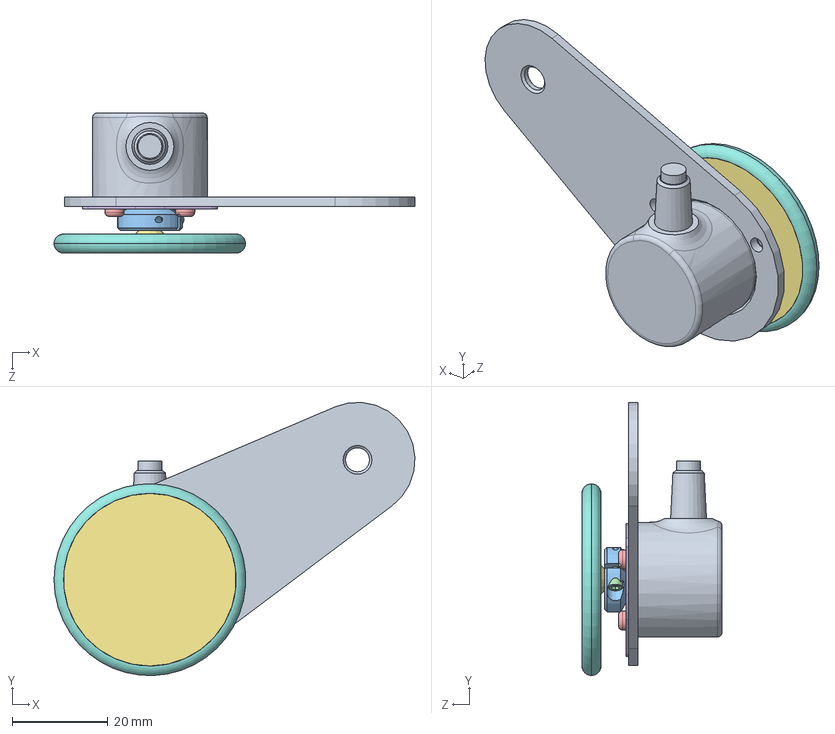
[picture p230: CAD file, 2013-05-17]
Meca/Plans Robot 2013/Petit robot/Robot_2011/Travaux patrick/motorisation rémi/Motorisation/Bloc Codeur/Bloc_codeur.SLDASM
75.3 x 56.9 x 29.2 mm
corps_codeur_2MRH
mandrin_codeur_2MRH
bague_codeur_2MRH
Socket Head Cap Screw_AM
Vis_fendue_tete_bombee_M2_L5 x 3
Bride_membrane
Roue_codeuse
joint_D40
Plaque_support
