massinissalounis/oufffteam/Meca/Plans Robot 2013/Robot_principal_V2_arceaux V2.SLDASM

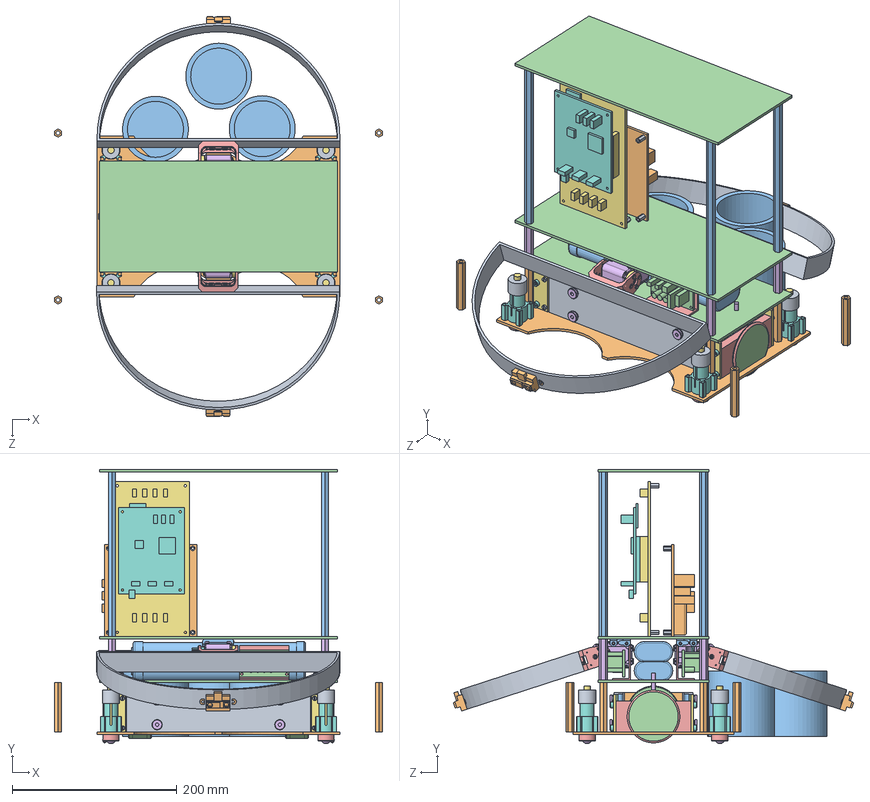
[picture p231: CAD file, 2013-05-17]
Meca/Plans Robot 2013/Robot_principal_V2_arceaux V2.SLDASM
398.1 x 333.0 x 486.0 mm
support glissière_2 x 2
cloche _2 x 2
glissière femelle_L46 x 4
glissière male_L46 x 4
porte codeur_2 x 2
corps_moteur_faulhauber_3042W024C x 2
arbre_moteur_faulhauber_3042W024C x 2
corps_reducteur_faulhaber_30_1 x 2
arbre_reducteur_faulhauber_30_1 x 2
roue modélisme-V4 x 2
bride roue modélisme-V4 x 2
pneu modélisme x 2
vis roue x 4
corps_codeur_2MRH x 2
mandrin_codeur_2MRH x 2
bague_codeur_2MRH x 2
Vis_CHC_M2_L5 x 2
Vis_fendue_tete_bombee_M2_L5 x 6
Bride_membrane x 2
Roue_codeuse_D30 x 2
joint_D64 x 2
vis_centrage x 8
contre plaque glissière_2 x 4
Vis_CHC_M4_L10 x 8
Vis_fendue_M3_L5 x 8
Base
batterie_10elements x 2
ressort compressé x 4
Roulette D20 x 4
bille D12_5 x 4
tige filetée M8 x 4
alésage porte bille x 4
Ecrou réglage hauteur x 4
entretoise_M5_L60 x 8
verre x 3
Etagère x 3
F2 x 2
AX-12_modif x 2
attache_ax-12 x 2
connecteur_AX-12 x 4
Arceau2 x 2
GP2D12 x 2
F3 x 2
carte_hacheur x 2
Support carte hacheur x 2
entretoise_M5_L50 x 4
carte_interface_4
carte_PIC32_FPGA
entretoise_M3_L10 x 8
carte_puissance_3
entretoise_M5_L200 x 4
