massinissalounis/oufffteam/Meca/Plans Robot 2013/Sous ensembles Robot/Pince/essai_assemblage_pince_3_droite.SLDASM

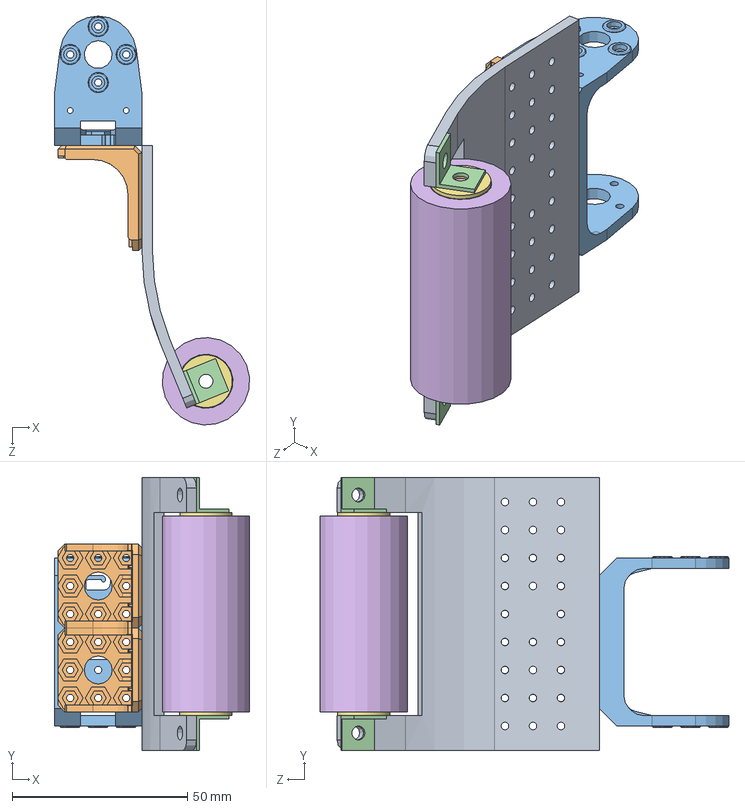
[picture p232: CAD file, 2013-05-17]
Meca/Plans Robot 2013/Sous ensembles Robot/Pince/essai_assemblage_pince_3_droite.SLDASM
55.7 x 78.0 x 116.8 mm
essai_pince_6
F9ORG x 2
F2
corniere_10x10 x 2
Rouleau_Laiton_D15_H56
Rouleau_D25_H56
Rondelle_M5_Large x 2
