massinissalounis/oufffteam/Balises/Balises_SICK/Meca/Balise_Principale/Balise_principale.SLDASM

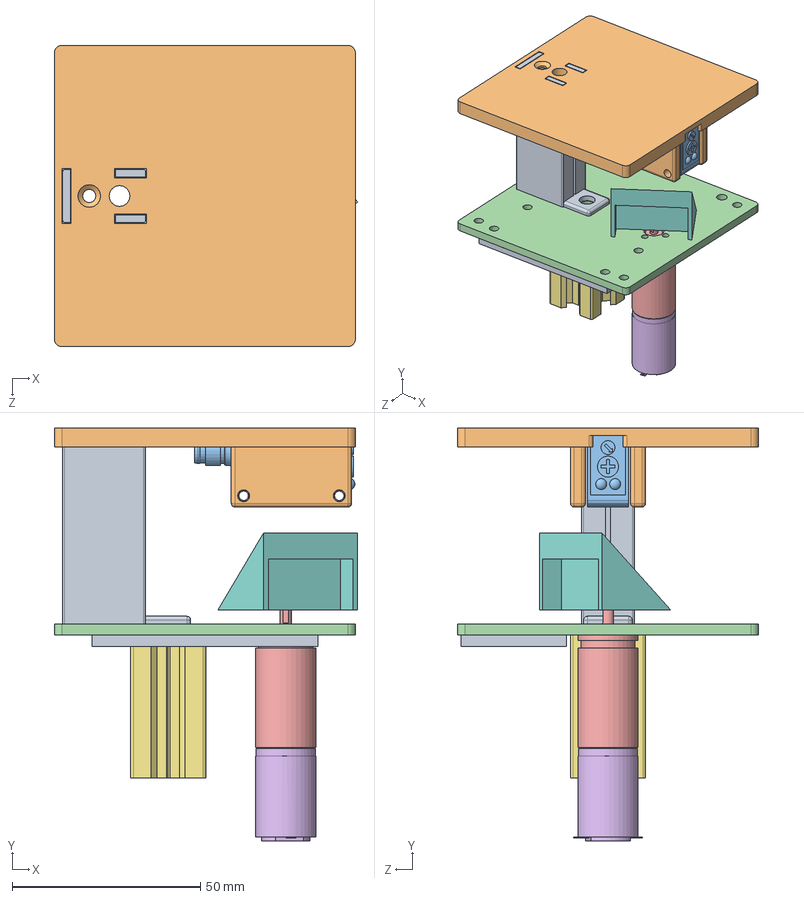
[picture p233: CAD file, 2013-06-14]
Balises/Balises_SICK/Meca/Balise_Principale/Balise_principale.SLDASM
80.6 x 109.7 x 80.0 mm
Pilier
Plaque_top
SICK WL100-N4439-Bestell-Nr_6028604(0)-1
Plaque_bottom
15_5 3stages
1624S
