massinissalounis/oufffteam/Meca/Plans Robot 2013/Petit robot/Robot_2011/Structure/essai_architecture_3.SLDASM

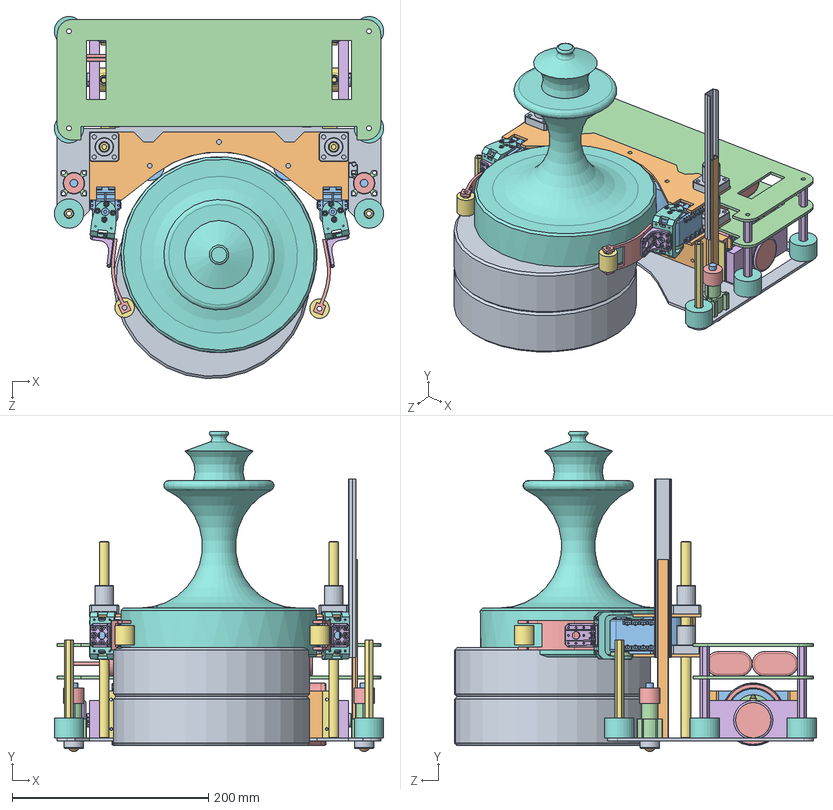
[picture p234: CAD file, 2013-05-17]
Meca/Plans Robot 2013/Petit robot/Robot_2011/Structure/essai_architecture_3.SLDASM
336.0 x 326.5 x 369.2 mm
plateforme_base_V3
support glissière x 2
cloche pour V4 x 2
glissière femelle x 4
glissière male x 4
porte codeur x 2
corps_moteur_faulhauber_3042W024C x 2
arbre_moteur_faulhauber_3042W024C x 2
corps_reducteur_faulhaber_30_1 x 2
arbre_reducteur_faulhauber_30_1 x 2
roue modélisme-V4 x 2
bride roue modélisme-V4 x 2
pneu modélisme x 2
vis roue x 4
corps_codeur_2MRH x 2
mandrin_codeur_2MRH x 2
bague_codeur_2MRH x 2
Socket Head Cap Screw_AM x 2
Vis_fendue_tete_bombee_M2_L5 x 6
Bride_membrane x 2
Roue_codeuse x 2
joint_D40 x 2
contre plaque glissière x 4
ressort compressé x 2
Roulette D20 x 2
bille D12_5 x 2
tige filetée M8 x 2
alésage porte bille x 2
Ecrou réglage hauteur x 2
entretoise_M5_L60 x 4
entretoise_M5_L100 x 2
Rouleau_D30_H20 x 6
Pion x 2
essai_plaque_elevatrice_1 x 2
AX-12_modif x 2
attache_ax-12 x 2
essai_pince_4 x 2
F9ORG x 2
Rouleau_D20_H20 x 2
F2 x 2
Douille_Colerette_Igus_M10 x 4
entretoise_M5_L38 x 3
Rouleau_D30_H36 x 2
plaque_plastique_L330_l123_decoupe x 2
batterie_10elements x 2
entretoise_M5_L30 x 4
arbre_guidage_D10_L200 x 2
roi_reine
glissiere_femelle_Hettish_L182
glissiere_male_Hettish_L182
