massinissalounis/oufffteam/Meca/Plans Robot 2013/Petit robot/Robot_2011/Travaux patrick/Base roulante/Base roulante.SLDASM

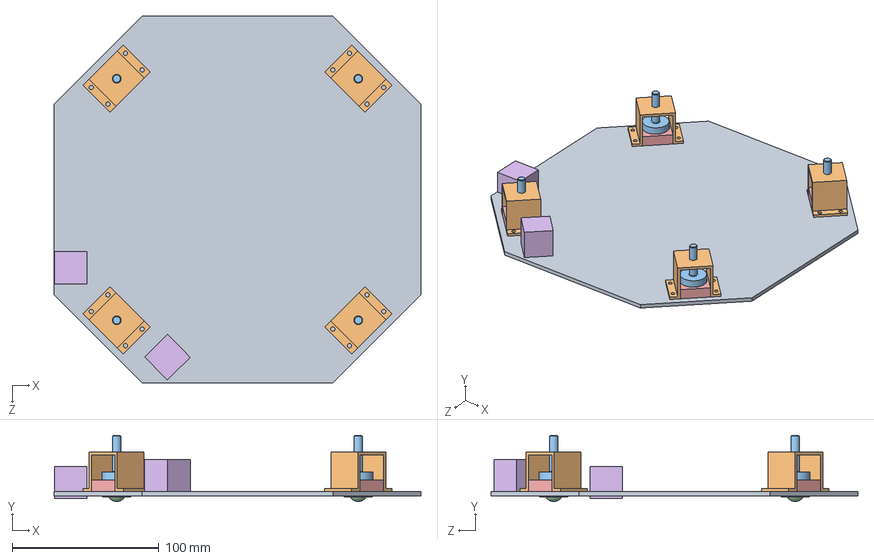
[picture p235: CAD file, 2013-05-17]
Meca/Plans Robot 2013/Petit robot/Robot_2011/Travaux patrick/Base roulante/Base roulante.SLDASM
250.0 x 45.0 x 250.0 mm
fond_hexagonal
Fixation bille x 4
Roulette D20 x 4
bille D12_5 x 4
Guide_roulette x 4
simu_profilé x 2
