massinissalounis/oufffteam/Meca/Plans Robot 2013/Sous ensembles Robot/Portes_capteurs/test_porte_capteur_2.SLDASM

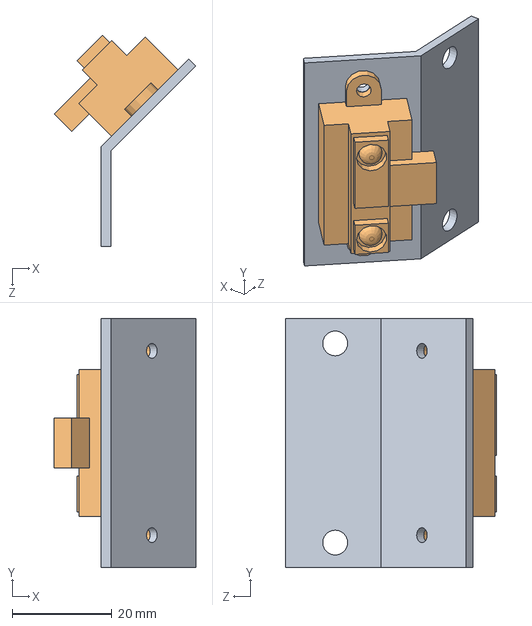
[picture p236: CAD file, 2013-05-17]
Meca/Plans Robot 2013/Sous ensembles Robot/Portes_capteurs/test_porte_capteur_2.SLDASM
28.5 x 50.0 x 42.4 mm
Attache_A45_L50_h50
GP2D12
