massinissalounis/oufffteam/Meca/Pieces_detachees/Porte_bille_reglable/porte_bille_reglable.SLDASM

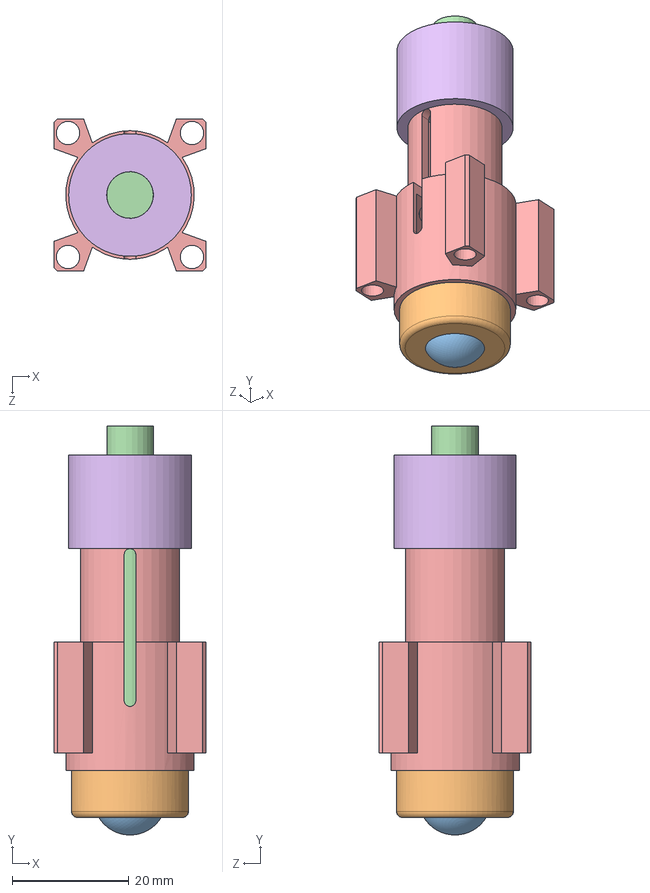
[picture p237: CAD file, 2013-05-17]
Meca/Pieces_detachees/Porte_bille_reglable/porte_bille_reglable.SLDASM
26.0 x 70.0 x 26.0 mm
ressort compressé
Roulette D20
bille D12_5
tige filetée M8
alésage porte bille
Ecrou réglage hauteur
