massinissalounis/oufffteam/Meca/Plans Robot 2013/Petit robot/Robot_2011/Travaux patrick/Base roulante/Roulette à bille 687-679.SLDASM

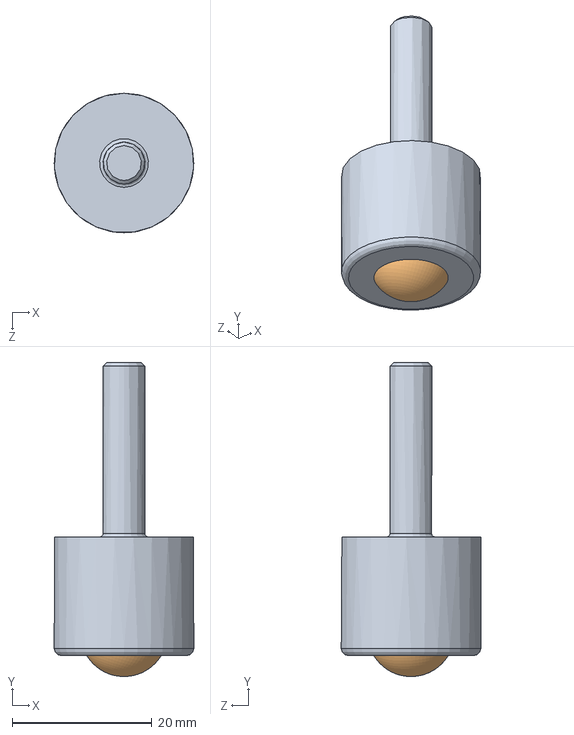
[picture p239: CAD file, 2013-05-17]
Meca/Plans Robot 2013/Petit robot/Robot_2011/Travaux patrick/Base roulante/Roulette à bille 687-679.SLDASM
20.0 x 45.0 x 20.0 mm
Roulette D20
bille D12_5
