massinissalounis/oufffteam/Meca/Plans Robot 2013/Petit robot/Robot_2011/Travaux patrick/version 2011-4/Roue.SLDASM

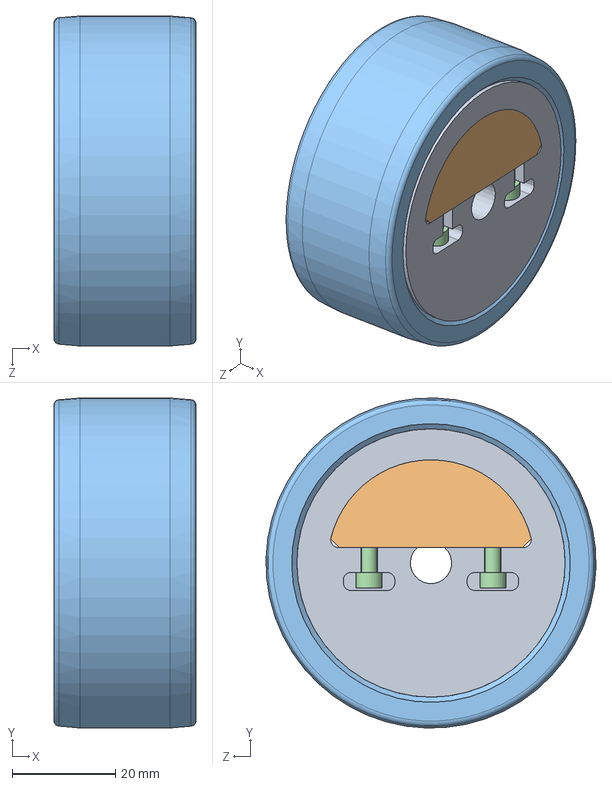
[picture p240: CAD file, 2013-05-17]
Meca/Plans Robot 2013/Petit robot/Robot_2011/Travaux patrick/version 2011-4/Roue.SLDASM
27.5 x 64.0 x 64.0 mm
roue modélisme-V4
bride roue modélisme-V4
pneu modélisme
vis roue x 2
