massinissalounis/oufffteam/Meca/Cartes Electronique/Plaque_electronique.SLDASM

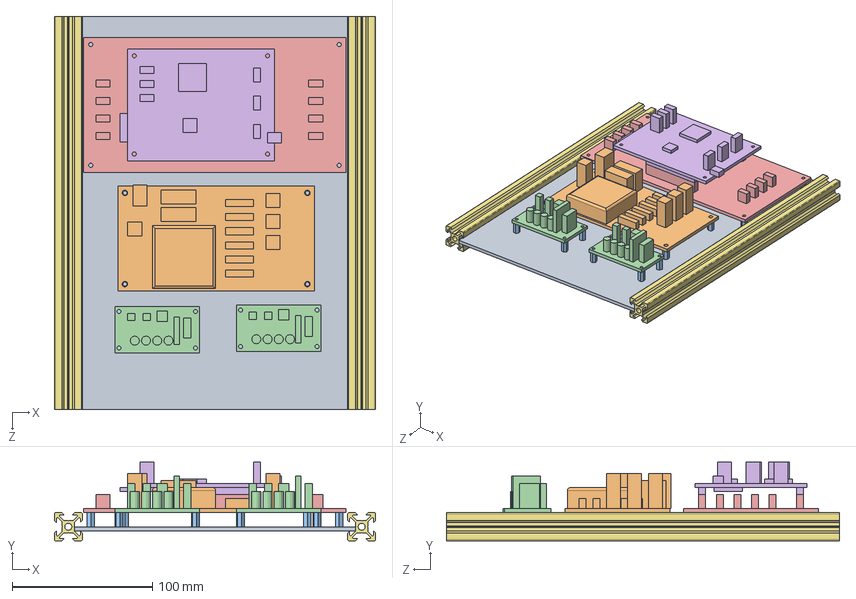
[picture p241: CAD file, 2013-05-17]
Meca/Cartes Electronique/Plaque_electronique.SLDASM
229.0 x 56.0 x 280.0 mm
plaque_support_verticale_V1
carte_puissance_2
entretoise_M3_L10 x 16
carte_hacheur x 2
carte_interface_3
carte_PIC32_FPGA
Profilé Aluminium Rexroth 20x20 L280 x 2
