massinissalounis/oufffteam/Meca/Plans Robot 2013/Copie de Robot_principal_V1.SLDASM

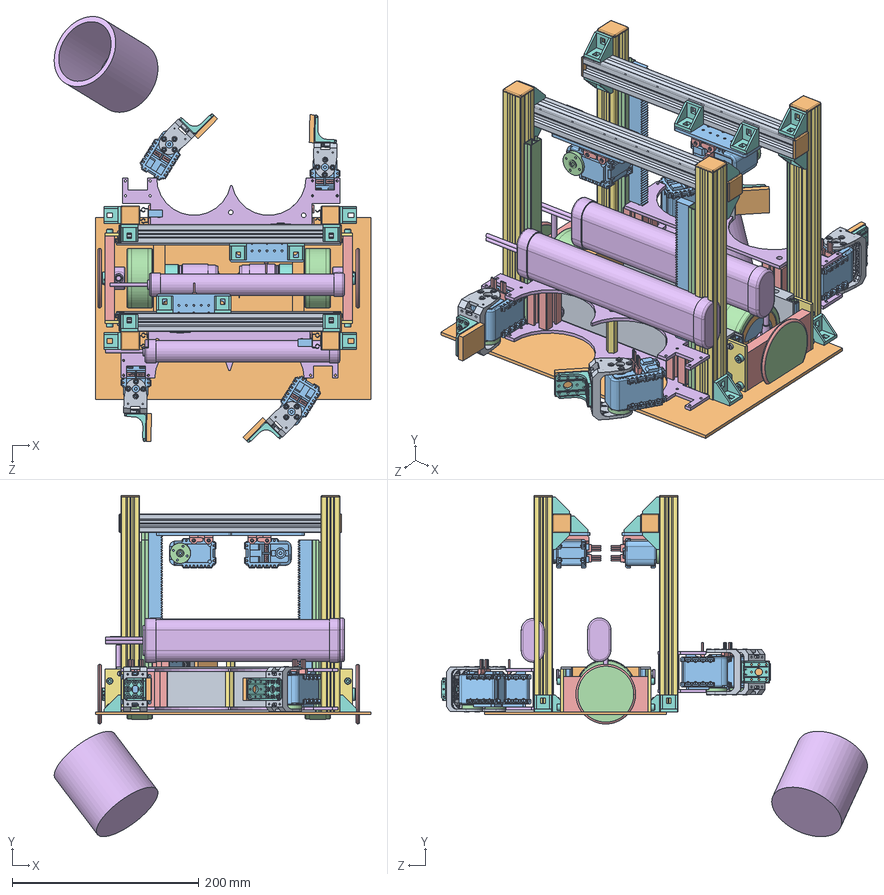
[picture p243: CAD file, 2013-05-17]
Meca/Plans Robot 2013/Copie de Robot_principal_V1.SLDASM
339.4 x 365.8 x 456.5 mm
support glissière_2 x 2
cloche _2 x 2
glissière femelle_L46 x 4
glissière male_L46 x 4
porte codeur_2 x 2
corps_moteur_faulhauber_3042W024C x 2
arbre_moteur_faulhauber_3042W024C x 2
corps_reducteur_faulhaber_30_1 x 2
arbre_reducteur_faulhauber_30_1 x 2
roue modélisme-V4 x 2
bride roue modélisme-V4 x 2
pneu modélisme x 2
vis roue x 4
corps_codeur_2MRH x 2
mandrin_codeur_2MRH x 2
bague_codeur_2MRH x 2
Vis_CHC_M2_L5 x 2
Vis_fendue_tete_bombee_M2_L5 x 6
Bride_membrane x 2
Roue_codeuse_D30 x 2
joint_D64 x 2
vis_centrage x 8
contre plaque glissière_2 x 4
Vis_CHC_M4_L10 x 8
Vis_fendue_M3_L5 x 8
Base
AX-12_modif x 6
attache_ax-12 x 6
connecteur_AX-12 x 12
essai_plaque_elevatrice_3 x 4
entretoise_M5_L38 x 2
F9ORG x 4
F2 x 4
Bout_de_mousse x 4
cremaillere_HPC_L138_module1 x 2
glissiere_femelle_Hettish_L182 x 2
Profilé Aluminium 22x22 L38 x 4
Profilé Aluminium Rexroth 20x20 L230 x 4
CornerXD_Rexroth_18x18 x 20
Profilé Aluminium Rexroth 20x20 L262 x 2
bouchonXD_Rexroth_20x20 x 8
fixation_AX12 x 2
glissiere_male_Hettish_L182 x 4
F3 x 2
batterie_10elements x 2
