massinissalounis/oufffteam/Meca/Plans Robot 2013/Outil arceau.SLDASM

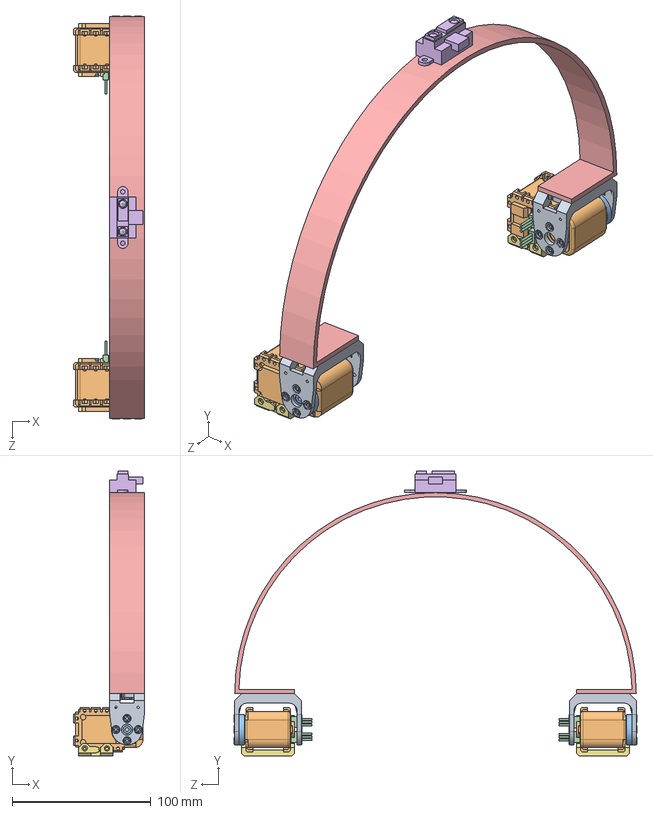
[picture p245: CAD file, 2013-05-17]
Meca/Plans Robot 2013/Outil arceau.SLDASM
51.0 x 205.1 x 289.8 mm
F2 x 2
AX-12_modif x 2
attache_ax-12 x 2
connecteur_AX-12 x 4
Arceau
GP2D12
F3 x 2
