massinissalounis/oufffteam/Meca/Plans Robot 2013/Sous ensembles Robot/Pince/essai_assemblage_pince_1.SLDASM

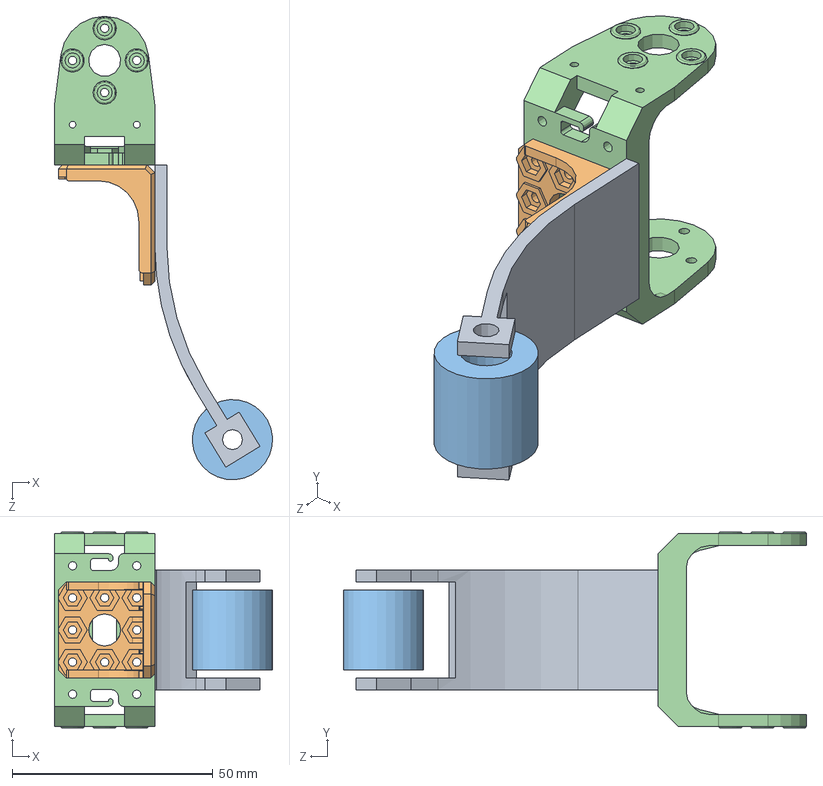
[picture p247: CAD file, 2013-05-17]
Meca/Plans Robot 2013/Sous ensembles Robot/Pince/essai_assemblage_pince_1.SLDASM
54.3 x 48.8 x 115.5 mm
essai_pince_4
F9ORG
Rouleau_D20_H20
F2
