massinissalounis/oufffteam/Meca/Plans Robot 2013/Sous ensembles Robot/Portes_capteurs/test_porte_capteur_1.SLDASM

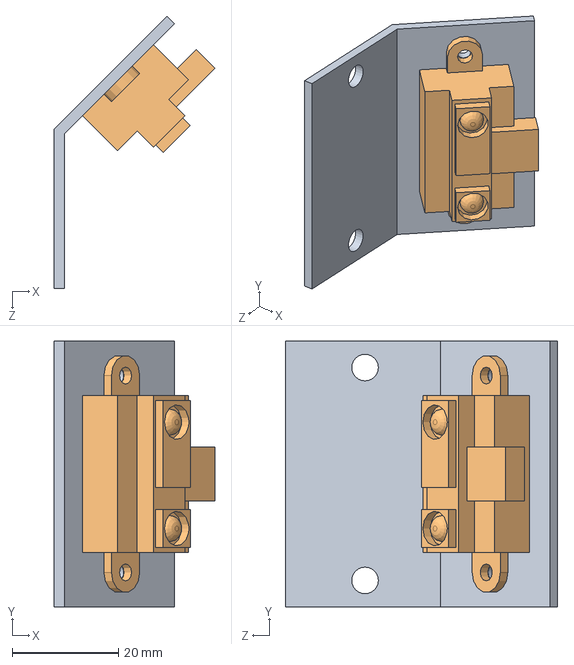
[picture p248: CAD file, 2013-05-17]
Meca/Plans Robot 2013/Sous ensembles Robot/Portes_capteurs/test_porte_capteur_1.SLDASM
30.2 x 50.0 x 51.2 mm
Attache_A45_L60_h50
GP2D12
