massinissalounis/oufffteam/Meca/Table_2012/Plans_table_menuiserie/Terrain_9_Partie_5.SLDASM

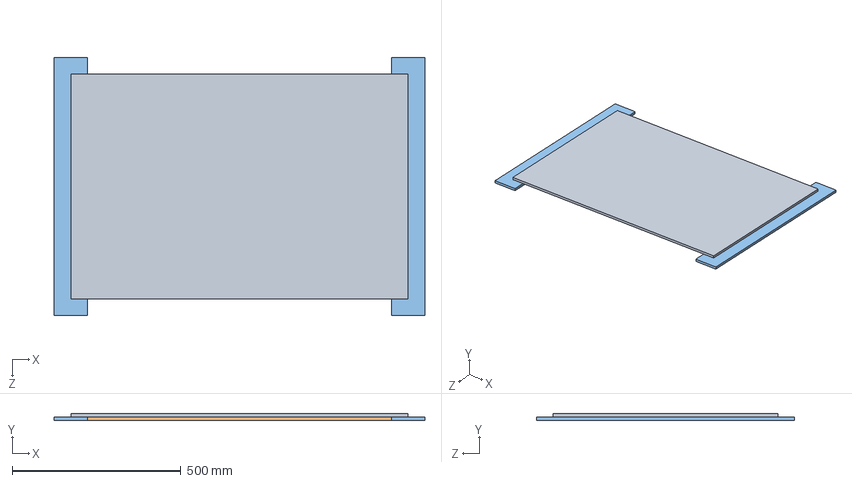
[picture p249: CAD file, 2013-05-17]
Meca/Table_2012/Plans_table_menuiserie/Terrain_9_Partie_5.SLDASM
1100.0 x 20.0 x 766.0 mm
planche_1000x666x10
planche_900x100x10
planche_766x100x10 x 2
