massinissalounis/oufffteam/Meca/Pieces_detachees/Rouleau_coin/rouleau_complet_D25_H20.SLDASM

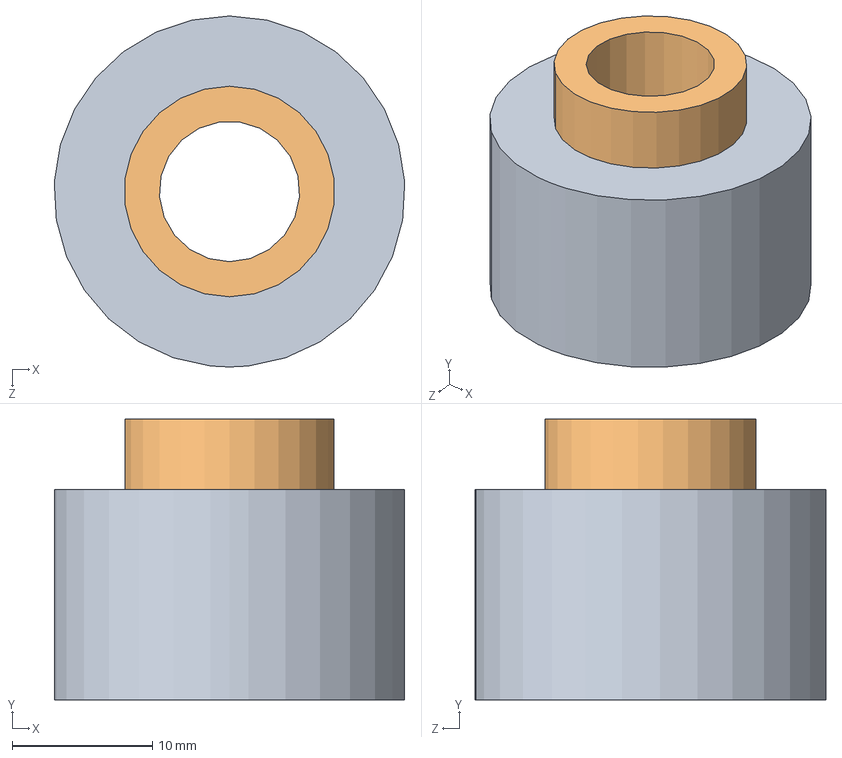
[picture p250: CAD file, 2013-05-17]
Meca/Pieces_detachees/Rouleau_coin/rouleau_complet_D25_H20.SLDASM
25.0 x 20.0 x 25.0 mm
Rouleau_D25_H15
Support_Rouleau_D15_H20
