massinissalounis/oufffteam/Meca/Plans Robot 2013/Petit robot/Assemblage1.SLDASM

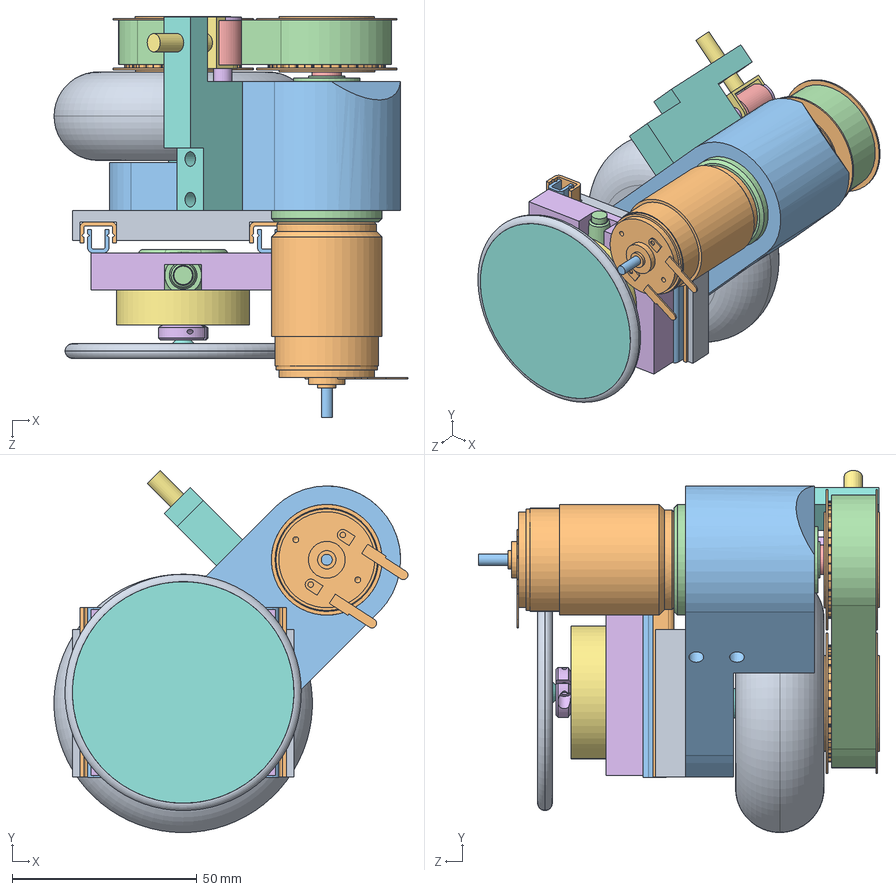
[picture p251: CAD file, 2013-05-17]
Meca/Plans Robot 2013/Petit robot/Assemblage1.SLDASM
95.8 x 98.1 x 108.6 mm
Pièce3-
glissière femelle_L46- x 2
glissière male_L46- x 2
corps_codeur_2MRH
mandrin_codeur_2MRH
bague_codeur_2MRH
Bride_membrane
Roue_codeuse_D30-
joint_D64-
corps_moteur_faulhauber_3042W024C
arbre_moteur_faulhauber_3042W024C
corps_reducteur_faulhaber_30_1
arbre_reducteur_faulhauber_30_1
Pièce2
cloche
axe roue de roller pat_2
roue_roller pleinePat
poulie roue D38,10 L15 HPC x 2
bras moteur-
courroie-
galet
poussoir
pont
