massinissalounis/oufffteam/Meca/Plans Robot 2013/Outil arceau commande centrale.SLDASM

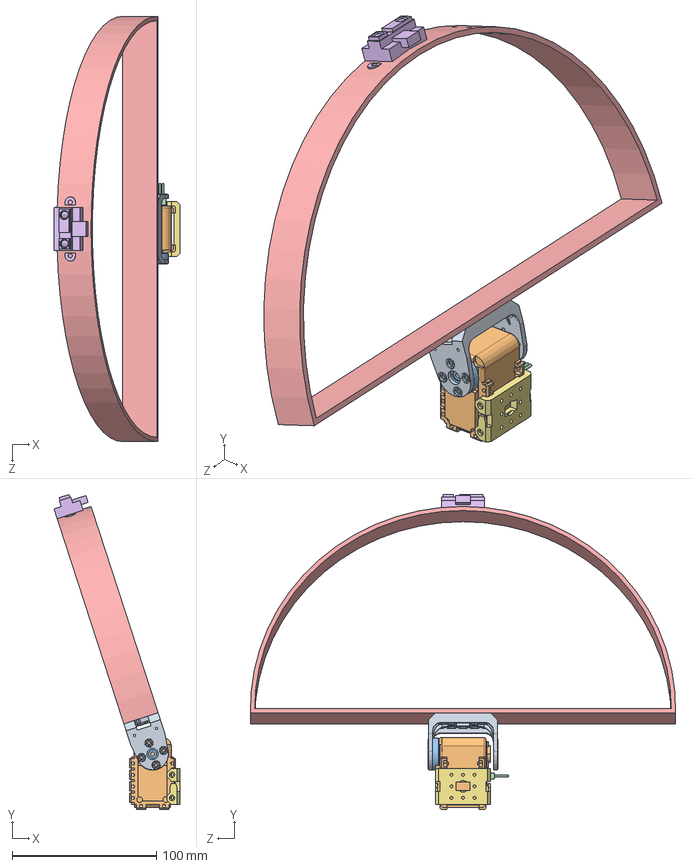
[picture p252: CAD file, 2013-05-17]
Meca/Plans Robot 2013/Outil arceau commande centrale.SLDASM
87.4 x 218.5 x 294.9 mm
F2
AX-12_modif
attache_ax-12
connecteur_AX-12 x 2
Arceau2
GP2D12
F3
