massinissalounis/oufffteam/Meca/Table_2012/Plans_table_menuiserie/Terrain_complet.SLDASM

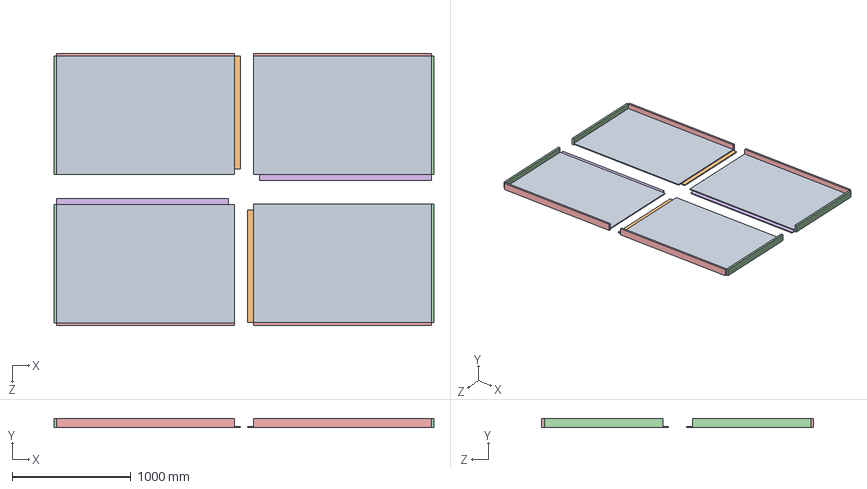
[picture p254: CAD file, 2013-05-17]
Meca/Table_2012/Plans_table_menuiserie/Terrain_complet.SLDASM
3206.7 x 80.0 x 2293.6 mm
planche_1500x1000x10 x 4
planche_950x100x10 x 6
planche_1350x100x10 x 8
planche_1000x80x22 x 4
planche_1500x80x22 x 4
planche_1450x100x10 x 2
