massinissalounis/oufffteam/Meca/Table_2013/Elements_Jeu/Bougie_complete_Bleue.SLDASM

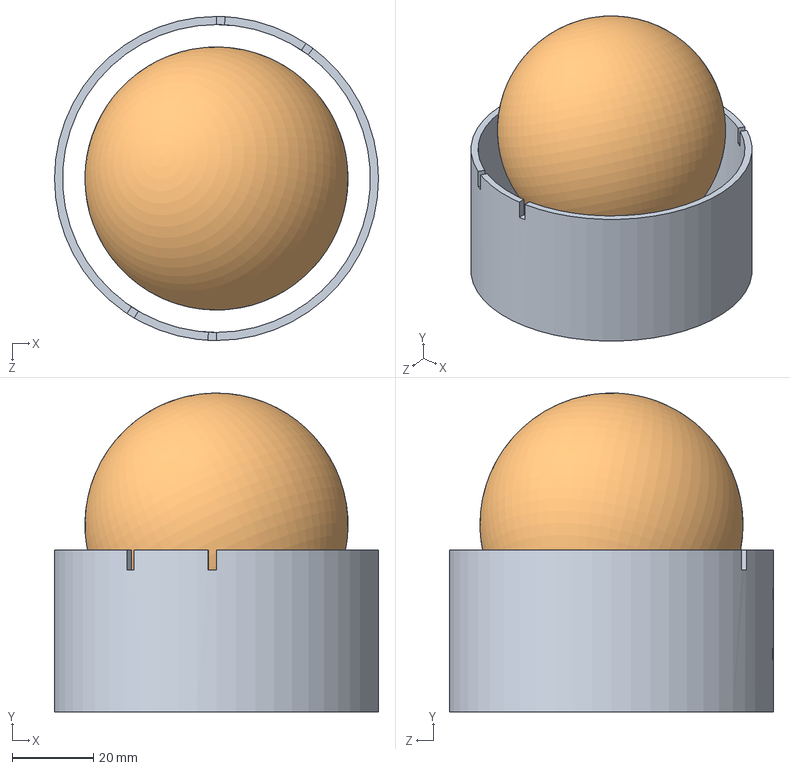
[picture p255: CAD file, 2013-05-17]
Meca/Table_2013/Elements_Jeu/Bougie_complete_Bleue.SLDASM
80.0 x 78.7 x 80.0 mm
Bougie_Bleue
Balle_Tennis_2
