massinissalounis/oufffteam/Meca/Table_2013/Elements_Jeu/Bougie_complete_Blanche.SLDASM

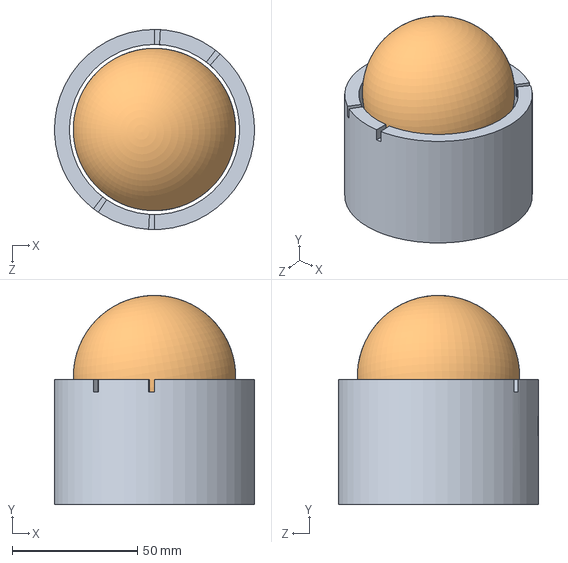
[picture p256: CAD file, 2013-05-17]
Meca/Table_2013/Elements_Jeu/Bougie_complete_Blanche.SLDASM
80.0 x 83.6 x 80.0 mm
Bougie_Blanche
Balle_Tennis_2
