massinissalounis/oufffteam/Meca/Table_2012/Plans_table_menuiserie/Terrain_9_Partie_4.SLDASM

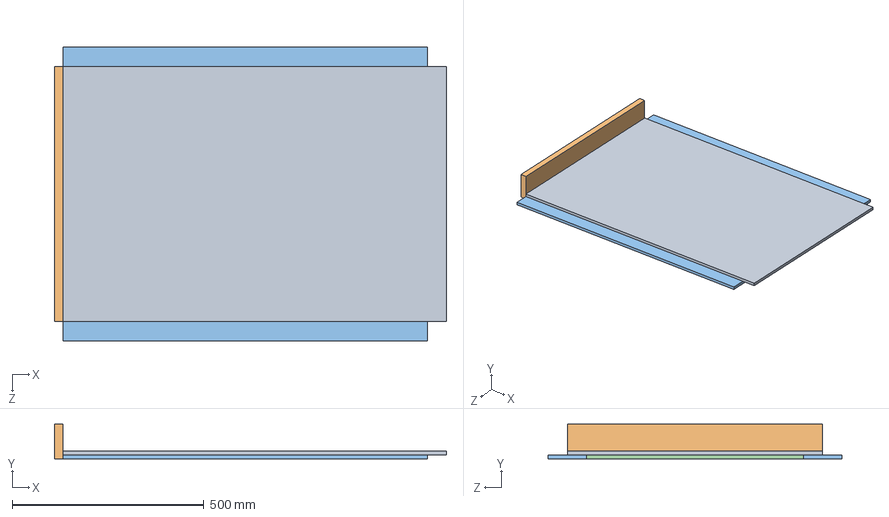
[picture p257: CAD file, 2013-05-17]
Meca/Table_2012/Plans_table_menuiserie/Terrain_9_Partie_4.SLDASM
1022.0 x 90.0 x 766.0 mm
planche_1000x666x10
planche_666x90x22
planche_950x100x10 x 2
planche_566x100x10
