massinissalounis/oufffteam/Meca/Table_2012/Plans_table_menuiserie/Partie_terrain_1.SLDASM

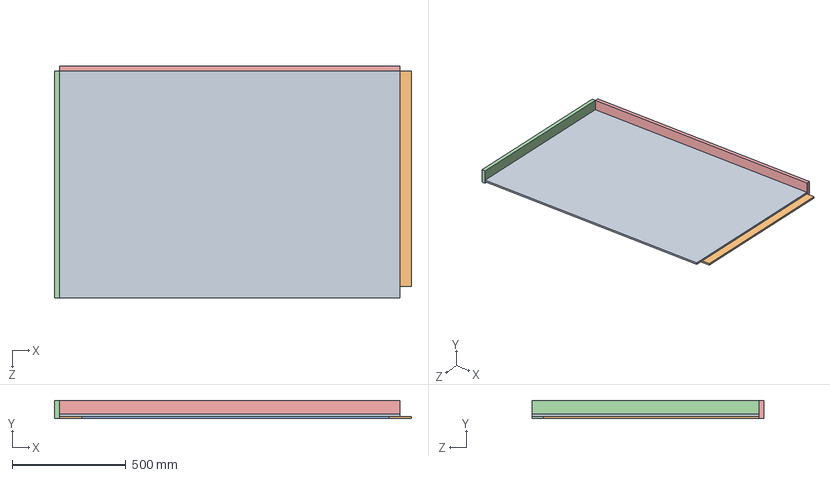
[picture p259: CAD file, 2013-05-17]
Meca/Table_2012/Plans_table_menuiserie/Partie_terrain_1.SLDASM
1572.0 x 80.0 x 1022.0 mm
planche_1500x1000x10
planche_950x100x10 x 2
planche_1350x100x10 x 2
planche_1000x80x22
planche_1500x80x22
