massinissalounis/oufffteam/Meca/Table_2012/Elements_fixes_Table/carte_tresor.SLDASM

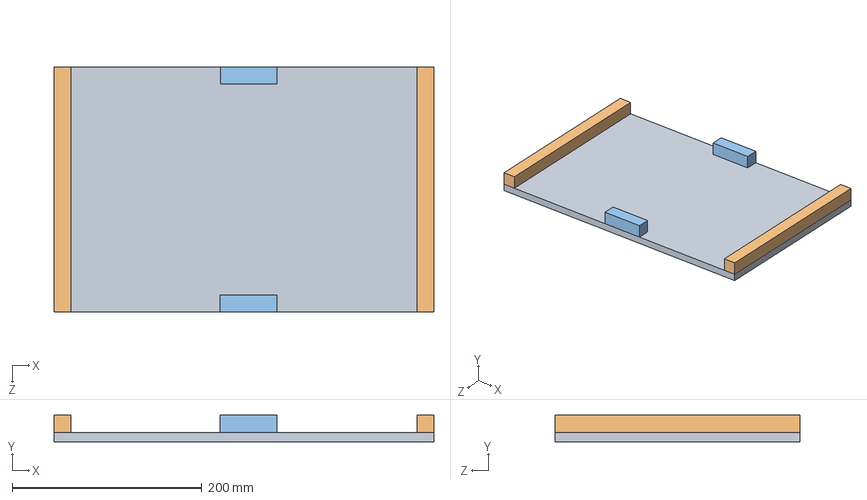
[picture p260: CAD file, 2013-05-17]
Meca/Table_2012/Elements_fixes_Table/carte_tresor.SLDASM
400.0 x 28.0 x 258.0 mm
support_carte
linteau_18x18_L258_bleu x 2
linteau_18x18_L60_bleu x 2
