massinissalounis/oufffteam/Meca/Plans Robot 2013/Petit robot/Robot_2011/Travaux patrick/motorisation pat/Assemblage1.SLDASM

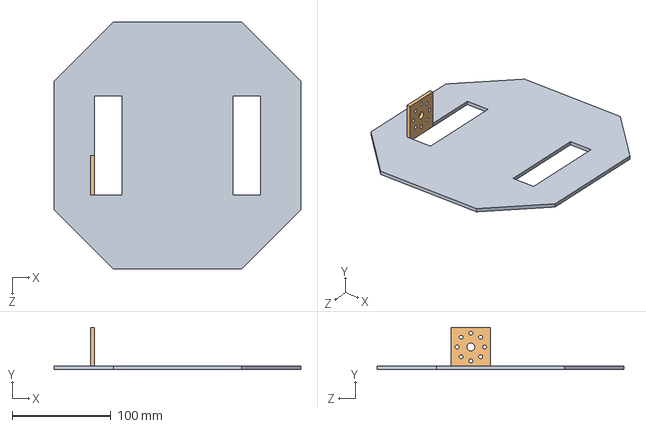
[picture p261: CAD file, 2013-05-17]
Meca/Plans Robot 2013/Petit robot/Robot_2011/Travaux patrick/motorisation pat/Assemblage1.SLDASM
250.0 x 43.0 x 250.0 mm
Essai_plaque_support
Pièce1_pat
