massinissalounis/oufffteam/Meca/Table_2012/Elements_fixes_Table/fixation_message.SLDASM

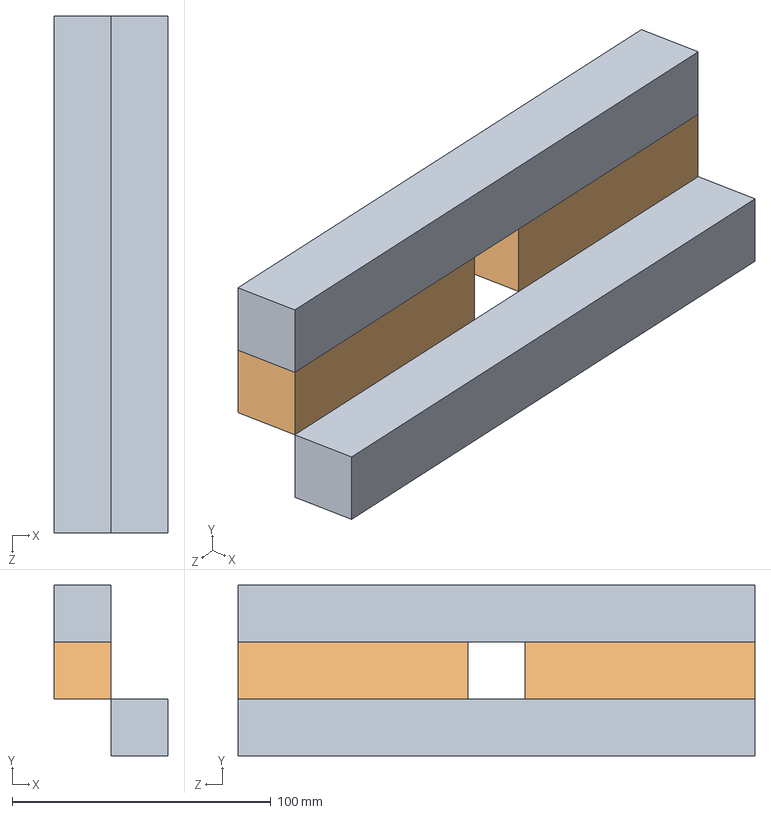
[picture p262: CAD file, 2013-05-17]
Meca/Table_2012/Elements_fixes_Table/fixation_message.SLDASM
44.0 x 66.0 x 200.0 mm
linteau_22x22_L200_bleu x 2
linteau_22x22_L89_bleu x 2
