massinissalounis/oufffteam/Meca/Plans Robot 2013/Petit robot/Robot_2011/Travaux patrick/motorisation pat/Assemblage7.SLDASM

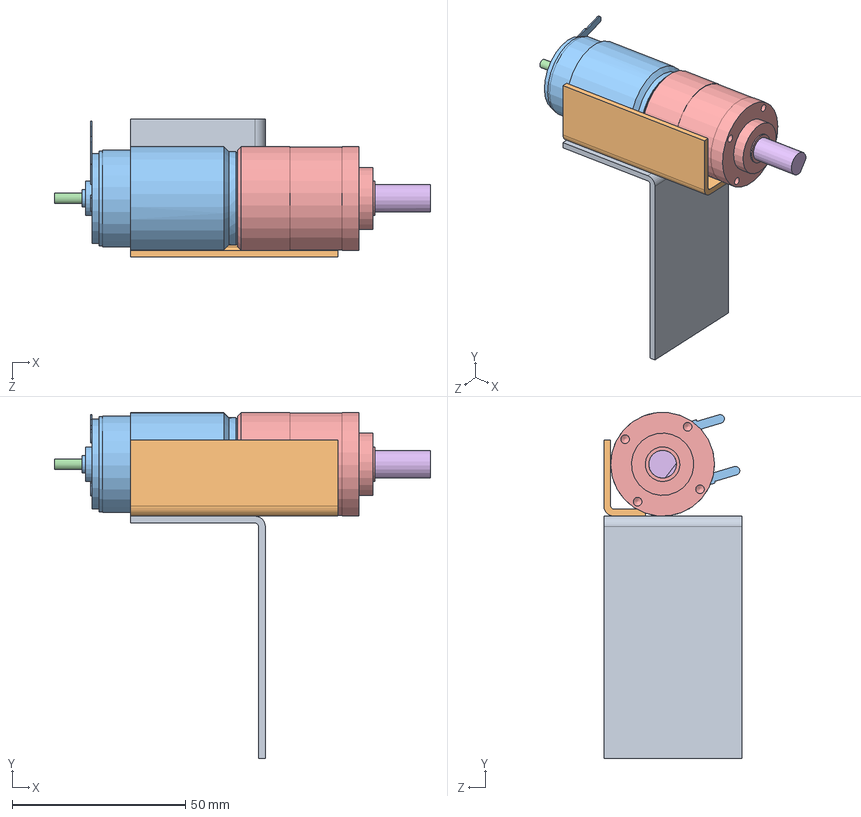
[picture p263: CAD file, 2013-05-17]
Meca/Plans Robot 2013/Petit robot/Robot_2011/Travaux patrick/motorisation pat/Assemblage7.SLDASM
108.6 x 99.9 x 40.0 mm
Pate moteur 1
Pate moteur2
corps_moteur_faulhauber_3042W024C
arbre_moteur_faulhauber_3042W024C
corps_reducteur_faulhaber_30_1
arbre_reducteur_faulhauber_30_1
