massinissalounis/oufffteam/(list of files, cad)

Other CAD files:
Meca/Sous_Ensembles/Bloc_moteur/glissière.SLDASM
Meca/Sous_Ensembles/Bras_prehension/Essai_bras_AX12_V1.SLDASM
Elec/2011/Balises IR/cpld/Rx_cpld/isim/Rx_cpld_isim_beh.exe.sim/work/Rx_cpld_isim_beh.exe_main.nt.obj
Meca/Plans Robot 2013/Petit robot/Bloc_moteur/glissière.SLDASM
Meca/Plans Robot 2013/Petit robot/Robot_2011/Travaux patrick/version 2011-4/Codeur/Codeur_2MRH.SLDASM
Meca/Table_2013/Elements_Jeu/Plateau_Cerises_bleues.SLDASM
Meca/Plans Robot 2013/Petit robot/Robot_2011/Bloc_moteur/Codeur_2MRH.SLDASM
Meca/Plans Robot 2013/Sous ensembles Robot/Pince/essai_assemblage_pince_2_gauche.SLDASM
Meca/Plans Robot 2013/Sous ensembles Robot/Pince/essai_assemblage_pince_3_gauche.SLDASM
Meca/Plans Robot 2013/Petit robot/Robot_2011/Bloc_moteur/glissière.SLDASM
Meca/Sous_Ensembles/Bloc_moteur/Codeur_2MRH.SLDASM
Meca/Plans Robot 2013/Sous ensembles Robot/Pince/essai_assemblage_pince_2.SLDASM
Meca/Table_2012/Plans_table_menuiserie/Terrain_9_Partie_3.SLDASM
Meca/Table_2012/Elements_Mobiles_Table/porte_message_violet.SLDASM
Meca/Plans Robot 2013/Petit robot/Robot_2011/Travaux patrick/version 2011-4/Assemblage6.SLDASM
Meca/Sous_Ensembles/Bloc_moteur/Motoreducteur_Faulhauber_3042W024_30_1.SLDASM
Meca/Plans Robot 2013/Petit robot/Robot_2011/Travaux patrick/version 2011-4/Motoreducteur_Faulhauber_3042W024_30_1.SLDASM
Meca/Plans Robot 2013/Petit robot/Robot_2011/Bloc_moteur/Motoreducteur_Faulhauber_3042W024_30_1.SLDASM
Meca/Plans Robot 2013/Petit robot/Robot_2011/Bloc_moteur/Roue.SLDASM
Meca/Plans Robot 2013/Petit robot/Bloc_moteur/Codeur_2MRH.SLDASM
Meca/Plans Robot 2013/Petit robot/Bloc_moteur/Motoreducteur_Faulhauber_3042W024_30_1.SLDASM
Meca/Plans Robot 2013/Petit robot/Bloc_moteur/Roue.SLDASM
Meca/Sous_Ensembles/Bloc_moteur/glissière_L46.SLDASM
Balises/Balises_SICK/Elec/Interface_v1/Interface_v1.DXF
Balises/Balises_SICK/Meca/Balise_Principale/Capteur_WL100/SICK WL100-N4439-Bestell-Nr_6028604(0)-1.sldprt
Balises/Balises_SICK/Meca/Balise_Principale/Interface_v1.SLDPRT
Balises/Balises_SICK/Meca/Balise_Principale/Minimotor/1624_S/1624S.SLDPRT
Balises/Balises_SICK/Meca/Balise_Principale/Minimotor/1624_S/1624TS.igs
Balises/Balises_SICK/Meca/Balise_Principale/Minimotor/1624_S/1624TS.prt
Balises/Balises_SICK/Meca/Balise_Principale/Minimotor/1624_S/1624TS.sldprt
Balises/Balises_SICK/Meca/Balise_Principale/Minimotor/1624_S/1624TS.stp
Balises/Balises_SICK/Meca/Balise_Principale/Minimotor/1624_S/1624TS.x_t
Balises/Balises_SICK/Meca/Balise_Principale/Minimotor/STEP_15_5_20130107/15_5 2stages.stp
Balises/Balises_SICK/Meca/Balise_Principale/Minimotor/STEP_15_5_20130107/15_5 3stages.SLDPRT
Balises/Balises_SICK/Meca/Balise_Principale/Minimotor/STEP_15_5_20130107/15_5 3stages.stp
Balises/Balises_SICK/Meca/Balise_Principale/Minimotor/STEP_15_5_20130107/15_5 4stages.stp
Balises/Balises_SICK/Meca/Balise_Principale/Minimotor/STEP_15_5_20130107/15_5 5stages.stp
Balises/Balises_SICK/Meca/Balise_Principale/Minimotor/STEP_15_5_20130107/15_5 6stages.stp
Balises/Balises_SICK/Meca/Balise_Principale/Minimotor/STEP_15_5_20130107/15_5 7stages.stp
Balises/Balises_SICK/Meca/Balise_Principale/Pilier.SLDPRT
Balises/Balises_SICK/Meca/Balise_Principale/Pilier_v1.SLDPRT
Balises/Balises_SICK/Meca/Balise_Principale/Pilier_v2.SLDPRT
Balises/Balises_SICK/Meca/Balise_Principale/Plaque_bottom.SLDPRT
Balises/Balises_SICK/Meca/Balise_Principale/Plaque_top.SLDPRT
Balises/Balises_SICK/Meca/Balise_Principale/Prod files/Pilier.STL
Balises/Balises_SICK/Meca/Balise_Principale/Prod files/Plaque_bottom.STL
Balises/Balises_SICK/Meca/Balise_Principale/Prod files/Plaque_top.STL
Balises/Balises_SICK/Meca/Balise_Principale/Prod files/mirror.STL
Balises/Balises_SICK/Meca/Balise_Principale/mirror.SLDPRT
Balises/Balises_SICK/Meca/Balises_Passives/Balises_passives.SLDPRT
Balises/Balises_SICK/Meca/Balises_Passives/Balises_passives.STL
Balises/Balises_SICK/Meca/Balises_Passives/Balises_passives_v2/Balises_passives_v2.SLDASM
Balises/Balises_SICK/Meca/Balises_Passives/Balises_passives_v2/Prod_files/cylindre_free.STL
Balises/Balises_SICK/Meca/Balises_Passives/Balises_passives_v2/Prod_files/support.STL
Balises/Balises_SICK/Meca/Balises_Passives/Balises_passives_v2/cylindre.SLDPRT
Balises/Balises_SICK/Meca/Balises_Passives/Balises_passives_v2/cylindre.STL
Balises/Balises_SICK/Meca/Balises_Passives/Balises_passives_v2/cylindre_free.SLDPRT
Balises/Balises_SICK/Meca/Balises_Passives/Balises_passives_v2/support.SLDPRT
Balises/Balises_SICK/Meca/Balises_Passives/Balises_passives_v2/support.STL
Balises/Balises_SICK/Meca/Balises_Passives/test$.SLDPRT
Balises/Balises_SICK/Meca/old/Balise2/AMAX_22_CLL.SLDPRT
Balises/Balises_SICK/Meca/old/Balise2/Codeur+Moteur.SLDASM
Balises/Balises_SICK/Meca/old/Balise2/Diode.SLDPRT
Balises/Balises_SICK/Meca/old/Balise2/HEDS5540.SLDPRT
Balises/Balises_SICK/Meca/old/Balise2/LDM650.SLDPRT
Balises/Balises_SICK/Meca/old/Balise2/PlaqueMoteur80_80.SLDPRT
Balises/Balises_SICK/Meca/old/Balise2/test.SLDASM
Balises/Balises_SICK/Meca/old/BoiteHaut.SLDPRT
Balises/Balises_SICK/Meca/old/Couvercle.SLDPRT
Balises/Balises_SICK/Meca/old/CouvercleHaut.SLDPRT
Balises/Balises_SICK/Meca/old/Laser.SLDPRT
Balises/Balises_SICK/Meca/old/Led.SLDPRT
Balises/Balises_SICK/Meca/old/MiroirTournant.SLDPRT
Balises/Balises_SICK/Meca/old/Moteur.SLDPRT
Balises/Balises_SICK/Meca/old/SupportLaser2.SLDPRT
Balises/Balises_SICK/Meca/old/balise.SLDASM
Balises/Balises_SICK/Meca/old/boite.SLDPRT
Balises/Balises_SICK/Meca/old/boiteHautMoule.SLDPRT
Balises/Balises_SICK/Meca/old/test/MiroirTournant.SLDDRW
Balises/Balises_SICK/Meca/old/test/MiroirTournant.SLDPRT
Balises/Balises_SICK/Meca/old/tige.SLDPRT
Elec/2010/CM/Doc/PlanMeca.SLDPRT
Elec/2011/Balises IR/cpld/Rx_cpld/isim/Rx_cpld_isim_beh.exe.sim/work/a_0496474477_4229335063.nt.obj
Meca/Archive_Coupe 2011_ne_pas_utiliser (non vraiment pas !!)/Architecture Robot/Robot_2009/Base roulante/Base roulante.SLDDRW
Meca/Archive_Coupe 2011_ne_pas_utiliser (non vraiment pas !!)/Architecture Robot/Robot_2009/Base roulante/Fixation bille.SLDDRW
Meca/Archive_Coupe 2011_ne_pas_utiliser (non vraiment pas !!)/Architecture Robot/Robot_2009/Base roulante/Fixation bille.SLDPRT
Meca/Archive_Coupe 2011_ne_pas_utiliser (non vraiment pas !!)/Architecture Robot/Robot_2009/Base roulante/Guide_roulette.SLDPRT
Meca/Archive_Coupe 2011_ne_pas_utiliser (non vraiment pas !!)/Architecture Robot/Robot_2009/Base roulante/Roulette D20.SLDPRT
Meca/Archive_Coupe 2011_ne_pas_utiliser (non vraiment pas !!)/Architecture Robot/Robot_2009/Base roulante/bille D12_5.SLDPRT
Meca/Archive_Coupe 2011_ne_pas_utiliser (non vraiment pas !!)/Architecture Robot/Robot_2009/Base roulante/fond_hexagonal.SLDPRT
Meca/Archive_Coupe 2011_ne_pas_utiliser (non vraiment pas !!)/Architecture Robot/Robot_2009/Base roulante/simu_profilé.SLDPRT
Meca/Archive_Coupe 2011_ne_pas_utiliser (non vraiment pas !!)/Architecture Robot/Robot_2009/Base roulante/tige filetée M8.SLDPRT
Meca/Archive_Coupe 2011_ne_pas_utiliser (non vraiment pas !!)/Architecture Robot/Robot_2009/motorisation rémi/Motorisation/Bloc Codeur/Plaque_support.SLDPRT
Meca/Archive_Coupe 2011_ne_pas_utiliser (non vraiment pas !!)/Architecture Robot/Robot_2009/motorisation rémi/Motorisation/Bloc Codeur/Roue_codeuse.SLDPRT
Meca/Archive_Coupe 2011_ne_pas_utiliser (non vraiment pas !!)/Architecture Robot/Robot_2009/motorisation rémi/Motorisation/Bloc Codeur/joint_D30.SLDPRT
Meca/Archive_Coupe 2011_ne_pas_utiliser (non vraiment pas !!)/Architecture Robot/Robot_2009/motorisation rémi/Motorisation/Bloc Codeur/joint_D40.SLDPRT
Meca/Archive_Coupe 2011_ne_pas_utiliser (non vraiment pas !!)/Architecture Robot/Robot_2009/motorisation rémi/Motorisation/Bloc Codeur/joint_E3,5_D15.SLDPRT
Meca/Archive_Coupe 2011_ne_pas_utiliser (non vraiment pas !!)/Architecture Robot/Robot_2009/motorisation rémi/Motorisation/Bloc Moteur/Palier_Roulement.SLDPRT
Meca/Archive_Coupe 2011_ne_pas_utiliser (non vraiment pas !!)/Architecture Robot/Robot_2009/motorisation rémi/Motorisation/Bloc Moteur/Plaque_adaptation_moteur.SLDPRT
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
