massinissalounis/oufffteam/Meca/Plans Robot 2013/Petit robot/Assemblage1.pdf

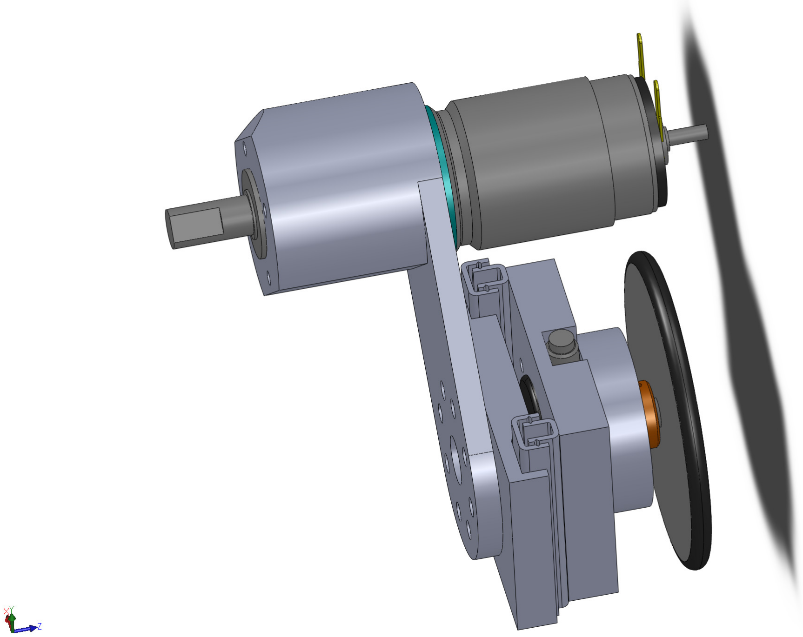
[picture p264: page 1]
