massinissalounis/oufffteam/Meca/Captures_ecran/Essai_assemblage_robot_vue_cote.JPG

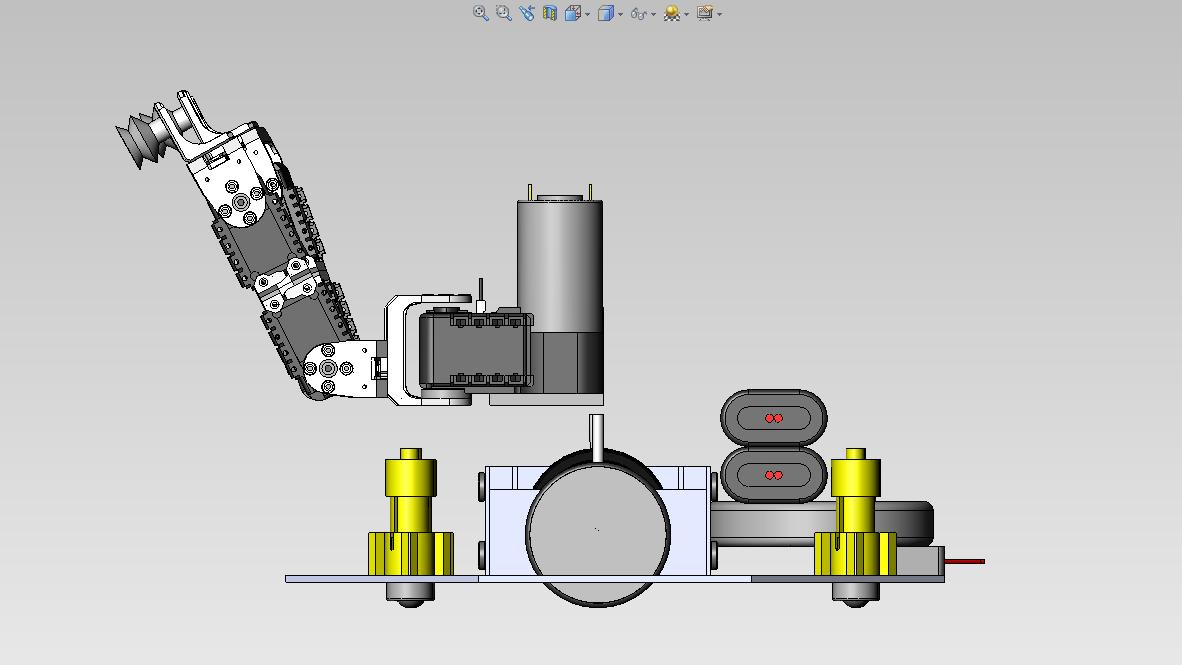
Meca/Captures_ecran/Essai_assemblage_robot_vue_cote.JPG
