massinissalounis/oufffteam/Meca/Captures_ecran/Essai_assemblage_robot_vue_dessus.JPG

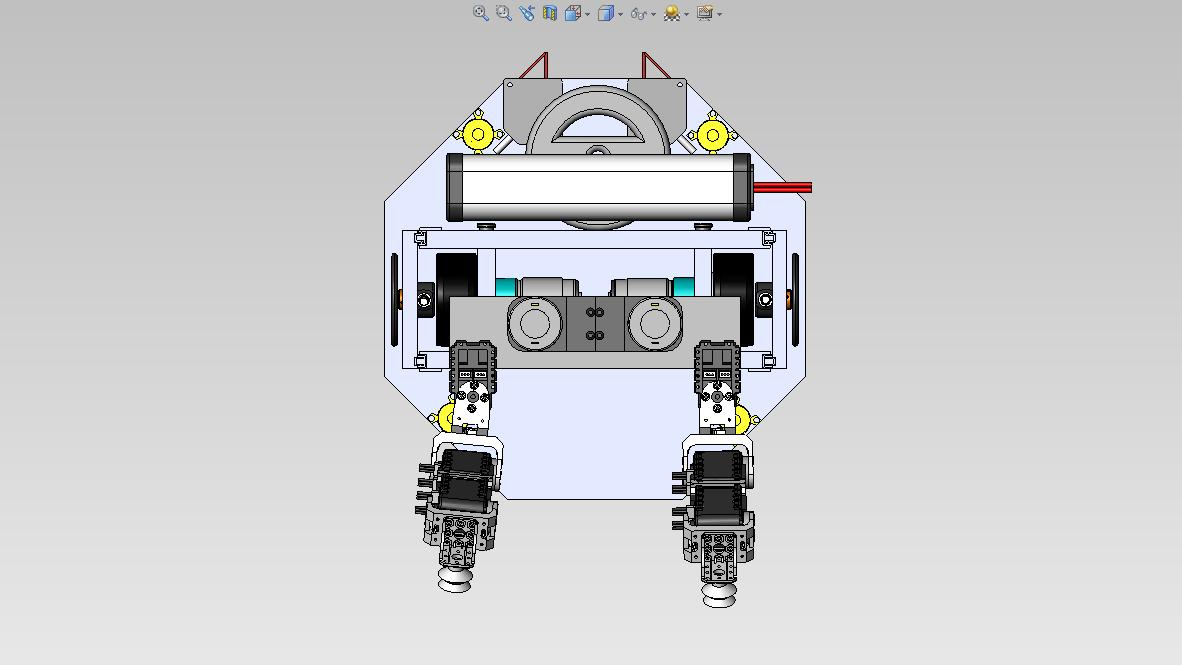
Meca/Captures_ecran/Essai_assemblage_robot_vue_dessus.JPG
