massinissalounis/oufffteam/Meca/Captures_ecran/Terrain_2012_9parties_montage_vue_iso.JPG

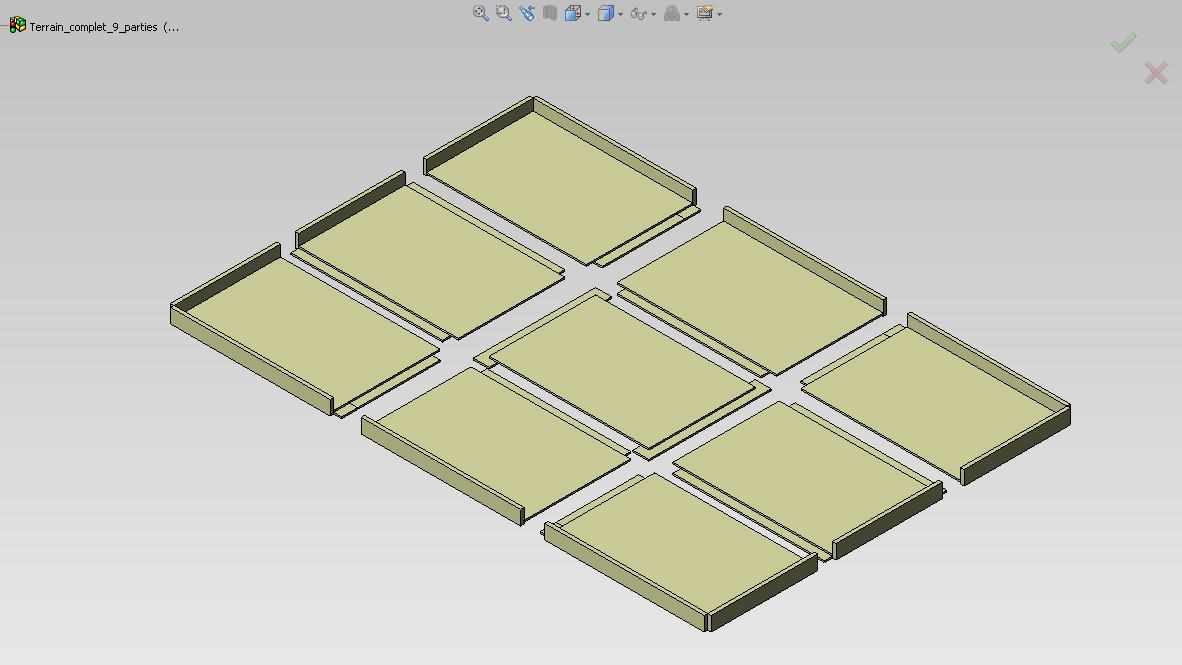
Meca/Captures_ecran/Terrain_2012_9parties_montage_vue_iso.JPG
