massinissalounis/oufffteam/Meca/Captures_ecran/Terrain_2012_montage_vue_iso.JPG

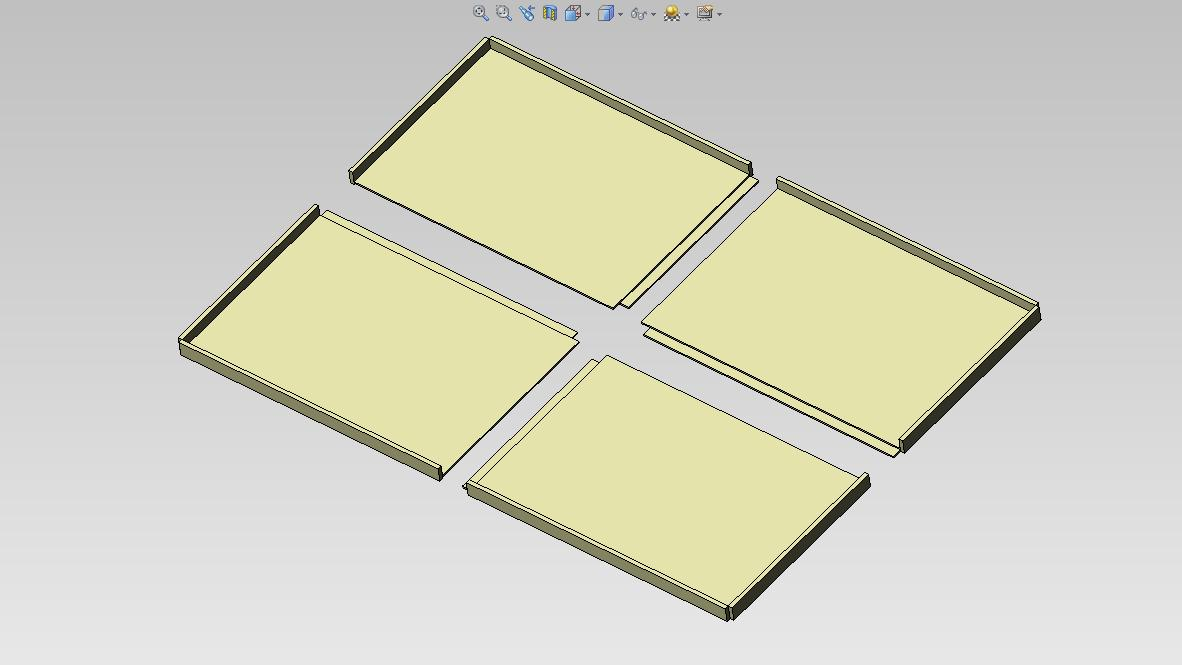
Meca/Captures_ecran/Terrain_2012_montage_vue_iso.JPG
