massinissalounis/oufffteam/Info/StrategyGenerator/v2 - 2013/Test/Tester_FileManager/TestFiles/Test_10000Lines.txt

Ligne chargée numéro : 	1
Ligne chargée numéro : 	2
Ligne chargée numéro : 	3
Ligne chargée numéro : 	4
Ligne chargée numéro : 	5
Ligne chargée numéro : 	6
Ligne chargée numéro : 	7
Ligne chargée numéro : 	8
Ligne chargée numéro : 	9
Ligne chargée numéro : 	10
Ligne chargée numéro : 	11
Ligne chargée numéro : 	12
Ligne chargée numéro : 	13
Ligne chargée numéro : 	14
Ligne chargée numéro : 	15
Ligne chargée numéro : 	16
Ligne chargée numéro : 	17
Ligne chargée numéro : 	18
Ligne chargée numéro : 	19
Ligne chargée numéro : 	20
Ligne chargée numéro : 	21
Ligne chargée numéro : 	22
Ligne chargée numéro : 	23
Ligne chargée numéro : 	24
Ligne chargée numéro : 	25
Ligne chargée numéro : 	26
Ligne chargée numéro : 	27
Ligne chargée numéro : 	28
Ligne chargée numéro : 	29
Ligne chargée numéro : 	30
Ligne chargée numéro : 	31
Ligne chargée numéro : 	32
Ligne chargée numéro : 	33
Ligne chargée numéro : 	34
Ligne chargée numéro : 	35
Ligne chargée numéro : 	36
Ligne chargée numéro : 	37
Ligne chargée numéro : 	38
Ligne chargée numéro : 	39
Ligne chargée numéro : 	40
Ligne chargée numéro : 	41
Ligne chargée numéro : 	42
Ligne chargée numéro : 	43
Ligne chargée numéro : 	44
Ligne chargée numéro : 	45
Ligne chargée numéro : 	46
Ligne chargée numéro : 	47
Ligne chargée numéro : 	48
Ligne chargée numéro : 	49
Ligne chargée numéro : 	50
Ligne chargée numéro : 	51
Ligne chargée numéro : 	52
Ligne chargée numéro : 	53
Ligne chargée numéro : 	54
Ligne chargée numéro : 	55
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
Ligne chargée numéro : 	6925
Ligne chargée numéro : 	6926
Ligne chargée numéro : 	6927
Ligne chargée numéro : 	6928
Ligne chargée numéro : 	6929
Ligne chargée numéro : 	6930
Ligne chargée numéro : 	6931
Ligne chargée numéro : 	6932
Ligne chargée numéro : 	6933
Ligne chargée numéro : 	6934
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
