massinissalounis/oufffteam/Info/StrategyGenerator/v2 - 2013/Test/Tester_FileManager/TestFiles/Test_Load.txt

Ligne 01
Ligne 02
Ligne 03
Ligne 04
Ligne 05
Ligne 06
Ligne 07
Ligne 08
Ligne 09
Ligne 10

Ligne 11

 Ligne 12
	Ligne 13
