massinissalounis/oufffteam/Info/CMUCam/Src/tools/cc3_image_viewer/bin/Debug/test.jpg

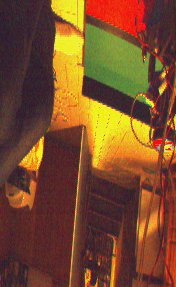
Info/CMUCam/Src/tools/cc3_image_viewer/bin/Debug/test.jpg
