massinissalounis/oufffteam/Elec/2011/Balises IR/schematic/Tx_rev_B.pdf

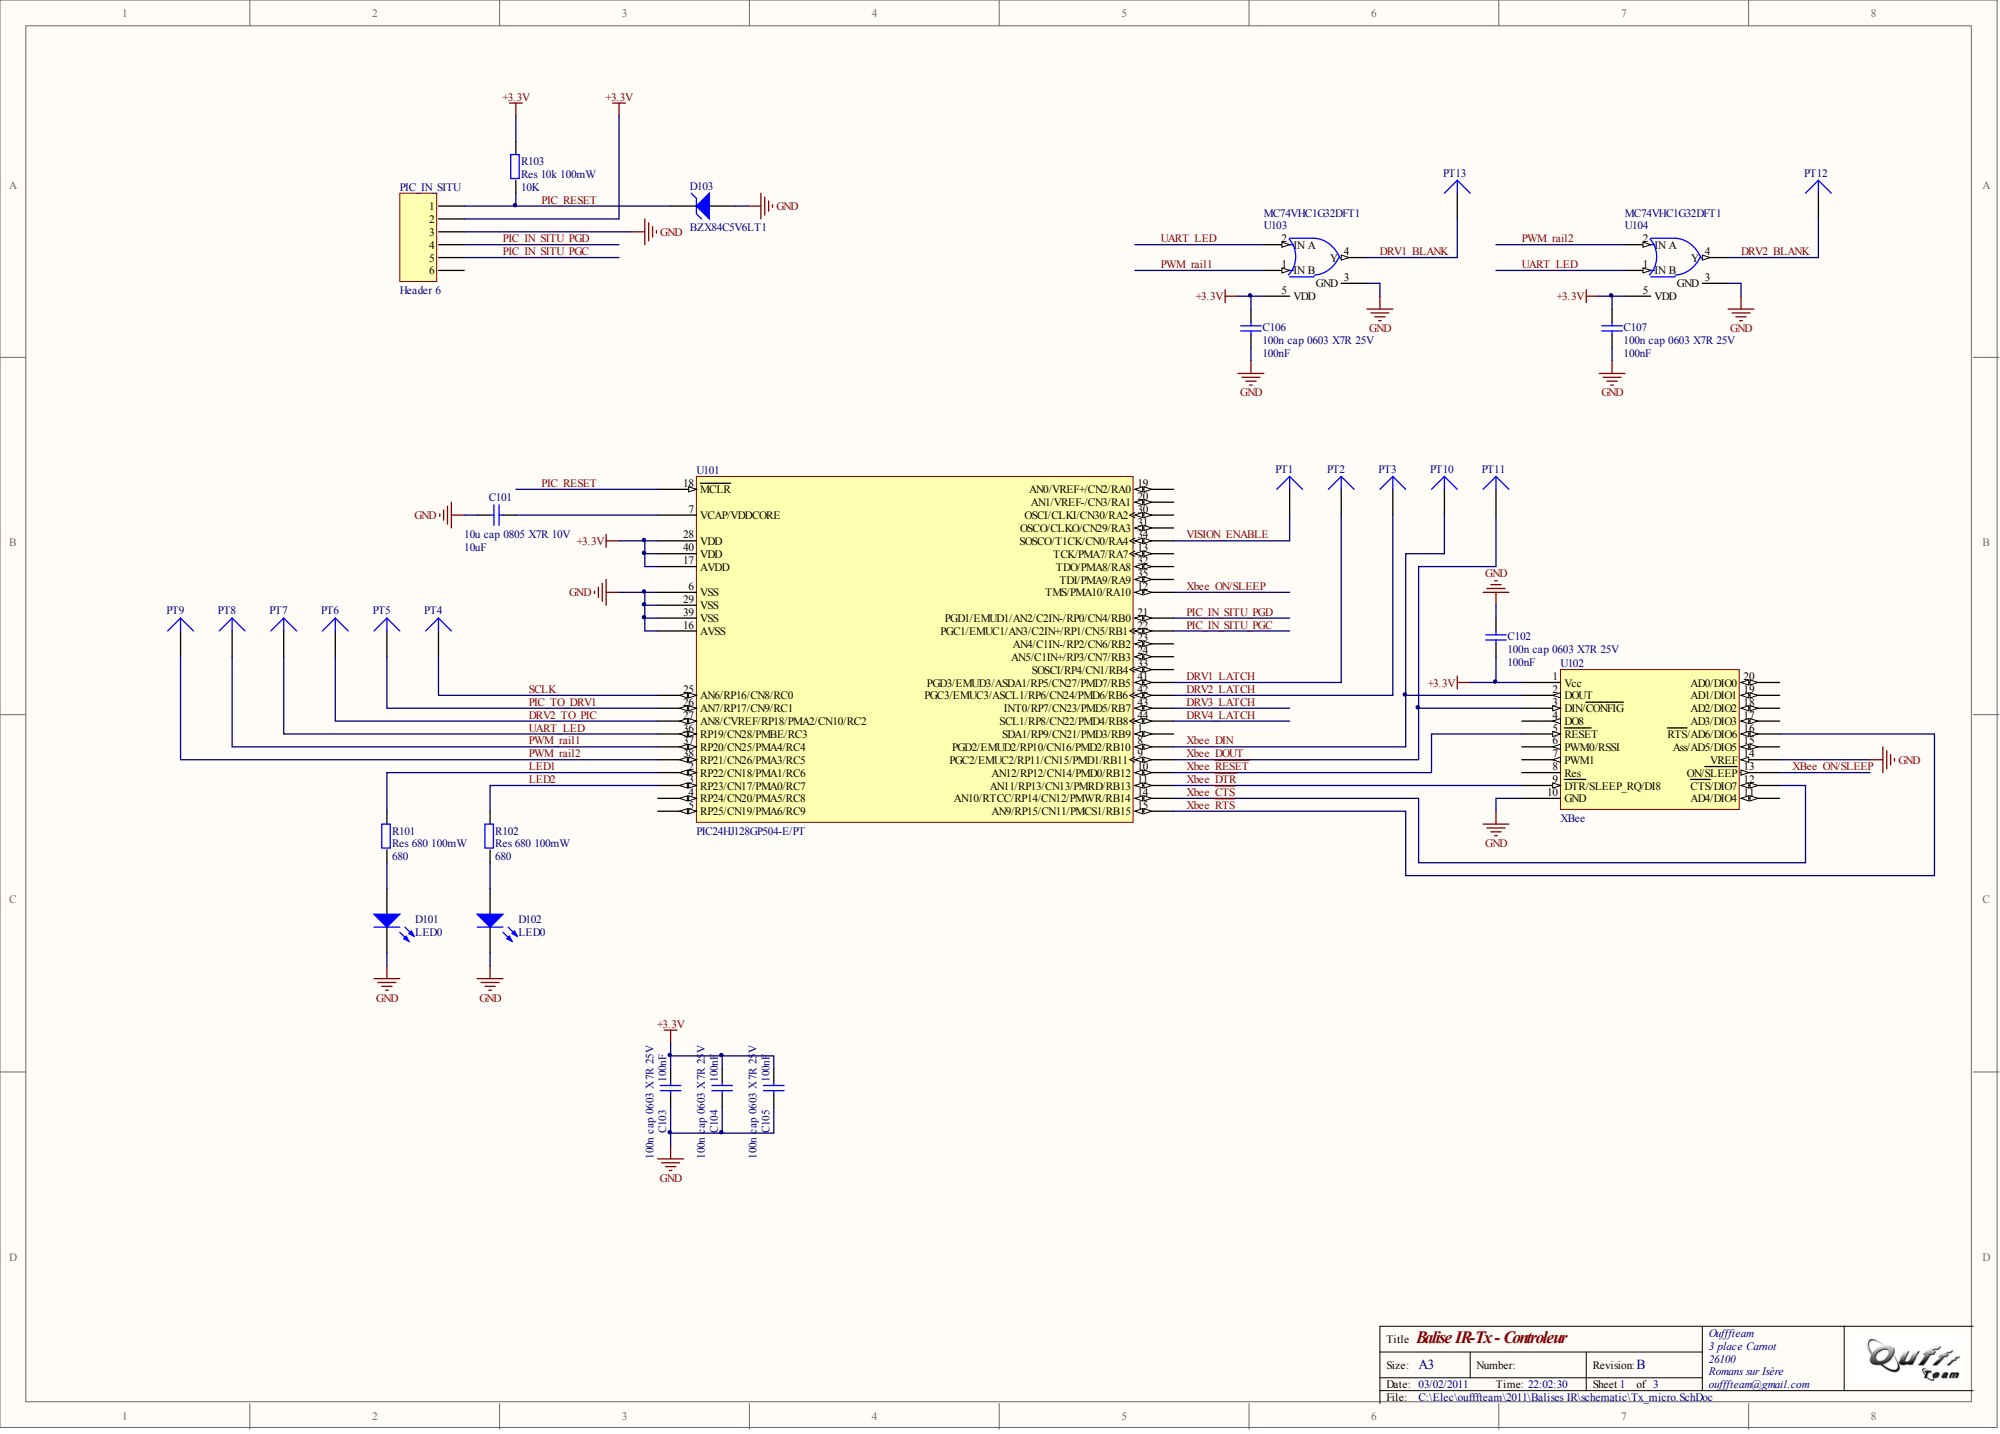
[picture p274: page 1]

Balise IR-Tx - Controleur Title | Oufffteam 3 place Carnot Romans sur Isère oufffteam@gmail.com

A3 Size: | Number: | B Revision:

Date: 03/02/2011 Time: 22:02:30 | | Sheet of 3

C:\Elec\oufffteam\2011\Balises IR\schematic\Tx_micro.SchDoc

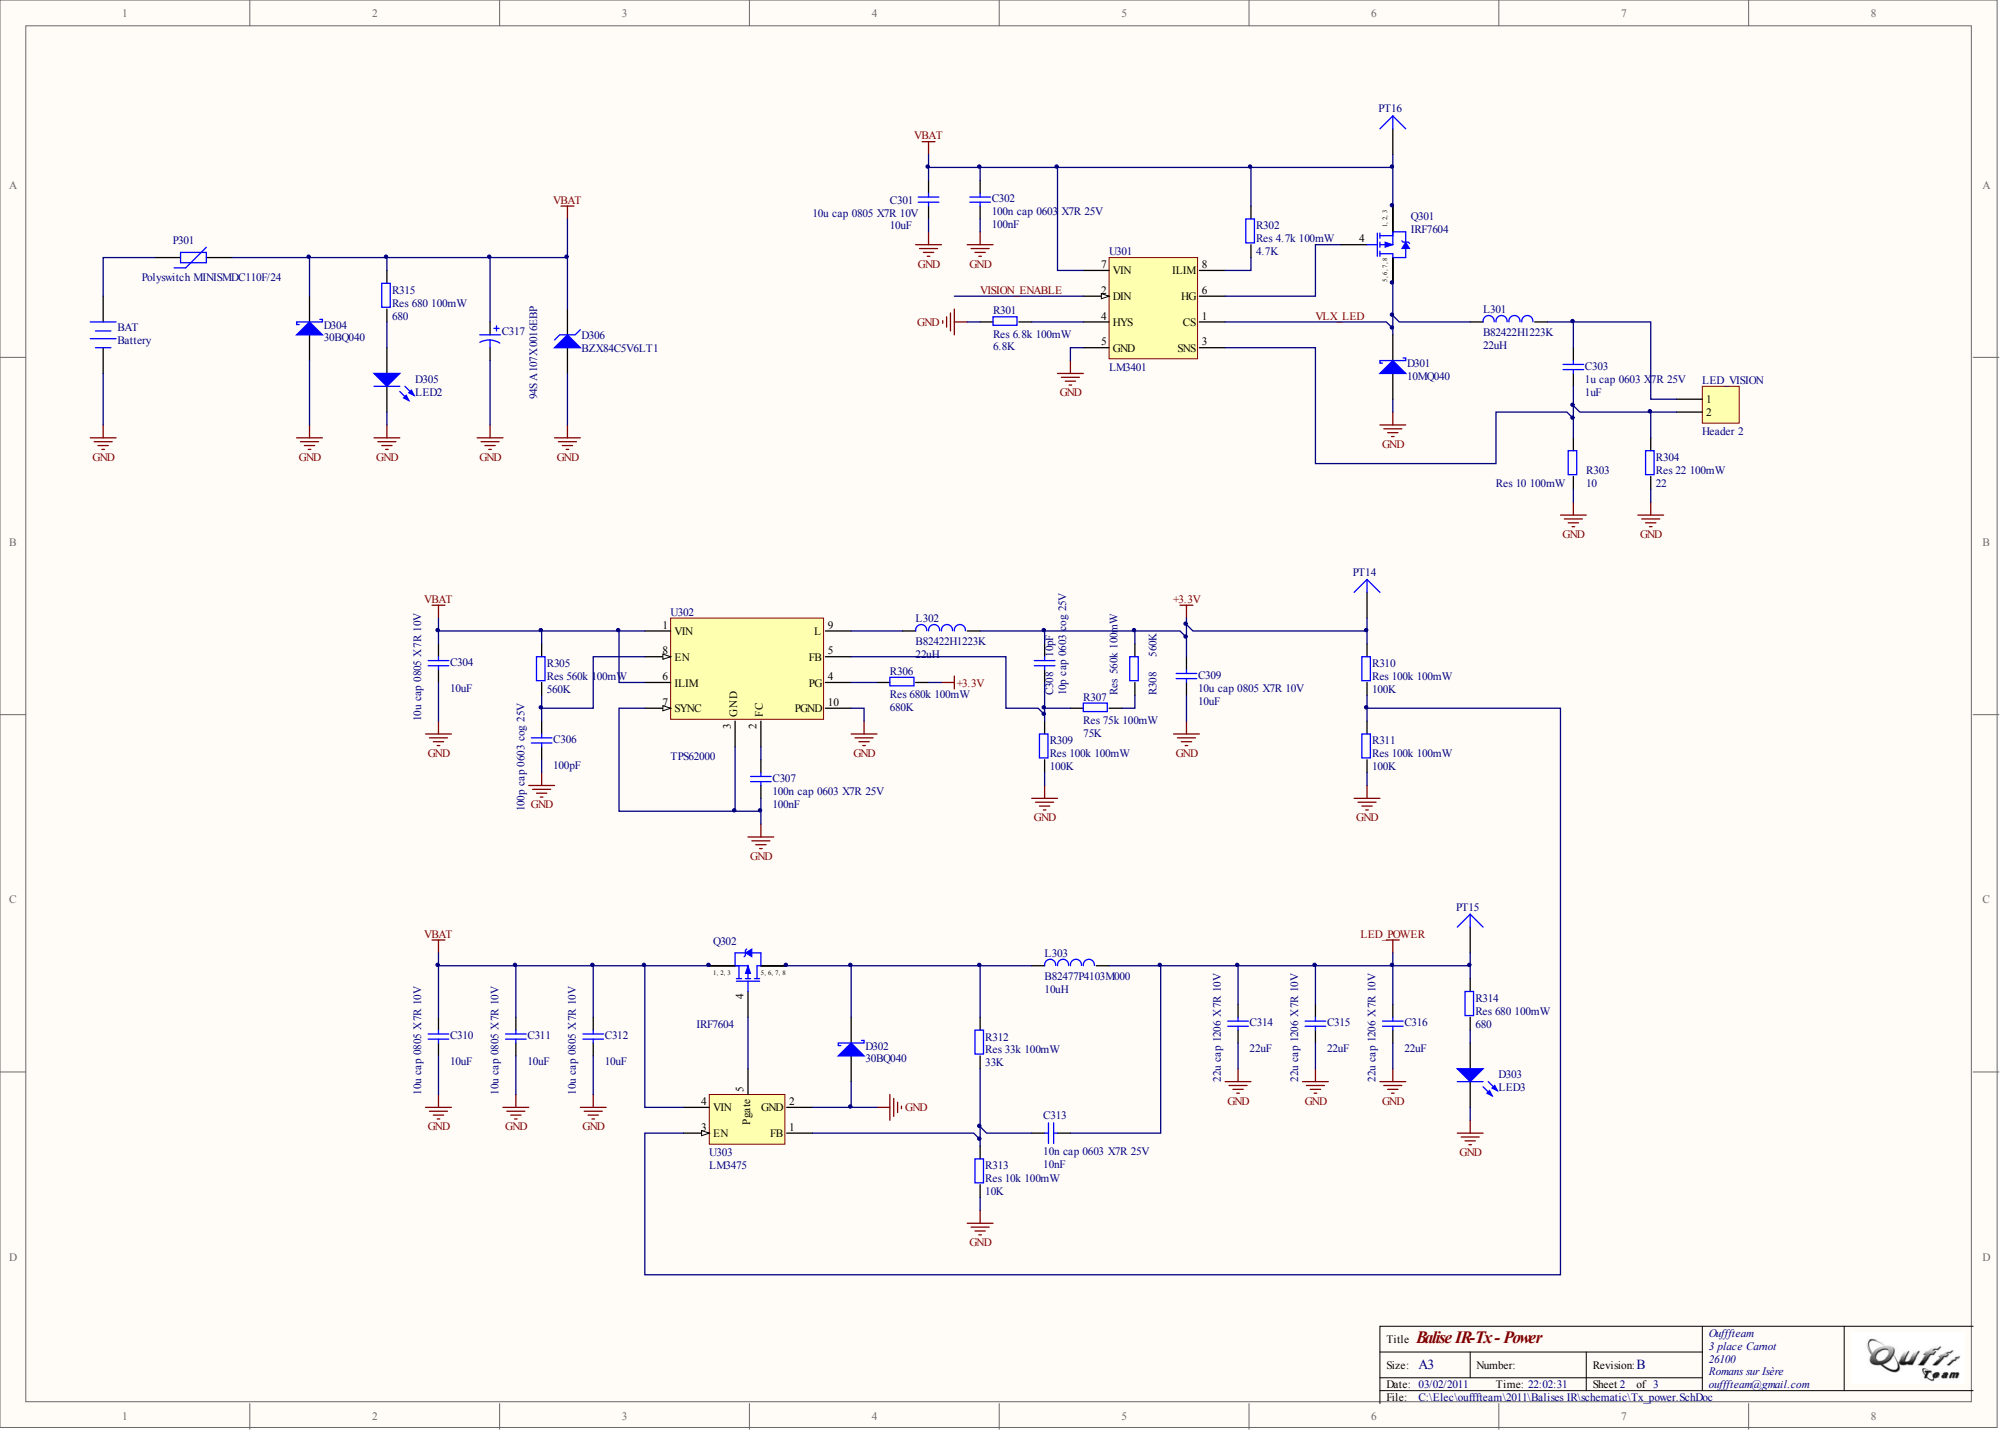
[picture p275: page 2]

10u cap 0805 X7R 10V GND GND GND

Balise IR-Tx - Power

C:\Elec\oufffteam\2011\Balises IR\schematic\Tx_power.SchDoc

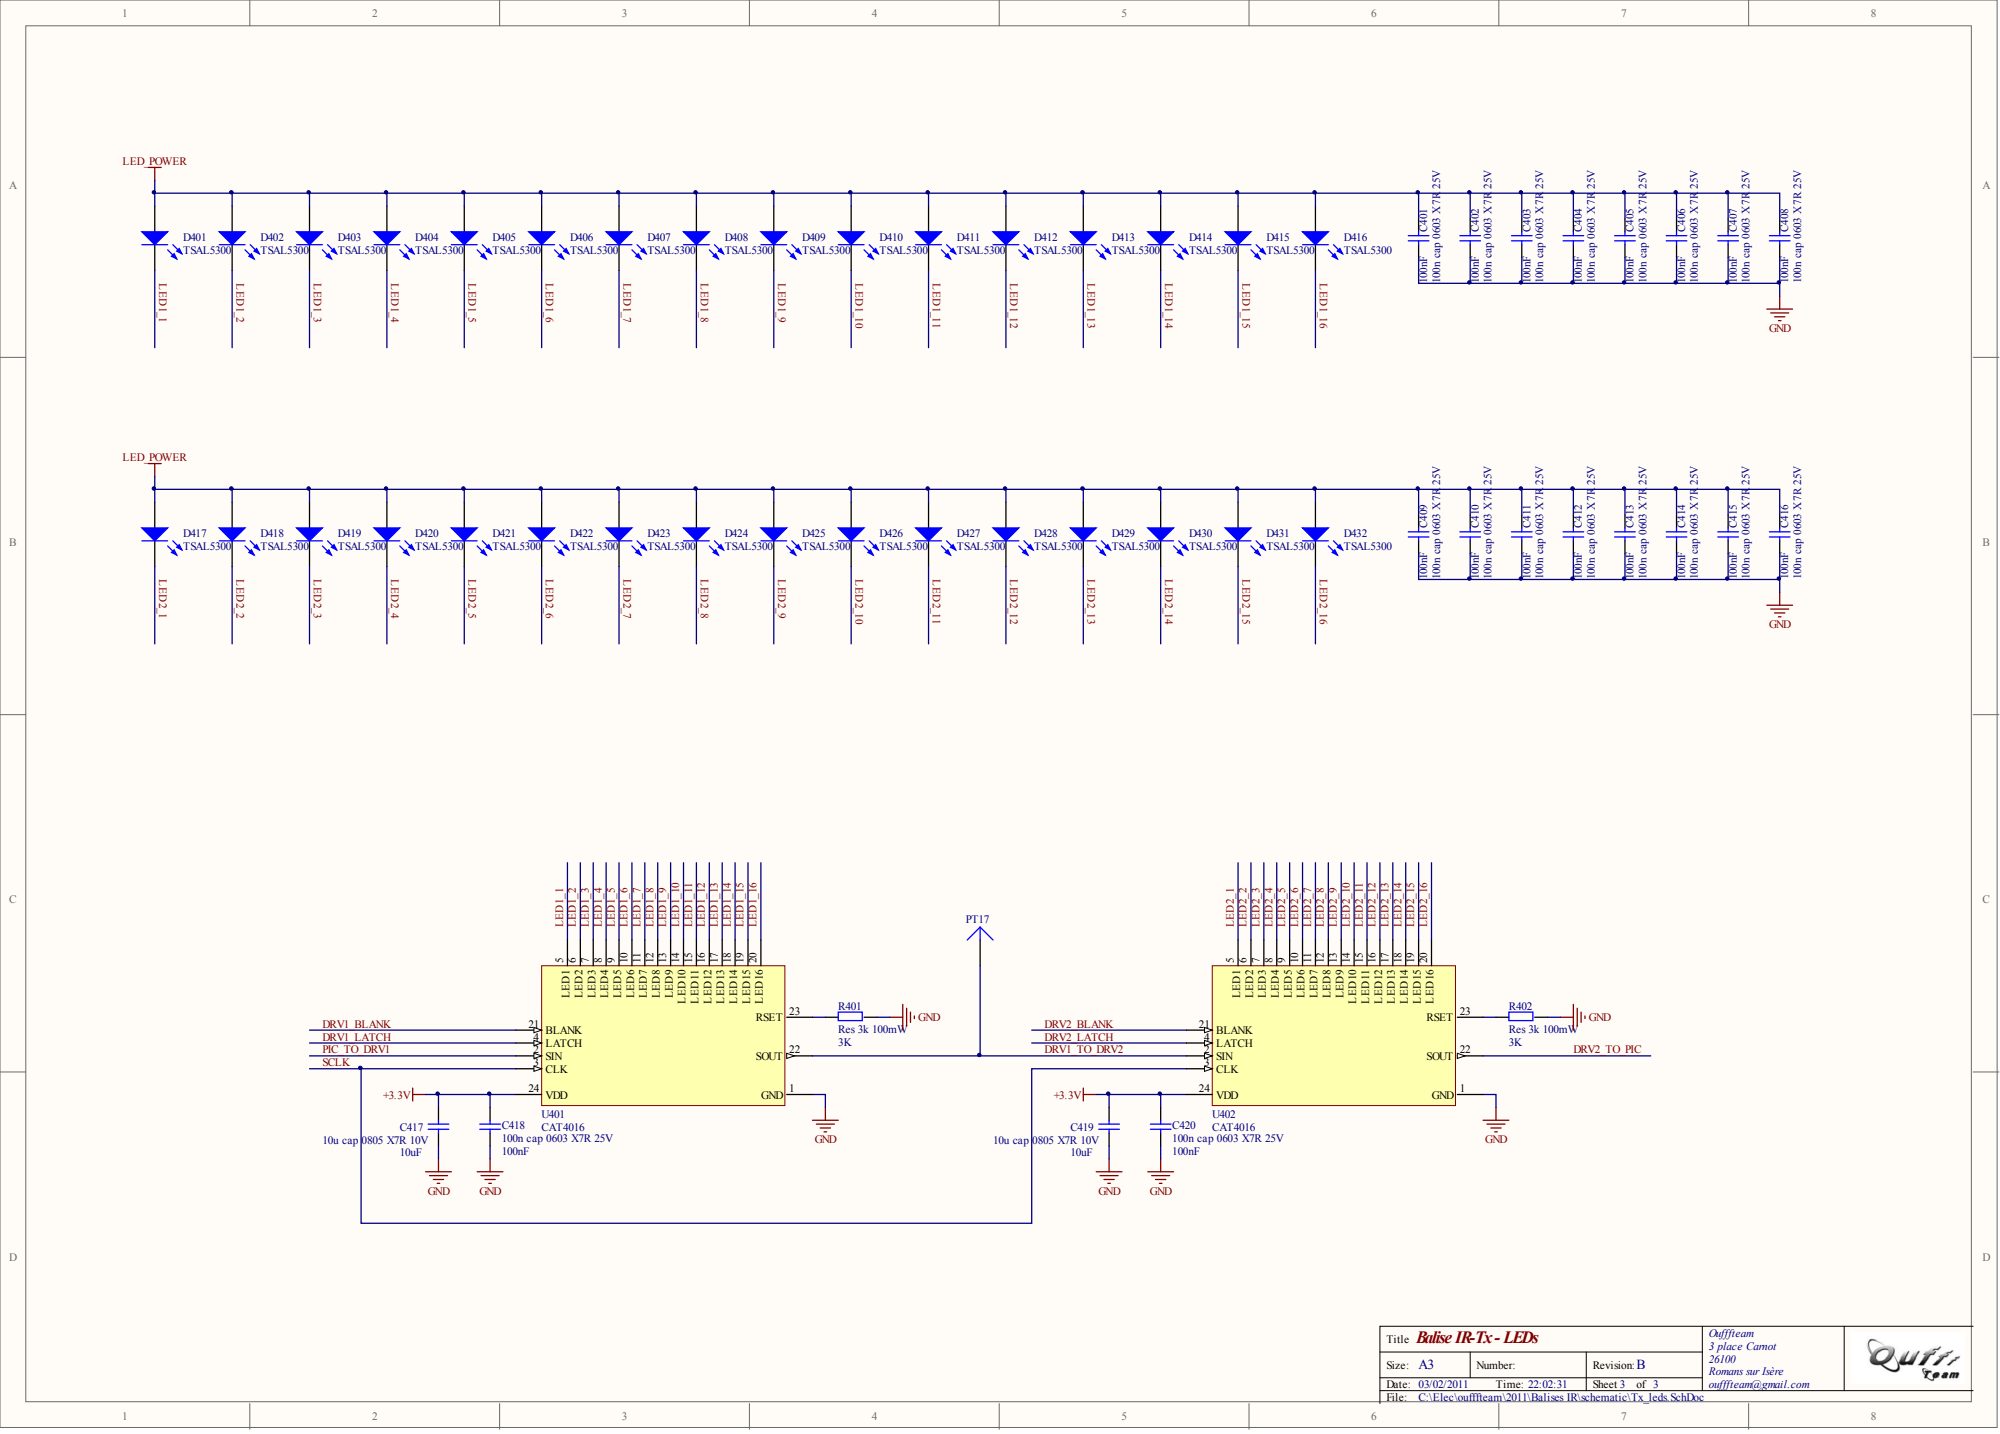
[picture p276: page 3]

Balise IR-Tx - LEDs

C:\Elec\oufffteam\2011\Balises IR\schematic\Tx_leds.SchDoc
