massinissalounis/oufffteam/Elec/2011/Balises IR/schematic/Rx_rev_B.pdf

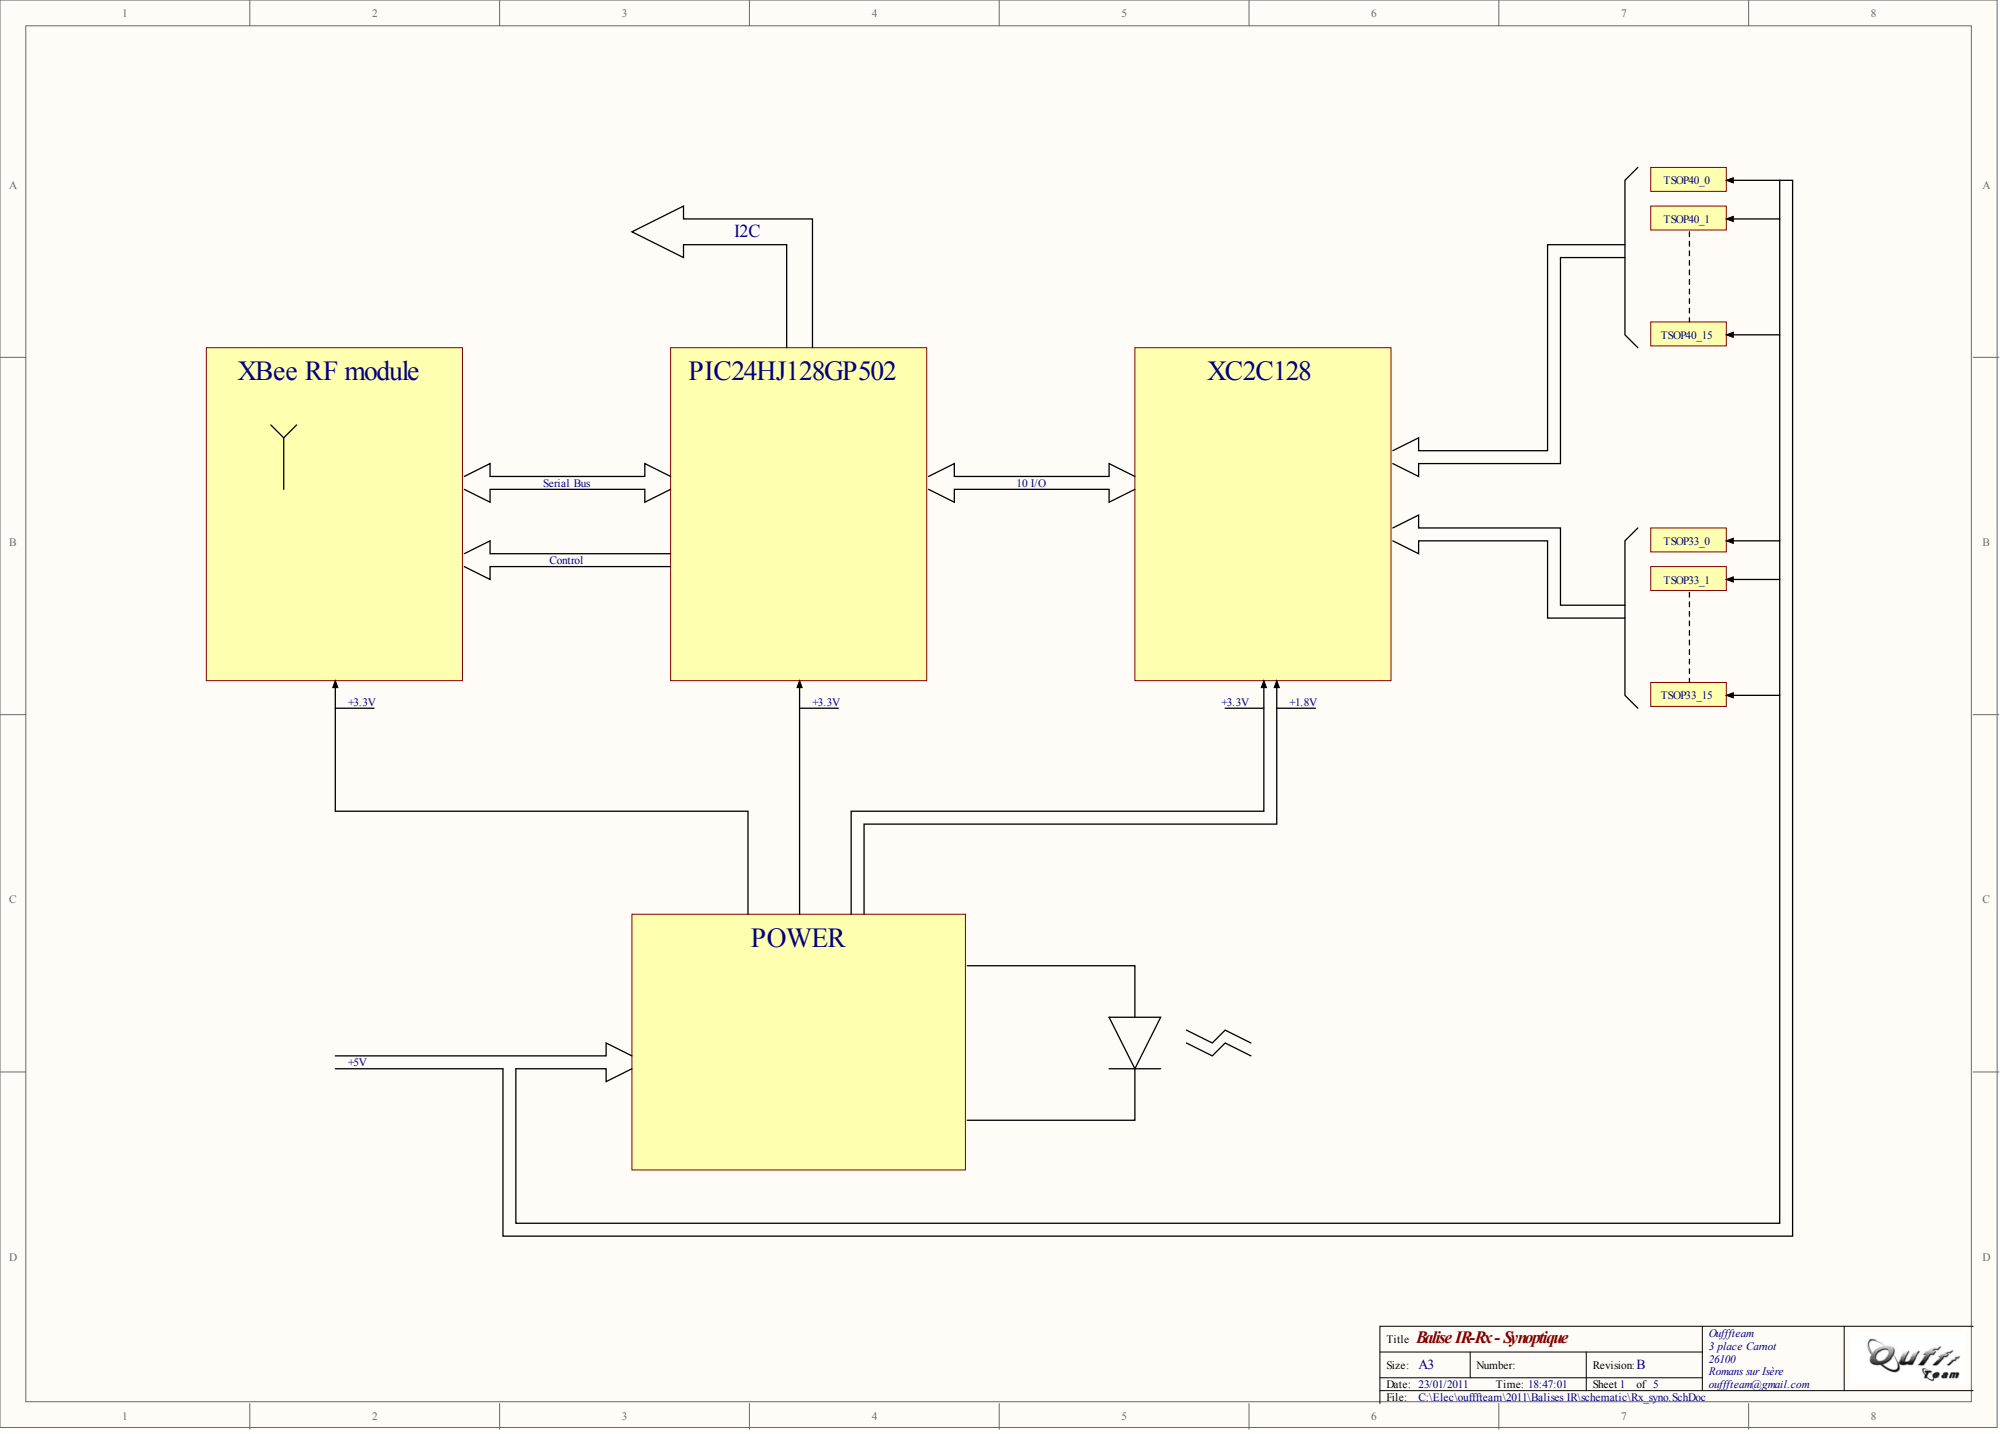
[picture p277: page 1]

Balise IR-Rx - Synoptique Title | Oufffteam 3 place Carnot Romans sur Isère oufffteam@gmail.com

A3 Size: | Number: | B Revision:

Date: 23/01/2011 Time: 18:47:01 | | Sheet of 5

C:\Elec\oufffteam\2011\Balises IR\schematic\Rx_syno.SchDoc

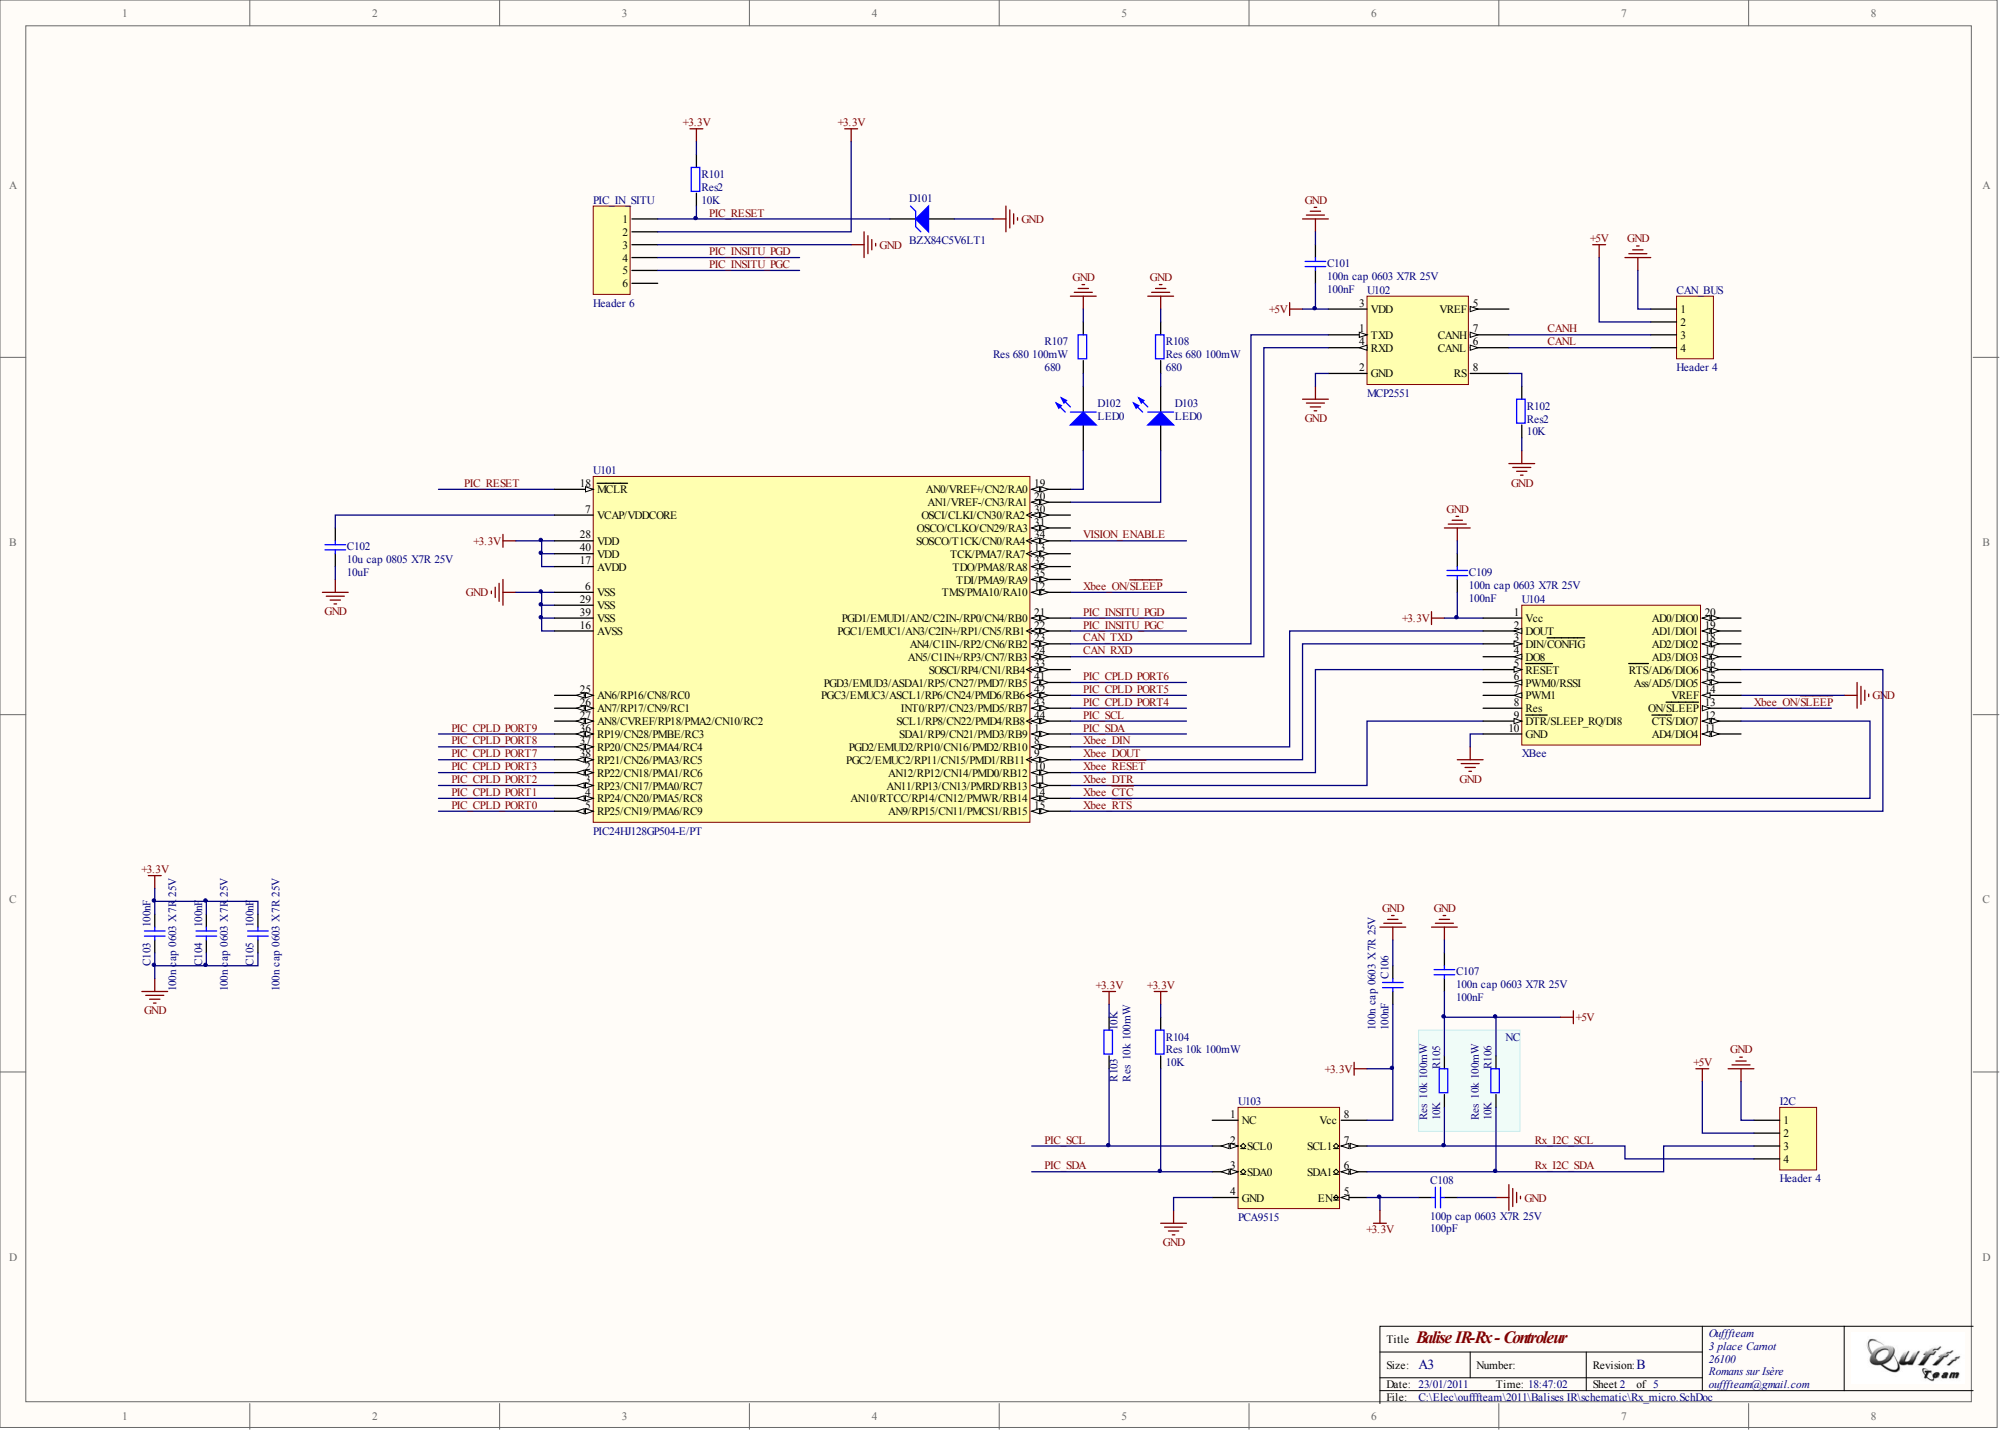
[picture p278: page 2]

R108 | RXD 4 | CANL

LED0 | LED0 | GND 2

Balise IR-Rx - Controleur

C:\Elec\oufffteam\2011\Balises IR\schematic\Rx_micro.SchDoc

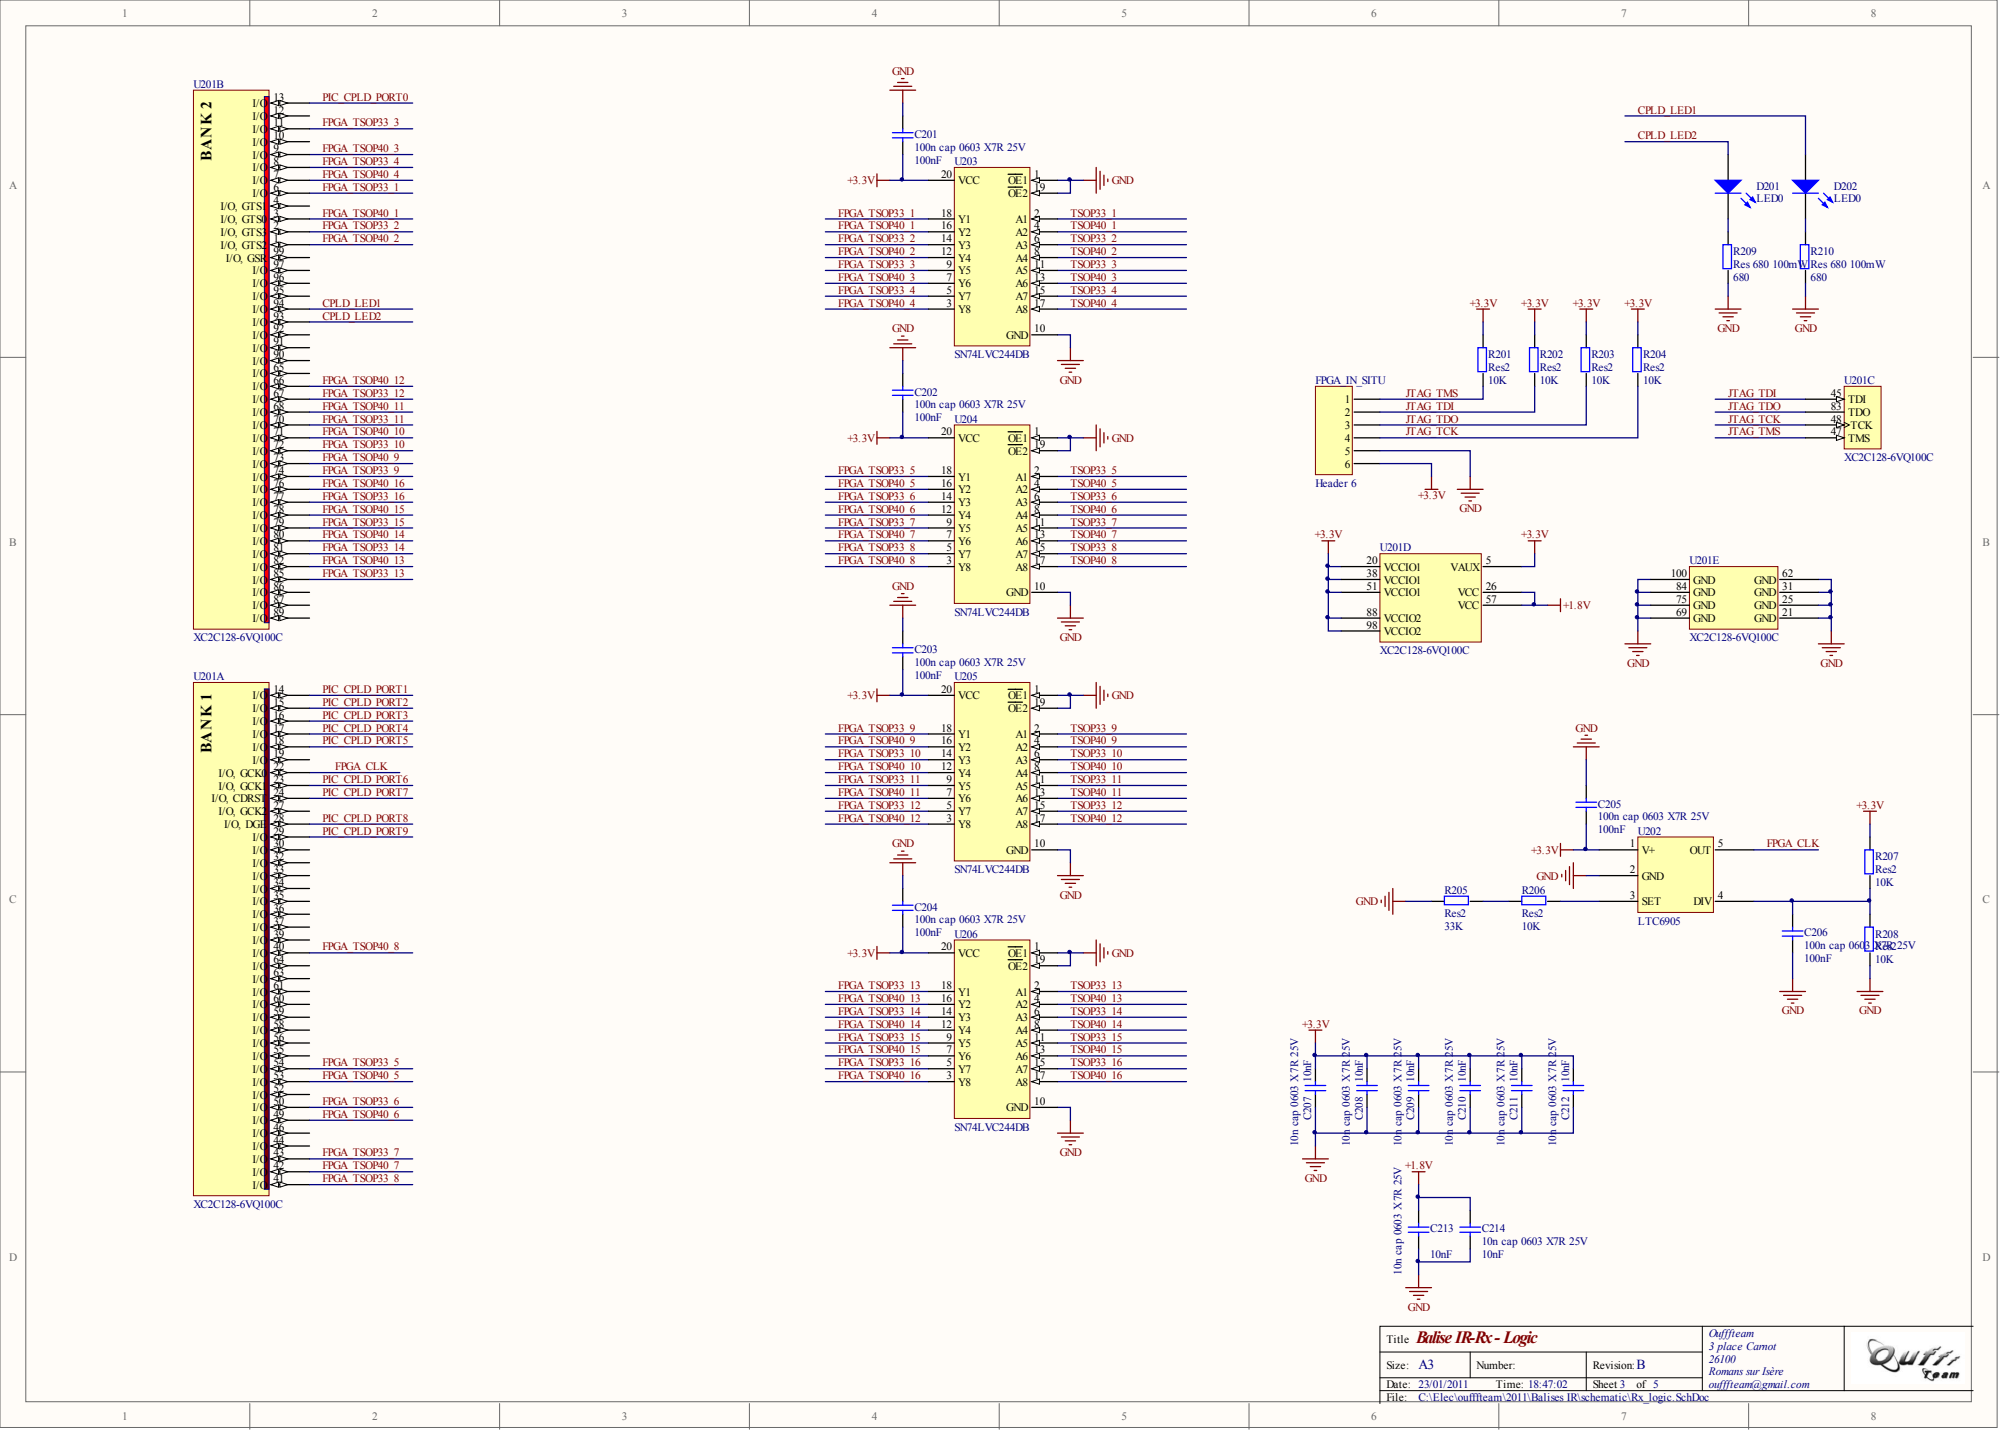
[picture p279: page 3]

GND GND

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

S i z e : | Num b e r : | Re v i si o n :

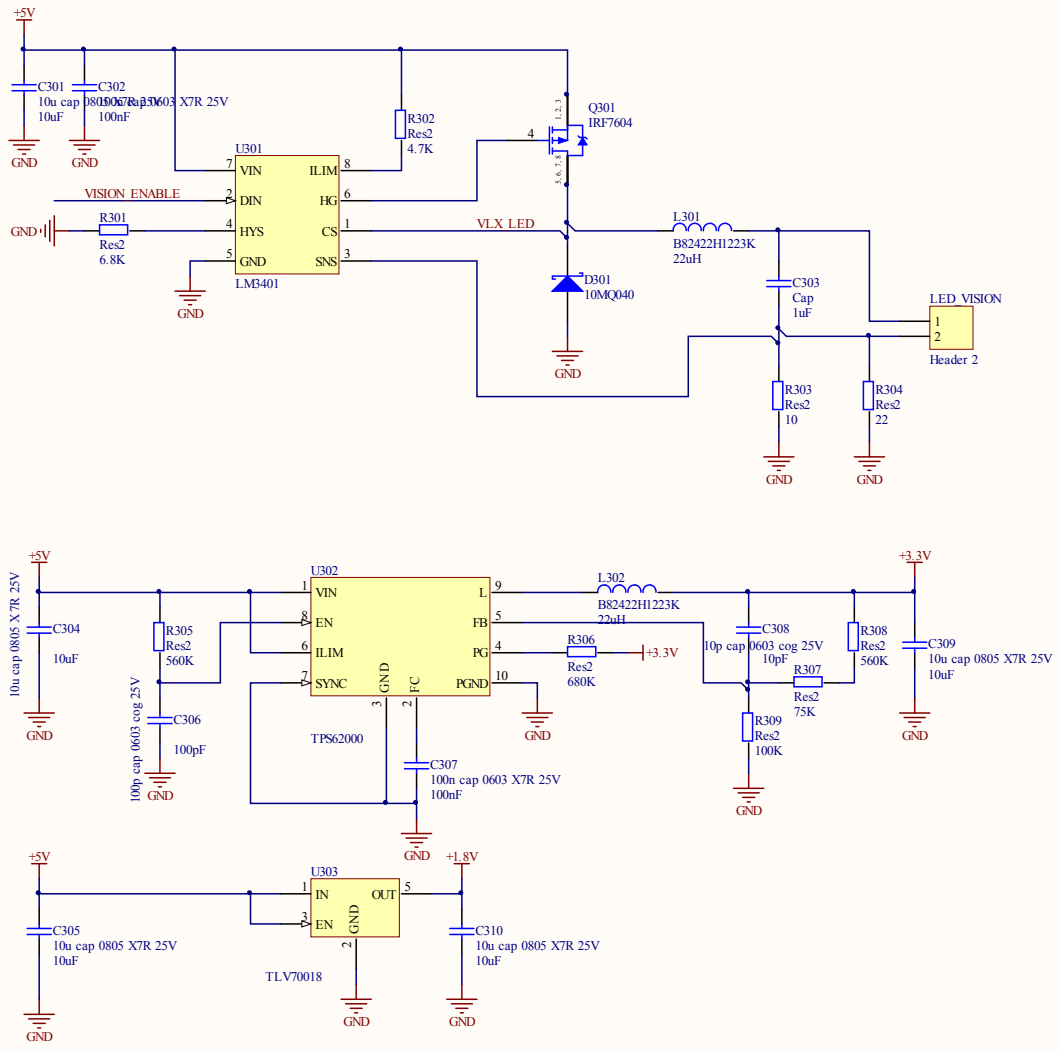
[picture p280: page 4]

Balise IR-Rx - Power

C:\Elec\oufffteam\2011\Balises IR\schematic\Rx_power.SchDoc

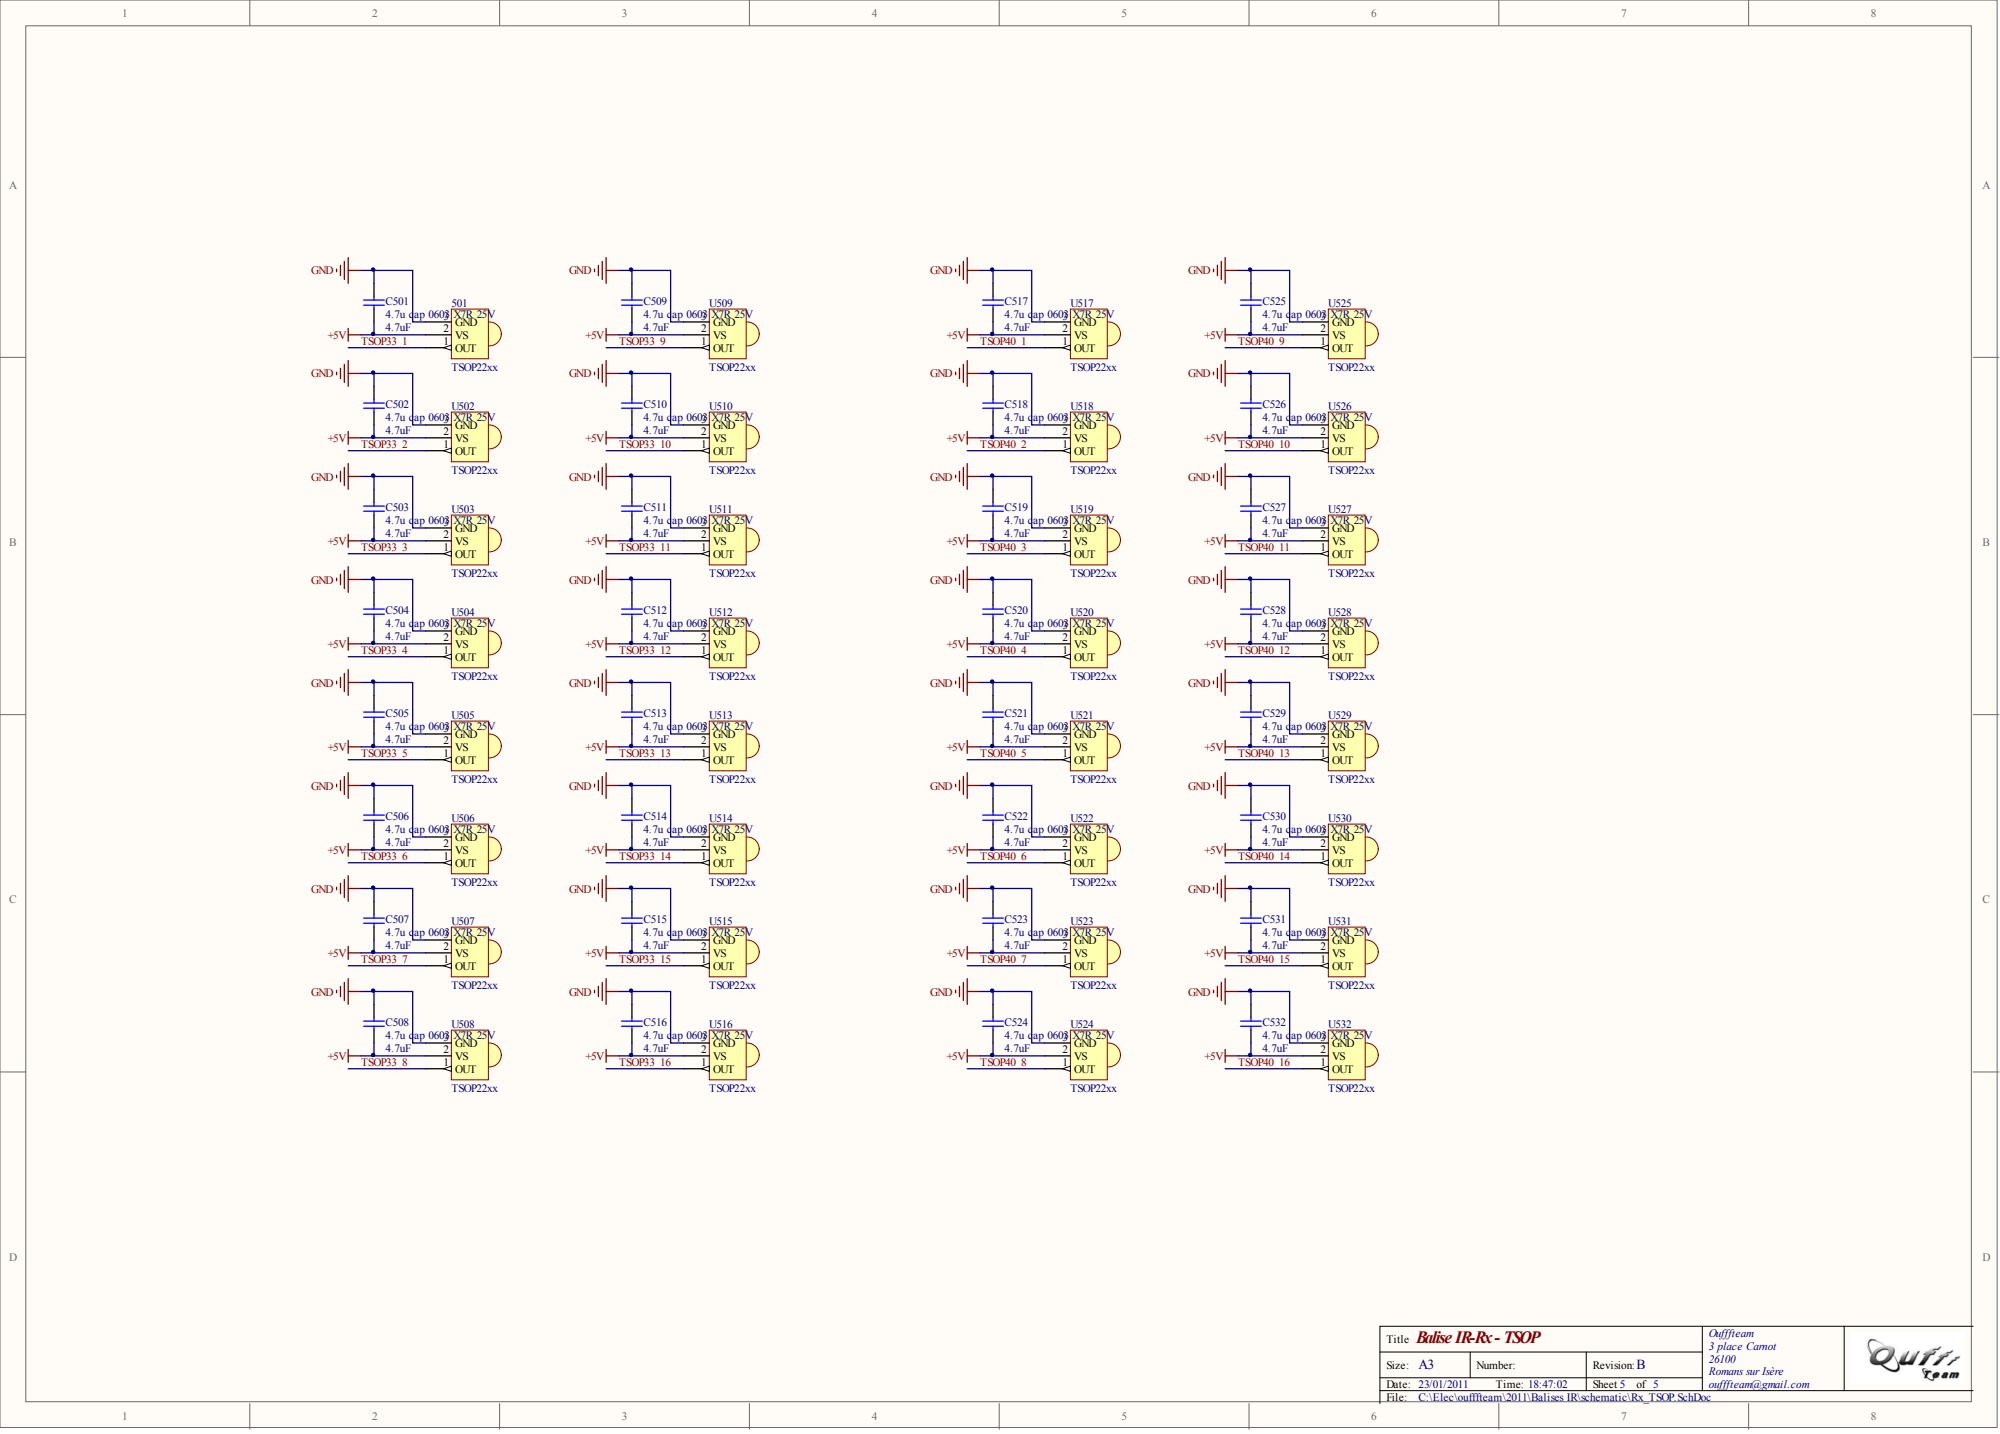
[picture p281: page 5]
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

S i z e : | Num b e r : | Re v i si o n :

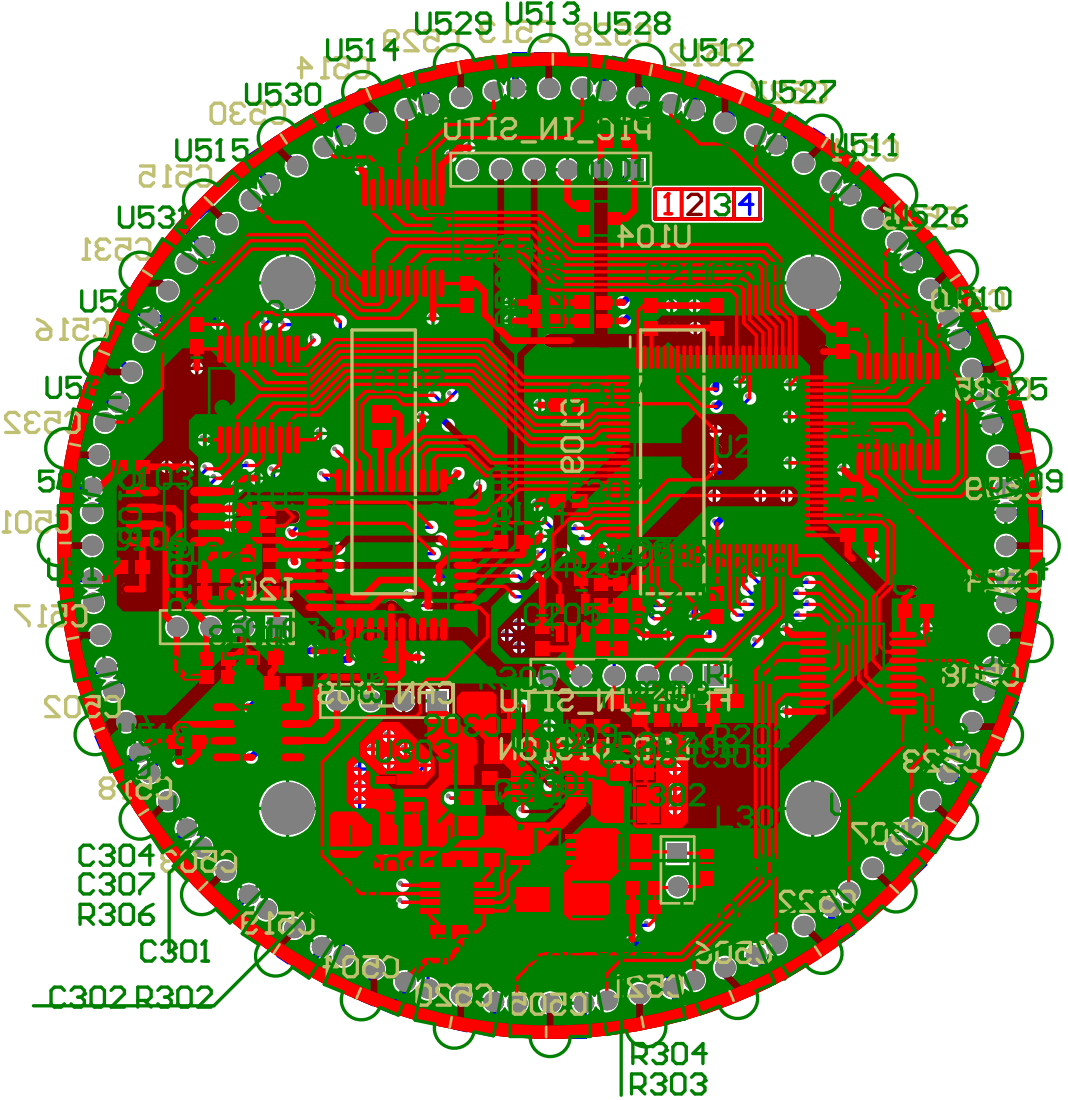
[picture p282: page 6]

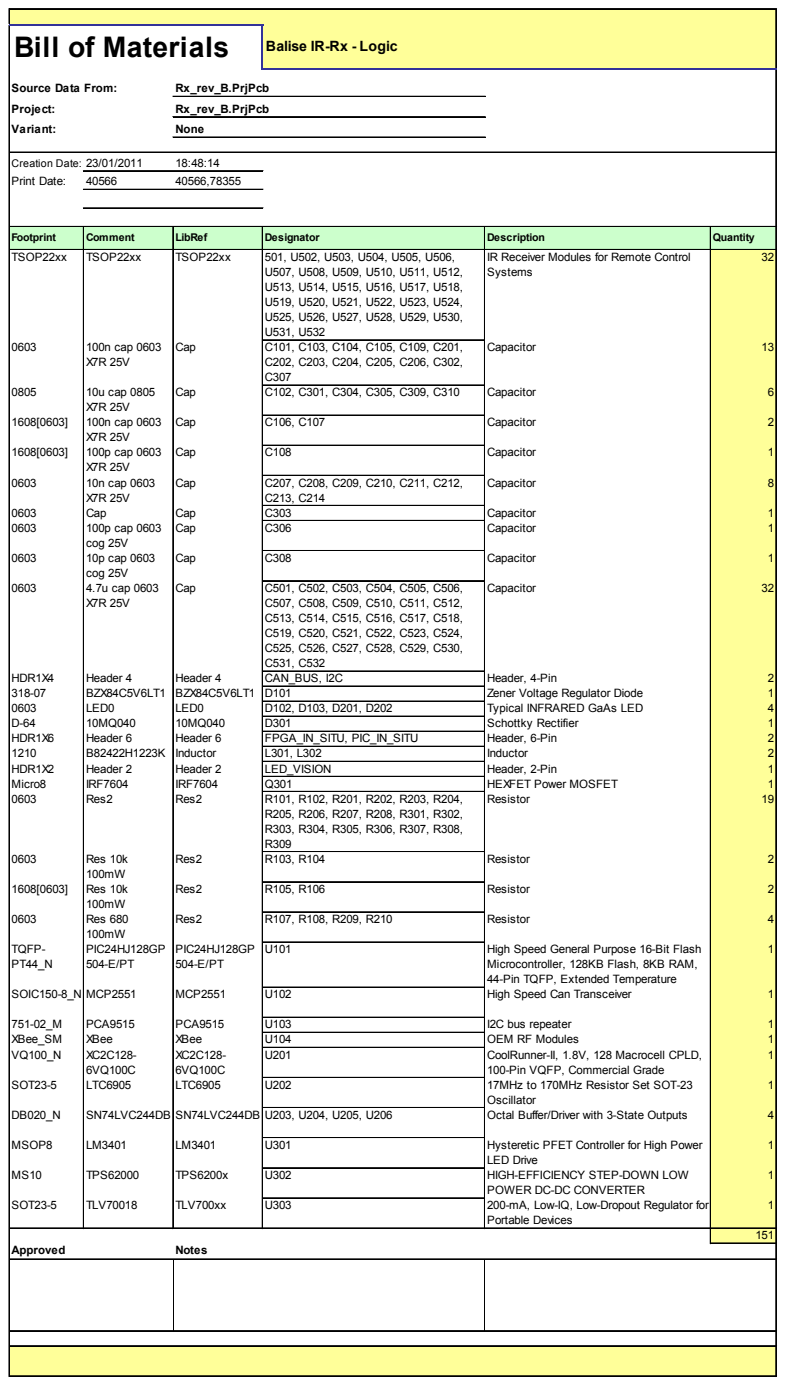
[picture p283: page 7]

Footprint | Comment | LibRef | Designator | Description | Quantity

IR Receiver Modules for Remote Control
Systems

Microcontroller, 128KB Flash, 8KB RAM,
44-Pin TQFP, Extended Temperature

100-Pin VQFP, Commercial Grade

POWER DC-DC CONVERTER
