massinissalounis/oufffteam/Elec/2010/CM/Schematic/Ocore.pdf

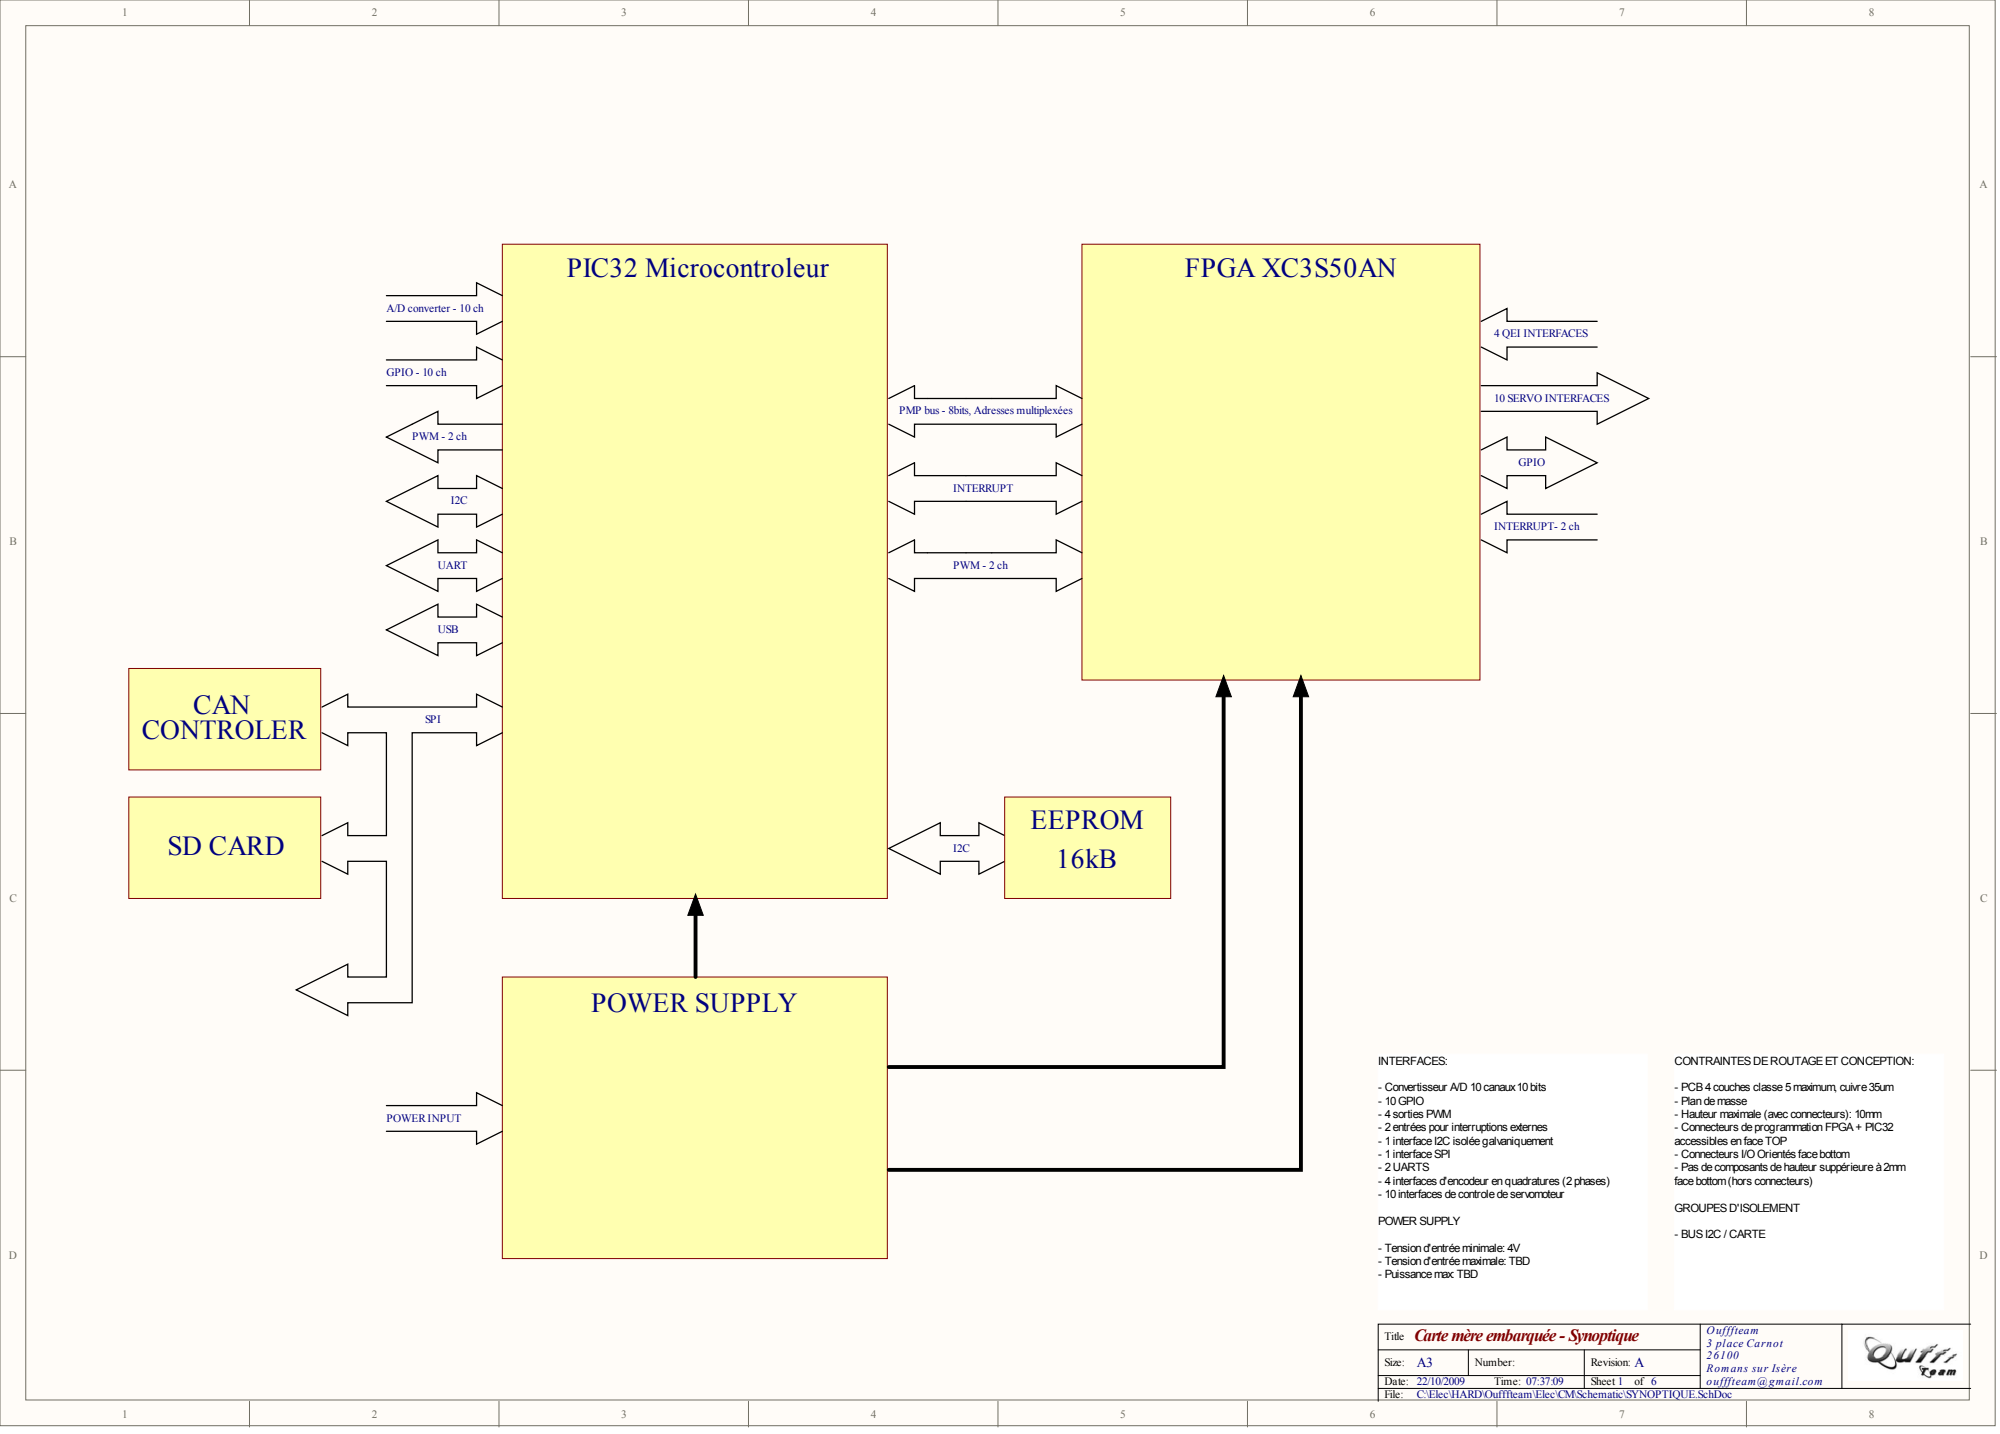
[picture p284: page 1]

PMP bus - 8bits, Adresses multiplexées

- Convertisseur A/D 10 canaux10 bits
- 10GPIO
- 4 sorties PWM
- 2 entrées pour interruptions externes
- 1 interface I2C isolée galvaniquement
- 1 interfaceSPI
- 2UARTS
- 4 interfaces d'encodeur en quadratures (2 phases)
- 10 interfaces de controle de servomoteur

- PCB4 couches classe 5 maximum, cuivre 35um
- Plan de masse
- Hauteur maximale (avec connecteurs): 10mm
- Connecteurs de programmationFPGA+ PIC32
accessibles en faceTOP
- Connecteurs I/OOrientés face bottom
- Pas de composants de hauteur suppérieure à 2mm
face bottom(hors connecteurs)

- Tension d'entrée minimale: 4V
- Tension d'entrée maximale: TBD
- Puissance max: TBD

Title Carte mère embarquée - Synoptique | Oufffteam 3 place Carnot Romans sur Isère oufffteam@gmail.com

Size: A3 | Number: | Revision: A

Date: 22/10/2009 Time: 07:37:09 | | Sheet of 6

C:\Elec\HARD\Oufffteam\Elec\CM\Schematic\SYNOPTIQUE.SchDoc

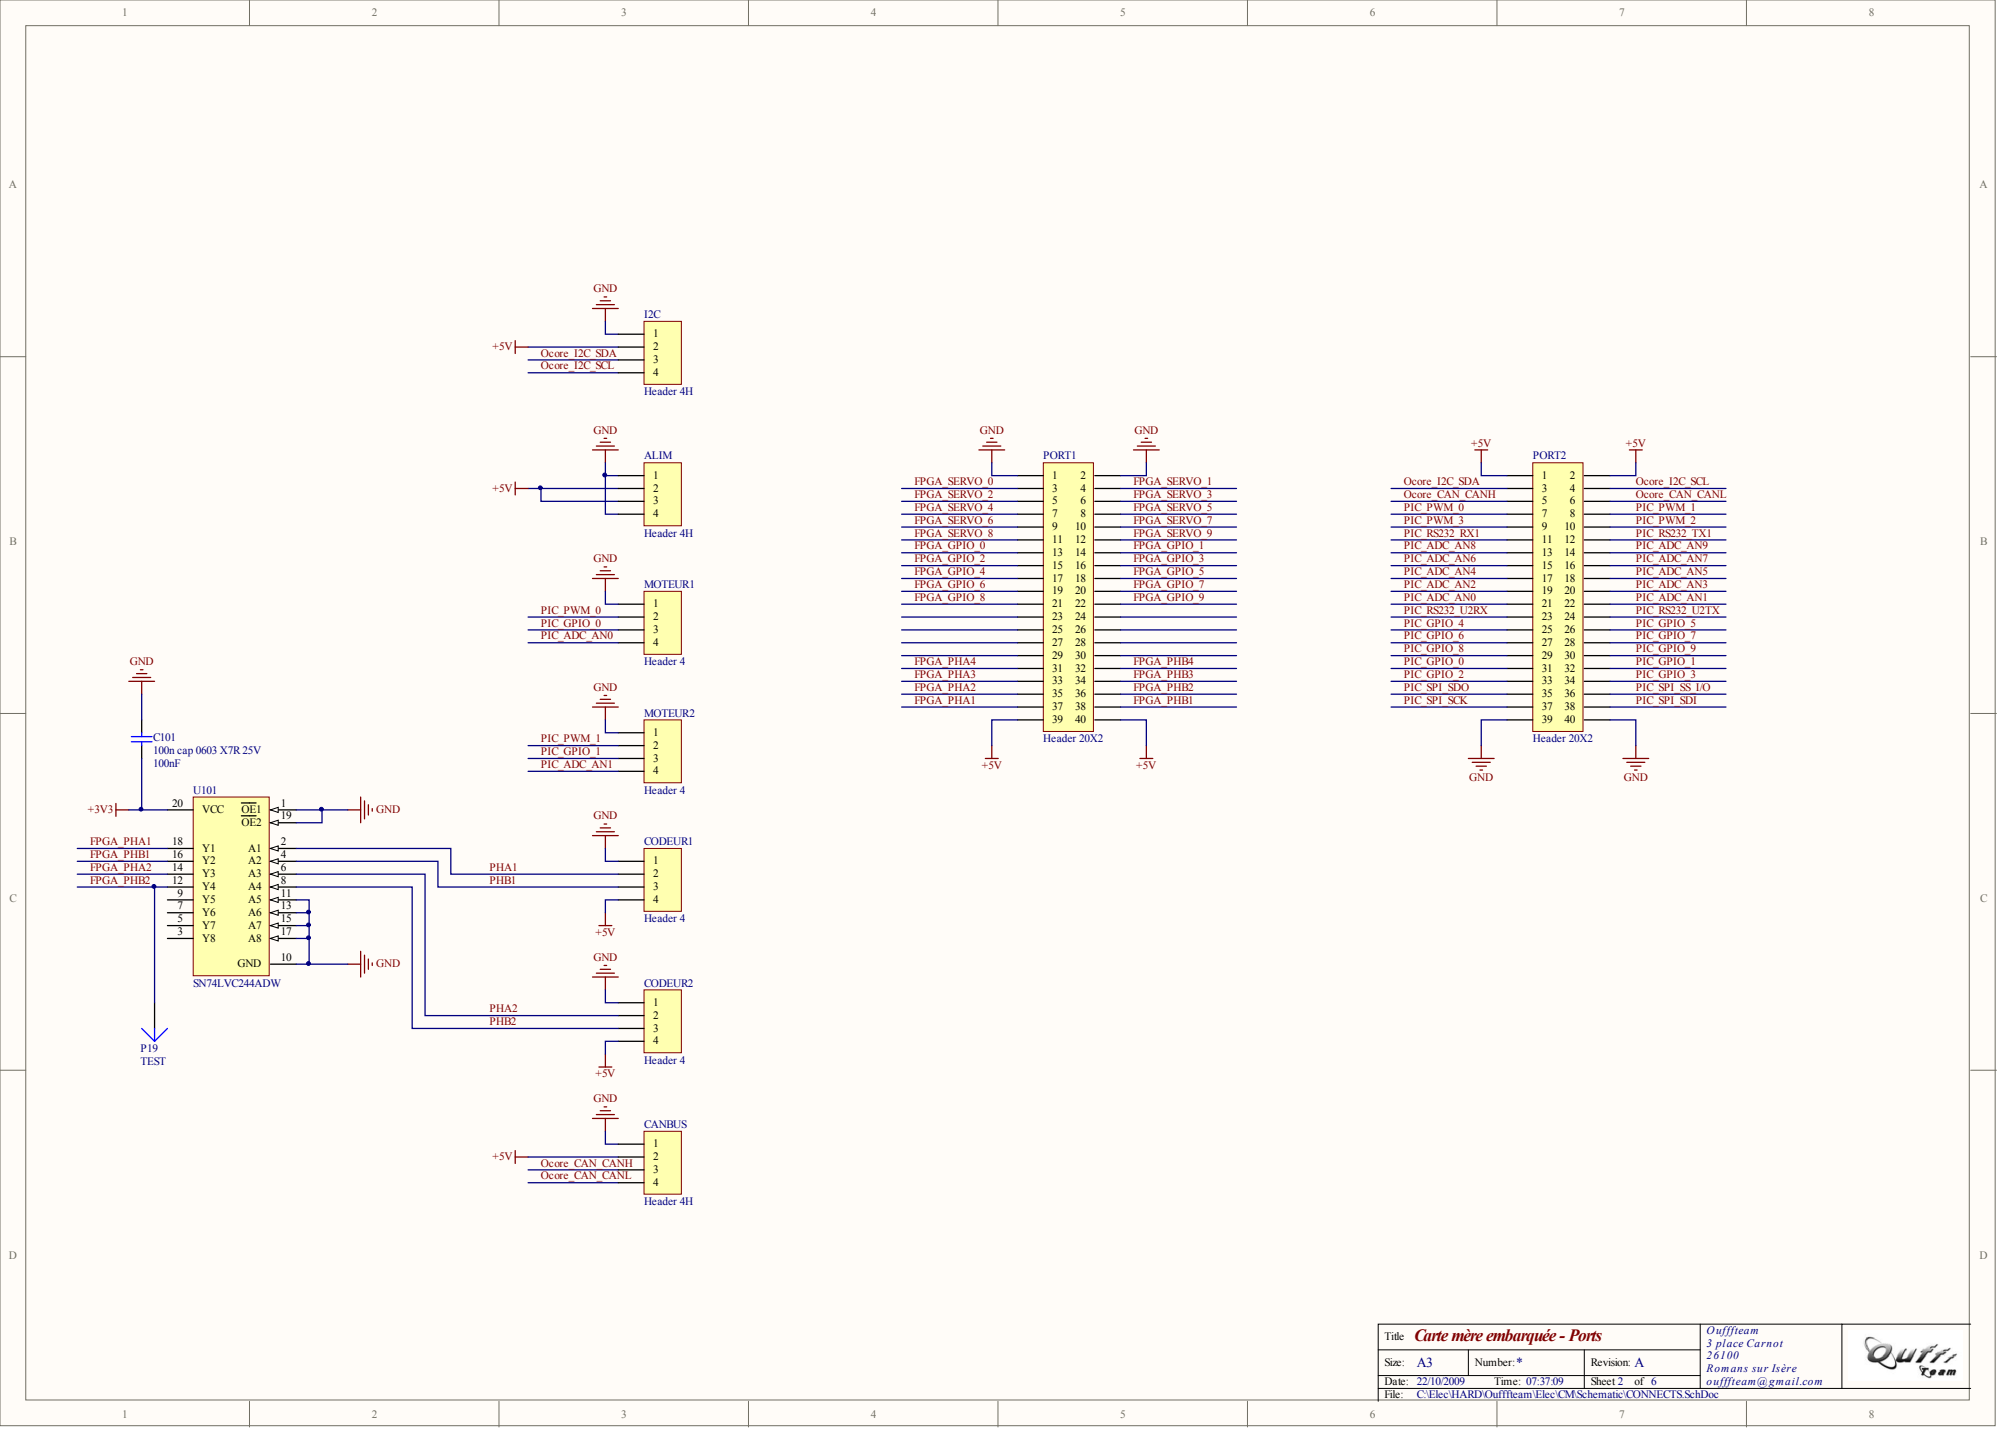
[picture p285: page 2]

Carte mère embarquée - Ports

C:\Elec\HARD\Oufffteam\Elec\CM\Schematic\CONNECTS.SchDoc

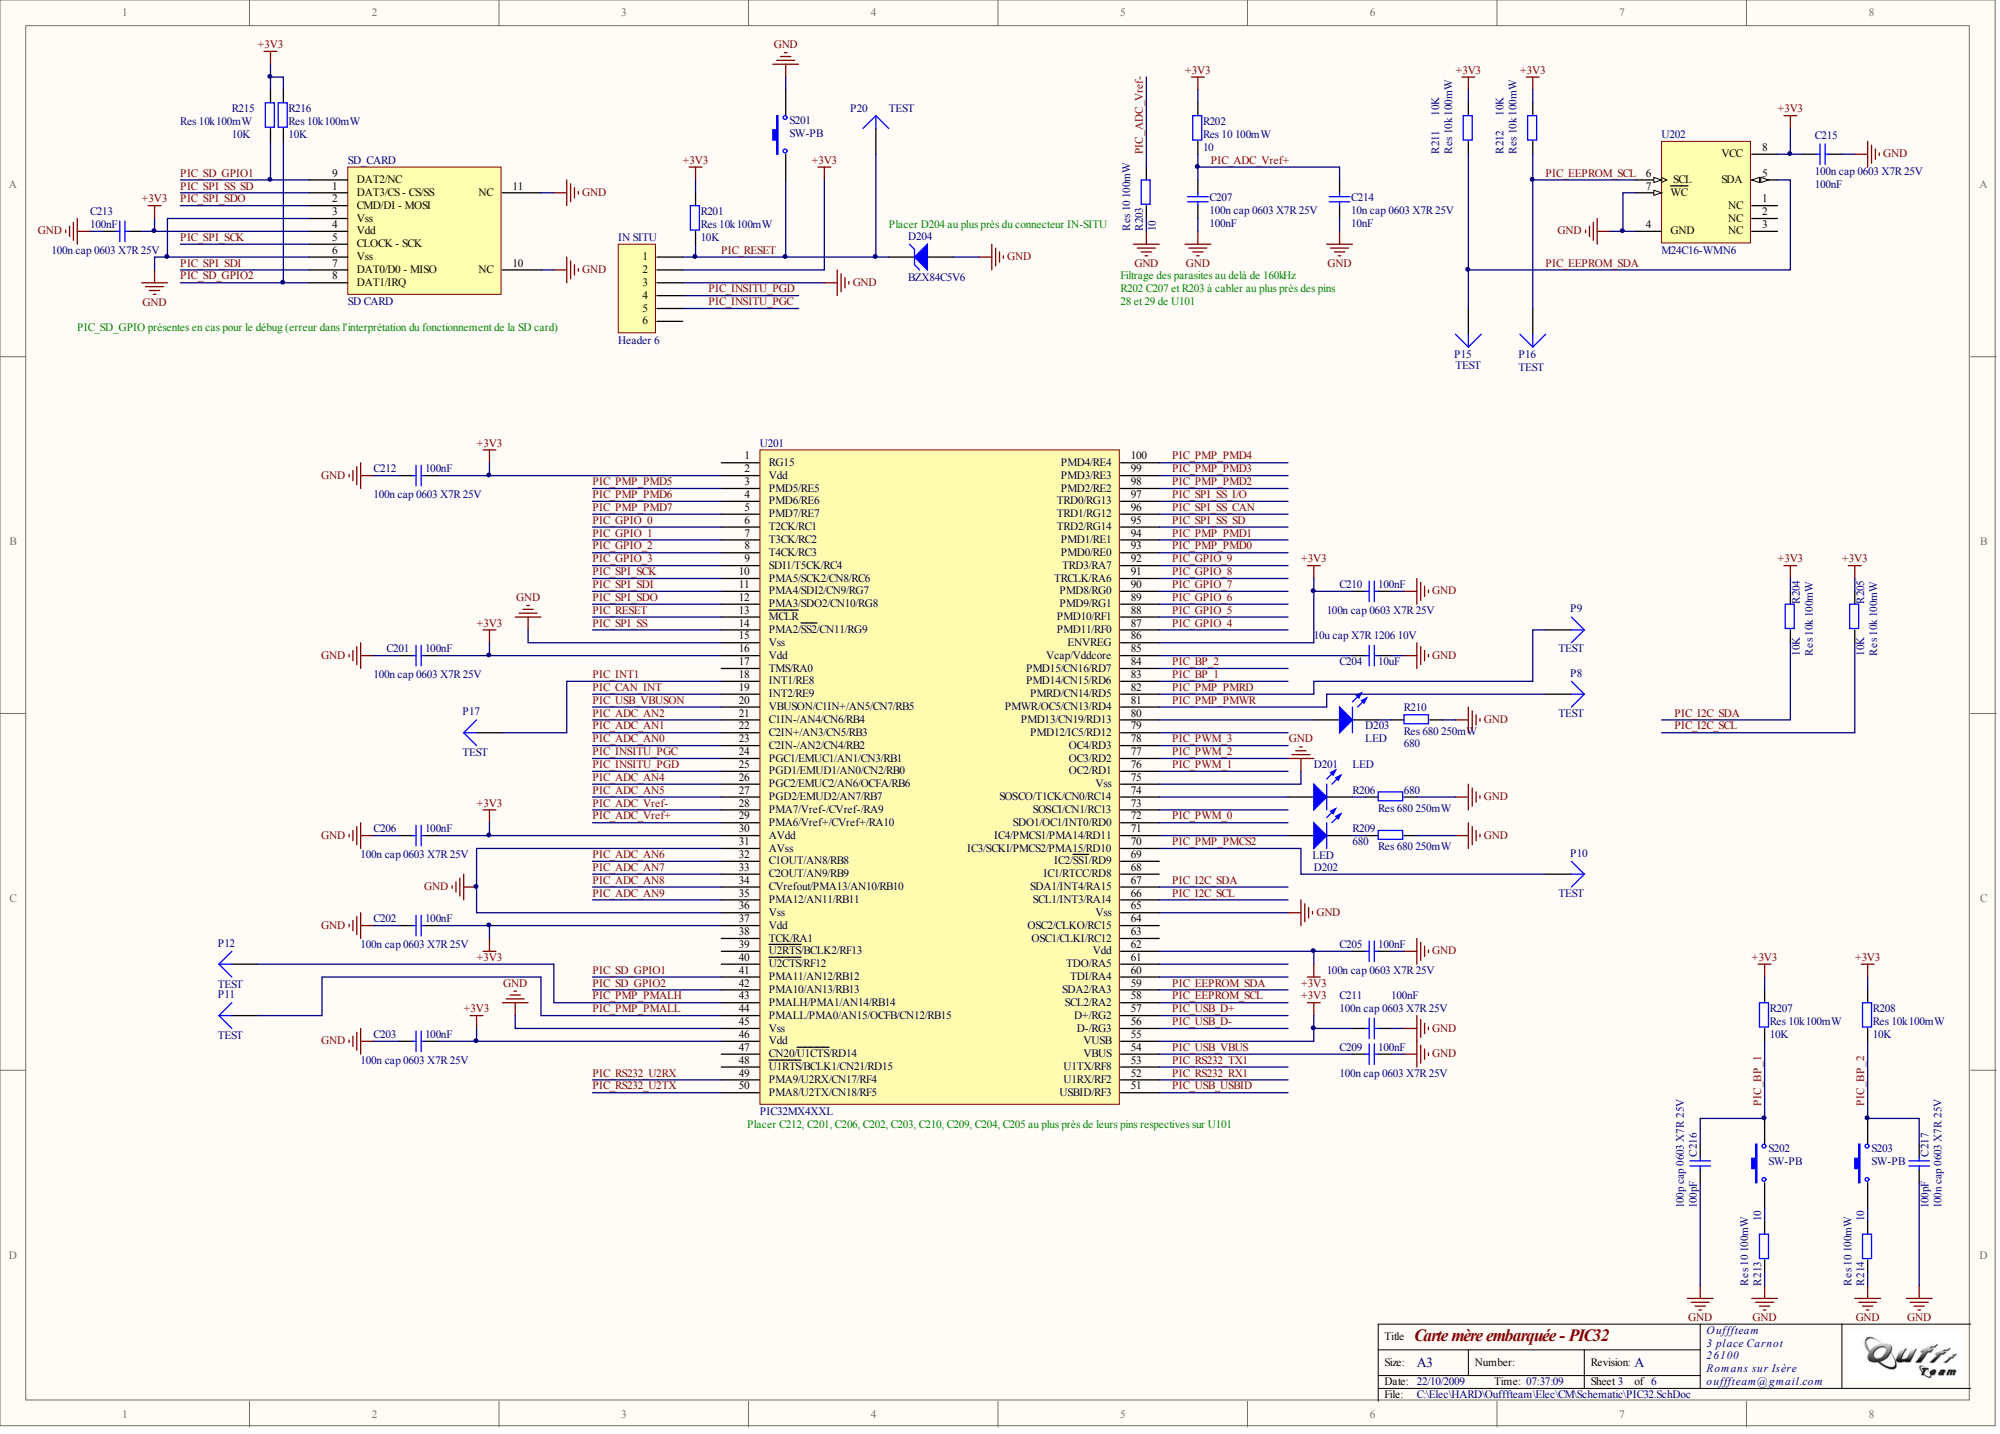
[picture p286: page 3]

PIC_EEPROM_SCL | SDA NC | 5 SCL 6 3 GND 4
PIC_EEPROM_SDA | | WC 7

Placer D204 au plus près du connecteur IN-SITU

PIC_SPI_SCK

Filtrage des parasites au delà de 160kHz
R202 C207 et R203 à cabler au plus près des pins

PIC_SD_GPIO présentes en cas pour le débug (erreur dans l'interprétation du fonctionnement de la SD card)

AVss 31 | PIC_PMP_PMCS2 | 680

PIC_ADC_AN6 PIC_ADC_AN7 PIC_ADC_AN8 | | C1OUT/AN8/RB8 32 C2OUT/AN9/RB9 33 CVrefout/PMA13/AN10/RB10 34 PMA12/AN11/RB11 35 Vss 36 | | LED D202

PIC_PMP_PMALL | PMALL/PMA0/AN15/OCFB/CN12/RB15 44

Vss 45

CN20/U1CTS/RD14 47 | PIC_USB_VBUS

PIC32MX4XXL
Placer C212, C201, C206, C202, C203, C210, C209, C204, C205 au plus près de leurs pins respectives sur U101

C:\Elec\HARD\Oufffteam\Elec\CM\Schematic\PIC32.SchDoc

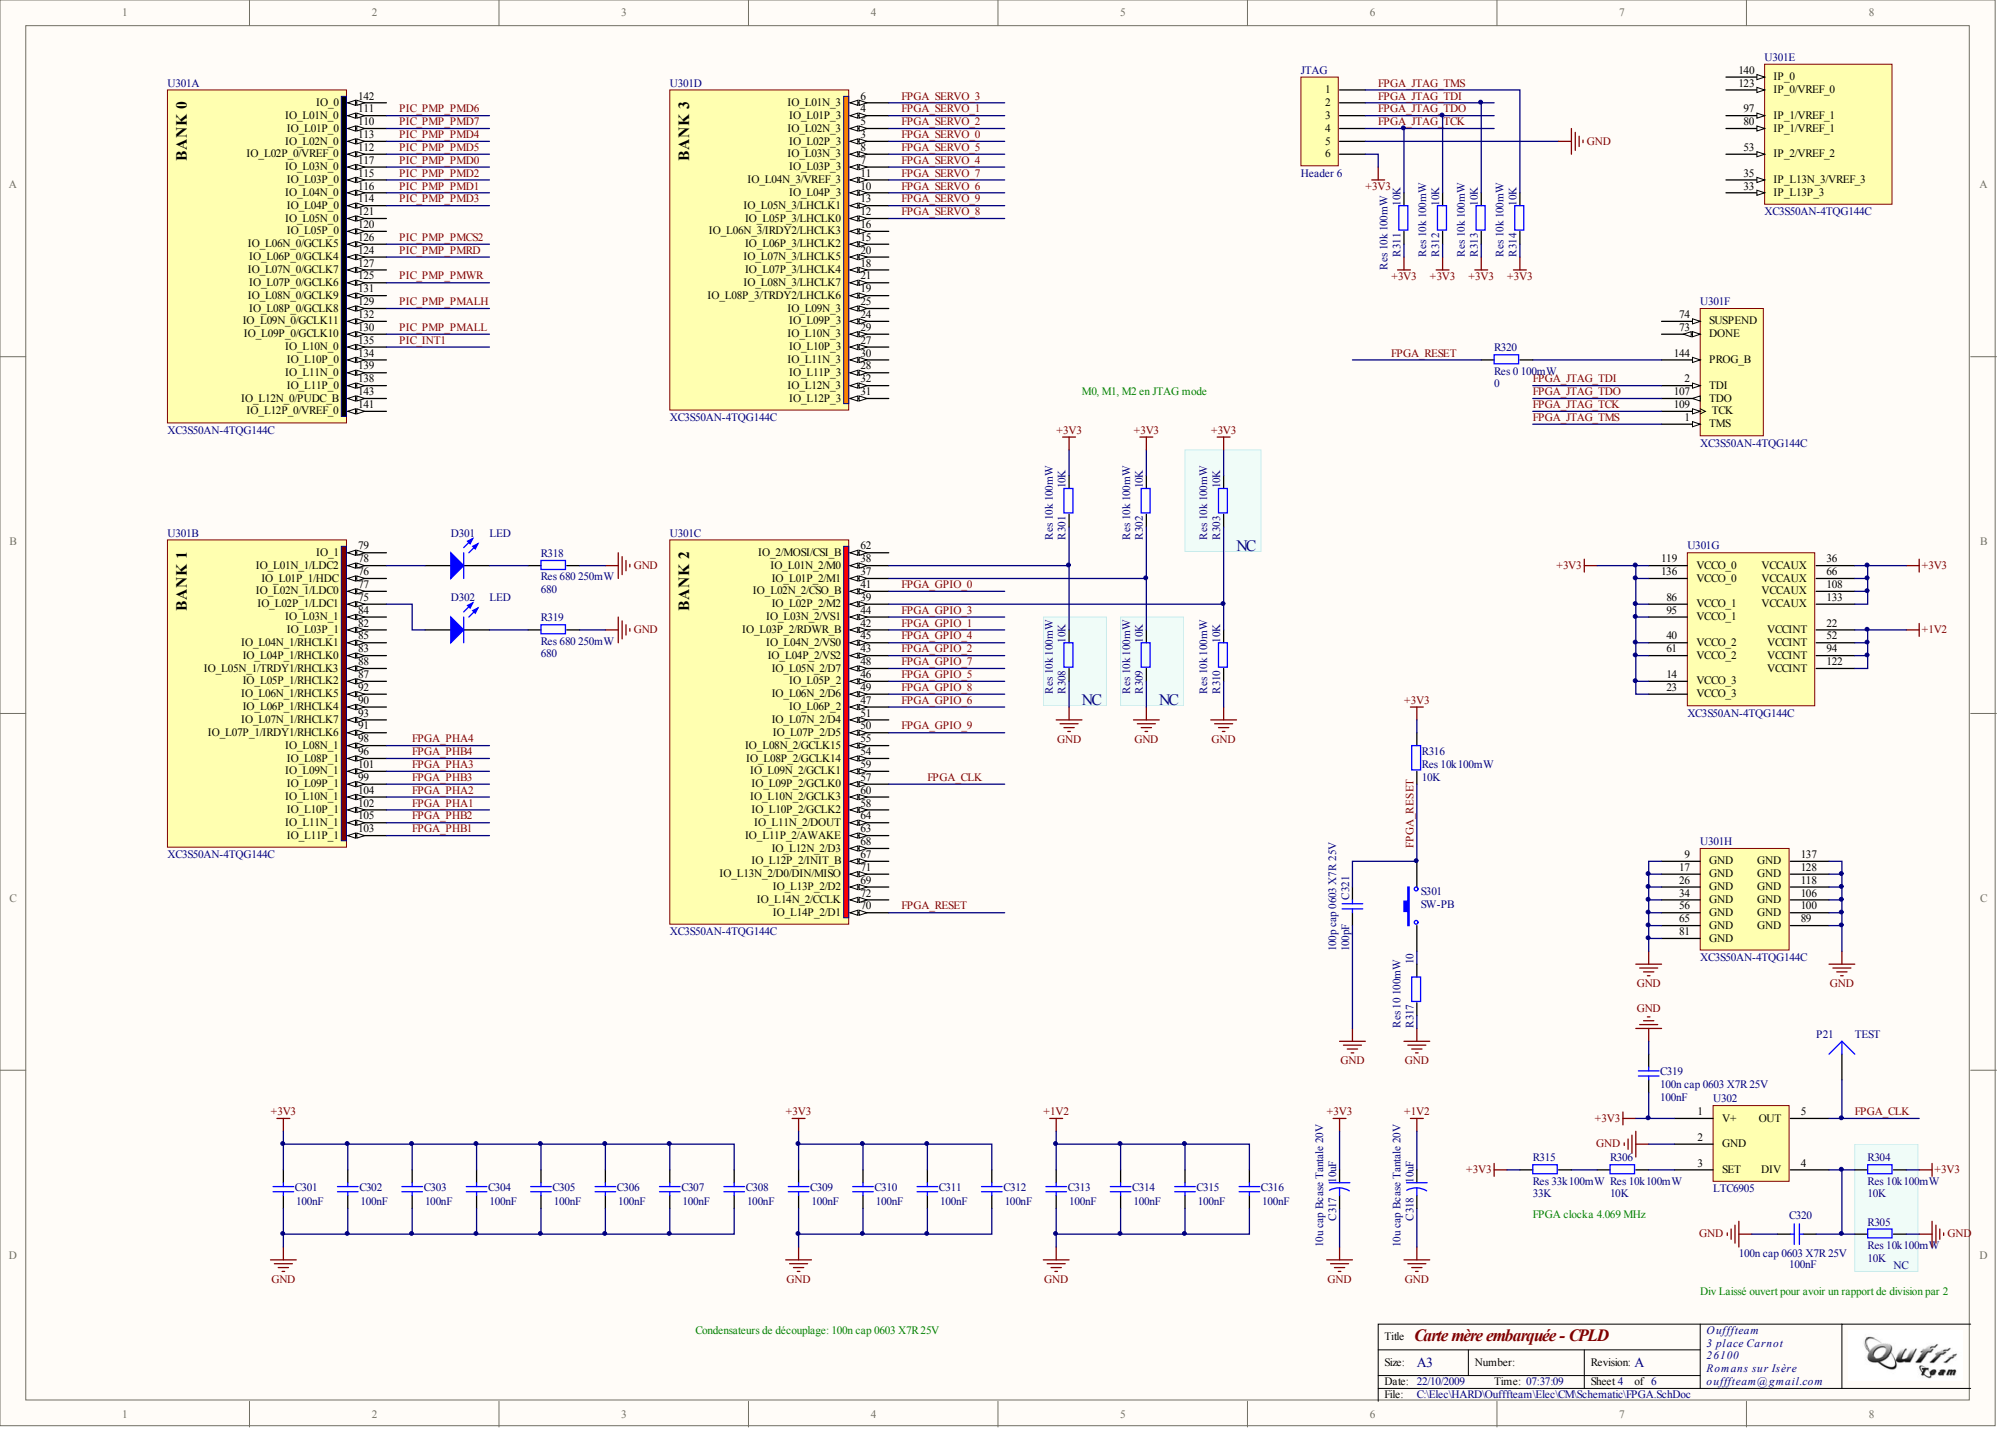
[picture p287: page 4]

FPGA_JTAG_TDO
FPGA_JTAG_TCK

VCCO_1 95

VCCO_2 40

VCCO_3 14
VCCO_3 23

GND 17

GND 34
GND 56
GND 65

Div Laissé ouvert pour avoir un rapport de division par 2

Condensateurs de découplage: 100n cap 0603 X7R25V

Carte mère embarquée - CPLD

C:\Elec\HARD\Oufffteam\Elec\CM\Schematic\FPGA.SchDoc

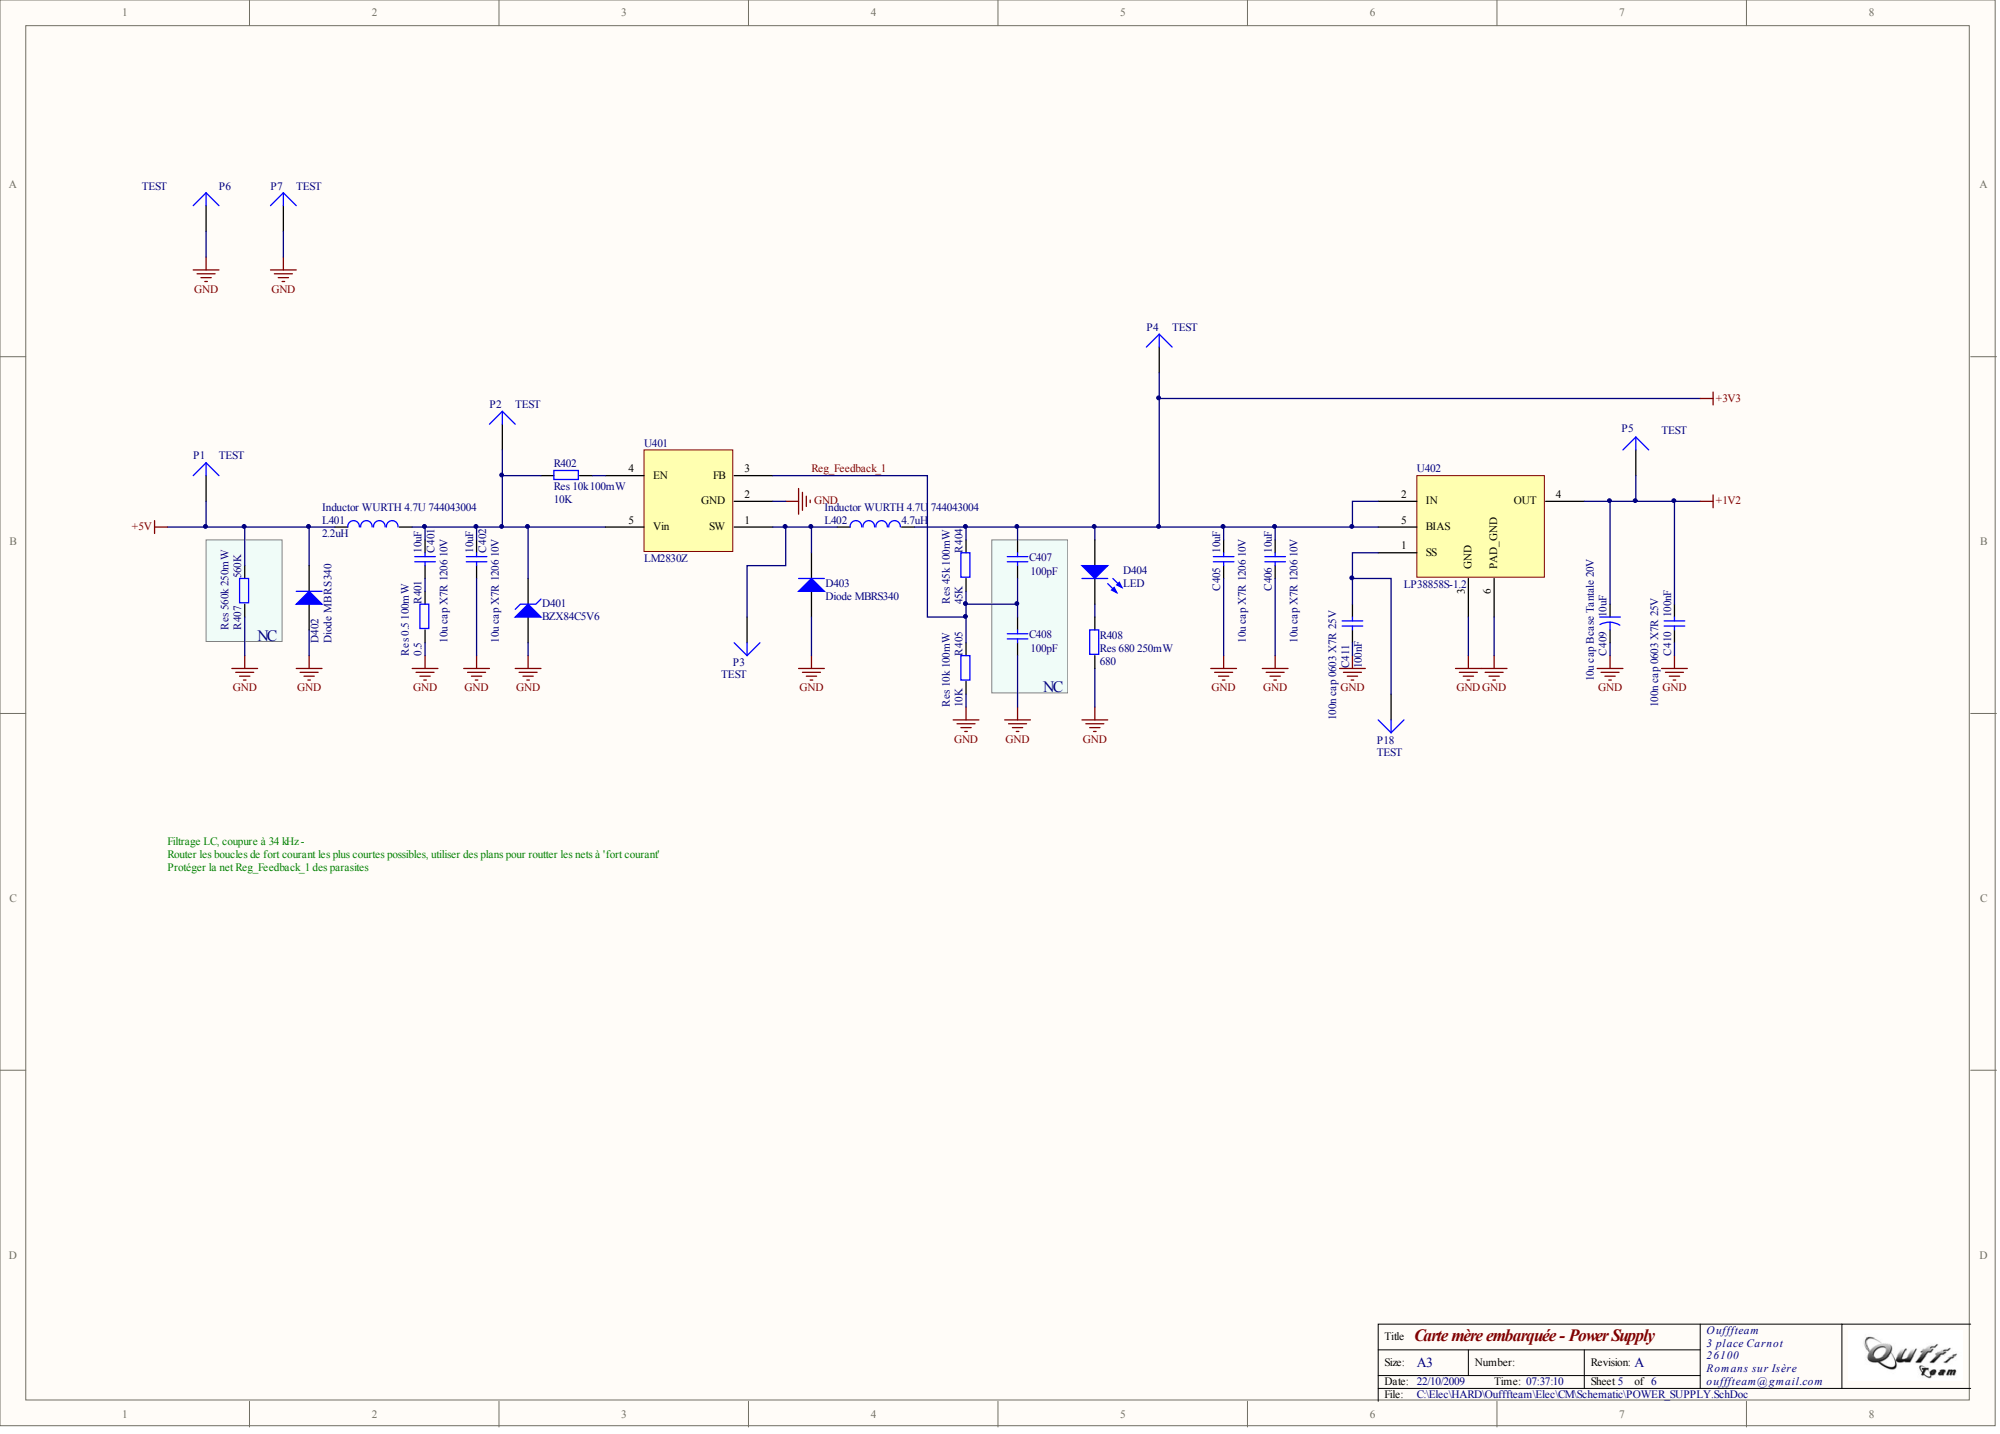
[picture p288: page 5]
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

Si ze : | Num b e r : | Re v i s i o n :

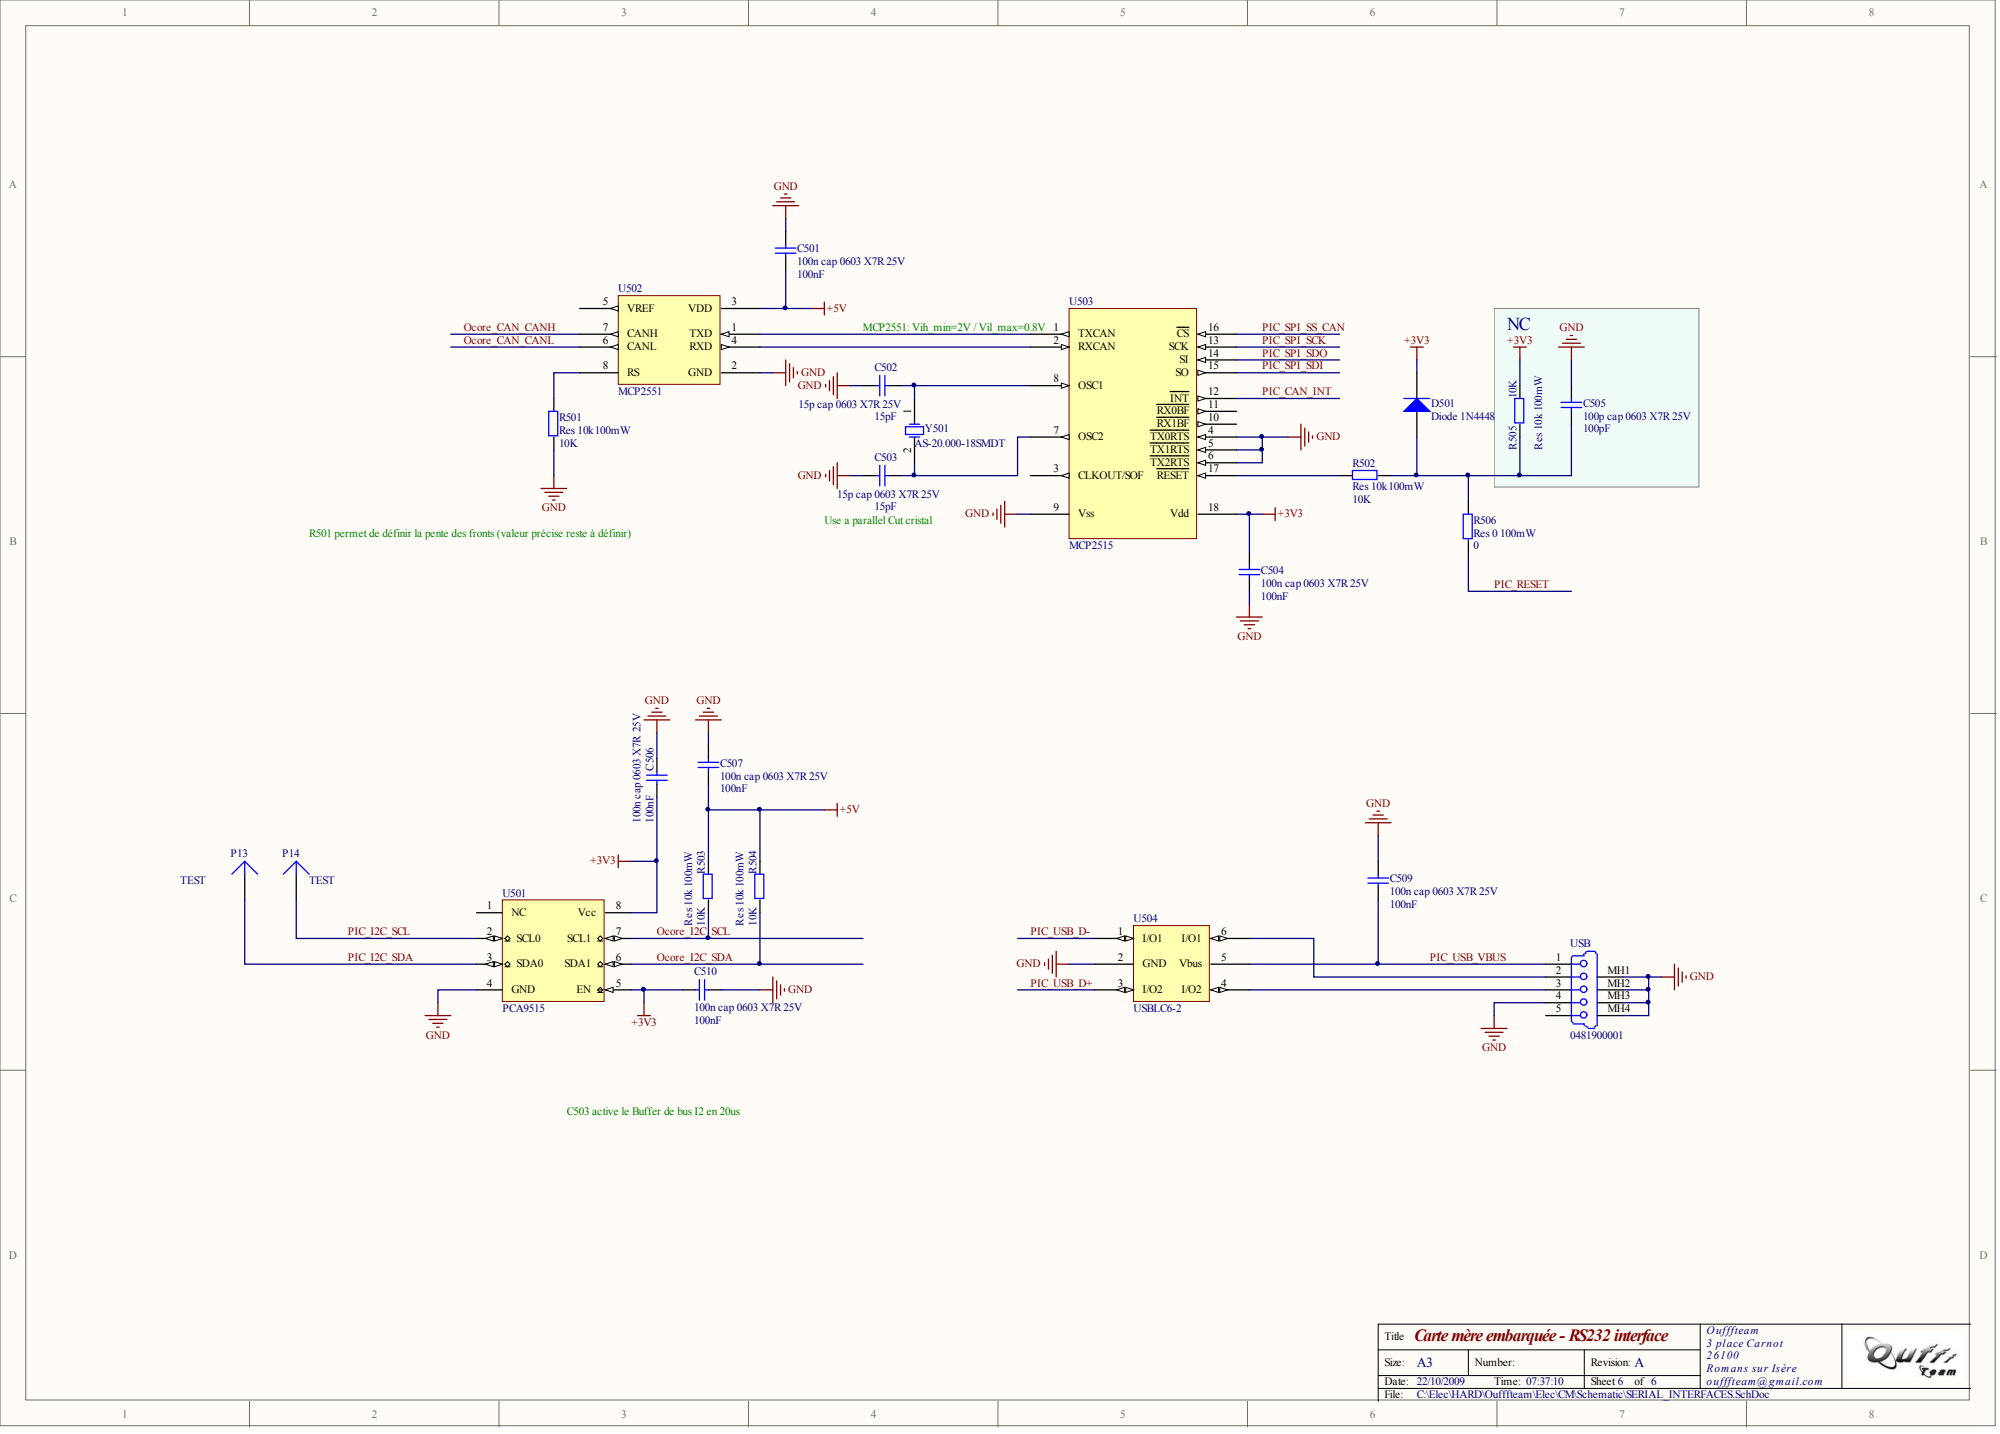
[picture p289: page 6]

Use a parallel Cut cristal

R501 permet de définir la pente des fronts (valeur précise reste à définir)

4 | | MH3
5 | | MH4

C503 active le Buffer de bus I2 en 20us

Carte mère embarquée - RS232 interface

C:\Elec\HARD\Oufffteam\Elec\CM\Schematic\SERIAL_INTERFACES.SchDoc
