massinissalounis/oufffteam/Meca/Plans Robot 2013/Petit robot/Robot_2011/Structure/essai_architecture_8.PDF

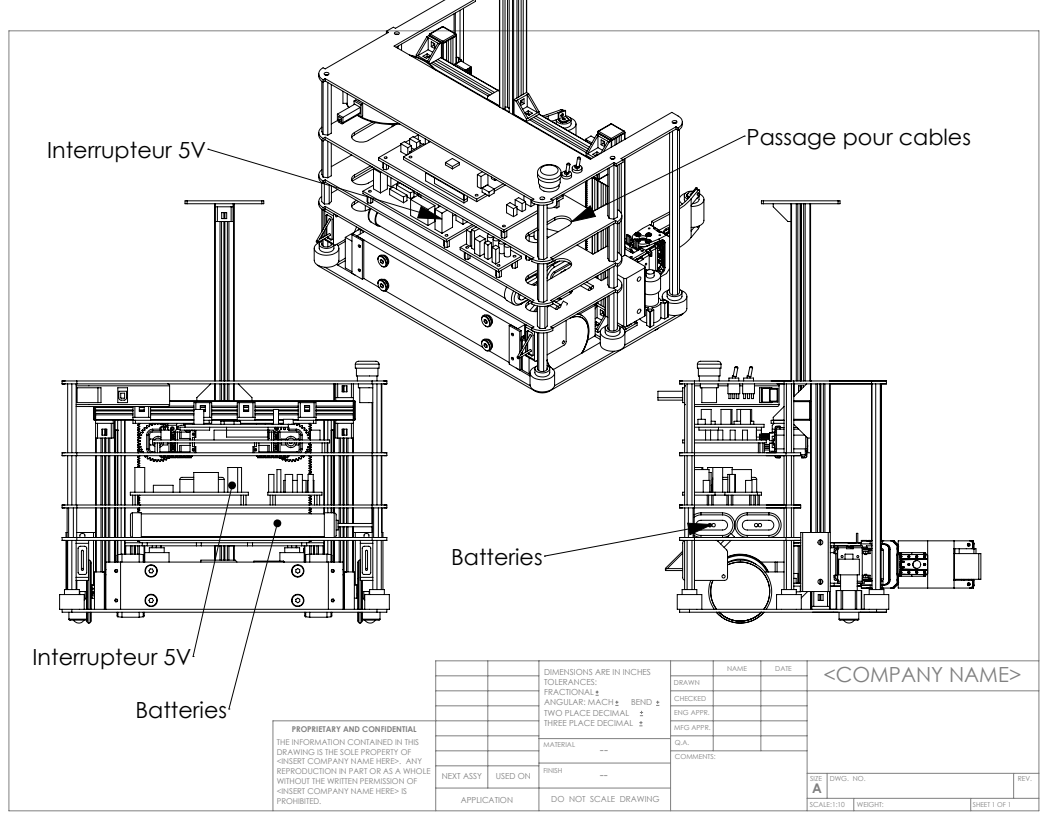
[picture p290: page 1]
Interrupteur 5V; Passage pour cables

DIMENSIONS ARE IN INCHES TOLERANCES: FRACTIONAL ANGULAR: MACH BEND TWO PLACE DECIMAL THREE PLACE DECIMAL | | NAME | DATE | <COMPANY NAME>

DRAWN
CHECKED
ENG APPR.

PROPRIETARY AND CONFIDENTIAL THE INFORMATION CONTAINED IN THIS DRAWING IS THE SOLE PROPERTY OF <INSERT COMPANY NAME HERE>. ANY REPRODUCTION IN PART OR AS A WHOLE WITHOUT THE WRITTEN PERMISSION OF <INSERT COMPANY NAME HERE> IS PROHIBITED. | | | MFG APPR.

MATERIAL -- | Q.A.

NEXT ASSY | USED ON | FINISH --

SIZE A REV. | DWG. NO.

APPLICATION | | DO NOT SCALE DRAWING

SCALE:1:10 | WEIGHT: | SHEET 1 OF 1
