massinissalounis/oufffteam/Meca/Cartes Electronique/carte_connectique_CM.pdf

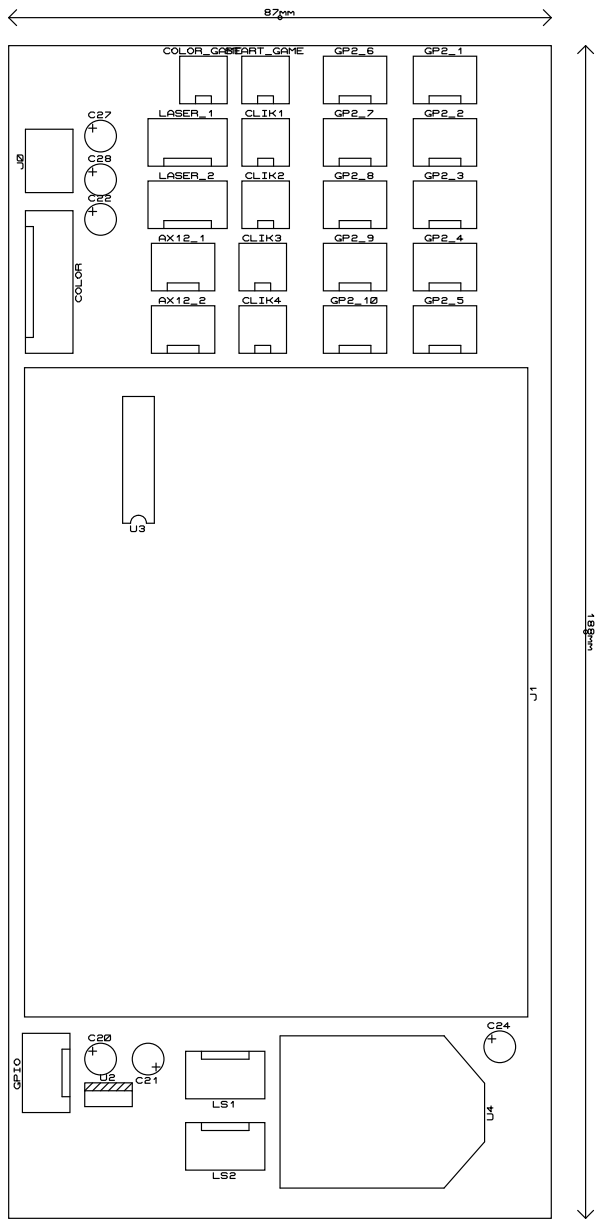
[picture p291: page 1]
