massinissalounis/oufffteam/Meca/Plans Robot 2013/Base - plan.pdf

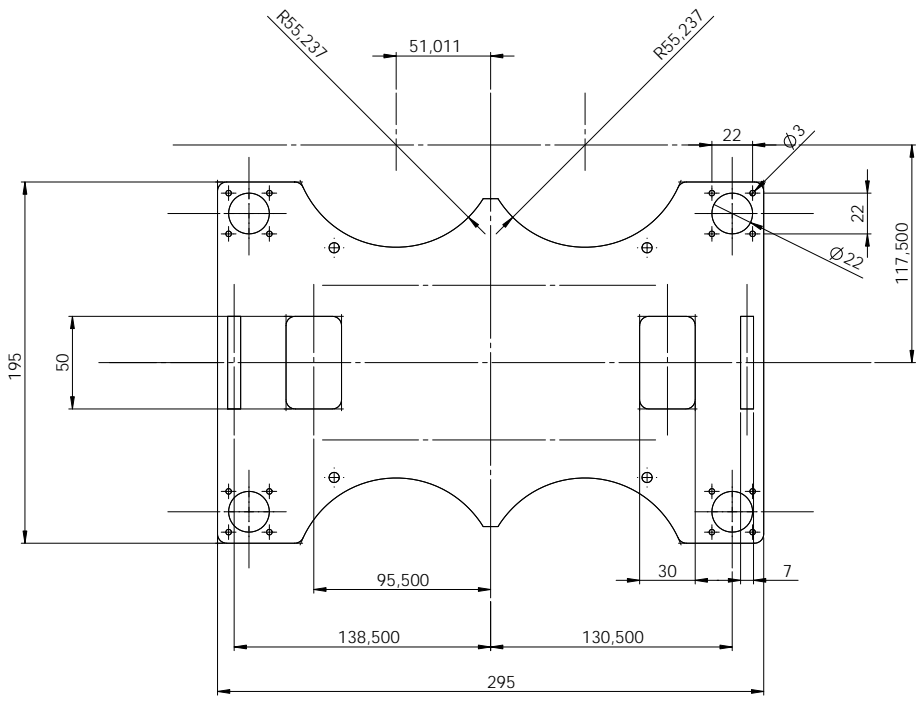
[picture p292: page 1]
