massinissalounis/oufffteam/Meca/Plans Robot 2013/Etagère 1 - plan.pdf

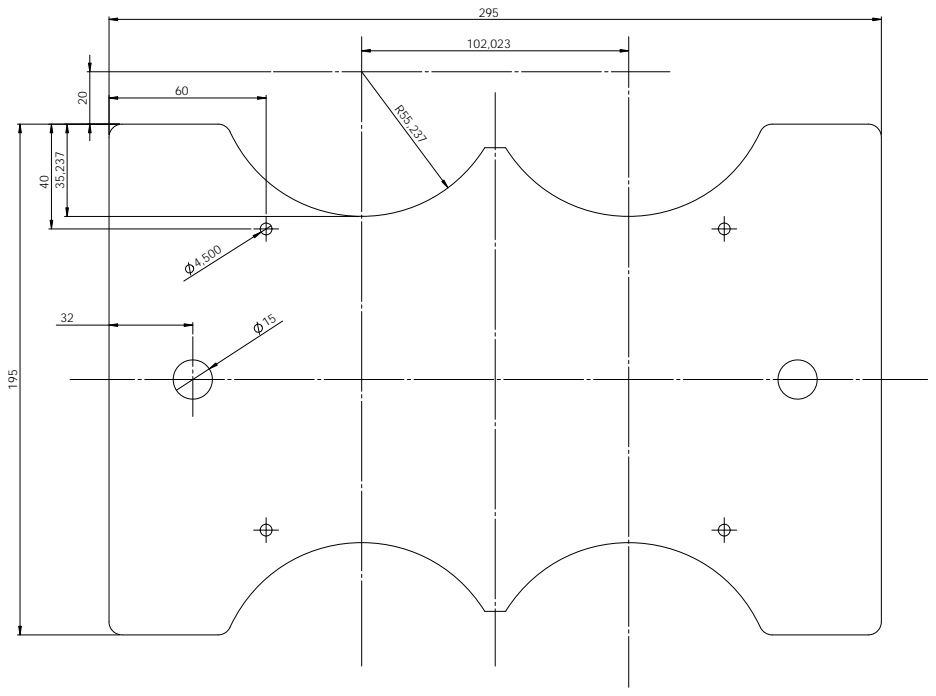
[picture p293: page 1]
