massinissalounis/oufffteam/Elec/2013/Carte_connectique_CM/carte_connectique_CM 2013 BOTTOM.pdf

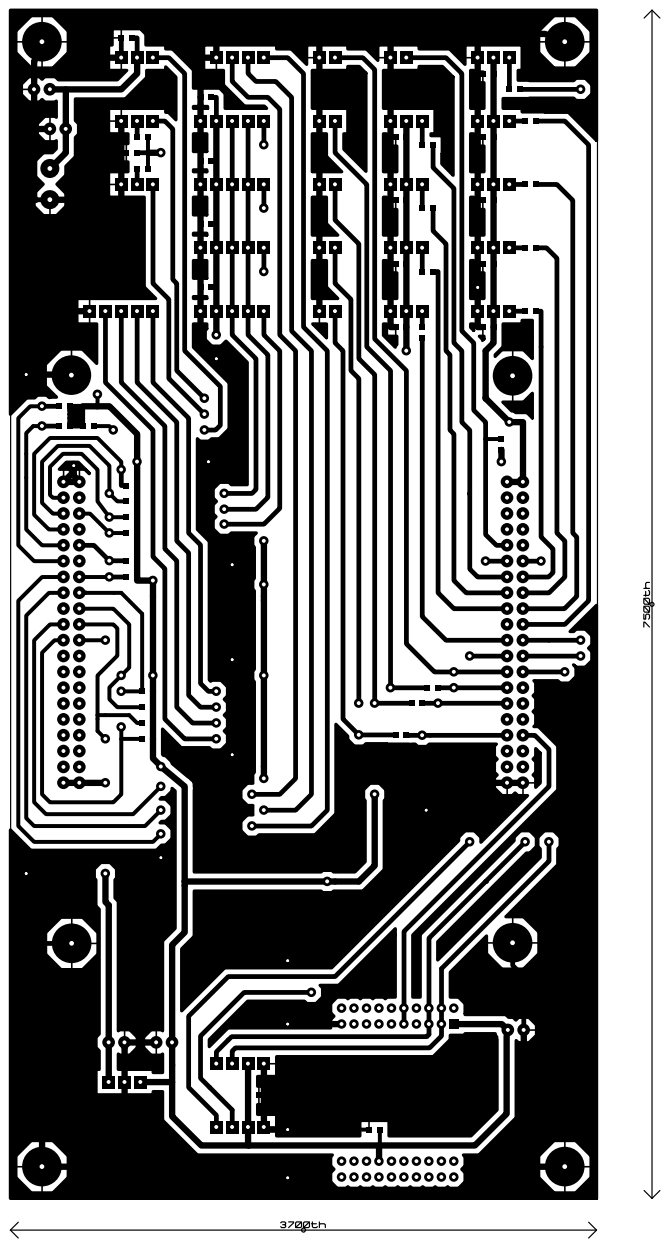
[picture p294: page 1]
