massinissalounis/oufffteam/Elec/2013/Carte_connectique_CM/carte_connectique_CM 2013 DRILL.pdf

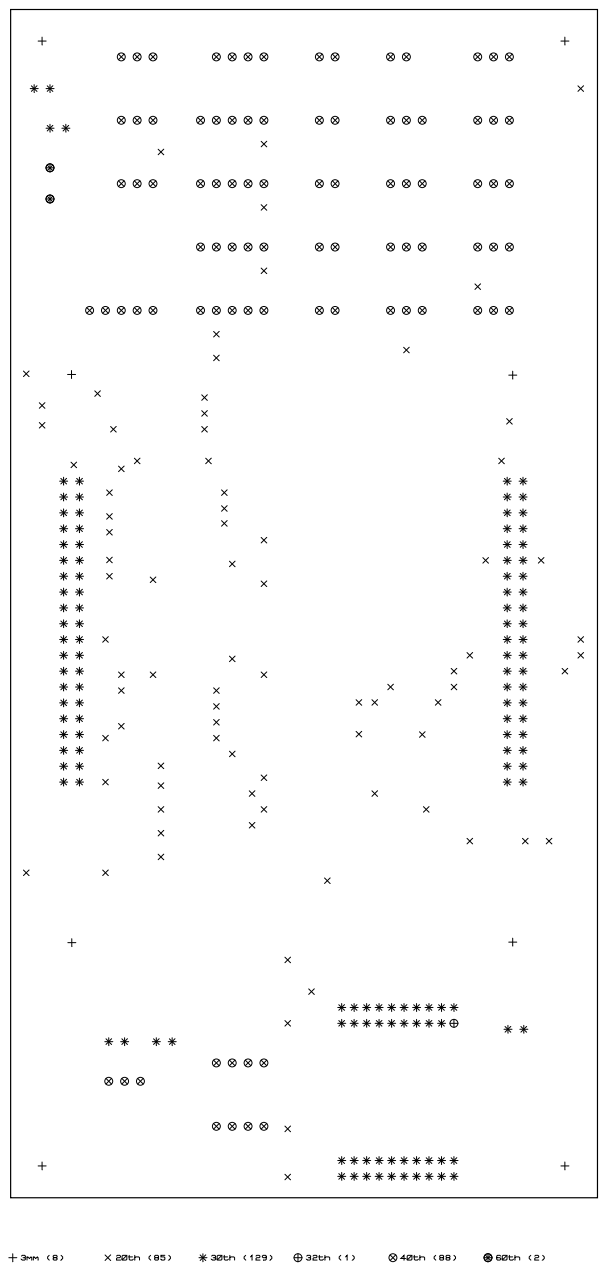
[picture p295: page 1]
