massinissalounis/oufffteam/Elec/2013/Carte_connectique_CM/carte_connectique_CM 2013 implante BOTTOM.pdf

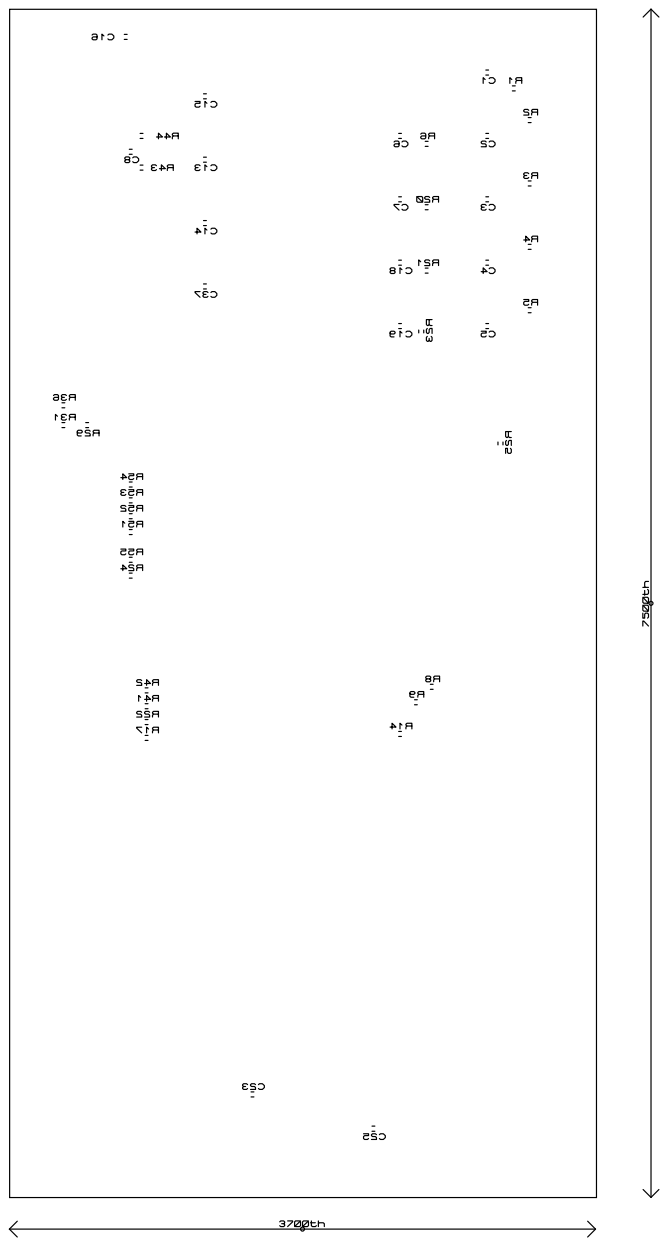
[picture p296: page 1]
