massinissalounis/oufffteam/Elec/2013/Carte_connectique_CM/carte_connectique_CM 2013 implante TOP.pdf

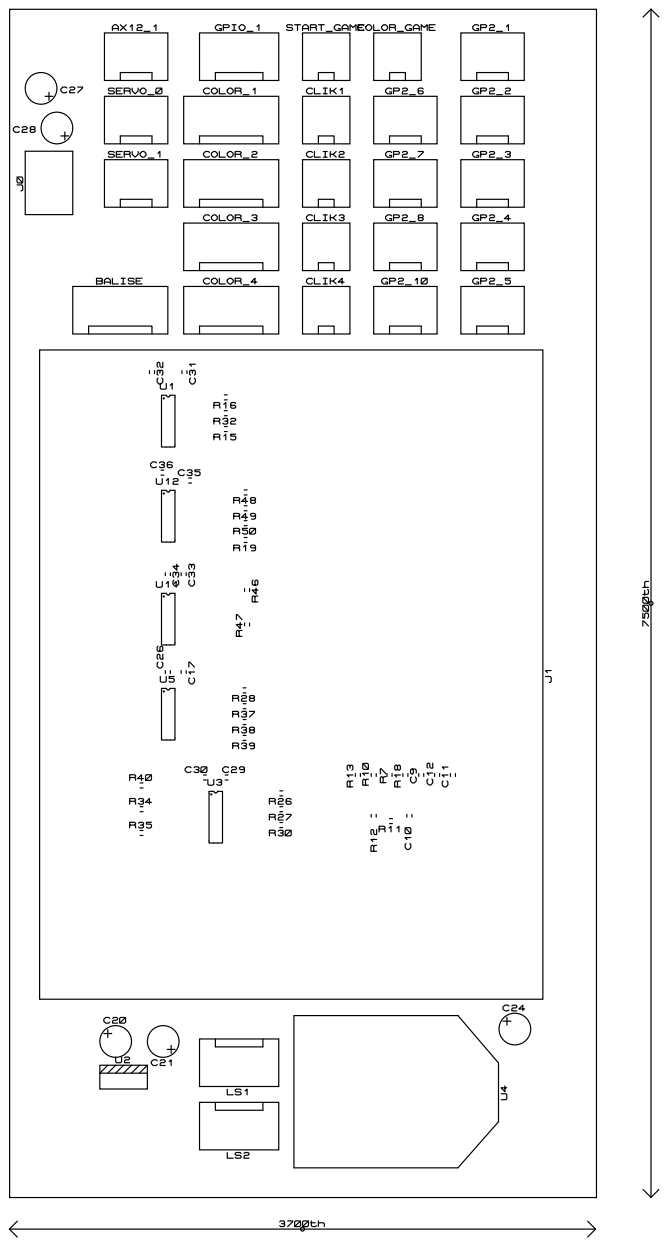
[picture p297: page 1]
