massinissalounis/oufffteam/Elec/2013/Carte_connectique_CM/carte_connectique_CM 2013 schéma.pdf

J1

R6

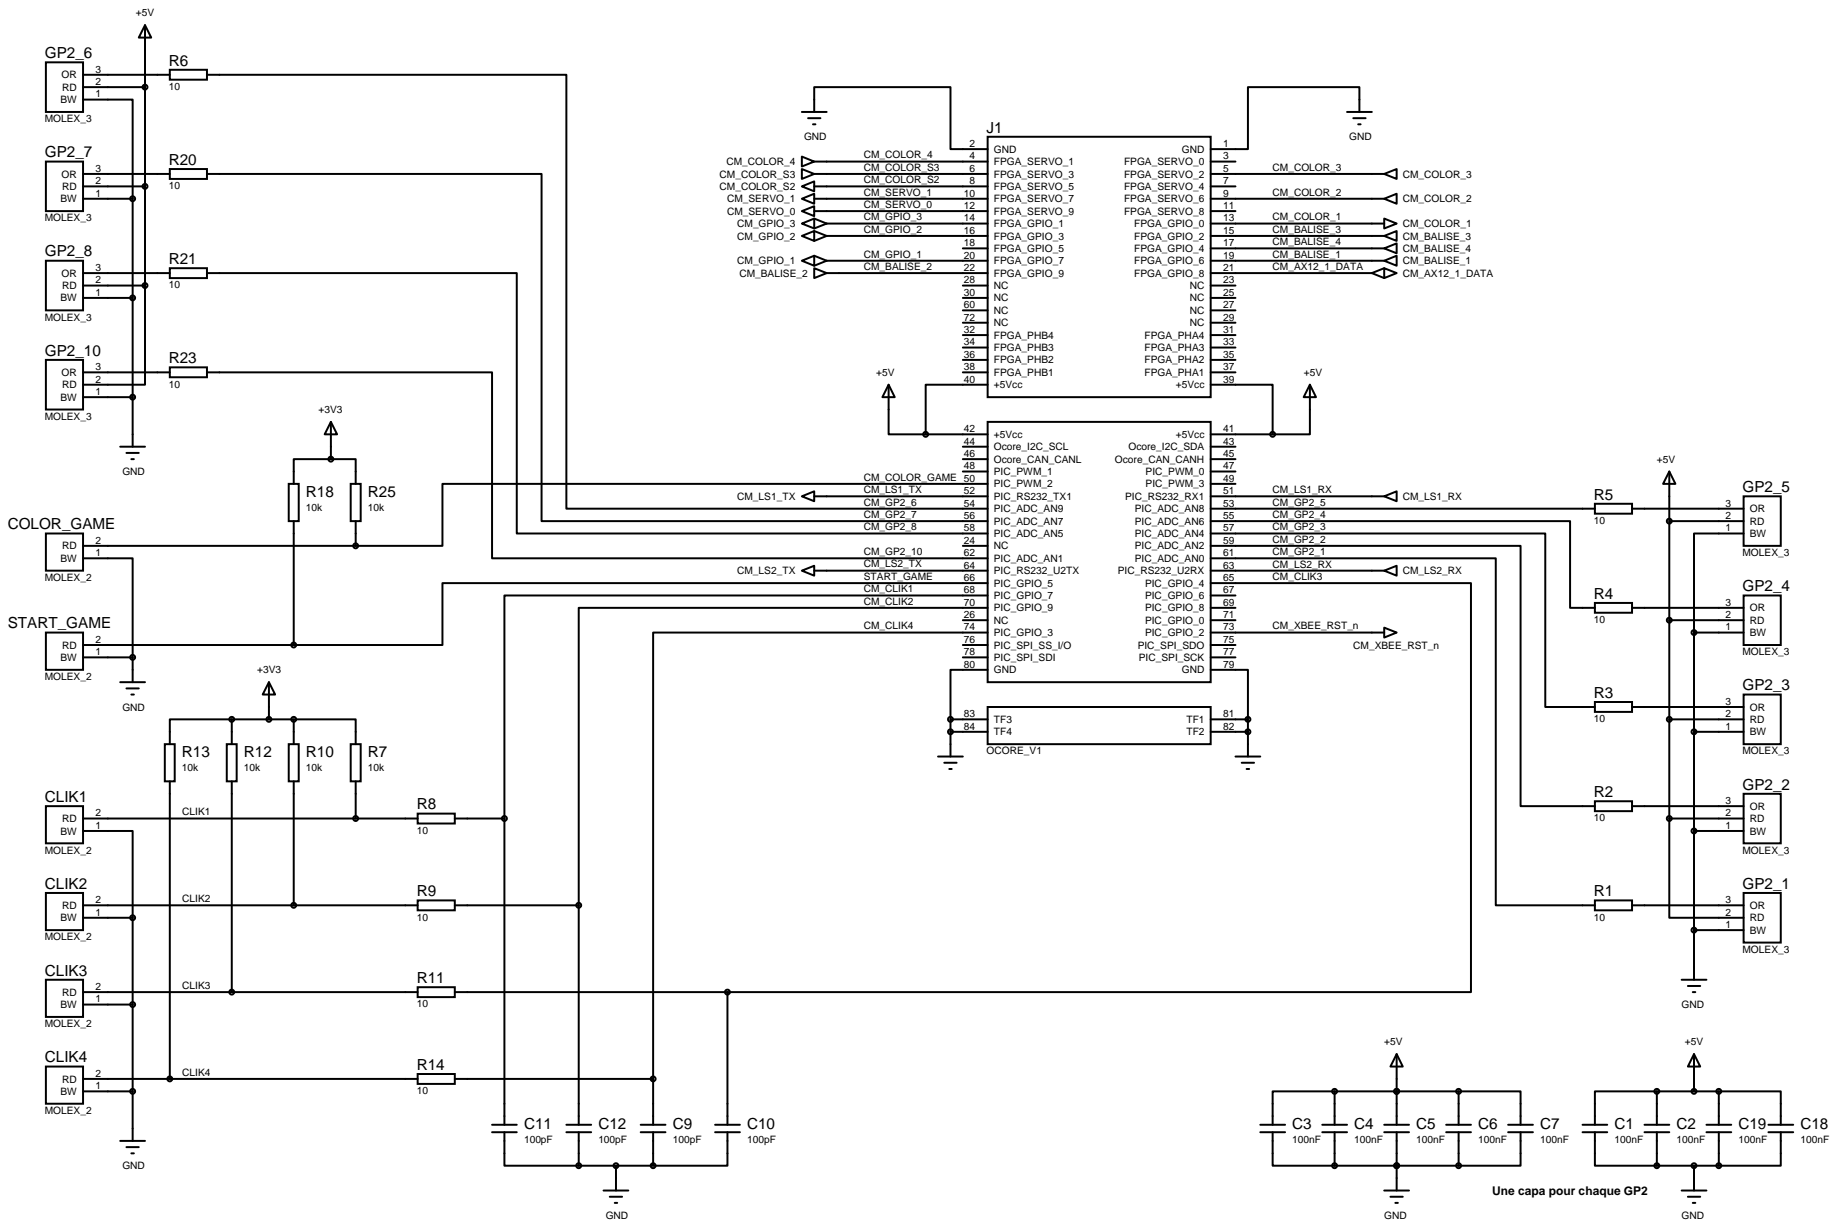
[picture p298: page 1]

Une capa pour chaque GP2

R32

R29

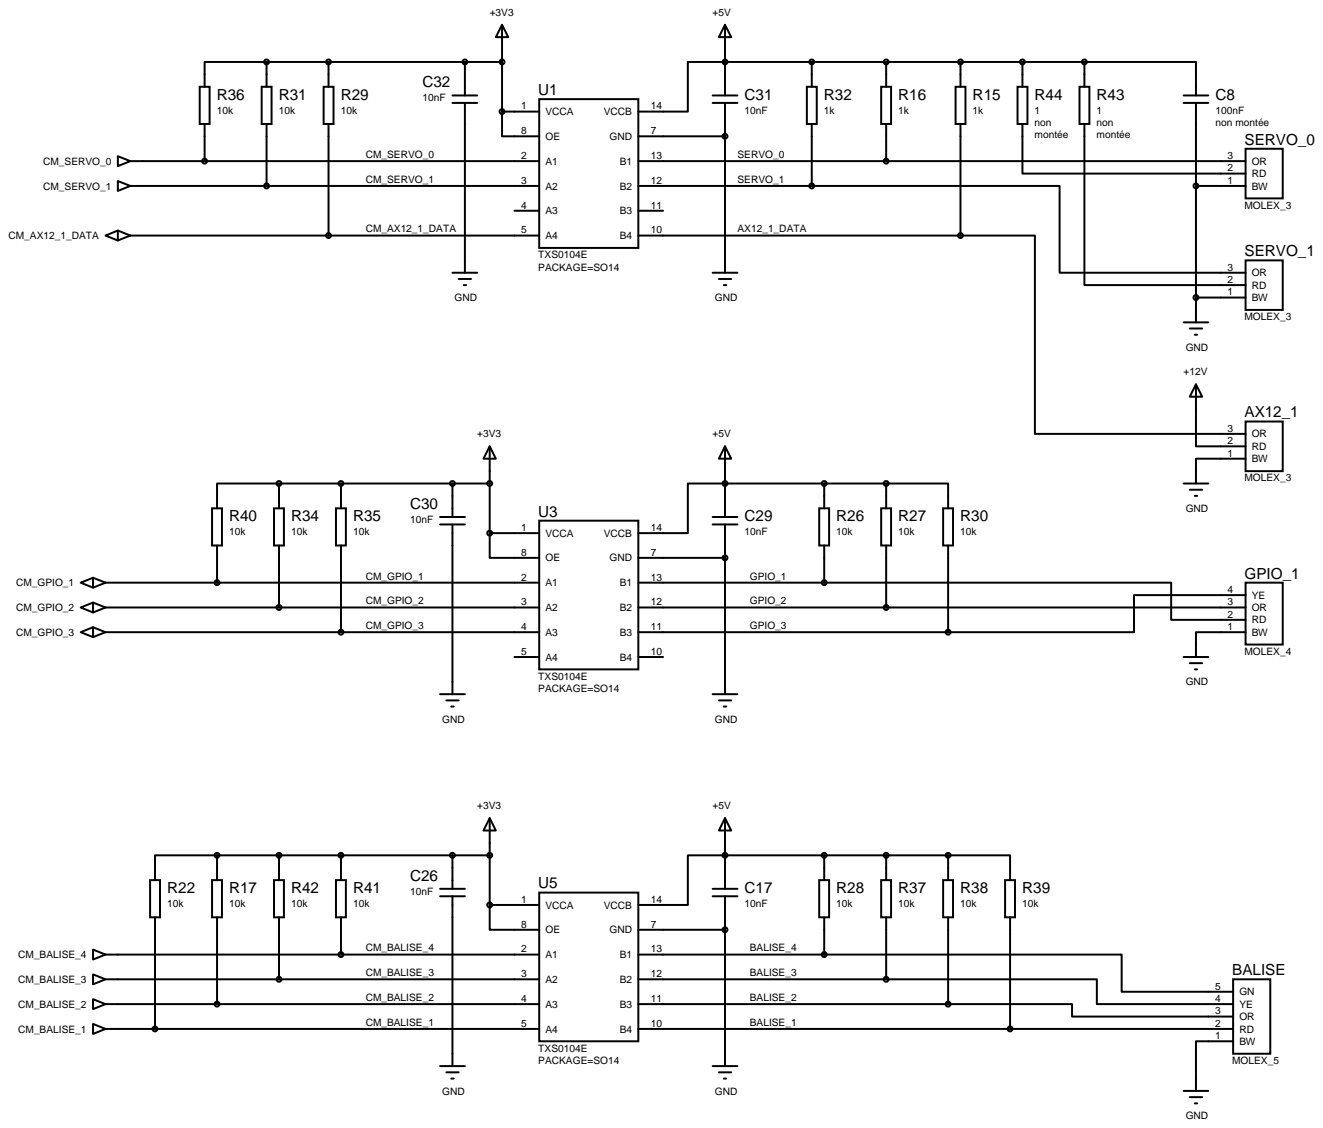
[picture p299: page 2]

## COLOR_1

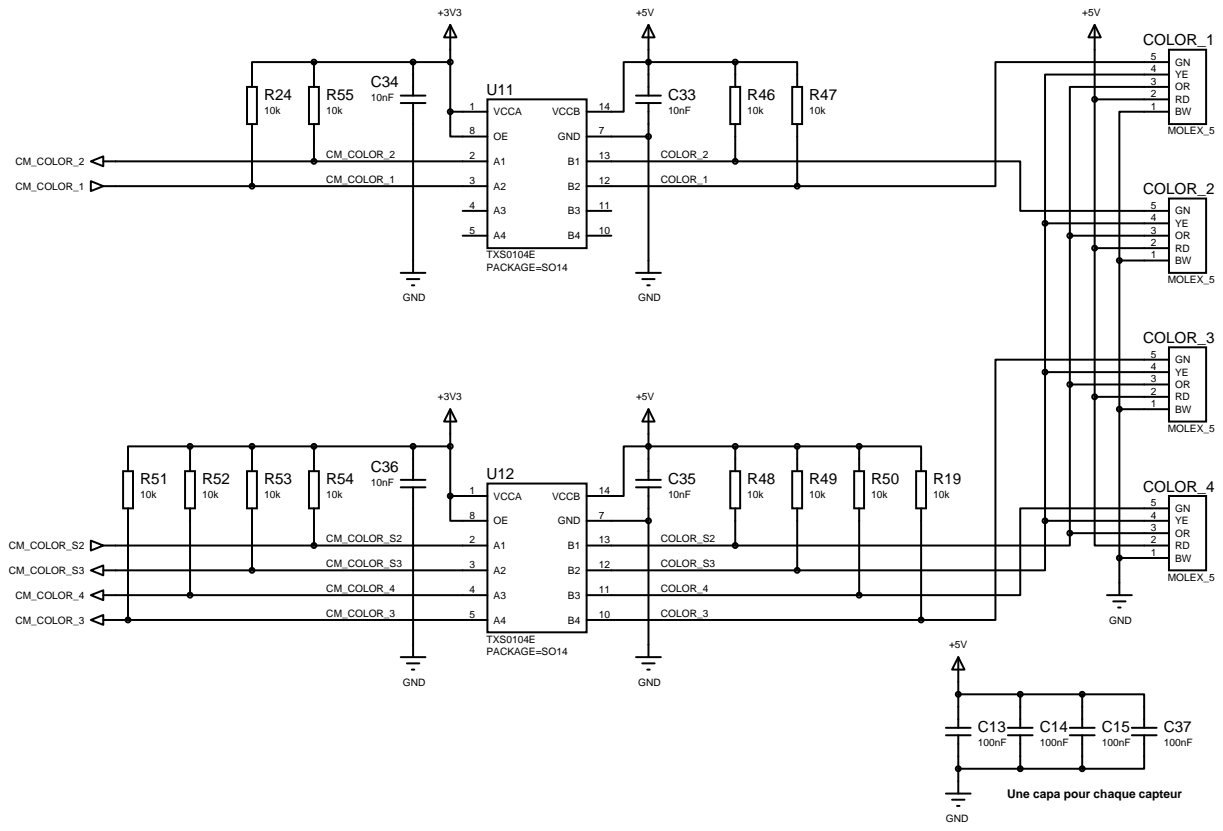
[picture p300: page 3]

Une capa pour chaque capteur

U4

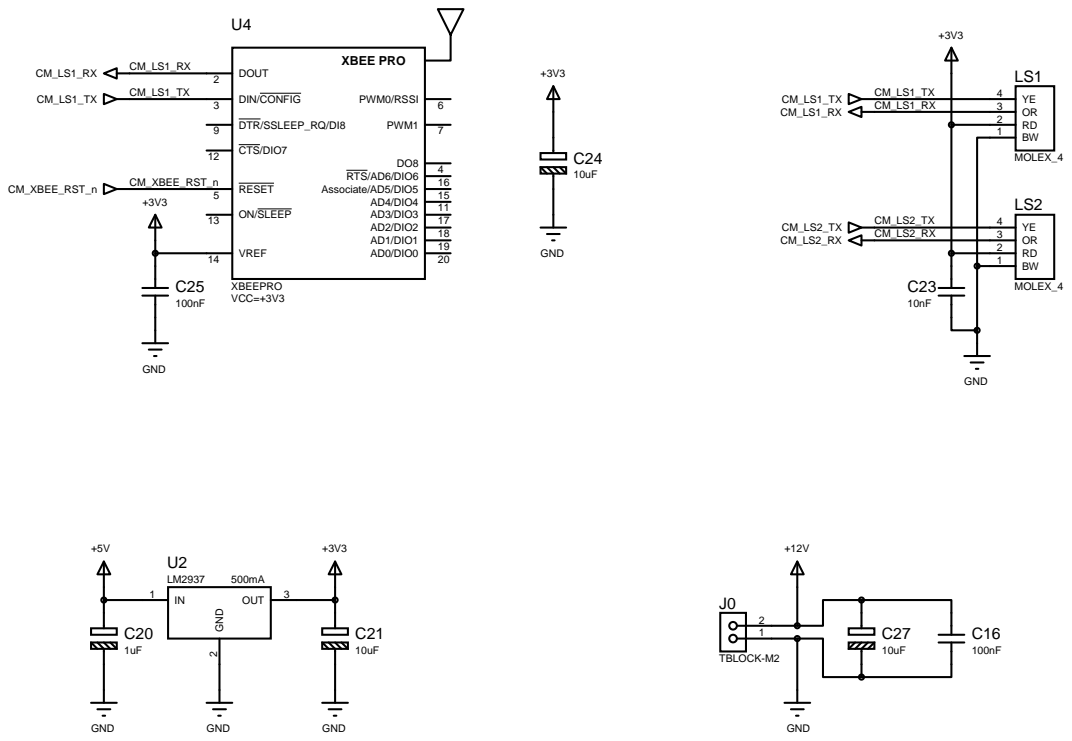
[picture p301: page 4]
