massinissalounis/oufffteam/Elec/2013/Carte_connectique_CM/carte_connectique_CM 2013 TOP.pdf

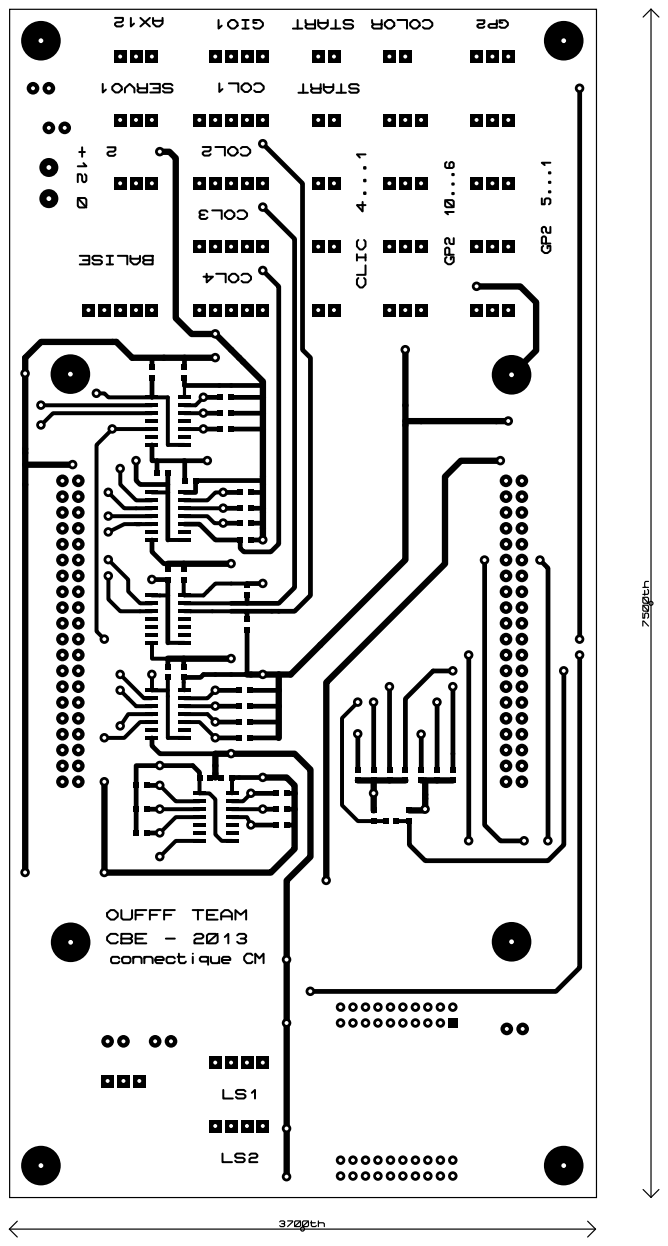
[picture p302: page 1]
