massinissalounis/oufffteam/Elec/2013/Support_capteur_couleur/Supp_capteur_couleur TOP.pdf

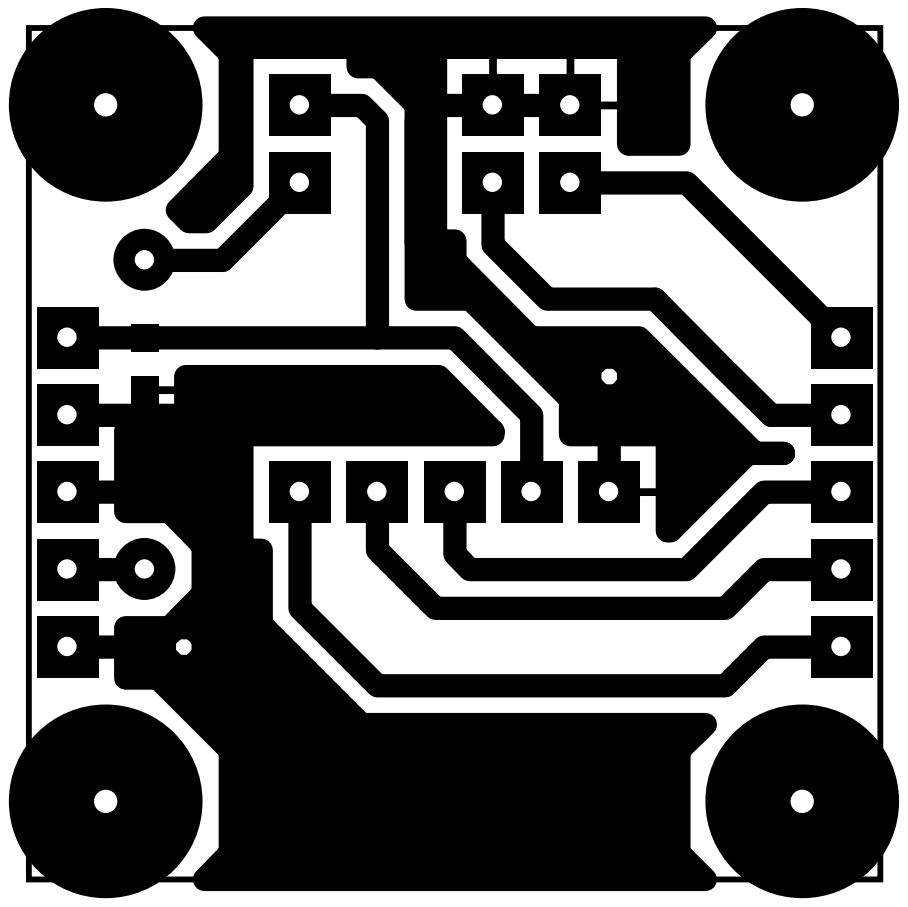
[picture p303: page 1]
