massinissalounis/oufffteam/Elec/2013/Module_Alim/Module_Alim bottom layer.pdf

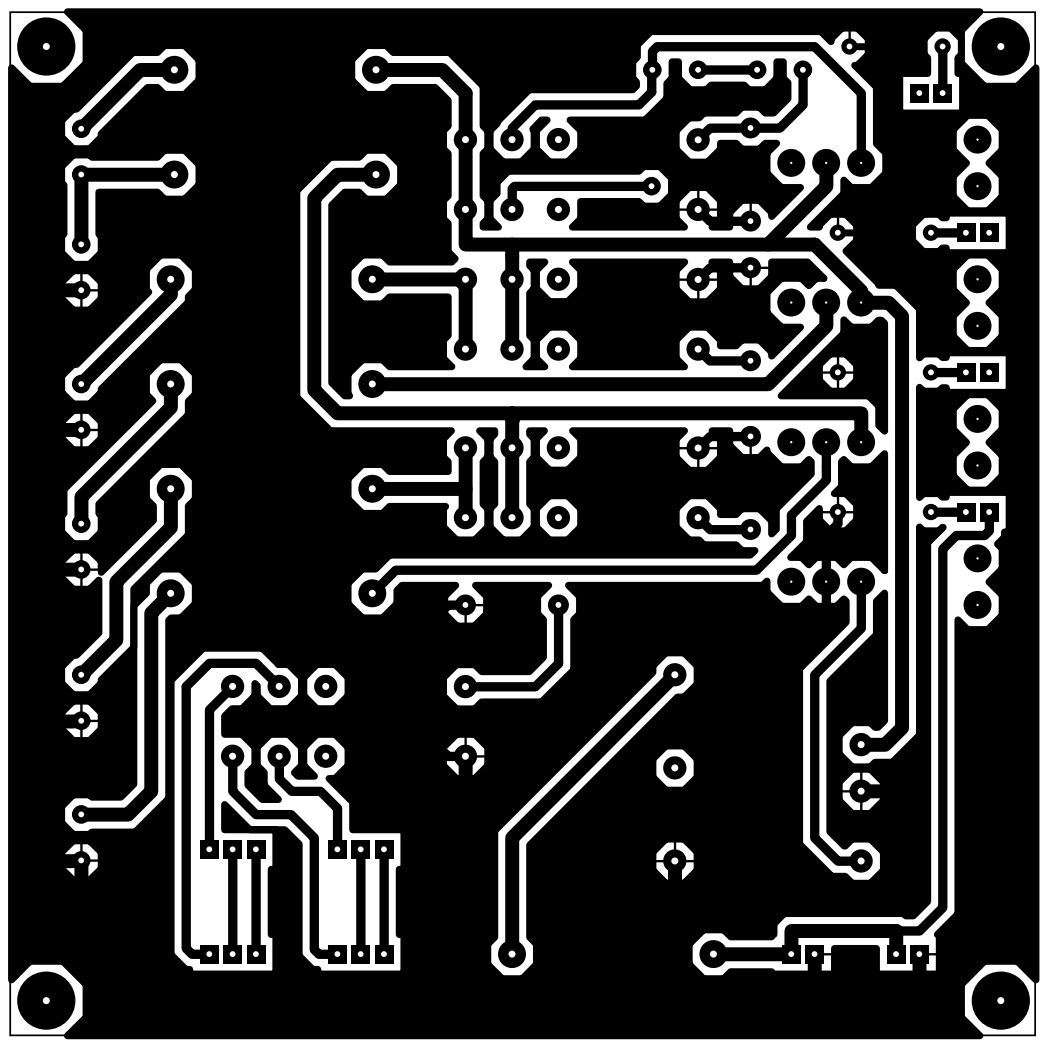
[picture p304: page 1]
