massinissalounis/oufffteam/Elec/2013/Module_Alim/Module_Alim implentation.pdf

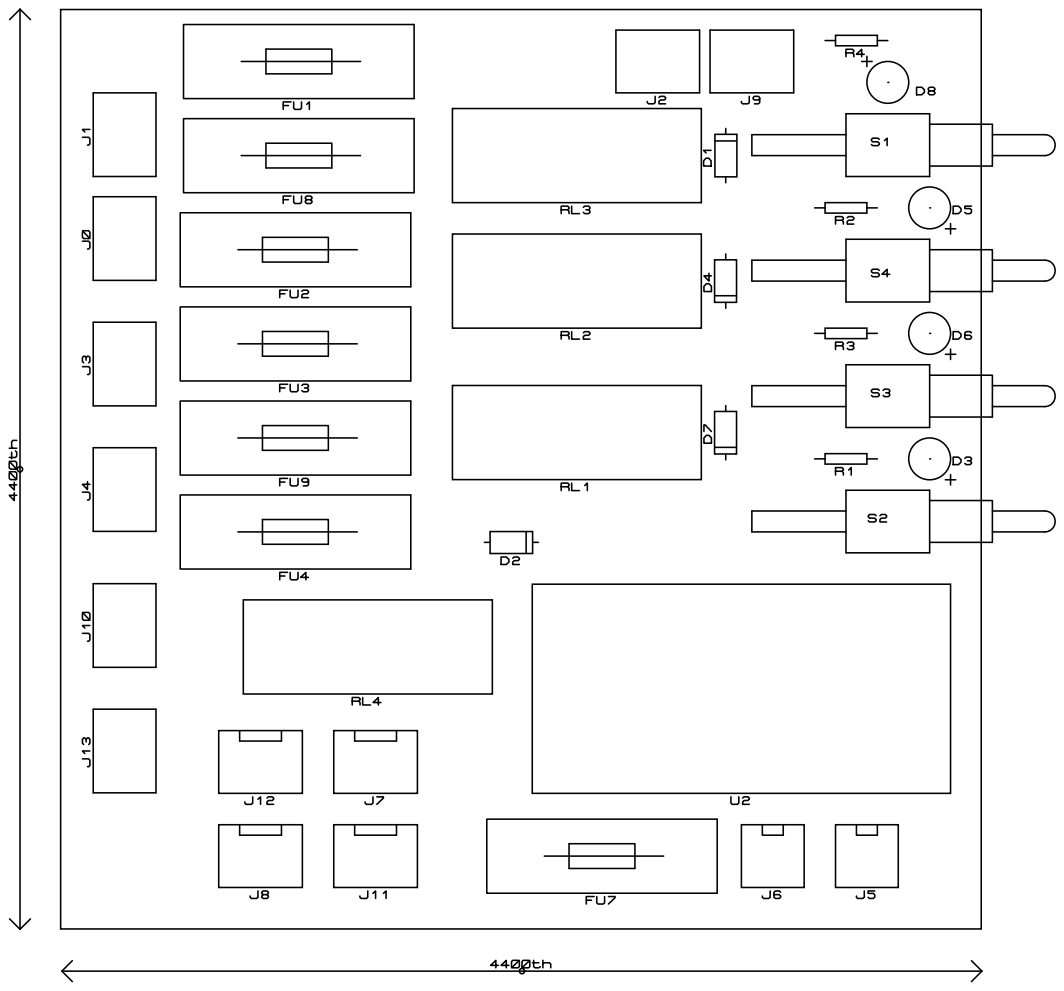
[picture p305: page 1]
