massinissalounis/oufffteam/Elec/2013/Module_Alim/Module_Alim schéma.pdf

FU1

J1

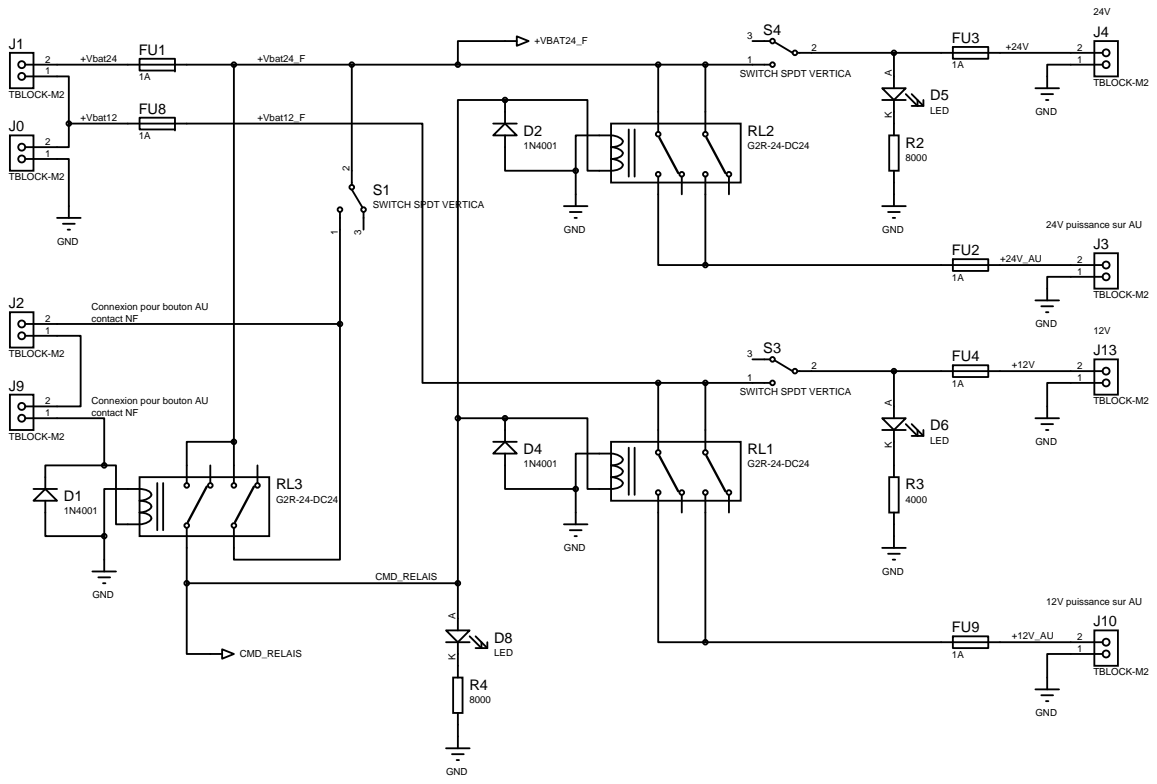
[picture p306: page 1]

Connexion pour bouton AU
contact NF

J5

J6

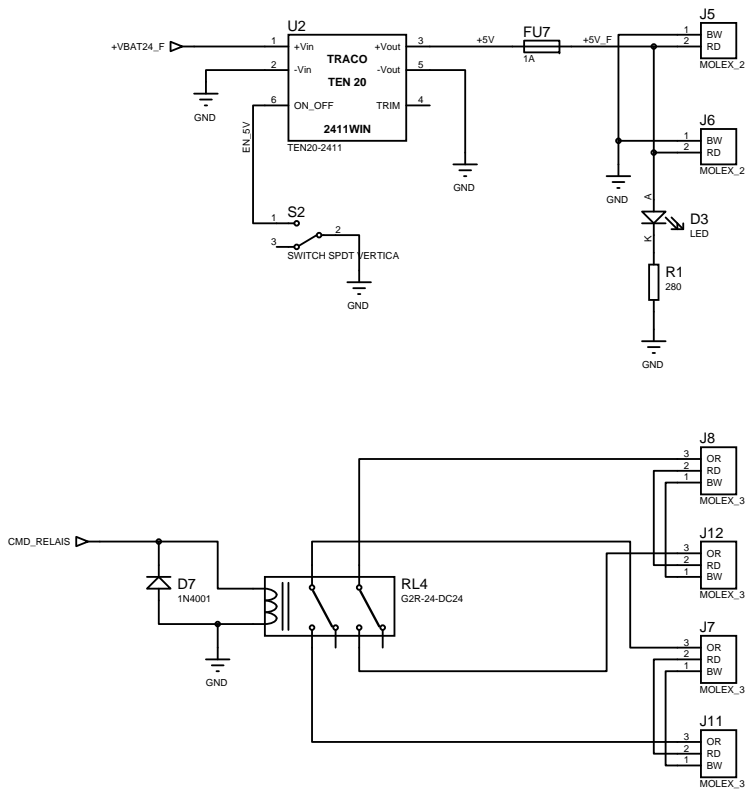
[picture p307: page 2]
