massinissalounis/oufffteam/Elec/2013/Module_Alim/Module_Alim top layer.pdf

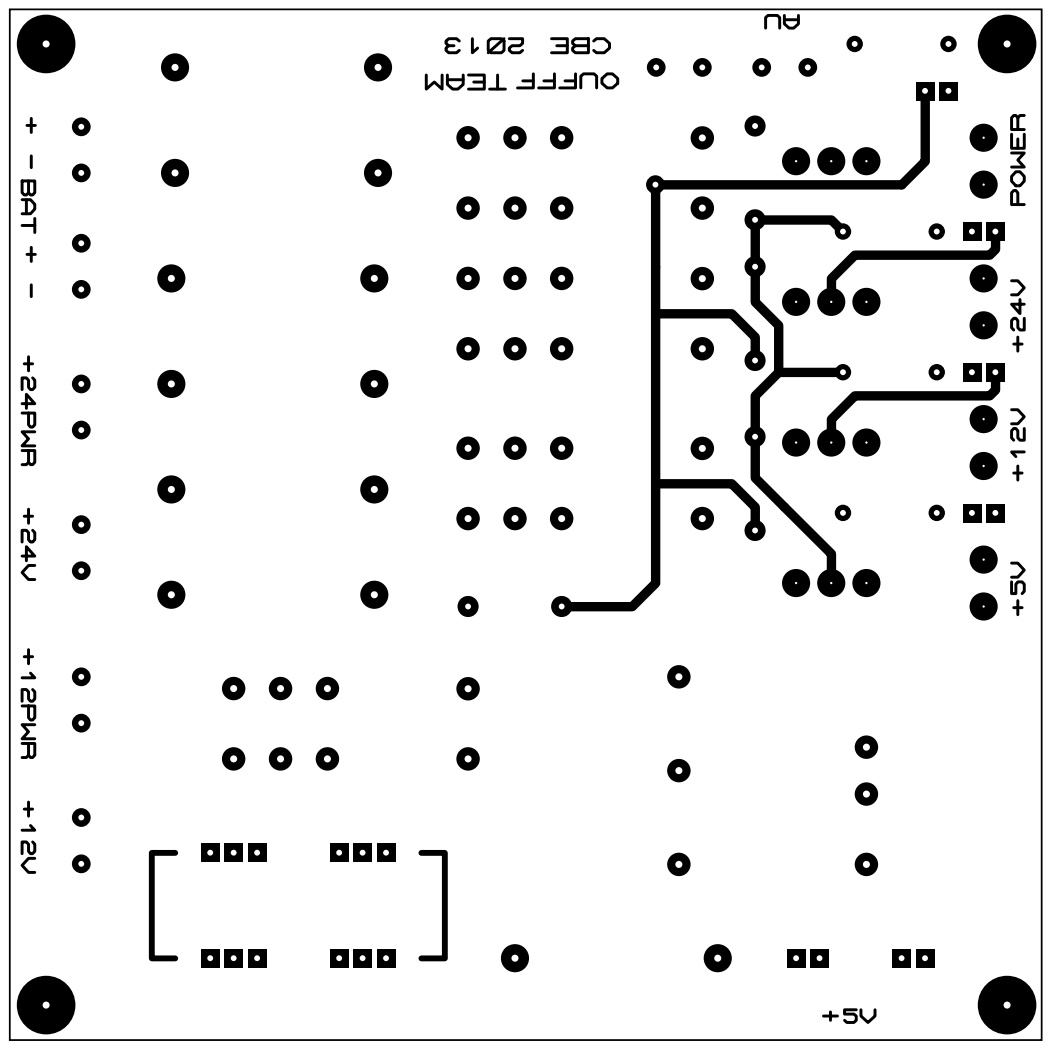
[picture p308: page 1]
