massinissalounis/oufffteam/Elec/2012/Balises Vision/Mobile.pdf

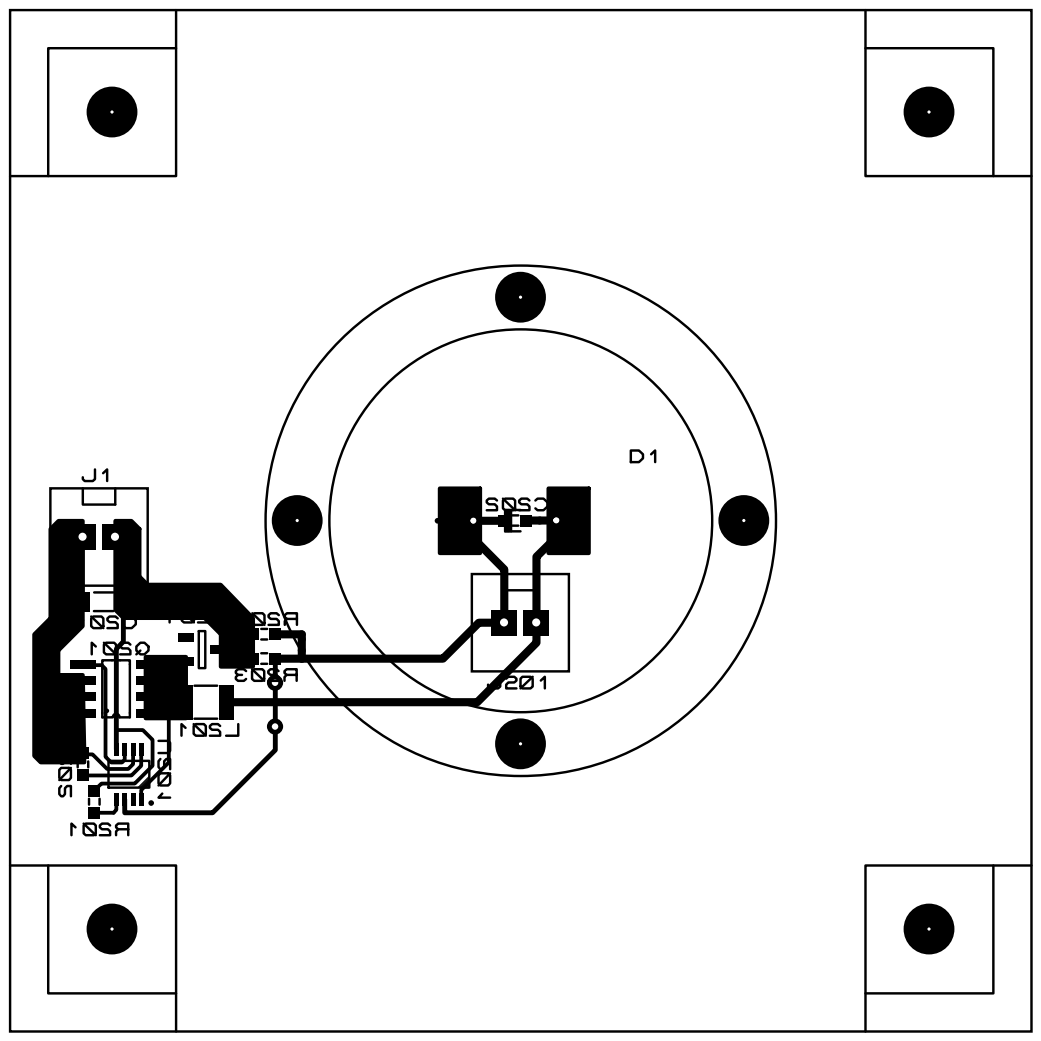
[picture p309: page 1]
