massinissalounis/oufffteam/Elec/2011/Carte_connectique_CM/carte_connectique_CM schéma.pdf

J1

R6

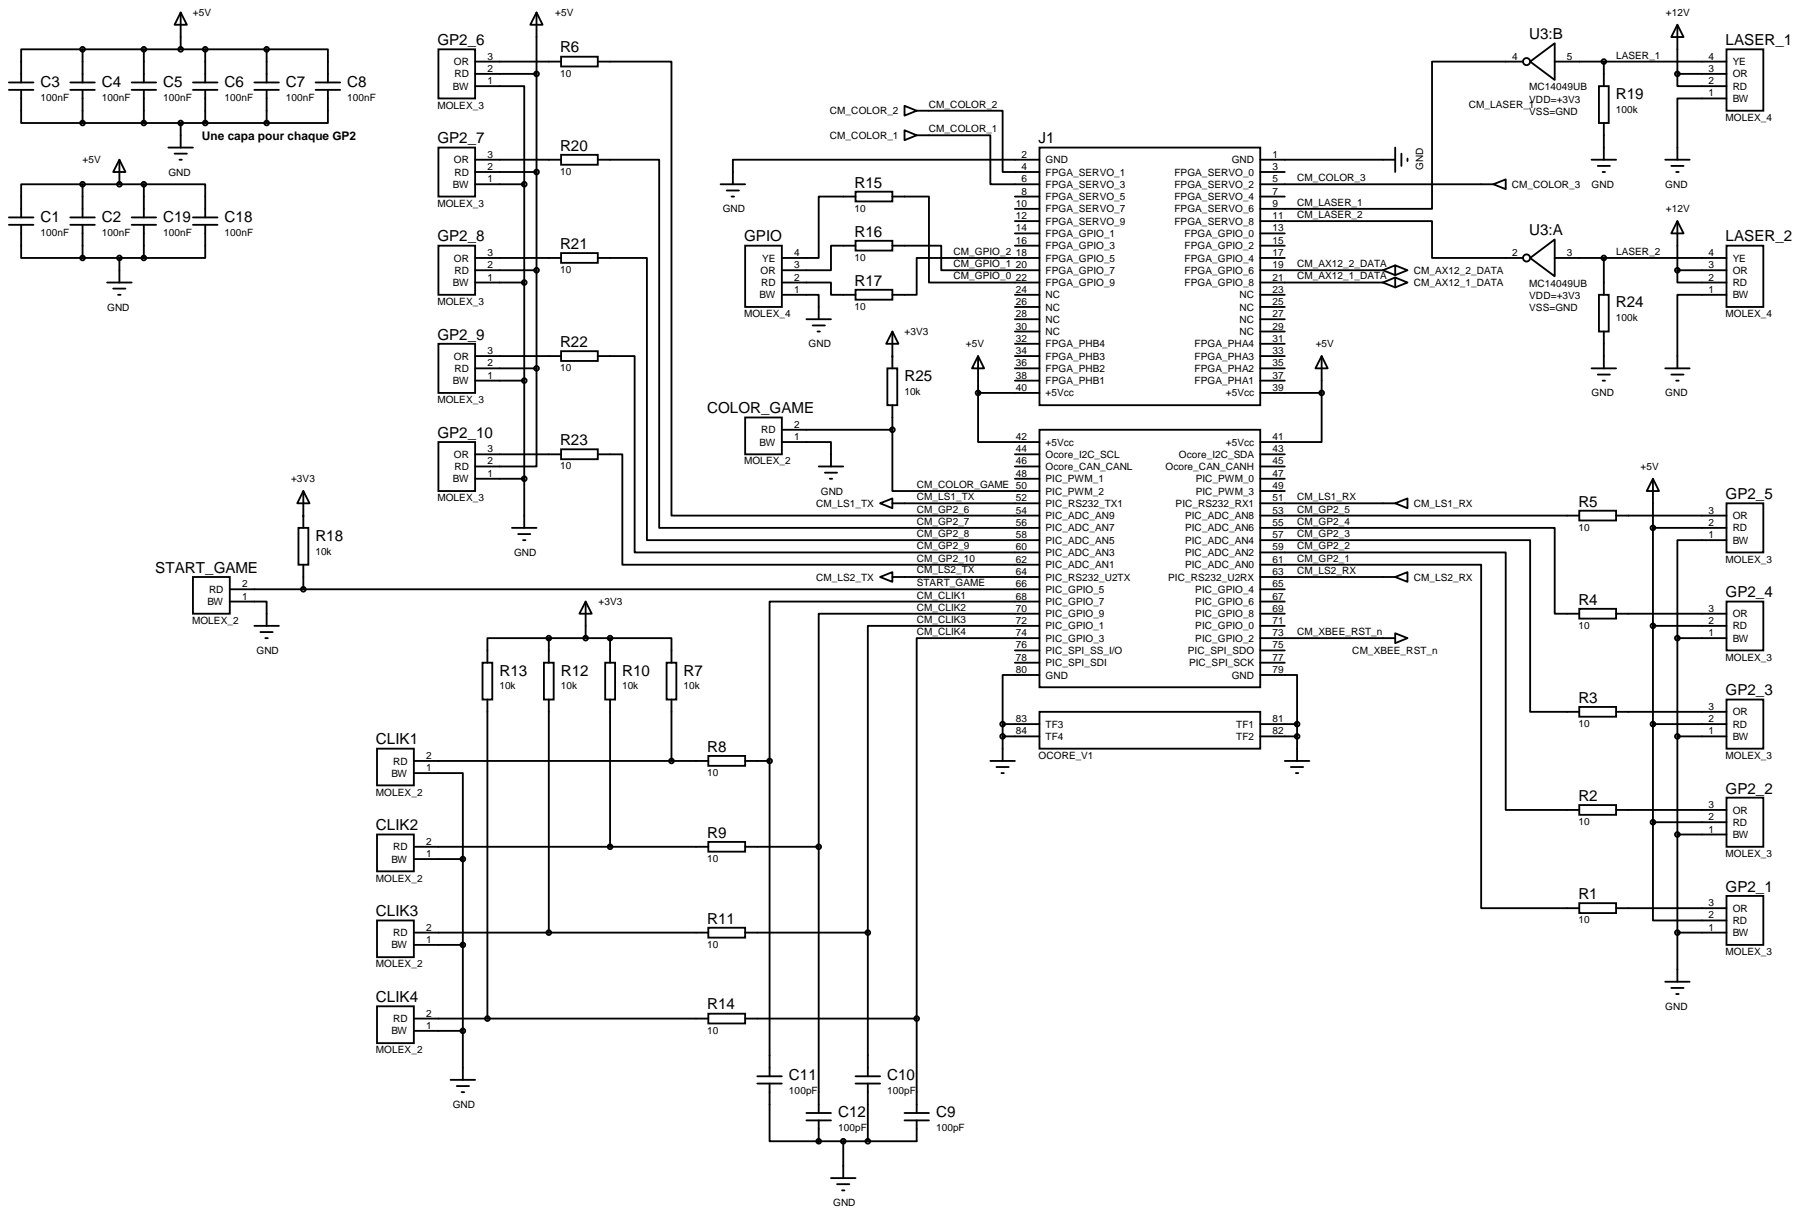
[picture p310: page 1]

Une capa pour chaque GP2

R32

## COLOR

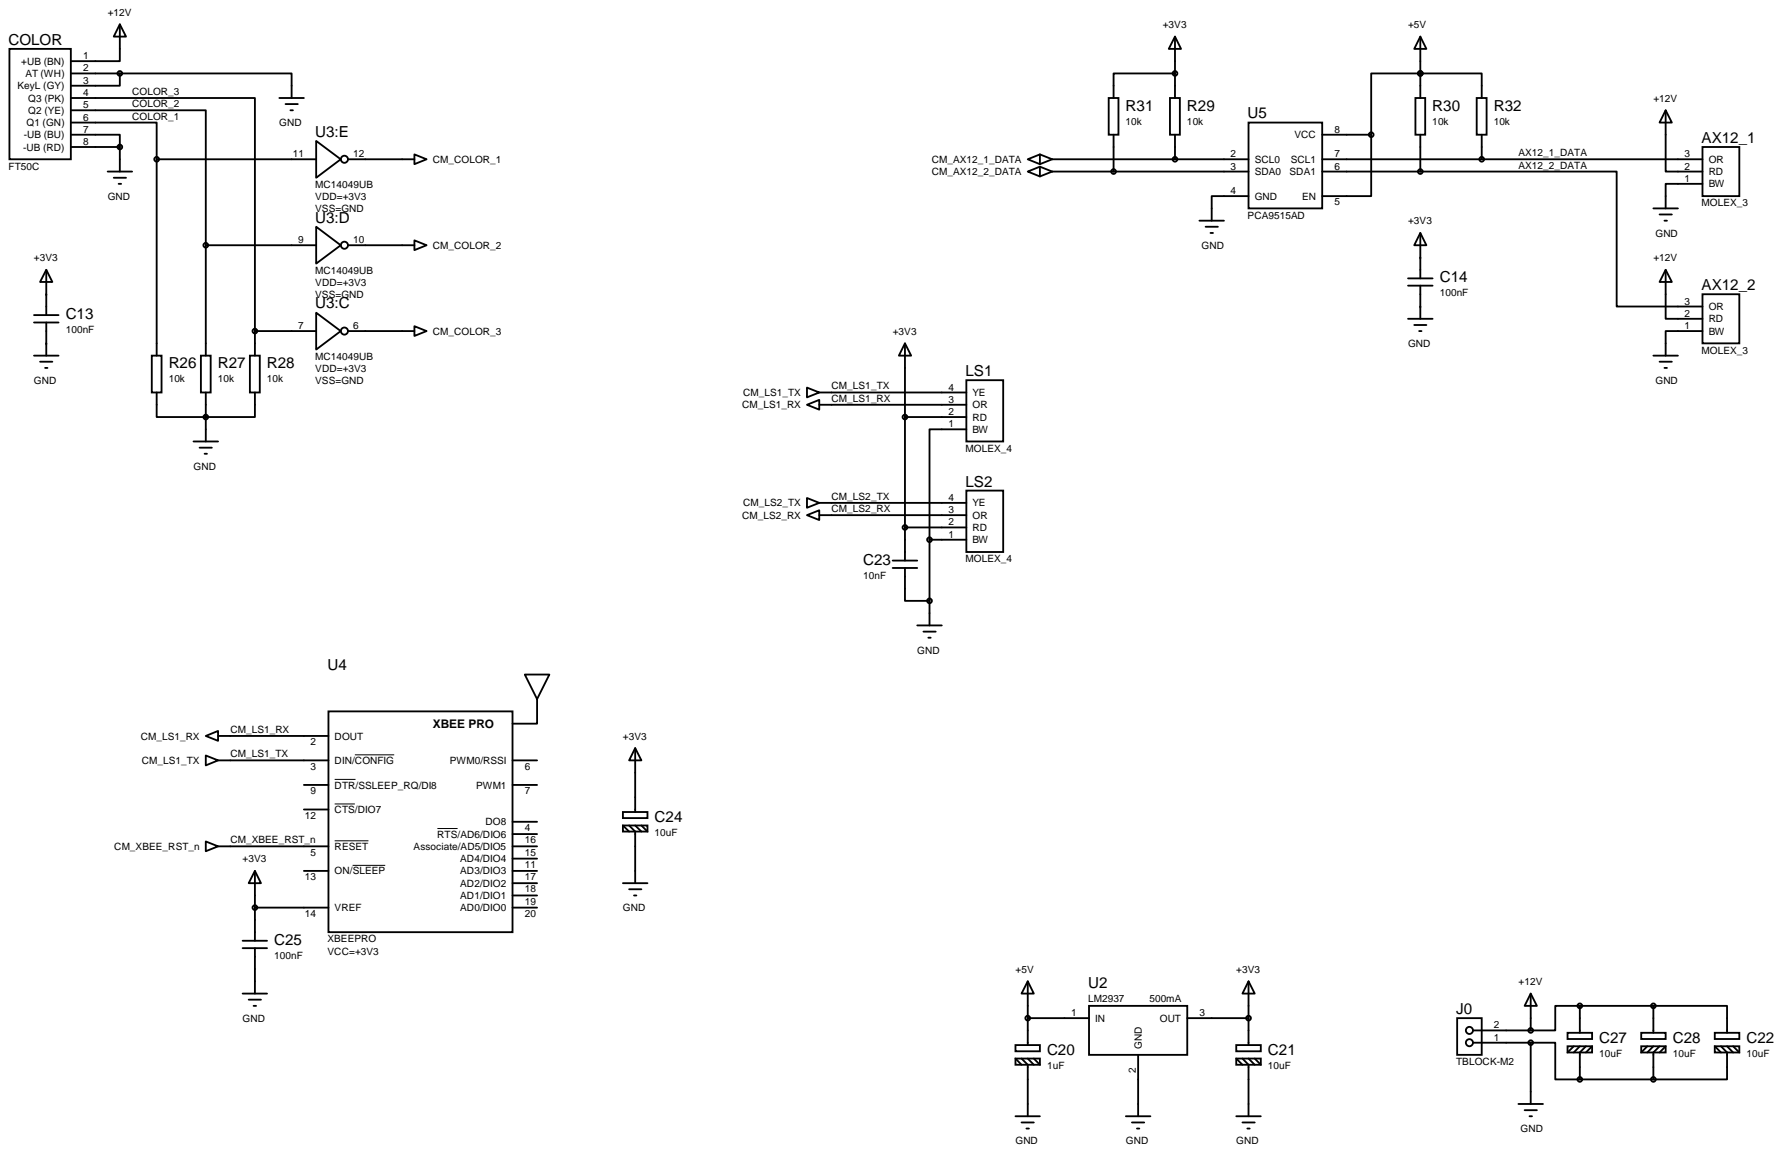
[picture p311: page 2]
