massinissalounis/oufffteam/Elec/2011/Carte_connectique_CM/carte_connectique_CM.pdf

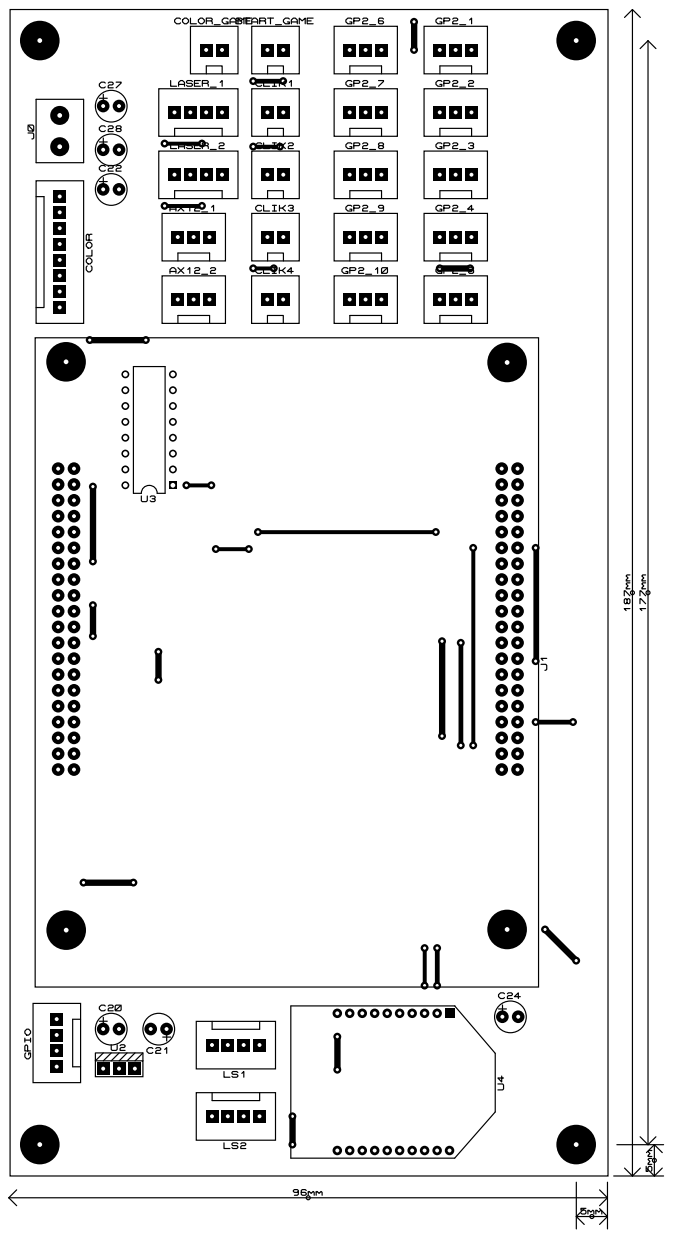
[picture p312: page 1]
