massinissalounis/oufffteam/Elec/2011/Carte_connectique_CM/carte_connectique_CM_implante_top.pdf

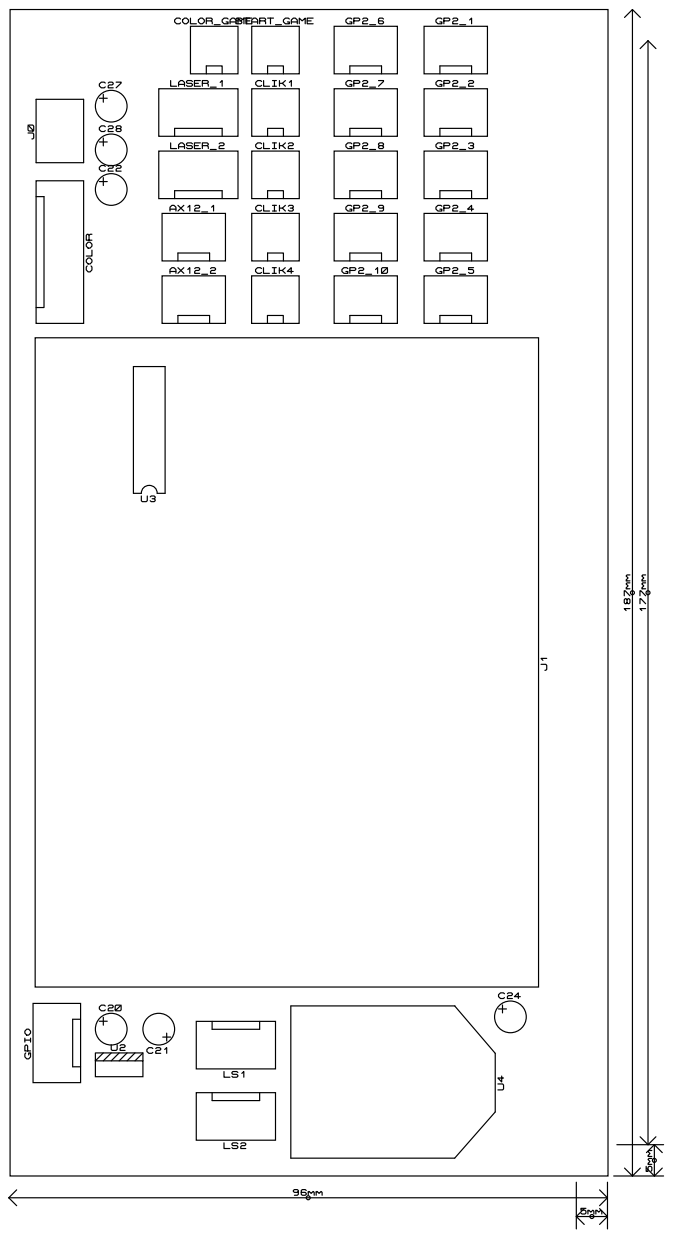
[picture p313: page 1]
