massinissalounis/oufffteam/Elec/2011/Carte_connectique_CM/carte_connectique_CM_bottom.pdf

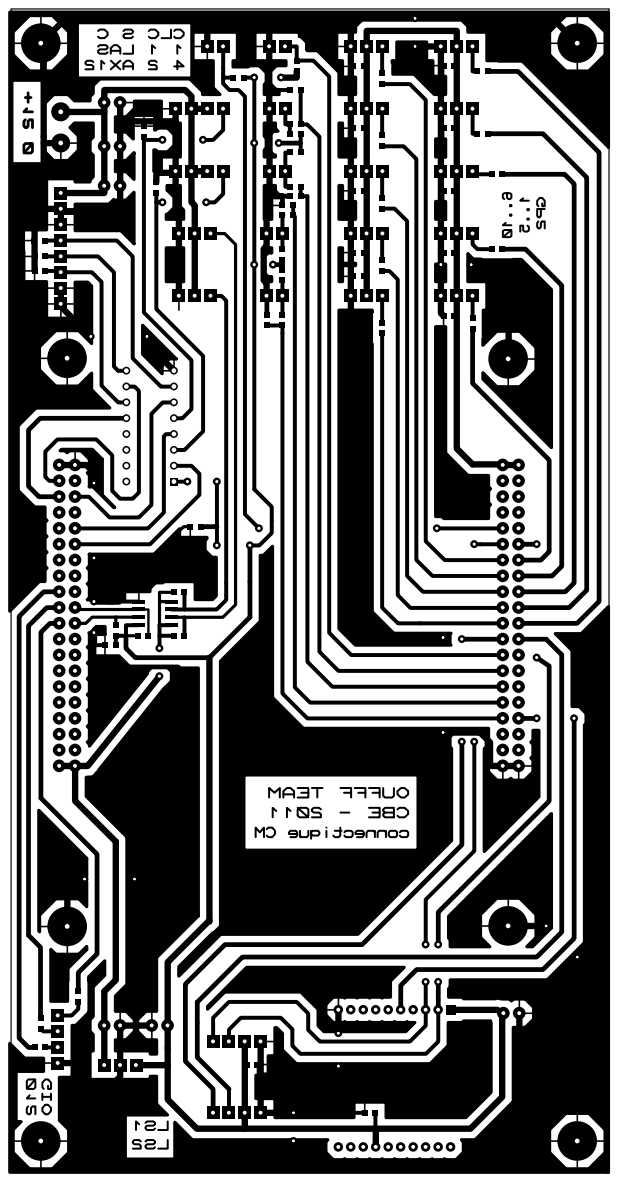
[picture p314: page 1]
