massinissalounis/oufffteam/Elec/2011/Carte_connectique_CM/carte_connectique_CM_implante_bottom.pdf

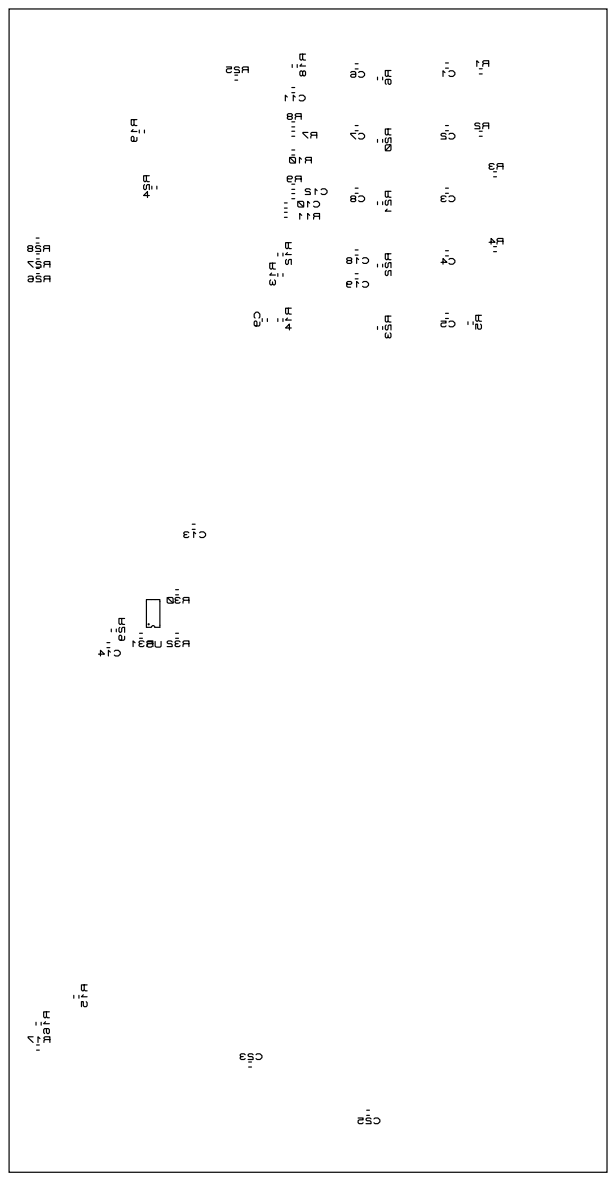
[picture p315: page 1]
