massinissalounis/oufffteam/Elec/2011/Carte_connectique_CM/carte_connectique_CM_top.pdf

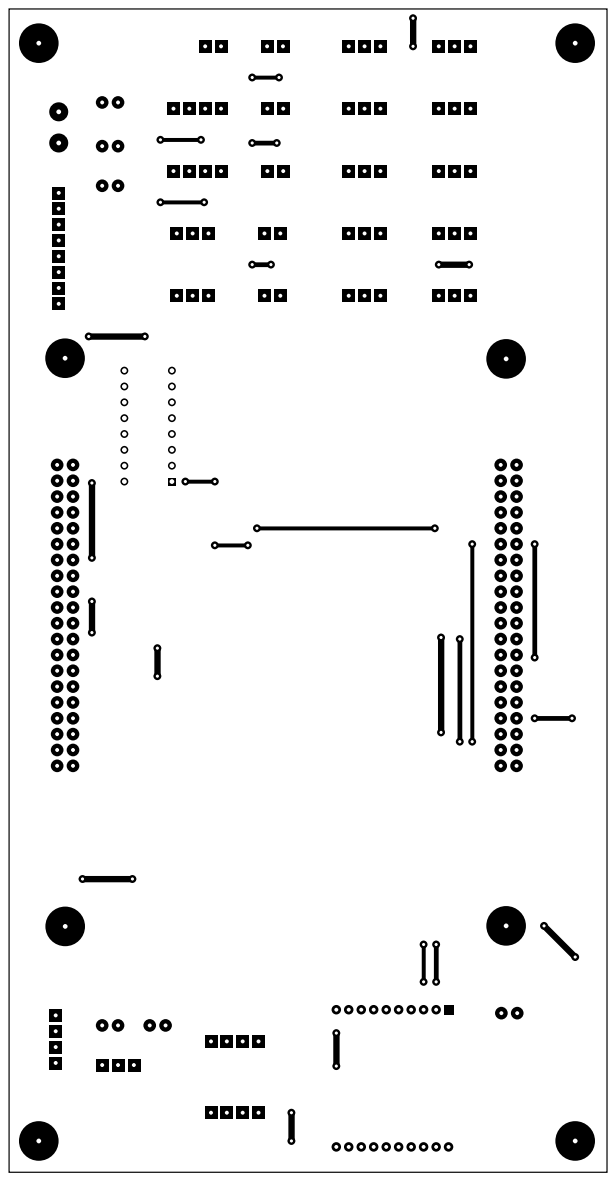
[picture p316: page 1]
