massinissalounis/oufffteam/Elec/2011/Balises IR/dc-dc converters/simus/sliding-mode buck.asc

C1: cap; 100µ
C2: cap; 22n
C3: cap; 100n
C4: cap; 10p
C5: cap; 10p
D1: schottky; ZLLS1000
D2: diode; 1N4148
D3: diode; 1N4148
I1: current; PULSE(0 1 50u 10n 10n 30u 100u)
L1: ind; 10µ; Ipk=2 Rser=0.033 Rpar=942 Cpar=0 mfg="Coilcraft" pn="MSS7341-103MX"
M1: nmos; IRLR3802
M2: nmos; IRLR3802
R1: res; 10k
R2: res; 1k
R3: res; 1k
R4: res; 1k
R5: res; 1000k
R6: res; 1k
U1: LT1713
U2: LTC4444-5
V1: voltage; PULSE(0 3.3 10n 40u)
V2: voltage; PULSE(0 5 0 100n)
Named nets: 0, 5V, ref
.tran 0.5m
