massinissalounis/oufffteam/(list of files, drawings)

Other design files:
Balises/Balises_SICK/Elec/Interface_v1/Interface_v1.DSN
Balises/Balises_SICK/Elec/Interface_v1/Interface_v1.LYT
Balises/Balises_SICK/Elec/old/Ampli_photo/Ampli_AD8304.DSN
Balises/Balises_SICK/Elec/old/Ampli_photo/Ampli_AD8304.LYT
Balises/Balises_SICK/Elec/old/Moteur/Moteur.DSN
Balises/Balises_SICK/Elec/old/Moteur/Moteur.LYT
Balises/Balises_SICK/Elec/old/Moteur/old_Moteur.DSN
Elec/2010/CM/PCB/o_core_v1.PcbDoc
Elec/2010/CM/Schematic/Carte_mere_TOP.SchDoc
Elec/2010/CM/Schematic/CONNECTS.SchDoc
Elec/2010/CM/Schematic/FPGA.SchDoc
Elec/2010/CM/Schematic/Ocore.PrjPcb
Elec/2010/CM/Schematic/PIC32.SchDoc
Elec/2010/CM/Schematic/POWER_SUPPLY.SchDoc
Elec/2010/CM/Schematic/SERIAL_INTERFACES.SchDoc
Elec/2010/CM/Schematic/SYNOPTIQUE.SchDoc
Elec/2010/Hacheurs/Schematic/H1N1.PcbDoc
Elec/2010/Hacheurs/Schematic/H1N1.PrjPcb
Elec/2010/Hacheurs/Schematic/H1N1.SchDoc
Elec/2011/Balises IR/schematic/Rx.DSN
Elec/2011/Balises IR/schematic/Rx.LYT
Elec/2011/Balises IR/schematic/Rx_logic.SchDoc
Elec/2011/Balises IR/schematic/Rx_micro.SchDoc
Elec/2011/Balises IR/schematic/Rx_pcb.PcbDoc
Elec/2011/Balises IR/schematic/Rx_power.SchDoc
Elec/2011/Balises IR/schematic/Rx_rev_B.PrjPcb
Elec/2011/Balises IR/schematic/Rx_syno.SchDoc
Elec/2011/Balises IR/schematic/Rx_TSOP.SchDoc
Elec/2011/Balises IR/schematic/Tx.DSN
Elec/2011/Balises IR/schematic/Tx_leds.SchDoc
Elec/2011/Balises IR/schematic/Tx_micro.SchDoc
Elec/2011/Balises IR/schematic/Tx_pcb.PcbDoc
Elec/2011/Balises IR/schematic/Tx_power.SchDoc
Elec/2011/Balises IR/schematic/Tx_rev_B.PrjPcb
Elec/2011/Balises IR/UNTITLED.LYT
Elec/2011/Balises Vision/Low_cost_board/LC_Vision_rev_A.DSN
Elec/2011/Balises Vision/numeric.SchDoc
Elec/2011/Balises Vision/power.SchDoc
Elec/2011/Balises Vision/Vision1.PrjPcb
Elec/2011/Capteur Couleur/Fonctionnement normal.DSN
Elec/2011/Capteur Couleur/Fonctionnement normal.LYT
Elec/2011/Capteur Couleur/Teach-in externe.DSN
Elec/2011/Carte AX12/carte_AX12.DSN
Elec/2011/Dev board PIC24/PE/PIC24_Demo_board.DSN
Elec/2011/Dev board PIC24/PE/PIC24_Demo_board.LYT
Elec/2011/Dev board PIC24/schematic/Demo_board.DSN
Elec/2011/Module_Alim/Module_Alim_2011.DSN
Elec/2011/Module_Alim/Module_Alim_2011.LYT
Elec/2012/Balises Vision/Fixe.DSN
Elec/2012/Balises Vision/Fixe.LYT
Elec/2012/Balises Vision/Mobile.DSN
Elec/2012/Balises Vision/Mobile.LYT
Elec/2013/Carte_connectique_CM/carte_connectique_CM.DSN
Elec/2013/Carte_connectique_CM/carte_connectique_CM.LYT
Elec/2013/Module_Alim/Module_Alim.DSN
Elec/2013/Module_Alim/Module_Alim.LYT
Elec/2013/Support_capteur_couleur/Supp_capteur_couleur.DSN
Elec/2013/Support_capteur_couleur/Supp_capteur_couleur.LYT
