massinissalounis/oufffteam/Info/CMUCam/Src/projects/VideoMaker/Parameters.h

#ifndef PARAMETERS_H
#define PARAMETERS_H

#define SDCARD_SIZE				2*1024*1024*1024	// Size of the SD card in bytes
#define HIGH_RESOLUTION_SIZE	999*999;
#define LOW_RESOLUTION_SIZE		999*999;

#define	GRAB_PERIOD				200					// Time (in ms) between images

#define RESOLUTION_TYPE			CC3_CAMERA_RESOLUTION_HIGH	// CC3_CAMERA_RESOLUTION_LOW

#endif
