massinissalounis/oufffteam/Balises/IHM_Balises_GLUT/include/IHM_Balises_Constants.h

/*******************************************************************************************
   File           :  IHM_Balises_Constants.h
   Authors        :  Fifi_one       (philippe.bechet@cpe.fr)
   Team           :  OUFFF TEAM

   Description    :  All constants associated to project IHM_Balises
   History        :
      2008_04_23 (Fifi_one)     : Creation

   Dependencies   :
      None
/*******************************************************************************************/

#ifndef IHM_BALISES_CONSTANTS_H
#define IHM_BALISES_CONSTANTS_H


// File : 




#endif //  IHM_BALISES_CONSTANTS_H
