massinissalounis/oufffteam/(commit log)

2010-04-20 dernière version de l'asservissement.
2010-05-01 clic-clic adc et tirette ok
2010-05-02 Tested : adc + succession mvt Pbs : file message
2010-05-10 Asservissement ok avec un petit dépassement sur la distance.
2010-05-10 Activate anti collision on GP2D2 and Bumpers
    [AppConfig.h]
2010-05-11 Version Départ Coupe. Restes à faire : - Rentrer les points de passage Bleu et Jaune pour l'homologuation - Calibrer le déplacement sur 3m - Mettre en place l'évitement - Faire la stratégie - Prépare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
2010-05-29 Ajout des outils d'infos (OufffLib)
2010-05-29 Ajout de la lib openGL
2010-05-29 MAJ soft d'install de la OuffLib
2010-11-03 Update Elec 2010 + Balises 2011
    [BaliseEmetteur.brd, BaliseEmetteur.sch, BaliseRecepteur.brd, BaliseRecepteur.sch, CONNECTS.SchDoc, Carte_mere_TOP.SchDoc, Comparatif.xlsx, Copie de RFQ_tomic.xls]
2010-11-03 Mise à jour des boitiers des passifs, hors inductances
    [Vision1.PrjPcb, power.SchDoc]
2010-11-04 Ajout de la partie numérique de la balise vision
    [Vision1.PrjPcb, numeric.SchDoc, power.SchDoc]
2010-11-16 Ajout du driver de led vision et de son routage pour estimation surface.
    [Rx.DSN, Rx.LYT, Rx.SDF]
2010-11-19 Ajout du petit convertisseur 600mA 3V3
    [Rx.DSN, Rx.LYT]
2010-11-20 Modifs alims (ajout du 1.8V)
    [Rx.DSN, Rx.LYT]
2010-11-23 update Tx schematic and add datasheet
    [Tx.DSN]
2010-11-24 Supression des convertisseurs dc-dc de la partie power mgmt qui ne sont pas utilisables avec une tension de batterie supérieure à 5.5V. Ajout des éléments "batterie".
    [Tx.DSN]
2010-11-28 update schematic: leds sheet done, driver and micro sheet ongoing
    [Tx.DSN]
2010-11-28 schematic done, waiting review
    [Tx.DSN]
2010-11-29 Corrections balise IR-Tx
    [Tx.DSN]
2010-11-30 Corrections schema + debut routage
    [Tx.DSN]
2010-11-30 Ajout fichier de layout
    [Tx.LYT]
2010-12-20 Corrections diverses en cour.
    [Rx.DSN, Rx.LYT]
2010-12-21 poursuite des corrections Rx
    [Rx.DSN]
2010-12-22 Avancement des corrections, et du routage.
    [Rx.DSN, Rx.LYT]
2010-12-25 Avancement routage Tx
    [Tx.DSN, Tx.LYT]
2010-12-28 Avancement routage Tx, nétoyage des bus d'alim....
    [Tx.DSN, Tx.LYT]
2010-12-28 Fin routage Tx.
    [Tx.DSN, Tx.LYT]
2010-12-30 Optimisations routage
    [Tx.LYT]
2010-12-30 Chanement des TSOP
    [Rx.DSN, Rx.LYT, Tx.DSN, Tx.LYT]
2011-01-01 Suppression des fichiers livrés par erreur
2011-01-02 Test suite à probleme de compil de la TaskAsser
2011-01-04 Avancement schéma-routage Rx: routage des TSOP-CPLD
    [Rx.DSN, Rx.LYT]
2011-01-06 Ajout JTAG CPLD balise Rx
    [Rx.DSN, Rx.LYT]
2011-01-06 Fin routage Rx, reste des ajouts à faire.
    [Rx.DSN, Rx.LYT]
2011-01-12 Ajout projet VHDL
    [Rx.DSN, Rx.LYT]
2011-01-15 Update Balises 2011 : Mod schematics
    [Rx.DSN, Tx.DSN]
2011-01-22 Ajout des schémas de la carte mère qui n'étaient pas à jour.
    [CONNECTS.SchDoc, FPGA.SchDoc, Ocore.PrjPcb, PIC32.SchDoc, POWER_SUPPLY.SchDoc, Rx_logic.SchDoc, Rx_micro.SchDoc, Rx_pcb.PcbDoc]
2011-01-31 Fin routage Tx
    [Rx_pcb.PcbDoc, Tx_pcb.PcbDoc, Tx_rev_B.PrjPcb]
2011-02-01 Ajout des sources de la CMUCam3 (cc3 Release623)
2011-02-03 suppression des fichiers de test
2011-02-06 Ajout des programmes de tests de la CMUCam
2011-02-20 Create Demo Board PIC24
    [Commande Farnell 2.xlsx, PIC24_Demo_board.DSN]
2011-02-20 Demo Board PIC24 : Layout
    [PIC24_Demo_board.DSN, PIC24_Demo_board.LYT]
2011-02-26 Création Repertoire
    [carte_AX12.DSN]
2011-02-26 Ajout RS232
    [carte_AX12.DSN]
2011-02-26 Ajout capteur analogique Ajout port série Ajout capa de découplage alim AX12
    [PIC24_Demo_board.DSN]
2011-02-26 Ajout resistance de protection retour sharp GP2
    [PIC24_Demo_board.DSN]
2011-03-03 Ajout du projet pour ecriture sur SDCard de la CMUCam
    [test_image_sdcard.sdf]
2011-03-03 Ajout du workspace de FiFi
    [Oufff2011_FiFi.sdf]
2011-03-05 Demo Board PIC24 : Layout final draft
    [PIC24_Demo_board.DSN, PIC24_Demo_board.LYT]
2011-03-12 Odo : Ok Asser : mode 1 and 3 Ok
    [PIC24_Demo_board.LYT]
2011-03-14 Add : lib_i2c files Add : color sensor demo board
    [Fonctionnement normal.DSN, Fonctionnement normal.LYT, Fonctionnement normal.SDF, Teach-in externe.DSN]
2011-03-17 Mise à jour code pour prise en compte mode de déplacement (mode 1 à 4)
2011-03-20 Ajout des workspaces de dev
2011-03-26 [CBE]Ajout des cartes Connectique CM et alimentation
    [Carte_Alim.DSN, Carte_Alim.LYT, Carte_Alim.SDF, carte_connectique_CM.DSN, carte_connectique_CM.LYT, carte_connectique_CM.SDF]
2011-03-27 Carte alim routée à Valider !
    [Carte_Alim.DSN, Carte_Alim.LYT, Carte_Alim.SDF]
2011-03-30 Version finale, bon pour production.
    [Carte_Alim.DSN, Carte_Alim.LYT, Carte_Alim.SDF]
2011-03-30 Routage en cours
    [carte_connectique_CM.DSN, carte_connectique_CM.LYT, carte_connectique_CM.SDF]
2011-03-31 MAJ du workspace pour carte de Dev
2011-03-31 MAJ des workspaces de dev
2011-03-31 Pas encore fini
    [carte_connectique_CM.DSN, carte_connectique_CM.LYT, carte_connectique_CM.SDF]
2011-04-01 On y est presque !
    [carte_connectique_CM.LYT]
2011-04-04 MAJ répertoire de dev "Oufff2011_FiFi"
2011-04-07 Copie de sauvegarde Oufff2011_FiFi
2011-04-11 Carte modifiée pour une réalisation "artisanale"
    [carte_connectique_CM.DSN, carte_connectique_CM.LYT, carte_connectique_CM.SDF]
2011-04-12 modifs minimes suite aux remarques de Pilou
    [carte_connectique_CM.LYT]
2011-04-27 Ajout fichiers pour carte connectique CM et carte Alim 2011.
    [Module_Alim_2011.DSN, Module_Alim_2011.LYT, Module_Alim_2011.SDF, carte_connectique_CM_2011.DSN, carte_connectique_CM_2011.LYT, carte_connectique_CM_2011.SDF]
2011-05-12 Sauvegarde FiFi
    [Oufff2011_FiFi.sdf]
2011-05-20 Sauvegarde répertoire de dev "Oufff2011_FiFi"
2011-05-23 AX12: BSP FPGA - acces UART - acces status AX12
2011-05-29 Début essais coupe de Oufff2011
    [Oufff2011_FiFi.sdf]
2011-05-29 Ajout des repertoires de dev
2011-05-30 Modifs cartes alim et connectique CM Ajout sources FPGA
    [Carte_Alim.DSN, Carte_Alim.LYT, Carte_Alim.SDF, carte_connectique_CM_2011.DSN, carte_connectique_CM_2011.LYT, carte_connectique_CM_2011.SDF]
2011-05-30 ODO + ASSER ok Prog Main en cours de test
2011-05-31 Anti-collision ok (a finaliser certains points) Tests de prise d'objet (début) Mouvement complet (ok) Poursuite des tests du Main
    [AppConfig.h]
2011-05-31 Ajout fichier de Calculs de trajectoires
    [Calculs trajectoires.xlsx]
2011-06-01 Conception traj pour homologation
    [Calculs trajectoires.xlsx, Oufff2011.sdf]
2011-06-01 Code avant le test de l'anti-collision. Stratégie encore en attente de tests
    [AppConfig.h]
2011-06-14 Retour Coupe 2011
    [Calculs trajectoires.xlsx, portmap.xls]
2011-07-25 Fichiers de conception du projet Oufff2011
2011-09-14 Mise à jour des fichiers de conception
2011-10-30 Add: Elec2012 - balises vision
    [BOM_Farnell.xlsx, Fixe.DSN, Fixe.LYT, Fixe.SDF, Mobile.DSN, Mobile.LYT, Mobile.SDF]
2011-10-30 Ajout du capteur de couleur sur le FPGA.
2011-10-31 Ajout des fichiers StrategyGenerator
2011-10-31 Mise à jour des fichiers de Conception de StrategyGenerator
2011-11-01 Mise à jour du fichier de conception de Oufff2011
2011-11-02 Ajout du projet Oufff2012 et MAJ du projet Oufff2011
    [Oufff2011.sdf, Oufff2012.sdf]
2011-11-05 Routage Version 1
    [Mobile.DSN, Mobile.LYT, Mobile.SDF]
2011-11-22 Mise à jour du projet Oufff2012
    [Oufff2012.sdf]
2011-12-05 Elec: Ajout des Librairies Proteus dans un dossier spécifique.
2011-12-05 Elec: Modif sur balise vision
    [Mobile.LYT]
2011-12-26 Add: AX12
    [Oufff2011.sdf]
2012-01-04 Création des projets Oufff2012
    [Oufff2012.sdf]
2012-01-08 RX soft - peripheral pin select should be ok
    [RX_cpld_pad.csv]
2012-02-12 Add: Code AX12 2012 - Gestion des bras
2012-02-19 Le projet avec les modifications 2012 compile. Ecriture du programme de tests dans TaskSensors.c (au début du main).
    [Oufff2012.sdf]
2012-02-27 Ajout des fonctionnalités de test pour les GP2 et SW dans TaskSensors
    [Oufff2012.sdf]
2012-03-08 Sauvegarde du projet de dev StrategyGenerator en cours de dev
2012-03-21 Generation des fonctions bas niveau ok
2012-03-23 Ajout des fichiers d'IHM
2012-04-05 Ajout des posters de la Coupe2011
2012-04-16 Ajout des fichiers Coupe2012
2012-05-02 Mise à jour du code du robot apres la journée du 29/04/12 chez CBE
    [Oufff2012.sdf]
2012-05-06 Sauvegarde après la coupe de Suisse. (Programme d'homologation)
    [Oufff2011.sdf, Oufff2012.sdf]
2012-05-06 Mise à jour du dossier de conception Oufff2012
2012-05-08 Mise à jour du dossier de Conception/Oufff2012.doc
2012-05-10 Mise à jour du code pour test des cartes mères
    [Oufff2012.sdf]
2012-05-13 Add: Arm Control update
2012-05-13 Mise à jour suite aux modifs de code
2012-05-13 Ajout des fichiers projets pour la carte de Dev
    [Oufff2012.sdf]
2012-05-13 Mise à jour des fichiers de Strategy
2012-05-13 Sauvegarde dimanche soir
    [Oufff2012.sdf]
2012-05-15 Sauvegarde lundi soir
    [Oufff2012.sdf]
2012-05-15 sauvegarde mardi midi
    [Oufff2012.sdf]
2012-05-15 Sauvegarde mardi soir
    [Oufff2012.sdf]
2012-05-17 Sauvegarde après match 1
    [Oufff2012.sdf]
2012-10-13 Ajout des infos sur le Reglement et les conditions de participation pour la coupe 2013
2012-10-17 MAJ de sauvegarde pour la conception StrategyGenerator v2
2012-10-30 Ajout modules Traco dans la lib proteus
2012-10-30 Suppression des fichiers de sauvegarde de la coupe 2012 (tous contenus dans le dossier Oufff2012)
    [Oufff2012.sdf]
2012-10-31 Carte alimentation reroutée. Reste à voir l'empreinte des interrupeteurs.
    [BOM cartes 2013.xlsx, Module_Alim.DSN, Module_Alim.LYT, carte_connectique_CM.DSN, carte_connectique_CM.LYT]
2012-11-01 Carte alimentation version 2013. Bon pour production.
    [Module_Alim.DSN, Module_Alim.LYT]
2012-11-01 Ajout de composants dans la librairie Protéus. Mise à jouir de la nomenclature des cartes 2013.
    [BOM cartes 2013.xlsx]
2012-11-01 Mise à jour des règles d'ignore
2012-11-12 Création des projets MPLAB et Oufff2013
    [Oufff2013_CarteDeDev.sdf, Oufff2013_RobotPrincipal.sdf, Oufff2013_RobotSecondaire.sdf]
2012-11-12 Fin de la séparation des données de configuration de chaque robot Ajout des fichiers src/Main/AppGlobalConfig.h, src/Main/AppPrimaryConfig.h et src/Main/AppSecondaryConfig.h à la place du fichier src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
    [Oufff2013_RobotPrincipal.sdf, Oufff2013_RobotSecondaire.sdf]
2012-11-12 MAJ des projets
2012-11-17 Mise à jour des fichiers 2012 pour la démo de Oufff du 18/11/12 Ajout des strategies de test pour la coupe 2013
    [Oufff2013_RobotPrincipal.sdf]
2012-12-13 Carte connectique CM 2013 routée mais NON validée !
    [Module_Alim.LYT, Module_Alim.SDF, carte_connectique_CM.DSN, carte_connectique_CM.LYT, carte_connectique_CM.SDF]
2012-12-16 Add: Carte support capteur couleur
    [Supp_capteur_couleur.DSN]
2013-01-04 modif temporaire
    [carte_connectique_CM.DSN]
2013-01-13 Ajout de la structure de fichier pour le projet 2013
2013-01-13 Carte alim corrigée. Carte connectique CM corrigée (reste plan TOP ou marquage à choisir). Création carte support capteur couleur.
    [Module_Alim.LYT, Supp_capteur_couleur.DSN, carte_connectique_CM.DSN, carte_connectique_CM.LYT, carte_connectique_CM.SDF]
2013-01-16 Carte support capteur couleur en cours
    [Supp_capteur_couleur.DSN, Supp_capteur_couleur.LYT, Supp_capteur_couleur.SDF]
2013-01-18 Add: Comments on PCBs
2013-01-19 Module alim final
    [Module_Alim.LYT]
2013-01-19 carte connectique CM avant d'enlever les protections
    [carte_connectique_CM.DSN, carte_connectique_CM.LYT, carte_connectique_CM.SDF]
2013-01-19 MAJ du dossier de projet + création du projet de test pour FileManager
2013-01-19 Cartes terminées.
    [Supp_capteur_couleur.DSN, Supp_capteur_couleur.LYT, Supp_capteur_couleur.SDF, carte_connectique_CM.DSN, carte_connectique_CM.LYT, carte_connectique_CM.SDF]
2013-01-19 Add: New Hoop control, Arm control, GP2
2013-01-20 Mise à jour de l'AP 2013
2013-01-25 Add: FPGA13 : PMP-LED-TOP
2013-01-26 FPGA13: LED register + PMP Interface
2013-01-31 Modification du workspace des 2 robots pour les passer en stratégie d'HOMOL
2013-02-08 PIC2013: Test functions for the FPGA LED
2013-02-13 ajout fichier config chaine jtag
2013-02-13 FPGA13: svf test led
2013-02-16 Mise à jour paramètre de timming bus PMP
2013-02-17 Mise à jour du projet Oufff2013 : - Test nouveau code FPGA - Debug du déplacement en marche arriere du robot - Emission de la données 0xAA en continue sur le bus serie pour debug
2013-02-19 FOR DEBUG PURPOSE ONLY suite à session de débug FPGA / UART / AX12 du lundi 18/02/2013.
2013-02-26 Cartes et composants commandés. Attention erreur empreinte sur TBLOC : perçages trop petits.
    [BOM cartes 2013.xlsx, Module_Alim.LYT, Supp_capteur_couleur.LYT, carte_connectique_CM.LYT]
2013-03-07 Sauvegarde du projet Oufff2013 (avec TaskDebug et TaskTest) qui seront synchro sur tous les PC à la prochaine journée du crousty
2013-03-17 Mise à jour des fichiers de conceptions
2013-03-24 Code après la journée du 23/03/13 : - Anti-collision OK - Carte support testée (GP2, Clic_Clic, Color, Tirette) - Déplacement à verifier (problème de dérive sur les mouvements avec de l'angle). Nouve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
2013-03-24 Ajout des fonctions de traitements des bras (à tester une fois les AX12 réglé)
2013-03-24 Ajout des actions pour modifier les StrategyFlags + gestion des HOOPS
2013-03-25 Sauvegarde du projet "v2 - 2013" + Ajout des exe pour le Rapsberry
2013-04-07 Ajout des éléments du poster + le poster 2013 tel qu'il a été envoyé
2013-04-27 Sauvegarde projet Oufff2013. Reste à faire : - Calibrer ODO - Calibrer GP2 - Code pour AX12 arrière pour les cadeaux
2013-04-28 Sauvegarde projet Oufff2013. Reste à faire : - Calibrer ODO - Code pour AX12 arrière pour les cadeaux
2013-05-03 Sauvegarde du projet "v2 - 2013"
    [Ratio.xlsx]
2013-05-06 mise à jour BOM cartes 2013.xlsx
    [BOM cartes 2013.xlsx, carte_connectique_CM.SDF]
2013-05-06 Structure de ma MainStrategy (à tester)
2013-05-13 video de la coupe + Time Lapse
2013-05-17 Balises_SICK: Add Meca
    [Balises_passives.SLDPRT, Balises_passives.STL, SICK WL100-N4439-Bestell-Nr_6028604(0)-1.sldprt, SICK WL100-N4439-Order no_6028604 (0).sldasm]
2013-05-17 Ajout des fichiers Solidworks 2011 2012 et 2013.
    [744-946.SLDPRT, 744-968.SLDPRT, AX-12_modif.SLDPRT, Arceau.SLDDRW, Arceau.SLDPRT, Arceau2.SLDPRT, Assemblage1.SLDASM, Assemblage2.SLDASM]
2013-06-05 Creation du projet Oufff2014
    [Oufff2014_RobotPrincipal.sdf]
2013-06-10 Mise a jour du dossier de conception Oufff2013 + mise à jour du projet VC2010 pour Oufff2013
    [Oufff2013_RobotPrincipal.sdf]
2013-06-11 Livraison de la doc de conception pour le projet Oufff2013.
2013-06-14 Balises Meca finale ....
    [Balise_principale.SLDASM, Balises_passives_v3.SLDASM, Pilier.SLDPRT, Pilier.STL, Pilier_top_sick.SLDASM, Plaque_bottom.SLDPRT, Plaque_bottom.STL, Plaque_top.SLDPRT]
2013-11-02 Ajout du dossier pour la démo des Pivots
    [Oufff2013_RobotPrincipal.sdf, Oufff2013_RobotSecondaire.sdf]
2013-11-02 Ajout du dossier pour la démo de la Generation de Strategy
    [Oufff2013_RobotPrincipal.sdf, Oufff2013_RobotSecondaire.sdf]
2013-11-03 Pour Démo de Oufff novembre 2013
    [Oufff2013_RobotPrincipal.sdf, Oufff2013_RobotSecondaire.sdf]
